MattdewT/KE4/Dichtung4.jpg

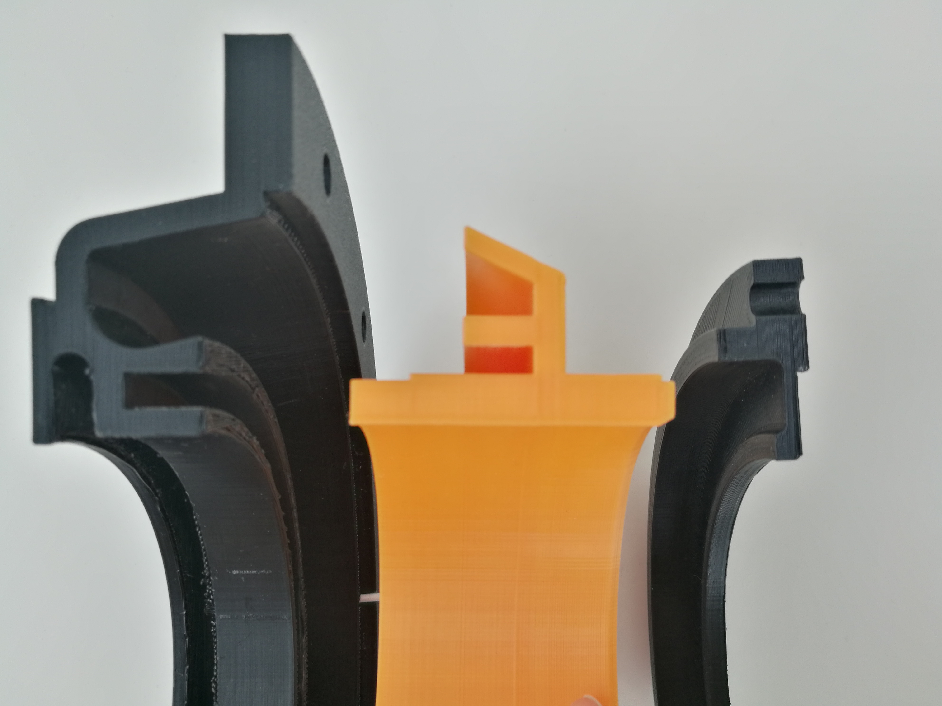
Dichtung4.jpg
