MattdewT/KE4/IMG_20200114_105757.jpg

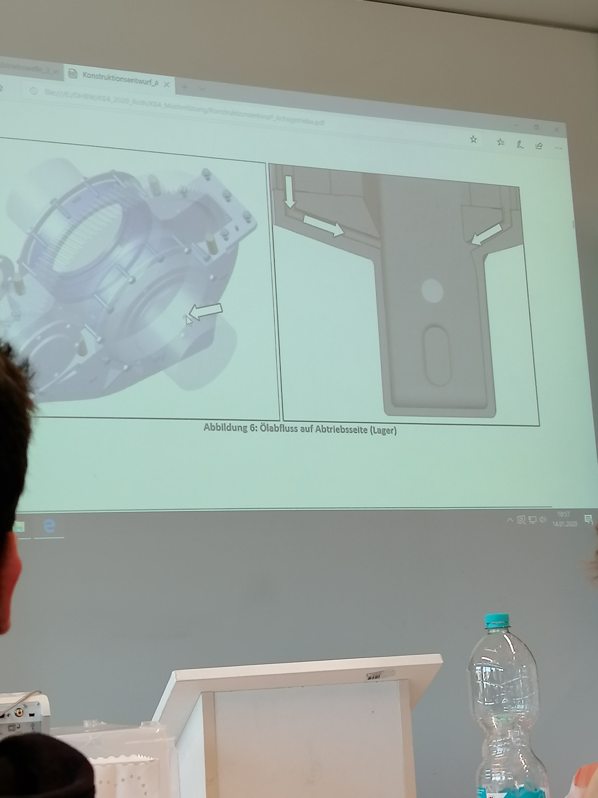
IMG_20200114_105757.jpg
