MattdewT/KE4/Grafiken.pptx

## Slide 2

94,5

76

71,5

FRi

FRa

Fr1

y

x

FB

## Slide 3

FS1

R = 120

FK

r = 92

z

y

FS2

## Slide 4

LI=65

LII=160

LIII=65

LIV=65

Z

x

FAZ

FG

FG

FBZ

FKZ

## Slide 5

α

LI=65

T1=0Nm

LII=160

T2=120Nm

LIII=65

LIV=65

T3=T4=
240Nm

50

0,5

0,5

## Slide 6

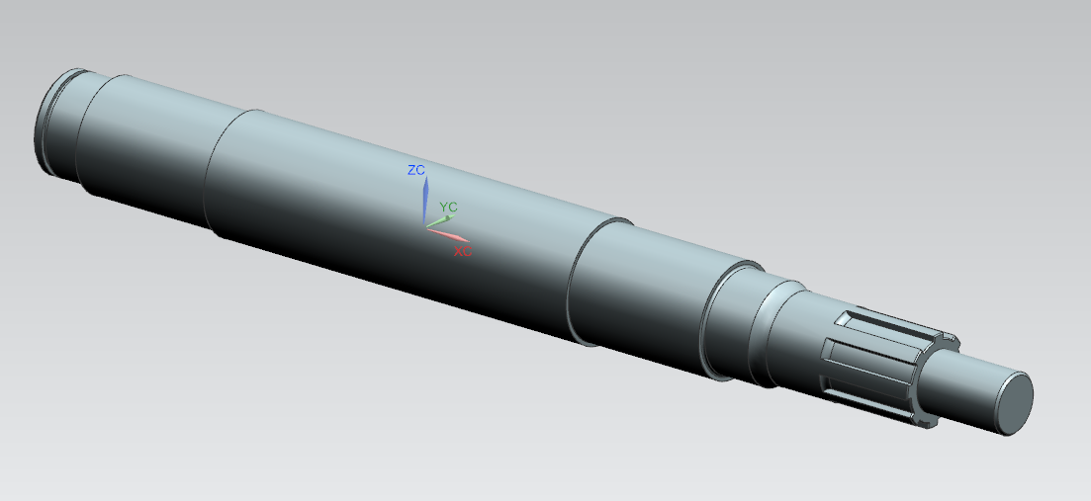
[picture p45: figure]

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
## Slide 7

80mm

φ

0,25mm

## Slide 8

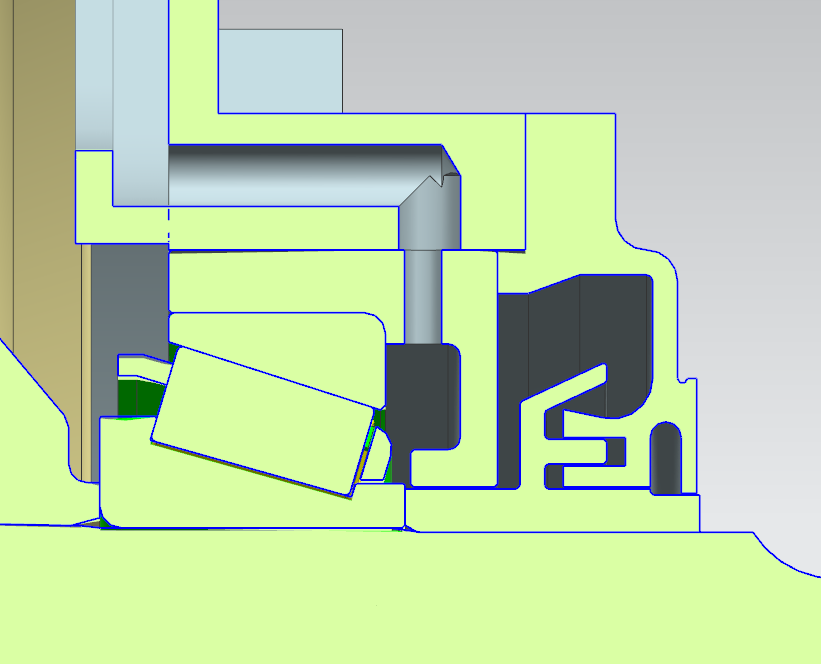
[picture p46: figure]
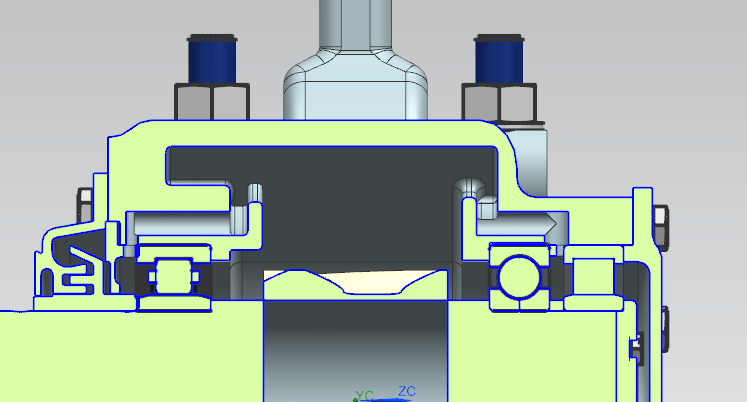
[picture p47: figure]

## Slide 9

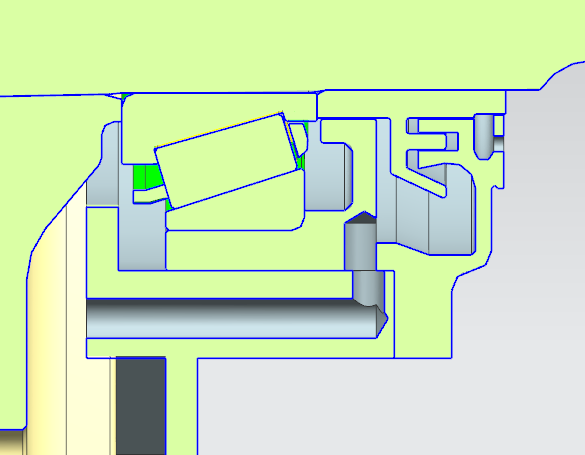
[picture p48: figure]

## Slide 10

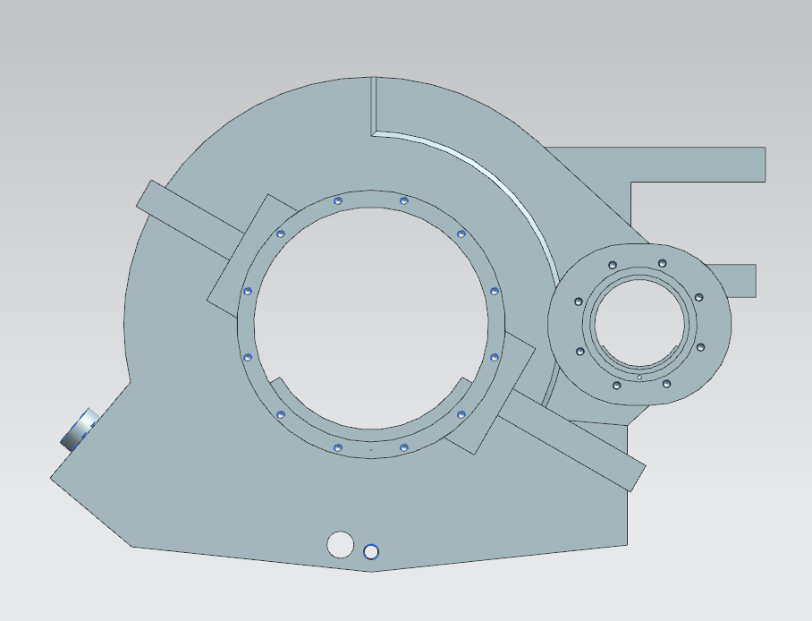
[picture p49: figure]

## Slide 11

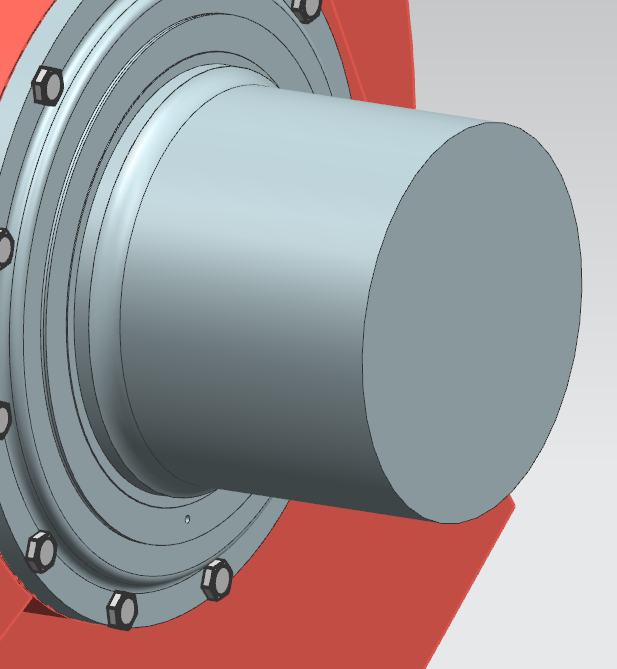
[picture p50: figure]
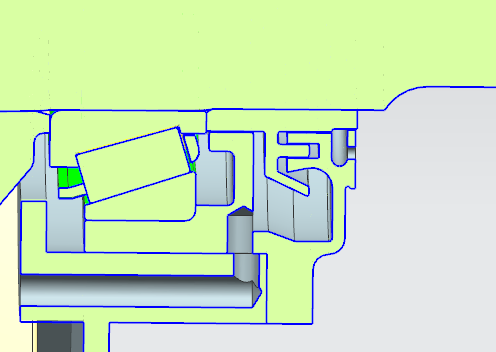
[picture p51: figure]

## Slide 12

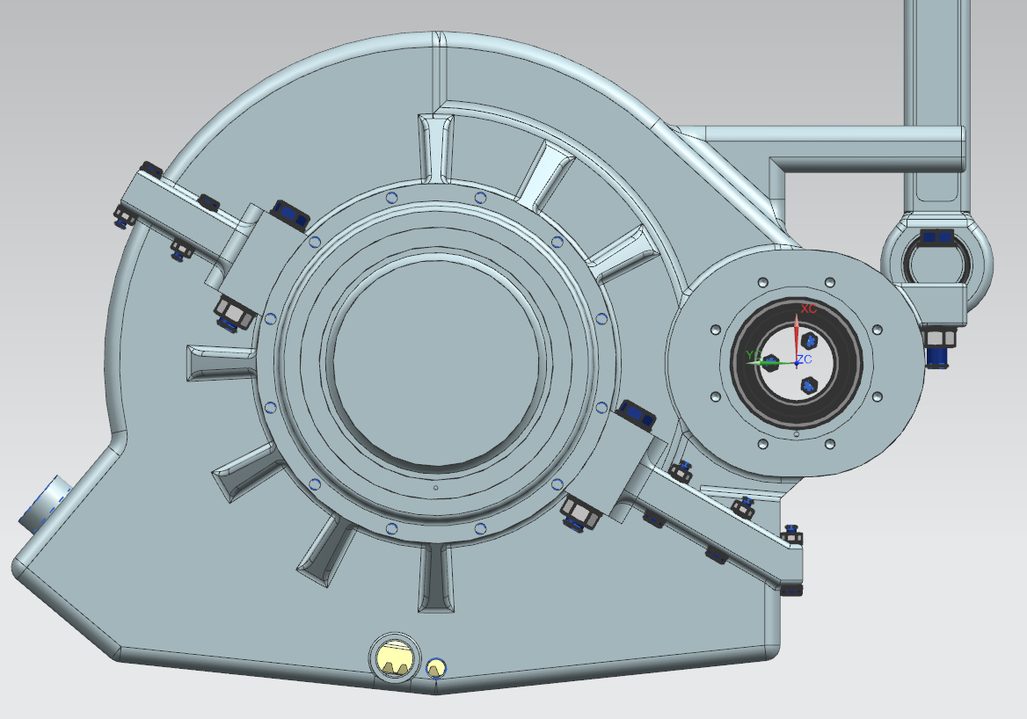
[picture p52: figure]

10

10

## Slide 13

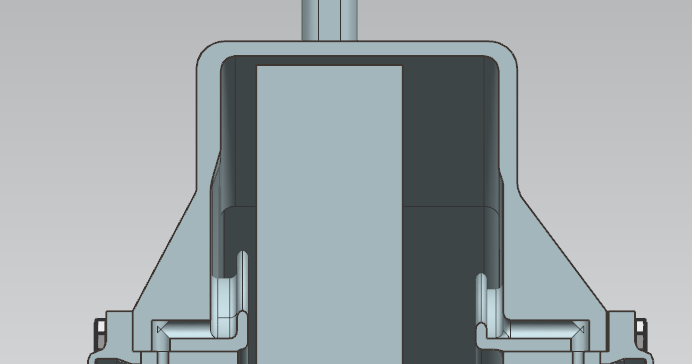
[picture p53: figure]

5

max. 80

max. Ø 619

## Slide 14

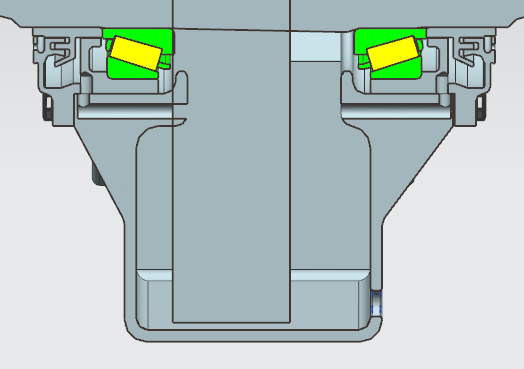
[picture p54: figure]

max. Ø 619

max. 80

5

## Slide 15

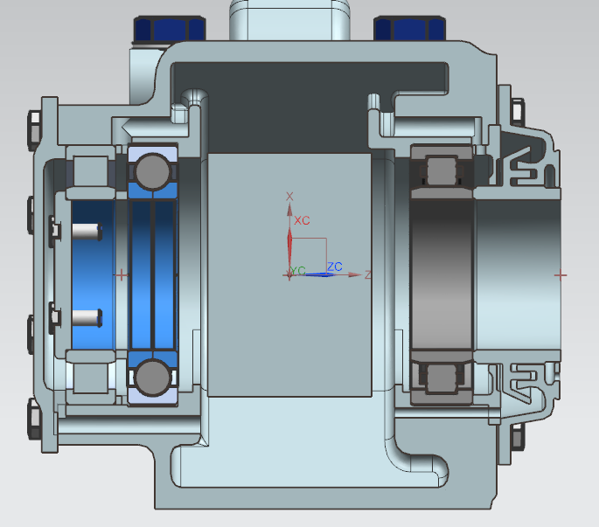
[picture p55: figure]

max. Ø 127

max. 82

## Slide 16

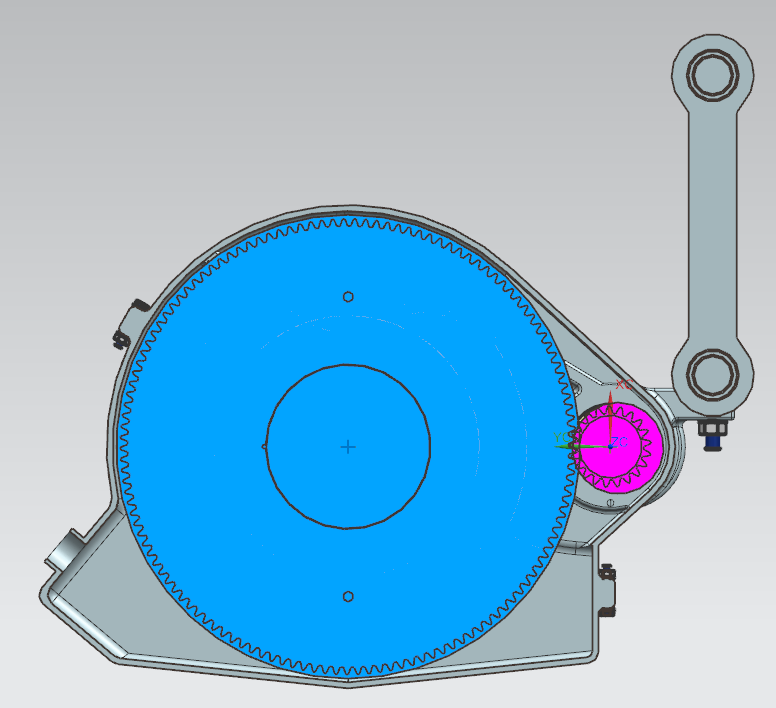
[picture p56: figure]

## Slide 17

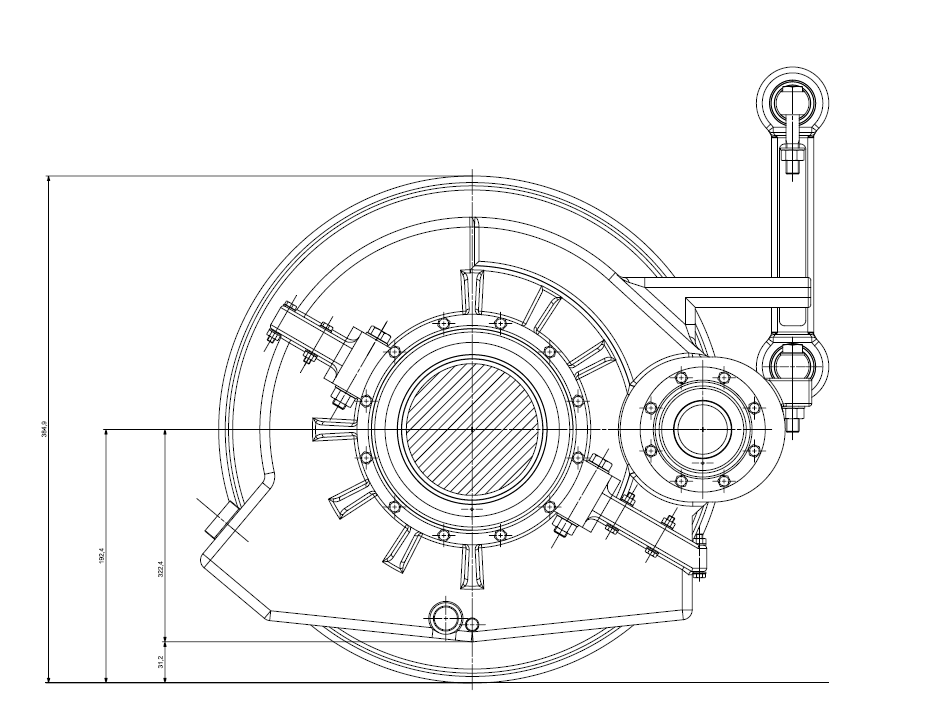
[picture p57: figure]

Ø 770

385

322,5

62,5

## Slide 18

Laufrad

Ø 770

385

322,5

62,5

Schienenoberkante

## Slide 19

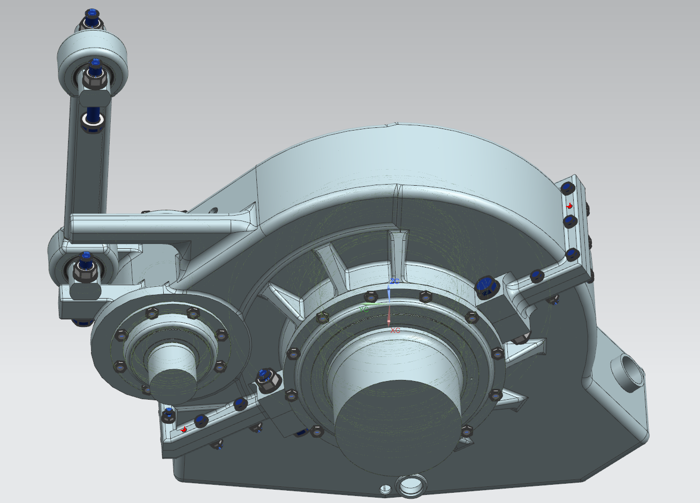
[picture p58: figure]

## Slide 20

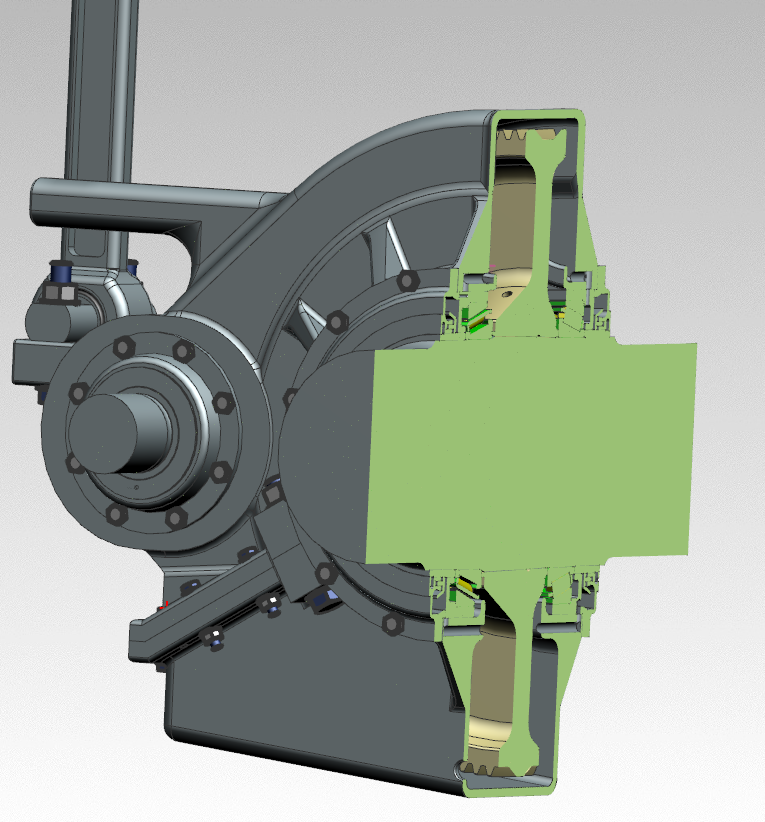
[picture p59: figure]

## Slide 21

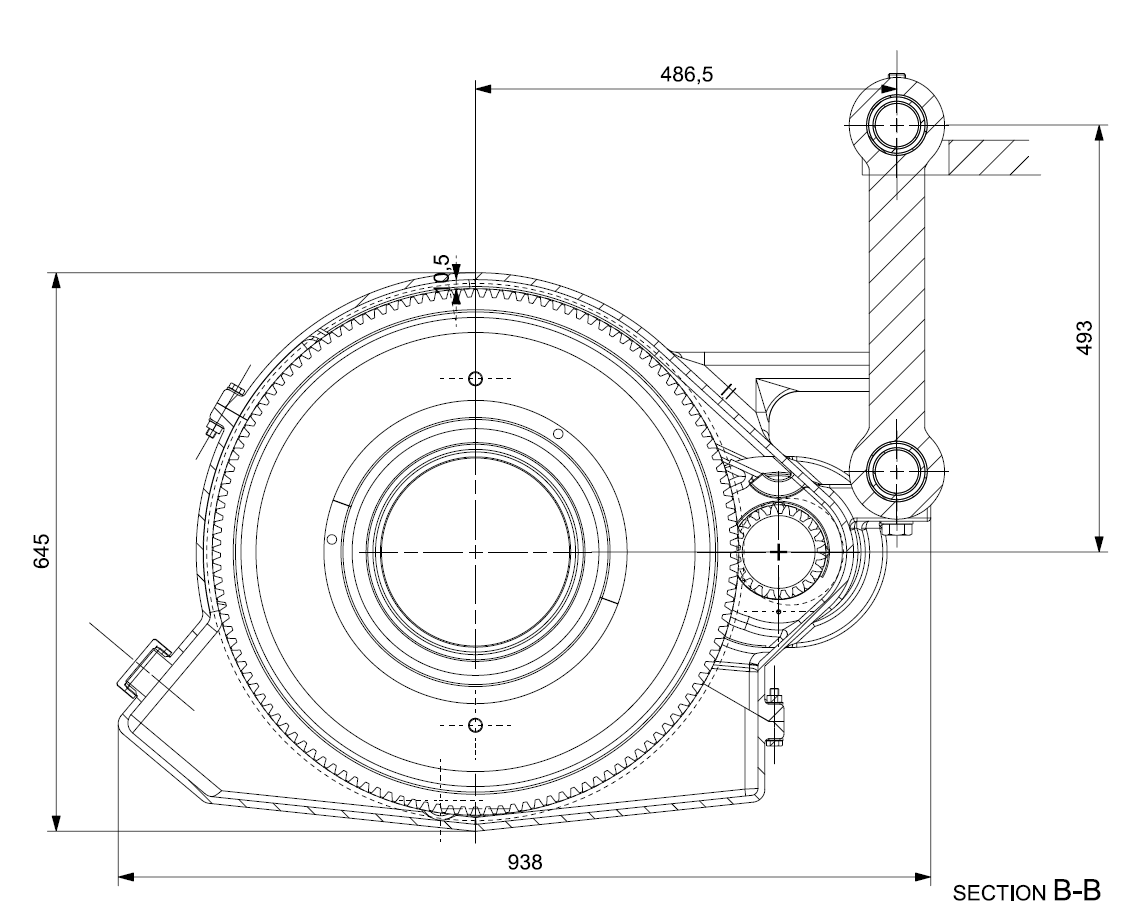
[picture p60: figure]
