MattdewT/KE4/Auflistung relevanter Momente.docx

Übersetzung | 6,143
Auslegungsdrehmoment inkl. KA=Abtriebsmoment | 21600 Nm
Antriebsdrehmoment inkl. KA | 3516Nm
KA | 2
Nennabtriebsdrehmoment | 10800 Nm
Nennantriebsdrehmoment | 1726 Nm
Spitzenabtriebsmoment (KA=2,5) | 27000Nm
Spitzenantriebsmoment (KA=2,5) | 4395Nm
Rechenmoment für die Antriebslager | 790 Nm

Auflistung Drehmomente
