MattdewT/KE4/Finale/0. Projektbericht.pdf

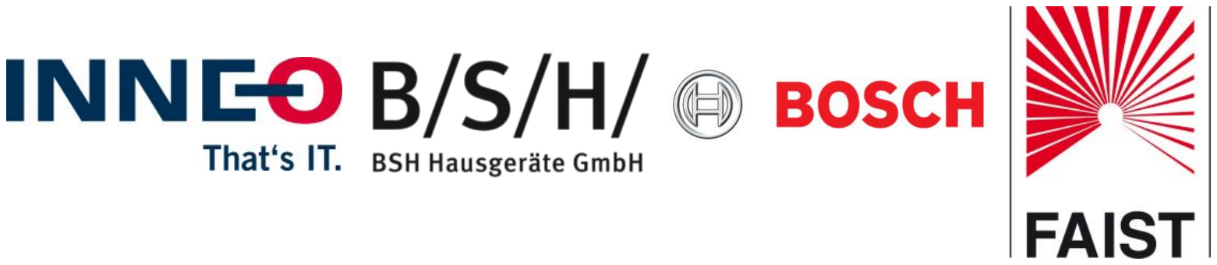
[picture p61: figure]

## Berechnung und Konstruktion eines

## Schienenfahrzeugachsgetriebes

Konstruktionsentwurf im Fach Konstruktionslehre 4

des Studienganges Maschinenbau

an der Dualen Hochschule Baden-Württemberg Heidenheim an der Brenz

von

Hofmann, Tanja

Hopf, Marie

Langohr, Anika

Tiroch, Matthias

Variante 13

Abgabe: 10.03.2020

Bearbeitungszeitraum | 9 Wochen
Matrikelnummern | 5620331, 3225750, 1790705, 9269794
Kurs | TM 2018 KM
Ausbildungsfirma | INNEO Solutions, BSH, Bosch AS,
| Faist Anlagenbau

Studienbereich Technik

Studiengang Maschinenbau

Name, Vorname

Hofmann, Tanja

Name, Vorname
Hopf, Marie

Name, Vorname
Langohr, Anika

Name, Vorname
Tiroch, Matthias

Erklärung

gemäß § 5 (3) der „Studien- und Prüfungsordnung DHBW Technik“ vom

01.10.2015.

Ich habe die vorliegende Arbeit selbstständig verfasst und keine anderen als die

angegebenen Quellen und Hilfsmittel verwendet.

Ort, Datum | Unterschrift
Ort, Datum | Unterschrift
Ort, Datum | Unterschrift
Ort, Datum | Unterschrift

## Inhaltsverzeichnis

Inhaltsverzeichnis | 3
1 | Vorwort | 7
2 | Einleitung | 1
2.1 | Anforderungsliste | 2
2.2 | Morphologischer Kasten | 6
2.3 | Relevante Momente | 9
3 | Verzahnung | 10
3.1 | Berechnung der Zähnezahl und des Moduls | 10
3.2 | Verzahnungskräfte | 11
3.3 | Profilverschiebung | 12
3.4 | Zahnfußfestigkeit und Grübchenfestigkeit | 12
3.5 | Antriebsritzel | 13
3.5.1 | Antriebswelle | 13
3.6 | Abtriebsrad | 14
3.6.1 | Thermische Pressverbindung des Abtriebsrades | 15
3.6.2 | Öl-Kegelpressverband des Abtriebsrades | 20
4 | Lager | 23
4.1 | Lagerkraftberechnung | 23
4.1.1 | Antriebswelle | 23
4.2 | Auswahl der Lager | 26
4.2.1 | Antriebslager | 27
4.2.2 | Abtriebslager | 29
4.3 | Lagerlebensdauer | 31
4.4 | Auswahl der Dichtungen | 33
4.5 | Lagertoleranzen | 40
5 | Schmierung | 41
5.1 | Ölzufuhr | 42
5.2 | Ölabfuhr/Entlüftung | 46

## Anhang

1. Aufgabenstellung und Variantenliste
2. Handzeichnungen und Skizzen auf Millimeterpapier
3. Projektzeitplan
4. Checkliste
5. Stückliste
6. Gesamtzeichnung

6.1.Baugruppenzeichnung

6.2.Abmaße Labyrinthdichtungen

6.3.Abmaße Zahnrad

7. Kaufteildokumentation

7.1.Drehmomentstütze

7.2.Kegelrollenlager TIMKEN LM742710 / LM742747

7.3.Zylinderrollenlager NU215

7.4.Zylinderrollenlager NU2215

7.5.Vierpunktlager QJ215
7.6.Ölschauglas

7.7.Magnetstopfen

7.8.Einfülldeckel

7.9.Entlüftungsschraube

7.10. Sicherungsstift ISO 2338
7.11. Sechskantschraube ISO 4014
7.12. Sechskantmutter ISO 4033
7.13. Unterlegscheibe ISO 7089
7.14. Bogenzahnkupplung

7.14a. Betriebsanleitung Bogenzahnkupplung

8. Verzahungsparameterabstimmung
9. KissSoft-Protokoll Verzahnungsberechnung Modul 4,5

9a. KissSoft-Datei Verzahnungsberechnung Modul 4,5

10.KissSoft-Protokoll Verzahnungsberechnung Modul 5

10a. KissSoft-Datei Verzahnungsberechnung Modul 5

11. Auslegung des thermischen Pressverbands

12. Auslegung des Ölpressverbands
13. Videoausschnitt CFD-Simulation

14.KissSoft-Protokoll Schraubenberechnung Ankerschrauben

14a. KissSoft-Datei Schraubenberechnung Ankerschrauben

15.KissSoft-Protokoll Schraubenberechnung Drehmomentstützenschrauben

15a. KissSoft-Datei Schraubenberechnung Drehmomentstützenschrauben

## 1 Vorwort

Einige Grafiken in dieser Arbeit sind vereinfacht dargestellt, um Sachverhalte besser

erklären zu können. Manche Grafiken sind deswegen auch nicht originalgetreu in der

Konstruktion zu finden, meistens wurden hierfür Kantenverrundungen entfernt.

Weitere Grafiken sowie verschiedene Animationen sind auf der CD beigefügt.

## 2 Einleitung

Der öffentliche Personennahverkehr wird in Zeiten überfüllter Straßen ein immer wich-

tigeres Angebot für die Menschen, vor allem in Ballungsräumen, um klassische Ver-

kehrswege zu entlasten, die psychische Belastung für das Individuum zu senken und

nicht zuletzt, um die Klimaziele der Bundesregierung erreichen zu können. Die stei-

genden Passagierzahlen führen dazu, dass die öffentlichen Verkehrsmittel so zuver-

lässig, störungs- und wartungsarm wie möglich zur Verfügung stehen müssen. In die-

sem Konstruktionsentwurf soll für eine innerstädtische Metro ein einstufiges Schienen-

fahrzeugachsgetriebe konstruiert werden. Die Motorwelle liegt dabei parallel zur Rad-

satzwelle. Relativbewegungen zwischen Getriebe und Drehgestell werden von einer

Bogenzahnkupplung ausgeglichen.

Das Schienenfahrzeugachsgetriebe wird auf der Basis exakter Auslegungsrechnun-

gen konstruiert und mit gängigen Referenzwerten auf die Haltbarkeit bei dynamischer

Belastung geprüft. Die Visualisierung des Schienenachsfahrzeuggetriebes ist einer

ausführlichen CAD-Datei mit passender Stückliste zu entnehmen. Die Bezugsebene

ist dabei immer die Verzahnungsmitte.

Im Anhang sind außerdem die ausgedruckten Excel-Berechnungen sowie Berech-

nungsergebnisse des Programmes KissSoft zu finden. Auf der beiliegenden CD befin-

den sich die Original-Dateien.
Die zu konstruierende Variante Nummer 13 hat ein Übersetzungsverhältnis u = 6,143,

einen Achsabstand a = 350 mm und ein Auslegungsmoment von 21600 Nm.

2.1 Anforderungsliste

In der folgenden Anforderungsliste werden alle Forderungen und Wünsche an das

Stirnrad-Getriebe aufgeführt. Diese Zusammenstellung dient dazu, eine übersichtliche

Darstellung der geforderten Randbedingungen zu bekommen.

Lfd.
Nr.
Hauptmerkmal | Anforderung / Spezifikation (Zahlen, Daten, Fakten)
Klassifizierung

1 Fahrzeugdaten

1.1 | Max. Achslast | 15 - 17 t | Basis
1.2 | Raddurchmesser | d=770-860mm | Basis
1.3 | Anwendung | Metro im Stadt- und Vorstadtbetrieb | Basis

2 Betriebsdaten

2.1 | Fahrzeughöchst-ge-schwindigkeit | 100 km/h | Basis
2.2 | Abtriebsnennmoment | T=10800 Nm | Basis
2.3 | Max. statisches Ab-triebsmoment ("worst case" durch Kurz-schluss) | T=54000 Nm | Basis
2.4 | Abtriebsdrehzahl | Max. Abtriebsdrehzahl = 650 1/min | Basis
2.5 | Max. Motorantriebs-drehzahl | 3000 - 5000 1/min | Basis

3 Allgemeine Getriebegeometrie

3.1 | Achsabstand | a=350mm | Forderung
3.2 | Wellendurchmesser | Auswahl 70 mm - 75 mm - 80 mm | Forderung

3.3 | minimale Höhe des Gehäuses über dem Boden | h=62,5mm | Forderung
3.4 | Motorwelle parallel zur Radsatzwelle | | Forderung
3.5 | Gehäuse soll für alle Getriebevarianten laut Variantenliste passen | siehe Anhang | Forderung
3.6 | Getriebewandstärke | t=8mm | Forderung
3.7 | Respektabstand Zahnkopfkreis-Ge-häuse | 5mm | Forderung
3.8 | Schrägteilung des Ge-häuses | | Wunsch
3.9 | Anstrich | RAL 5002 | Wunsch

4 Getriebedaten

4.1 | Getriebeart | Stirnräder | Forderung
4.2 | Übersetzungsverhält-nis | u=6,143 | Forderung
4.3 | Evolventenverzah-nung nach DIN 867 | | Forderung
4.4 | Schrägungssinn | Ritzel: rechts, Rad: links | Forderung
4.5 | Modul mn | 4,5 | Forderung
4.6 | Teilschrägungswinkel | 13° | Forderung
4.7 | Zahnradwerkstoff | 18CrNiMo7-6 | Wunsch
4.8 | Verzahnung einsatz-gehärtet | auf 740 HV +/- 20 HV, Kernhärte 400 HV | Wunsch

5 Kupplung

5.1 | Antriebskupplung | Bogenzahnkupplung | Wunsch
5.2 | Abtriebskupplung | Großrad direkt auf Abtriebswelle | Forderung

6 Schmierung

6.1 | Öltauchschmierung | Max. Sumpftemperatur 90°C | Forderung
6.2 | Öl: SHC 75W90 GL5 | | Wunsch
6.3 | Ölschauglas | Kennzeichnung des minimalen und maximalen Ölstandes | Wunsch
6.4 | Öleinguss | | Forderung

7 Lager

7.1 | Lagerarten | Vierpunktlager; Zylinderrollenlager; Kegelrollenlager | Wunsch/Fo rderung
7.2 | Rechenmoment am Antrieb bei Lager-durchmesser 75mm | T=790 Nm | Forderung
7.3 | Schmierung der Lager | keine Lebenszeitschmierung, aber Abdichtung der Lagergehäuse | Forderung

8 Umgebung und Betriebsbedingungen

8.1 | Schräglage in Kurven | | Basis
8.2 | Kollisionsschutz am Gehäuse | auch im Schadensfall | Wunsch
8.3 | Geräuscharm | <70dB | Wunsch
8.4 | Rostfrei | durch entsprechenden Werkstoff o-der Beschichtung | Forderung
8.5 | Außenbetrieb möglich | | Basis
8.6 | Optimierter Einbau-raum | | Wunsch

8.7 | Temperaturbereich | -10°C bis +40°C | Wunsch

9 Montage und Fertigung

9.1 | möglichst viele gleich-artige Teile verwen-den | | Wunsch
9.2 | Nur eine Schrauben-art (Durchmesser und Länge) für Lagerde-ckel und Gehäusetei-lungsverschraubung | | Wunsch
9.3 | Lieferung | im montierten Zustand | Wunsch
9.4 | Gehäusewerkstoff | EN-GJS-500-7 | Forderung
9.5 | Flexibilität | Aufhängung | Forderung
9.6 | Transportmaße | max. 800mmx800mmx800mm ohne Motor | Wunsch

10 Kosten

10.1 | ohne Motor | maximal 300€ | Wunsch

11 Lebensdauer

11.1 | nominelle Lebens-dauer | L10km=3,2 Mio. km | Forderung
11.2 | Mögliche Lebens-dauer | L10km>3,2 Mio. km | Wunsch

12 Sicherheit

12.1 | Labyrinthdichtung für die Sicherheit der Um-welt | | Forderung
12.2 | Drehmomentstütze gegen Verdrehung | | Forderung

12.3 | Respektabstand von Zahnrad und Ge-häuse | | Forderung
12.4 | Sicherung gegen Hin-einziehen von Glied-maßen oder Gegen-ständen | | Forderung

13 Termine

13.1 | Vorstellung erster Ent-würfe und Berechnun-gen | 07.02.2019 | Forderung
13.2 | Vorstellung der voll-ständigen Berechnun-gen und CAD-Zeich-nungen | 25.02.2019 | Forderung
13.3 | Abgabe der vollständi-gen Dokumentation in Papierform und auf CD | 10.03.2019 | Forderung

2.2 Morphologischer Kasten

Da es eine Vielzahl an einzelnen Teilfunktionen und anschließenden Gesamtlösungs-

prinzipien gibt, wurde ein morphologischer Kasten erstellt. Ziel der Gegenüberstellung

ist, die optimale Kombination der verschiedenen Varianten zu finden. Die ausgewählte

Variante wurde gelb markiert.

| Variante 1 | Variante 2 | Variante 3 | Variante 4

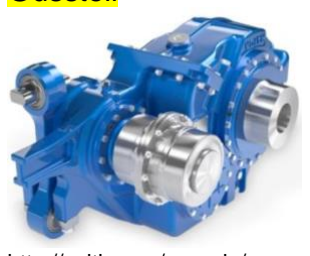
[picture p62: figure]

Gehäuse | Gussteil http://voith.com/corp-de/an-triebe-und-getriebe___radsatz-ge-triebe.html?100093%5B%5D=1 | Schweißkonstruk-tion http://www.am-konstruk-tion.de/stahlbau.html | Blechkonstruk-tion

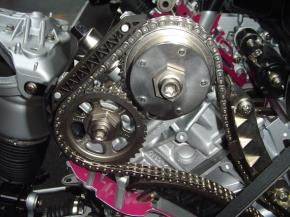
[picture p63: figure]

Getriebe-art | Kettengetriebe https://de.wikipedia.org/wiki/Ket-tengetriebe#/media/Datei:No-ckenwellenantrieb.jpg | Reibgetriebe | Stirnradgetriebe http://www.welter-zahnrad.de/maschine-07_dsc_7185_freige-stellt_rgb/ | Riemenge-triebe http://www.te-data.com/2473.0.h tml

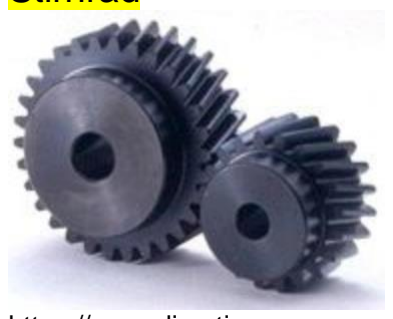
[picture p64: figure]

Rad-variationen | Stirnrad https://www.directin-dustry.de/prod/khk/product-18644-1444729.html | Kegelrad https://www.gg-antriebs-technik.de/antriebstech-nik/kegelraeder/ | Schneckenrad https://www.konstrukti-onspraxis.vo-gel.de/hocheffiziente-kegelradgetriebe-schlagen-schnecken-radgetriebe-a-545866/ | Zahnstange https://de.aliex-press.com/i-tem/32407500061. html

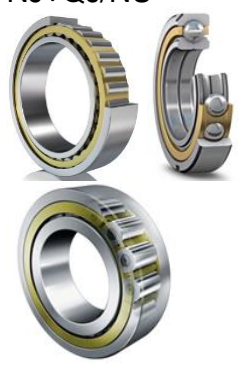
[picture p65: figure]
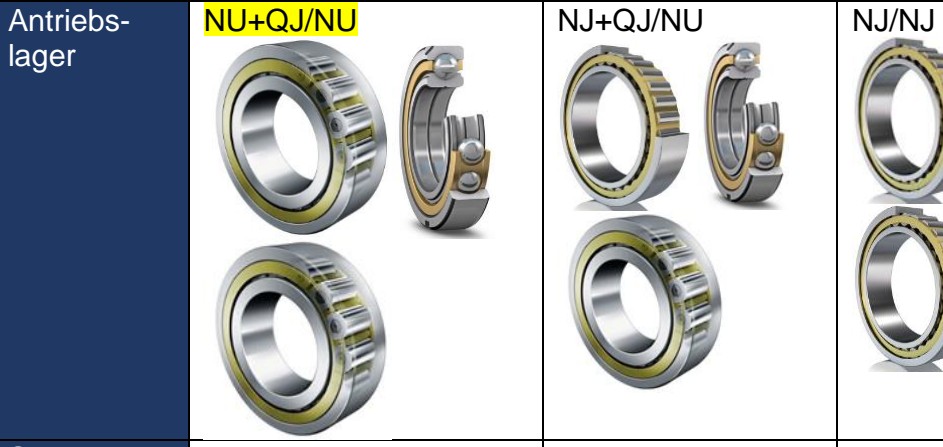
[picture p66: figure]
Antriebs-lager

Schmierung | Fettschmierung | Initialschmierung | Hydrostatische Schmierung | Ölschmie-rung

Dichtung | Wellendichtring https://www.hytec-hydrau-lik.de/normteile/radial-wellen-dichtring-as-10x22x7.html | Takonit-Dichtung https://www.skf.com/at/products/bearings-units-hou-sings/bearing-hou-sings/skf-taconite-seal/in-dex.html | O-Ring https://www.pvc-welt.de/O-Ring-fuer-Aussengewinde | Labyrinth Dichtung https://www.gmn.de/dichtun-gen/grundla-gen/funktionsprin-zip/
Befestigung Rad auf Welle | Fügen mit Wärme https://www.schweizer-fn.de/ma-schinenelemente/pressverbin-dung/pressverbindung.php | Ölpressverband (Kegel 1:50) | Verschraubung https://www.konstrukti-onsatlas.de/antriebs-technik/welle-nabe-verbindung-kraft-schluss.shtml | Formschluss https://www.kon-struktionsat-las.de/antriebs-technik/welle-nabe-verbindung-formschluss.shtml

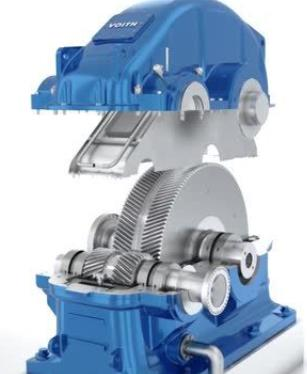
[picture p67: figure]

Gehäuse-teilung | Senkrecht https://www.amazon.de/Gast-roteileshop-Geh%C3%A4use-f%C3%BCr-Ge-triebe/dp/B078J61P48 | Waagrecht https://www.vo-ith.com/corp-de/antriebe-und-getriebe/turboge-triebe-mechanisch.html | Schräg
Lager-sicherung | Sicherungsring | Kleben | Einpressen | Nutmutter https://www.skf.com/ch/de/pro-ducts/bearings-units-housings/be-aring-acces-sories/lock-nuts/requiring-keyway/installa-tion-removal/in-dex.html

2.3 Relevante Momente

Für die weiteren Auslegungsrechnungen ist es von großer Bedeutung, die im Getriebe

wirkenden Kräfte und Momente zu kennen, um die Elemente wie Lager, Wellen und

Querschnitte der Bauteile mit ausreichender Lebensdauer und Sicherheit zu dimensi-

onieren. Der angenommene Anwendungsfaktor KA=2 deckt zusätzliche Belastungen

wie Weichenüberfahrten ab. Im Falle eines zweipoligen Kurzschlusses des An-

triebsmotors könnte es allerdings nochmals zu einer Multiplikation dieses Moments mit

dem Faktor 2,5 kommen. Auch in diesem Fall soll das Getriebe noch halten.

Übersetzung | 6,143
KA | 2
Auslegungsdrehmoment inkl. KA =Abtriebsmoment | 21600 Nm
Antriebsauslegungsdrehmoment inkl. KA | 3516 Nm
Nennabtriebsdrehmoment | 10800 Nm
Nennantriebsdrehmoment | 1726 Nm
Spitzenabtriebsmoment (inkl. KA und 2,5-facher Sicherheit) | 54000 Nm
Spitzenantriebsmoment (inkl. KA und 2,5-facher Sicherheit) | 8790 Nm
Rechenmoment für die Antriebslager | 790 Nm
Abtriebsdrehzahl bei 100 km/h | 650 1/min
Abtriebsdrehzahl bei 50km/h | 325 1/min
Antriebsdrehzahl bei 50 km/h | 1000 1/min
Antriebsdrehzahl bei 50 km/h | 2000 1/min

## 3 Verzahnung

Für die Verzahnung des Getriebes sind schrägverzahnte Stirnräder vorgesehen. Diese

haben den Vorteil, dass sie gegenüber geradverzahnten Stirnrädern geräuscharmer

sind, aber es ergeben sich auch induzierte Axialkräfte, die von entsprechend geeigne-

ten Wälzlagern aufgefangen werden müssen.

Die Herausforderung bei der Verzahnung besteht darin, dass für den vorgegeben Achsabstand von 350 mm und das vorgegebene Übersetzungsverhältnis von 6,143

passende Wälzkreisdurchmesser gefunden werden müssen, auf denen eine ganzzah-

lige Zähnezahl Platz findet und die trotzdem das Zähnezahlverhältnis erfüllen.

3.1 Berechnung der Zähnezahl und des Moduls

Folgende Zähnezahlen, Module und Schrägungswinkel β stehen zur Verfügung (laut

Aufgabenstellung):

Tabelle 1: Mögliche Verzahnungsdaten

Zähnezahl | 14 | 15 | 16 | 17 | …
Module | 4 | 4,5 | 5 | 5,5 | 6
Schrägungswinkel | 11° | 12° | 13° | 14° | 15°

Zunächst soll mithilfe einer Excel-Tabelle (siehe Anhang „Verzahungsparameterab-

stimmung) herausgefunden werden, welche Kombinationen von Zähnezahlen, Modu-

len und Schrägungswinkeln zu einem Achsabstand von 350 mm mit einer Abweichung

von maximal einem Millimeter führen. Es werden Ritzel Zähnezahlen ab 17 untersucht,

damit ein „Ruckeln“ der Zahnräder ausgeschlossen wird. Die Formeln zur Berechnung

stammen aus ME Decker [2], (22.1) bis (23.3). Die Ergebnisse der insgesamt 225 Berechnungen sind im Anhang zu finden. Beim Übersetzungsverhältnis ergeben sich

keine Probleme, alle Zähnezahl Kombinationen erfüllen ein Übersetzungsverhältnis von 6,143 mit einer Abweichung von maximal 1%. Beim Achsabstand trifft lediglich

noch auf zwei Kombinationen die maximale Abweichung zu.

Modul | Zähnezahl Ritzel | Zähnezahl Rad | Schrägungswinkel | Achsabstand av
4,5 | 21 | 129 | 13° | 349,97 mm
5 | 19 | 117 | 11° | 350,36 mm

Tabelle 2: Zur Auswahl stehende Varianten

Nach Untersuchung beider Verzahnungsvarianten mit dem Berechnungsprogramm

KissSoft fiel die Wahl auf Variante 1 mit einem Modul von 4,5. Hier ist die Profilüber-

deckung geringfügig größer und das Rad hat ein geringeres Gewicht. Beide Protokolle

der Berechnung sind im Anhang zu finden.

3.2 Verzahnungskräfte

Tabelle 3: Verzahnungskräfte

Verwendetes Rechenmoment | Nennmoment am Abtrieb = 10800 Nm | Maximalmoment im Kurz-schlussfall am Abtrieb = 54000 Nm | Ersatzmoment für Lager-berechnung am Antrieb = 790 Nm
Ft [kN] | 35,9 | 179,4 | 16,1
Fr [kN] | 14,5 | 72,6 | 6,5
Fa [kN] | 8,4 | 41,9 | 3,8

Beispielrechnung für die Lagerberechnung, die übrigen Berechnungen erfolgen analog

dazu:

Nennumfangskraft am Wälzkreis: FNt =

M1
dW1
2

= 790 Nm
0,098
2

m

= 16,1 kN

Radialkraft: Fr1 = FNt ∙ tanαwt = 16,1 kN ∙ tan(22,016°) = 6,5 kN

Axialkraft: Fa1 = FNt ∙ tanβwt = 16,1 kN ∙ tan(13,131°) = 3,8 kN

3.3 Profilverschiebung

Die Profilverschiebung wird mit dem Programm KissSoft automatisch ausgerechnet.

Die verwendete Berechnungsgrundlage ist die Aufteilung auf gleiches spezifisches

Gleiten am Zahnfuß. Die benötigte Profilverschiebung beträgt 0,8341 mm, davon ent-

fallen 0,3642 mm auf das Ritzel und 0,4699 mm auf das Rad. Das spezifische Glei-

ten am Zahnfuß wird dadurch bis auf die dritte Nachkommastelle identisch, wie in

Abbildung 1 zu sehen ist.

Abbildung 1: Ausschnitt aus dem Kissoft-Protokoll, Profilverschiebung

3.4 Zahnfußfestigkeit und Grübchenfestigkeit

Um eine ausreichende Lebensdauer des Getriebes zu gewährleisten, wird eine Zahn-

fußsicherheit von 1,1 und eine Grübchensicherheit von 1,0 gefordert. Die KissSoft-

Berechnung zeigt, dass beides erfüllt ist.

Abbildung 2: Ausschnitt aus KissSoft-Protokoll, Sicherheiten

Trotzdem wird eine halbjährliche Kontrolle der Zahnflanken auf Micropitting oder

Graufleckigkeit empfohlen, um auf schädliche, unvorhergesehene Umwelteinflüsse re-

agieren zu können.

3.5 Antriebsritzel

Die Zähnezahl des Ritzels beträgt z1=21 nach Auslegung mit KissSoft. Das Antriebs-

ritzel wird direkt auf die Antriebswelle aufgeschnitten. Aus diesem Grund muss keine

Welle-Nabe-Verbindung für die Antriebswelle und das Antriebsritzel ausgelegt werden.

### 3.5.1 Antriebswelle

Der Durchmesser der Antriebswelle direkt neben dem aufgeschnittenen Ritzel wird

durch den geforderten Respektabstand von 1,5 mm zwischen Fußkreisdurchmesser

und Wellenoberfläche sowie durch die benötigte Lagerschulter zur Fixierung der Wälz-

lager beschränkt. Die zunächst gewählten Lager mit einem Innendurchmesser von 80

mm benötigen einen Absatz mit Durchmesser da von 91 mm laut Hersteller Schaeffler

[5]. Der Fußkreisdurchmesser des Ritzels beträgt jedoch lediglich 89,013 mm. Somit

wäre eine Antriebswelle für diese Lager in Kombination mit dem ausgelegten Ritzel

nicht möglich. Aus diesem Grund wurde die nächstkleinere Lagergröße mit einem In-

nendurchmesser von 75mm gewählt. Der geforderte Absatz-Durchmesser beträgt hier

da=84 mm [5]. Somit beträgt der Respektabstand sogar 2,5 mm.

Zwischen den einzelnen Wellenabschnitten mit unterschiedlichen Passungen wird ein

Einstich mit dem Radius r = 16 mm vorgesehen, um die exakte Fertigung zu erleich-

tern.

Die Radien an den Lagersitzen sind vom Lagerhersteller Schaeffler auf maximal r = 1

mm festgelegt.

Durch das Aufschneiden sind Ritzel- und Wellenwerkstoff identisch, es handelt sich

um 18CrNiMo6-7 mit einer Zugfestigkeit von Re = 500 MPa.

3.6 Abtriebsrad

Das Abtriebsrad, im Folgenden auch Zahnrad oder Großrad genannt, hat nach Ausle-

gung mit KissSoft eine Zähnezahl von z2=129.

Wegen seines großen Durchmessers (da = 607,98 mm) soll es mit möglichst geringem

Gewicht gestaltet werden. Um trotzdem noch eine ausreichende Festigkeit zu gewähr-

leisten, sind folgende Geometrierichtwerte notwendig:

Rechnung Geometrie:
(
df
2

) − 3,5 ∙ mn = roben

(

588,749mm
2

) − 3,5 ∙ 4,5 = 278,645mm

Dieses Maß bestimmt die Dicke des Materials unter den Zähnen. Damit dieses eine

höhere Festigkeit bekommt, wird auf 278 mm abgerundet. In der Detailzeichnung

und in der Entwurfsskizze des Zahnrades ist dieses Maß nochmal erkennbar.

Das Abtriebsrad soll mit einer Pressverbindung auf der Abtriebswelle befestigt werden.

### 3.6.1 Thermische Pressverbindung des Abtriebsrades

Zunächst soll ein thermischer Pressverband für die Verbindung zwischen Welle und

Großrad ausgelegt werden. Als Berechnungsgrundlage dienen die Formeln nach ME

Decker [2], (9.1) bis (9.35), die auf dem zugehörigen Excel-Blatt des Verlages verwen-

det werden. Zur Berechnung des Querpressverbandes muss das Rad in 4 Bereiche

mit unterschiedlichen Außendurchmessern unterteilt werden. Für die konisch verlau-

fenden Bereiche wird der Mittelwert des Durchmessers dieses Bereiches verwendet. Die Herausforderung dabei ist, dass alle vier Bereiche in derselben Übermaßpassung

gefertigt werden sollen. Deshalb wird ein Vorgehen in umgekehrter Reihenfolge gewählt: Für eine gängiges Übermaß wird nachgerechnet, dass die Haftkraft ausreicht

und gleichzeitig die zulässige Werkstoffbelastung nicht überschritten wird. Diese Passung ist zunächst H7 / x6. Zur besseren Übersichtlichkeit sollen die Bereiche mit den

zugehörigen Geometrierechnungen hier kurz dargestellt werden. Die Protokolle der

Excel-Berechnungen sind im Anhang und im Original auf der beiliegenden CD zu fin-

den.

Die beiden Abstandshalterabsätze tragen nicht zur Tragfähigkeit bei und werden des-

halb nicht berücksichtigt. An ihnen ist die Einführschräge von 15° angebracht, weswe-

gen sie nicht von den folgenden Bereichen angezogen werden muss.

Aufteilung der Pressverbindung (Großrad auf Abtriebswelle) in vier Bereiche:

Bereich 1


Abbildung 3: Querpressverband Bereich 1

Außendurchmesser des Außenteils: dA1 = (
37,9 mm − 20,9 mm
2

+ (37,9 mm − 20,9 mm)) ∙ 2 + 217 mm = 268 mm

Fugenlänge:

lF1 = 17,5 mm

Damit ergibt sich mit Hilfe des Excel-Blattes (09-pressv10.xls; Decker) eine kleinste

Haftkraft von FFK1 = 119877 N.

Bereich 2

Außendurchmesser des Außenteils ist gleich dem Fußkreisdurchmesser:

dA2 = 588,75 mm

Fugenlänge:

lF2 = 30 mm

Damit ergibt sich mit Hilfe des Excel-Blattes (09-pressv10.xls; Decker) eine kleinste

Haftkraft von FFK2 = 515664 N.

Bereich 3

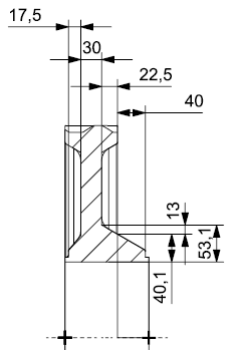
[picture p68: figure]

Abbildung 4: Querpressverband Bereich 3

Außendurchmesser des Außenteils:

dA3 = (

13 mm
2

+ 40,1 mm) ∙ 2 + 217 mm = 310,2 mm

Fugenlänge:

lF3 = 22,5 mm

Damit ergibt sich mit Hilfe des Excel-Blattes (09-pressv10.xls; Decker) eine kleinste

Haftkraft von FFK3 = 228532 N.

Bereich 4

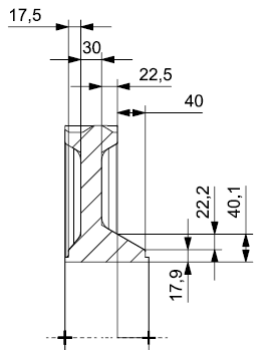
[picture p69: figure]

Abbildung 5: Querpressverband Bereich 5

Außendurchmesser des Außenteils:

dA4 = (

22,2 mm
2

+ 17,9 mm) ∙ 2 + 217 mm = 275 mm

Fugenlänge:

lF4 = 40 mm

Damit ergibt sich mit Hilfe des Excel-Blattes (09-pressv10.xls; Decker) eine kleinste

Haftkraft von FFK4 = 300223 N.

Berechnung der Gesamthaftkraft:

Um die Gesamthaftkraft zu erhalten, werden die Einzel-Kleinsthaftkräfte der vier Be-

reiche addiert:
∑FFK = 119877 N + 515664 N + 228532 N + 300223 N = 1 164 296 N

Die Belastung der Pressverbindung ist die Umfangskraft aus der Verzahnung sowie

die induzierte Axialkraft, die als Längskraft auf die Verbindung wirkt. Im Fall eines zwei-

poligen Kurzschlusses soll die Kleinst-Haftkraft immer noch größer sein als die benö-

tigte Haftkraft. Die Haftsicherheit von 2 soll im Normalbetrieb unter allen Umständen

eingehalten werden.

Festigkeitsnachweis FF ≥ F ∙ SH

Nach der Formel (9.1) aus ME Decker errechnet sich die Haftkraft aus: FF ≥ F ∙ SH

FF ≥ √FU
2 + FL

2
- SH

FF ≥ √(
MAbtrieb,im Kurzscℎlussfall
DF
2

)

2
+ FL

2
- SH

1 164 296 N ≥ √(
54000 N
m
0,217m
2

)

2
+ (41900N)

2 ∙ 2

1 164 296 N ≥ 998 913 N

Somit ist die größte zu übertragende Betriebskraft an den Fügeflächen mit einer er-

forderlichen Haftsicherheit von SH = 2 kleiner als die vorhandene Haftkraft, auch im

Kurzschlussfall.

Berechnung der erforderlichen Fügetemperatur

Um die erforderliche Fügetemperatur zu berechnen wurde die Formel (9.35) aus ME

Decker [2] verwendet:

tA =

Ui + Se
αA ∙ DF

+ t

tA =

141 ∙ 10⁻³ mm + 0,001 ∙ 217 mm

11 ∙ 10⁻⁶

1
K
- 217 mm

+ 20 °C

tA = 284,35 °C

Da das Großrad bis auf max. 190°C erhitzt werden darf, ist eine Kühlung der Welle

notwendig.
∆t = 284,35 °C − 190°C = 94,35 °C

Bei einer Raumtemperatur von 20°C ist eine Abkühlung der Welle auf -74,35°C not-

wendig.

Da diese Abkühlungstemperatur schon mit Trockeneis machbar ist, könnte eine thermische Pressverbindung vorgesehen werden. Allerdings ist ein kegeliger Ölpressver-

band sinnvoll, um eine einfache Demontage zu gewährleisten.

### 3.6.2 Öl-Kegelpressverband des Abtriebsrades

Nach Maschinenelemente von Niemann/Winter [6] kann der Rutschsicherheits- und Festigkeitsnachweis eines hydraulisch verspannten kegeligen Ölpressverbandes wie

bei einem mechanisch verspannten kegeligen Pressverband erfolgen. Dieser wiede-

rum basiert auf dem zylindrischen Pressverband mit dem Unterschied, dass die Fü-

gelänge und damit auch die Fügefläche um den Winkel α/2 schräg zur Horizontalen steht. Für lF muss also lF/cos(α/2) eingesetzt werden. Die Ölnut steht nicht mehr als

Fügefläche zur Verfügung und muss deshalb abgezogen werden. Der Fügedurch-

messer könne mit dem mittleren Durchmesser des Kegelpressverbandes angenom-

men werden, somit ist auch der Festigkeitsnachweis nach den gleichen Formeln wie

beim zylindrischen Pressverband durchzuführen.

Da ein Kegel mit dem Verhältnis 1:50 festgelegt ist, folgt für das Kegelverhältnis C

und den Winkel α:

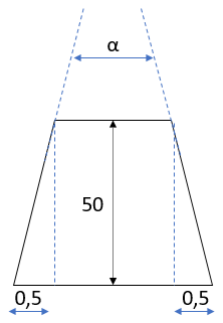
[picture p70: figure]

Abbildung 6: Kegelverhältnis

C = 2 ∙ tan (

α
2

) =

1
50
α = 1,145877395°

Die Berechnung wurde wieder mit dem Berechnungsblatt von Decker durchgeführt

(siehe Anhang und auf der CD). Zum Vergleich der beiden Pressvarianten soll fol-

gende Tabelle dienen:

Tabelle 4: Vergleich der Haftkräfte für einen Querpressverband und einen Ke-

gelpressverband

Bereich | 1 | 2 | 3 | 4
Außendurchmesser [mm] | 268 | 588,75 | 310,2 | 275
Fügelänge Querpressverband [mm] | 17,5 | 30 | 22,5 | 40 | Haftkraft: 1.164.296 N
Kleinste Haftkraft für Quer-pressverband [N] | 119877 | 515664 | 228532 | 300223
Fügelänge Ölpressverband [mm] | 17,503 | 24,005 | 22,505 | 40,008 | Haftkraft: 1.061.330 N
Kleinste Haftkraft für Ölpress-verband [N] | 119901 | 412614 | 228530 | 300283

Die Haftkraft des kegeligen Ölpressverbandes sinkt trotz der Ölnut nur geringfügig und

reicht damit immer noch, um die Betriebskraft inklusive Sicherheit SH=2 von F =

998 913N zu übertragen.

Der Aufschubweg soll ca. 10 mm betragen. Bei einem Kegelverhältnis von 1:50 ergibt sich damit ein Übermaß von 10 mm/ 50=0,2 mm. Diesem Übermaß soll eine Passung

zugeordnet werden. Das Zahnrad wir mit einer H7-Passung gefertigt. Wird für den Kegelsitz der Welle die Passung y7 gewählt, so ergibt sich ein minimales Übermaß

von 0,179 mm und ein maximales Übermaß von 0,249 mm. Der Aufschubweg liegt

damit zwischen 8,95 mm und 12,45 mm.

## 4 Lager

Die Lager müssen nicht nur die radialen Kräfte aus der Rotation der Wellen aufneh-

men, sondern auch die durch die Verzahnung induzierten Axialkräfte.

4.1 Lagerkraftberechnung

Es sollen nur die Antriebslager durchgerechnet werden, da die Abtriebslager aufgrund

ihres großen Durchmessers und der im Vergleich zum Ritzel sehr viel niedrigeren

Drehzahl nicht gefährdet sind.

### 4.1.1 Antriebswelle

Die Lager werden durch die Verzahnungskräfte, die Kupplung und durch die Ge-

wichtskraft der Welle belastet.

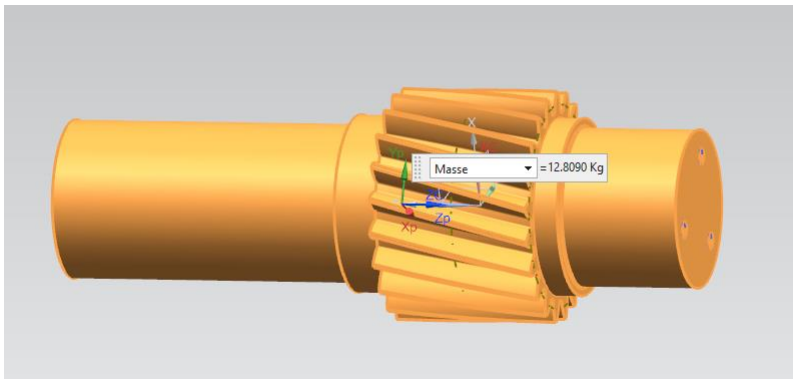
[picture p71: figure]

Abbildung 7: Ermittlung der Gewichtskraft

Gewichtkraft: FG = m ∙ g = 12,8 kg ∙ 9,81 m
s

2 = 125,6 N →kann vernachlässigt werden

Zusätzliche Kraft aus der Bogenzahnkupplung: FB = 1,5 kN

Aufteilung der Kräfte auf die Lager A (Axiallager), Lager Ra (Radiallager auf Außen-

seite), Lager Ri (Radiallager auf Innenseite)

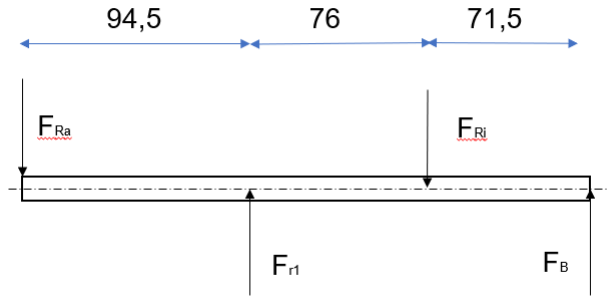
[picture p72: figure]

Abbildung 8: Kräfte in Radialrichtung an der Antriebswelle

Momenten-Gleichgewicht um Lager Ra
Fr1 ∙ 94,5 mm − FRi ∙ 170,5 mm + FB ∙ 242 mm = 0

FRi =

(Fr1 ∙ 94,5 mm + FB ∙ 242 mm)
(170,5 mm)

=

(6,5 kN ∙ 94,5 mm + 1,5 kN ∙ 242 mm) (170,5 mm)

FRi,radial = 5,7 kN

Kräftegleichgewicht in vertikaler Richtung
FRa − Fr1 + FRi − FB = 0

FRa = Fr1 + FB − FRi = 6,5 kN + 1,5 kN − 5,7 kN

FRa,radial = 2,3 kN

Für eine inverse Drehrichtung sind Fr1 und FB ebenfalls invertiert, es ergeben sich be-

tragsmäßig dieselben Zahlenwerte wie bei der vorliegenden Betrachtung.

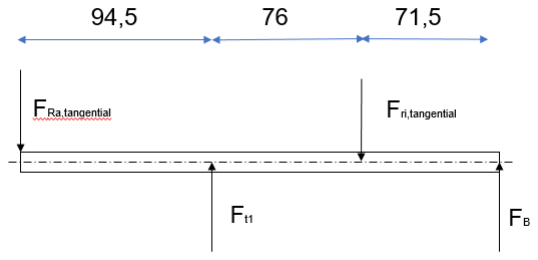
[picture p73: figure]

Abbildung 9: Kräfte in Tangentialrichtung

Momenten-Gleichgewicht um Lager Ra
Ft1 ∙ 94,5 mm − FRi ∙ 170,5 mm + FB ∙ 242 mm = 0

FRi =

(Ft1 ∙ 94,5 mm + FB ∙ 242 mm)
(170,5 mm)

=

(16,1 kN ∙ 94,5 mm + 1,5 kN ∙ 242 mm) (170,5 mm)

FRi,tangential = 11,1 kN

Kräftegleichgewicht in vertikaler Richtung
FRa − Ft1 + FRi − FB = 0

FRa = Ft1 + FB − FRi = 16,1 kN + 1,5 kN − 11,1 kN

FRa,tangentail = 6,5 kN

Für eine inverse Drehrichtung sind Fr1 und FB ebenfalls invertiert, es ergeben sich be-

tragsmäßig dieselben Zahlenwerte wie bei der vorliegenden Betrachtung.

Das Vierpunktlager nimmt die gesamte Axialkraft auf. Wegen der dynamischen Wir-

kung wird diese um 7% vergrößert angenommen.

1,07 | ∙ | FA | = Fa1 | = 1,07 ∙ | 3,8 kN | = 4,1 kN | Vierpunktlager

Zusammenfassung von Radial- und Tangentialrichtung

FRi = √FRi,radial
| 2 | + FRi,tangential
2 | = √(5,7 kN)
2 + (11,1 kN)

2

FRi | = 12,5 kN | Radiallager Motorseite

FRa = √FRa,radial
| 2 | + FRa,tangential
2 | = √(2,3 kN)
2 + (6,5 kN)

2

FRa | = 6,9 kN | Radiallager Laufradseite

4.2 Auswahl der Lager

Die Lager der Abtriebsseite sind bereits durch die Anforderungsliste definiert, für die

Abtriebslager stehen folgende Kombinationen zur Auswahl:

(NU=Zylinderrollenlager als Loslager, QJ=Vierpunktlager, NJ=Zylinderrollenlager,

dass einseitig Axialkräfte aufnehmen kann)

NU + QJ/NU,

NJ + QJ/NU

oder NJ/NJ.

Gewählt wird Variante 1) mit zwei Zylinderrollenlagern als Loslager und einem Vier-

punktlager zur Aufnahme der Axiallast.

Die Lager wurden speziell für diese Verzahnungsvariante und die damit wirkenden

Kräfte ausgelegt. Soll das Gehäuse für andere Verzahnungsvarianten genutzt werden,

muss zuerst überprüft werden, ob die gewählten Lager noch eine ausreichende Le-

bensdauer besitzen. Bei den Antriebslagern ist außerdem zu prüfen, ob ihre Innen-

durchmesser kompatibel mit dem Fußkreis des Ritzels sind (siehe Erläuterungen in

Unterabschnitt 3.2.1) und ob das Ritzel trotz dem äußeren Lagerschulterdurchmesser

noch ins Gehäuse eingeführt werden kann.

### 4.2.1 Antriebslager

Zunächst wurde aus Tragsicherheitsgründen und da es sich um eine Verzahnungs-

variante im oberen Größensegment der Verzahnungsvarianten handelt, die größte

der drei zur Auswahl stehenden Lagergrößen mit einem Innendurchmesser von 80

mm gewählt:

Vierpunktlager Schäffler QJ 216-XL-MPA (S.354 [5])

Innendurchmesser 80 mm

Außendurchmesser 140 mm

Breite 26 mm

2x Zylinderrollenlager mit Käfig Schäffler NU216-E-XL-TVP2 (S.432 [5])

Innendurchmesser 80 mm

Außendurchmesser 140 mm

Breite 26 mm

Allerdings verlangen diese Lager einen Lagerschulterdurchmesser von da=91mm.

Das auf die Welle aufgeschnittene Ritzel hat jedoch nur einen Fußkreisdurchmesser

von dF, Ritzel= 89 mm. Somit würde beim Aufschneiden des Ritzels der Lagersitz ver-

letzt werden. Die Lager müssen neu gewählt werden.

Neue Lager:

Vierpunktlager Schäffler QJ 215-XL-TVP (S.354 [5])

Innendurchmesser 75 mm

Außendurchmesser 130 mm

Breite 25 mm

Zylinderrollenlager mit Käfig Schäffler NU215-E-XL-TVP2 (S.430 [5])

Innendurchmesser 75 mm

Außendurchmesser 130 mm

Breite 25 mm

Zylinderrollenlager mit Käfig Schäffler NU2215-E-XL-TVP2 (S.430 [5])

Innendurchmesser 75 mm

Außendurchmesser 130 mm

Breite 31 mm

Der geforderte Lagerschulterdurchmesser für den Innenring beträgt für diese Lager

nur da=84 mm. Somit werden zum Fußkreis des Ritzels (89mm) je 2,5mm Respekt-

abstand eingehalten und es kommt zu keinen Kollisionen.

Allerdings ist es aus Sicht der Lagerlebensdauer nun nicht mehr möglich, zwei identi-

sche Zylinderrollenlager zu verwenden. Das Lager auf der Motorseite (innen) wird

mehr belastet und deshalb stärker gewählt als das auf der Radseite (außen).

Die Axiallager (Vierpunktlager) wurden entsprechend den Vorgaben gewählt. Auf

Grund der Abmaße der Welle, die auf die Zylinderrollenlager mit Innendurchmesser

von 75 mm abgestimmt ist, entschied man sich hier ebenfalls für einen Innendurch-

messer von 75mm.

Die Lager werden auf der Radseite mit einer auf die Welle geschraubten Lagersiche-

rung fixiert. Dazu sollen drei M8-Schrauben verwendet werden.

Einschraubtiefe
Die Einschraubtiefe für 8.8-Schrauben in Werkstoffe mit Rm < 400 … 600 N
mm²

beträgt

nach [1] 1,2d = 9,6 mm. Der Gewindeüberstand x ist der dreifache Wert der Gewinde-

steigung, hier also 3,75 mm. Der Gewindeauslauf beträgt nach DIN 76 6,2 mm. Die

theoretische Gewindetiefe ergibt sich damit zu 13,35 mm, die Gesamtlochtiefe 19,55

mm. Der Deckel ist 8mm hoch. Die gewählte Schraube ist 20 mm lang. Von dieser

Länge müssen 8 mm abgezogen werden, die nicht als Einschraubtiefe zur Verfügung

stehen. Die verbleibende Schraubenlänge beträgt 12mm, das liegt zwischen der be-

nötigten Einschraubtiefe und der Gewindelänge.

Auf Motorseite werden die Lager mit dem Stützring befestigt. Dieser übt durch die De-

ckelverschraubung eine Kraft auf den äußeren Lagerring aus. Als Verliersicherung für den Innenring dient der Innenteil der Labyrinthdichtung, der mit einer Übergangspas-

sung auf die Welle aufgeschoben ist.

Bei den Antriebslagern muss außerdem beachtet werden, dass das Ritzel für die Mon-

tage des Getriebes nicht nur durch die Bohrung mit dem Lageraußendurchmesser,

sondern durch ein Loch mit dem verringerten Durchmesser Da (Lagerschulterdurch-

messer außen) nach Spezifikation des Lagerherstellers Schaeffler passen muss. Die-

ser beträgt für die gewählten Lager Da= max. 121 mm [5]. Der Kopfkreis des Ritzels

beträgt nach Berechnung durch KissSoft maximal 109,4 mm. Somit ist eine Montage

des Ritzels durch einfaches Einstecken gewährleistet.

### 4.2.2 Abtriebslager

Bei den Abtriebslagern handelt es sich um Kegelrollenlager (TIMKEN LM742710 /

LM742747). Der Lagerkraftangriffspunkt liegt damit nicht mehr mittig zwischen den

Lagern, sondern auf den Drucklinien, deren Winkel in der Spezifikation der Lager an-

gegeben ist. Da es sich um einen amerikanischen Hersteller handelt, sind die Maße

in Inch angegeben, bei Umrechnung in das metrische System entstehen entspre-

chend „krumme“ Werte. Es ist für weitere Berechnungen von Vorteil, den Abstand

der Drucklinien von der Verzahnungsmitte zu kennen. Diese Maße sind in untenste-

hender Skizze visualisiert.

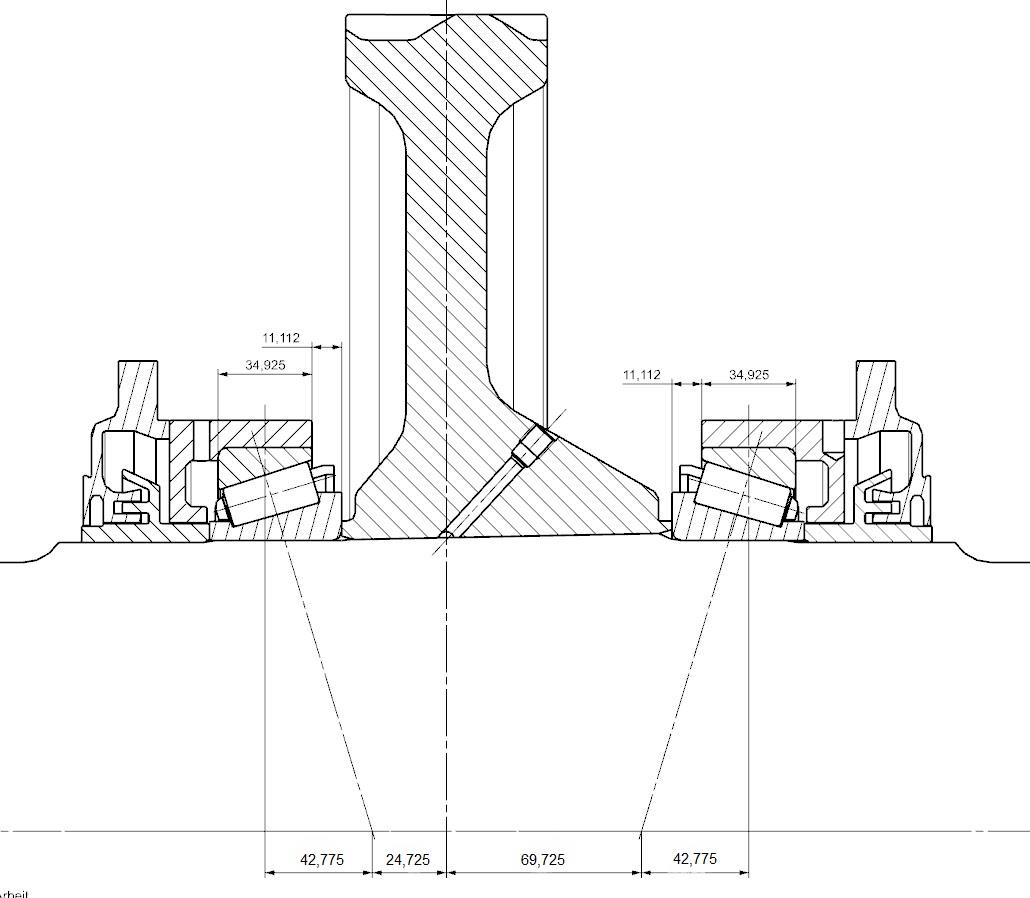
[picture p74: figure]

Abbildung 10: Drucklinien der Timkenlager

Die Abtriebslageraußenringe werden durch die Stützringe fixiert, die wiederum von den

Außenteilen der Labyrinthdichtungen und deren Schrauben ans Gehäuse gepresst

werden. Durch einen Laminumring von 2,5 mm Dicke, der in Zehntelmillimeterschritten

angepasst werden kann, ist eine Vorspannung der Lager möglich. Der Innenring ist wie bei den Antriebslagern durch die Übergangspassung der inneren Labyrinthdich-

tung vor Verrutschen gesichert.

4.3 Lagerlebensdauer

Die Lagerlebensdauer soll jeweils mindestens 3,2 Mio. km betragen.

Drehzahl

Die Abtriebsdrehzahl wird mit folgender Formel für eine Höchstgeschwindigkeit von

100 km/h berechnet.

nab =

5,3 ∙ v

dmittel

=

5,3 ∙ v

(dgrößt + dkleinst)
2

=

5,3 ∙ 100 km
ℎ
0,860 m + 0,770 m
2

= 650,3

1
min

Mit der Übersetzung ergibt sich daraus die Antriebsdrehzahl.

nan = u ∙ nab = 6,143 ∙ 650,3

1
min

= 3994,8

1
min
Zur Auslegung soll die durchschnittliche Drehzahl verwendet werden, die der halben

Maximaldrehzahl entspricht.

nan,Recℎendreℎzaℎl =

nan
2

≈ 2000

1
min

= n

Für Lager A (Axiallager)

Vierpunktlager Schäffler QJ 215-XL-TVP, C=129kN PA = Fa1 = 3,8 kN

L = (

C
P

)

3
- 10⁶ = (

129 kN
4,1 kN )

3
- 10⁶ = 31,1 ∙ 10⁹

L10ℎ =

L
n

=

31,1 ∙ 10⁹
2000 ∙ 60 1
ℎ

= 259 559 ℎ

L10km | = L10ℎ | ∙ 50

km
ℎ

= 13,0 ∙ 10⁶ km

Für Lager Ra (Radiallager außen/Radseite)

Zylinderrollenlager mit Käfig NU215-E-XL-TVP2, C=155kN PRa = FRa = 6,7 kN

L = (

C
P

)

3
- 10⁶ = (

155 kN
6,9 kN )

10
3
- 10⁶ = 32,0 ∙ 10⁹

L10ℎ =

L
n

=

35,3 ∙ 10⁹
2000 ∙ 60 1
ℎ

= 266 539 ℎ

L10km | = L10ℎ | ∙ 50

km
ℎ

= 13,33 ∙ 10⁶ km

Für Lager Ri (Radiallager innen/Motorseite)

Zylinderrollenlager mit Käfig NU2215-E-XL-TVP2, C=192kN PRi = FRi = 12,5 kN

L = (

C
P

)

3
- 10⁶ = (

192 kN
12,5 kN)

10
3
- 10⁶ = 9,0 ∙ 10⁹

L10ℎ =

L
n

=

9,0 ∙ 10⁹
2000 ∙ 60 1
ℎ

= 75 068 ℎ

L10km | = L10ℎ | ∙ 50

km
ℎ

= 3,75 ∙ 10⁶ km

Die geforderte dynamische Lebensdauer wird für alle drei Lager erreicht und teilweise

sogar stark überschritten.

Laut Aufgabenstellung soll eine gleichmäßiger Fahrtrichtungsanteil angenommen wer-

den. Da die Lagerkräfte allerdings betragsmäßig identisch sind für eine umgekehrte

Fahrtrichtung, ergibt sich für die dynamische Berechnung kein Unterschied. Lediglich die statische Belastung der Lager ändert sich. Diese soll jedoch hier nicht gesondert

betrachtet werden.

4.4 Auswahl der Dichtungen

Als zentraler Bestandteil des Dichtungskonzepts sollen Labyrinthdichtungen verwen-

det werden. Labyrinthdichtungen zählen zu den berührungsfreien Dichtungen.

Dadurch ist eine hohe Lebensdauer im Verglich zu schleifenden Dichtungen gewähr-

leistet. Die Dichtwirkung beruht auf austrittsverhindernde Wirbelbildungen oder Stau-

ungen des Schmiermittels in einem Spalt (vgl. [2], S.573). Die hier verwendeten Laby-

rinthdichtungen sind axiale Labyrinthe. Die nachfolgende Abbildung zeigt eine der La-

byrinthdichtungen der Abtriebsseite.

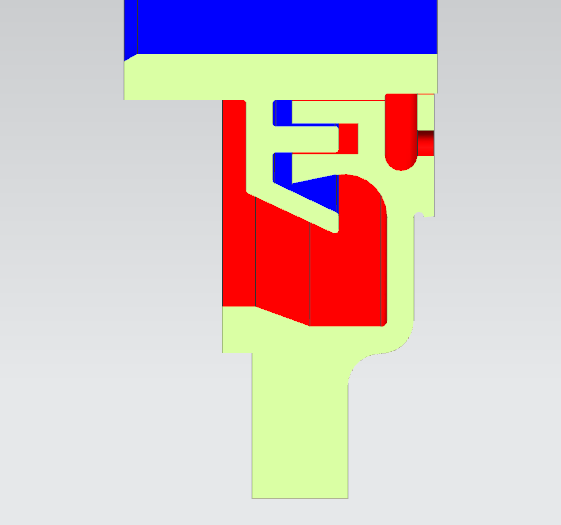
[picture p75: figure]

Abbildung 11: Labyrinthdichtung der Abtriebsseite

Sie besteht aus zwei Teilen (hier blau und rot eingefärbt). Der blau dargestellte Teil

der Labyrinthdichtung wird mit einer h6 / H7 Passung auf die Abtriebswelle montiert.

Darauf wird der rot dargestellte Teil geschoben. Der Radialspalt beträgt 0,3 mm, der

Axialspalt 3 mm. Zur Befestigung dienen pro Seite 12 Sechskantschrauben M10x40.

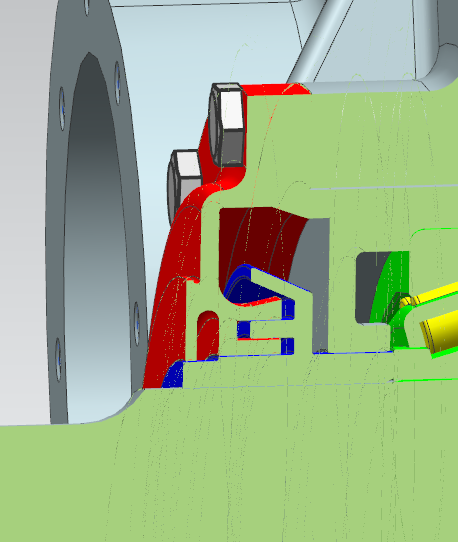
[picture p76: figure]

Abbildung 12: Eingebaute Labyrinthdichtung auf der Abtriebsseite

Als Rohmaterial für den blauen Teil der Labyrinthdichtung soll ein Hohlprofil mit Au-

ßendurchmesser 280 mm, einer Wandstärke von 40 mm und einer Länge von 60 mm

zugekauft werden, für den roten Teil mit Außendurchmesser 360 mm, Wandstärke 70

mm und Länge 40 mm. Auf der Abtriebswelle gibt es insgesamt zwei Labyrinthdich-

tungen – eine auf jede Seite der Welle, sie sind exakt spiegelbildlich zueinander ge-

staltet.

Auf der Antriebsseite gibt es eine axiale Labyrinthdichtung auf der Seite des Zylinder-

rollenlagers NU 2215. Diese Dichtung ist in Abbildung 12 zu sehen.

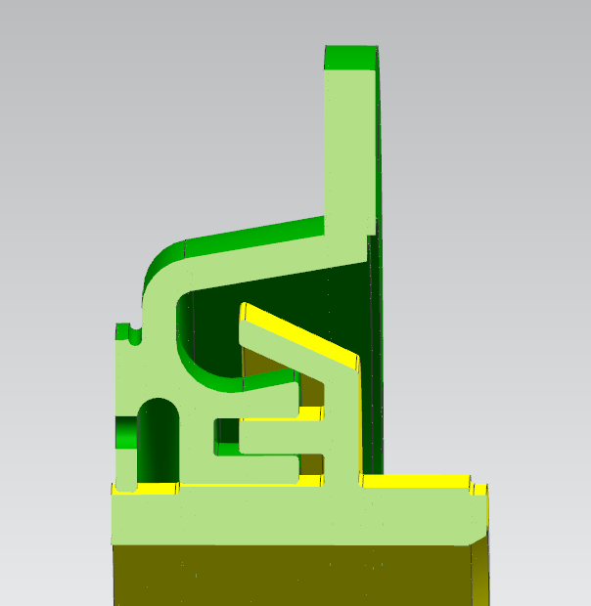
[picture p77: figure]

Abbildung 13: Labyrinthdichtung der Antriebsseite

Auch sie besteht aus zwei Teilen (hier grün und gelb dargestellt). Der gelb dargestellte

Teil der Labyrinthdichtung wird mit einer h6 / H7 Passung auf die Antriebswelle mon-

tiert. Darauf wird der grün dargestellte Teil geschoben. Auch hier beträgt der Radial-

spalt 0,3 mm und der Axialspalt 3 mm. Zur Befestigung dienen 8 Sechskantschrauben

M10x40.

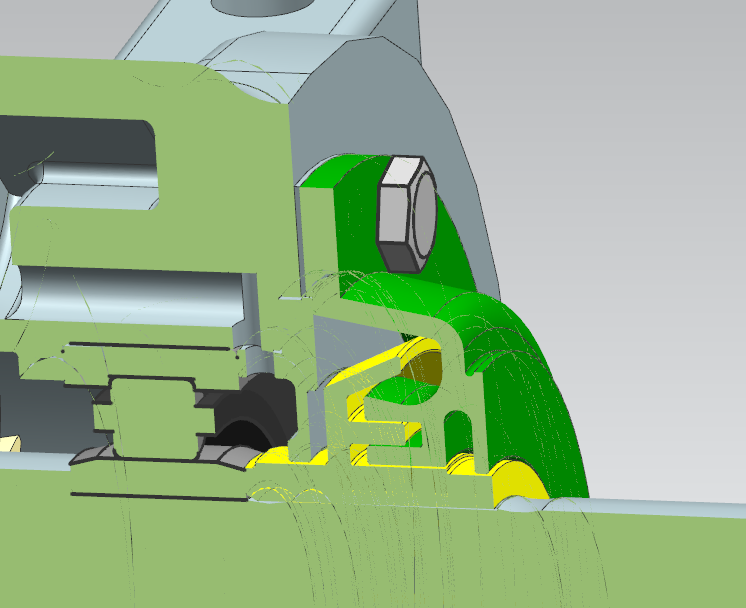
[picture p78: figure]

Abbildung 14: Eingebaute Labyrinthdichtung der Antriebsseite

Als Rohmaterial für den grünen Teil der Labyrinthdichtung soll ein Hohlprofil mit Au-

ßendurchmesser 200mm, einer Wandstärke von 60mm und einer Länge von 40mm

zugekauft werden, für den gelben Teil mit Außendurchmesser 140mm, Wandstärke

40mm und Länge 55mm.

Nach der Konstruktion der Labyrinthdichtung in CAD wurden die Dichtungen der An-

triebsseite im Halbschnitt zur Veranschaulichung als Prototyp mit dem 3D-Drucker ge-

druckt.

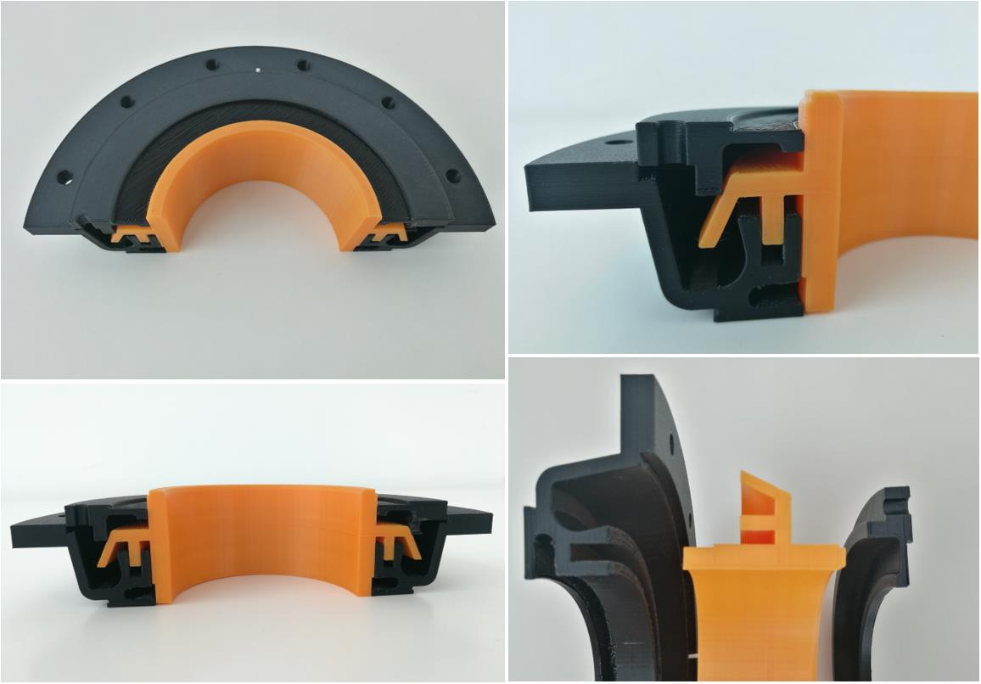
[picture p79: figure]

Abbildung 15: 3D-Druck der Labyrinthdichtung der Antriebsseite

Als Schutz vor Regen oder auf das Getriebe kommende Wasser wurde eine Regen-

rinne an der Labyrinthdichtung angebracht. Abbildung 15 zeigt eine solche Regenrinne

auf der Antriebsdichtung. Diese sammelt das Regenwasser und verhindert, dass der

Großteil davon nicht auf die Dichtkante läuft und unter ungünstigen Bedingungen in

das Gehäuse gelangen kann.

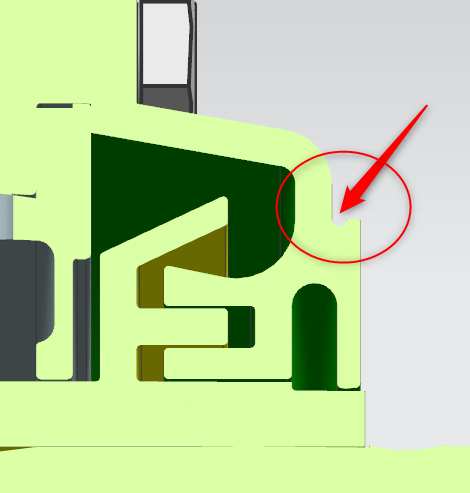
[picture p80: figure]

Abbildung 16: Regenrinne an der Antriebsdichtung

Um bei der Reinigung oder bei ungünstigen Witterungsverhältnissen eindringendes

Wasser aus den Labyrinthdichtungen ablaufen lassen zu können, haben diese je ein

kleines Loch, das nach unten ausgerichtet ist. Dies ist auf den nachfolgenden Bildern

verdeutlicht.

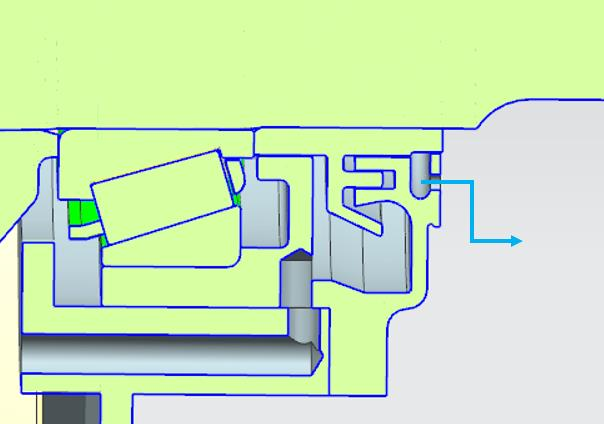
[picture p81: figure]

Abbildung 17: Entwässerung der Abtriebsdichtung, Schnittansicht

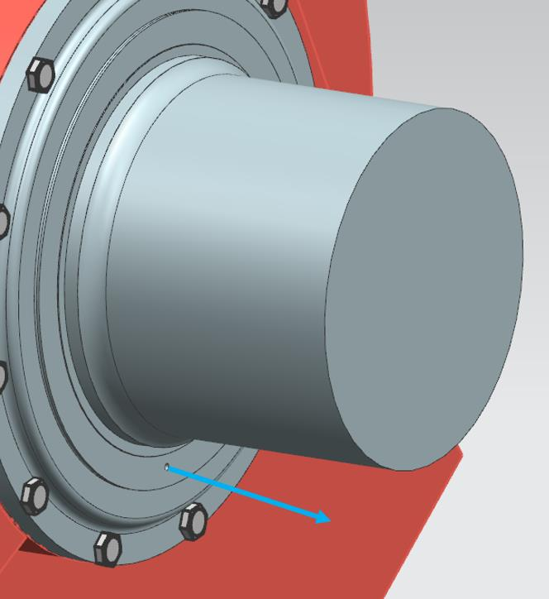
[picture p82: figure]

Abbildung 18:Entwässerung der Abtriebsdichtung

Um dessen Lage nach unten sicherzustellen, ist ein Sicherungsstift zu montieren.

Wichtig ist außerdem, dass die Befestigungsschrauben nicht mit den Ölzufuhrkanä-

len der Lager kollidieren. Aus diesem Grund wurden die Bohrungen des Lochkreises

um 15° (Abtriebsseite) bzw. 22,5° (Antriebsseite) zur Vertikalen verschoben.

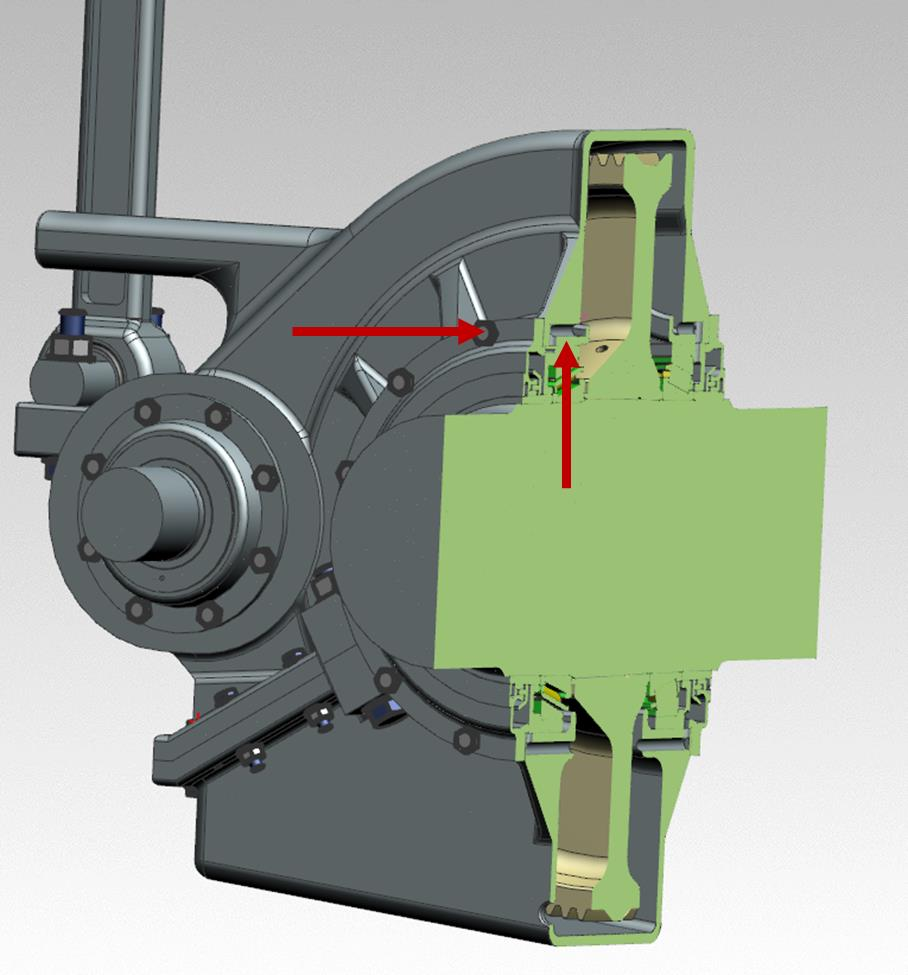
[picture p83: figure]

Abbildung 19: Lochkreis – Ölzufuhr

4.5 Lagereinbautoleranzen

Die Lagereinbautoleranzen können nach verschieden Normsystemen bestimmt wer-

den. Da das verwendete Timken-Lager in Inch verkauft, aber in einer metrischen Kon-

struktion verbaut wird, wird zusätzlich in der Dokumentation die Tolerierung nach Nord-

amerikanischem Standard erwähnt.

Tolerierung nach DIN EN ISO 286

Für die Timken-Lager wird nach Europa Tabellenbuch Metall [1] eine Übergangspas-

sung empfohlen. Um die Zeichnungsangabe zu vereinfachen, wurden die Tausends-

telstellen mit in die Toleranz eingerechnet. Somit ergeben sich für die Zeichnungsan-

gabe folgende Maße:

216,41 ±0,013

Tolerierung nach ANSI B 4.1

Das American National Standards Institute (ANSI) empfiehlt für Lagerpassungen eine „Transition Locational Fit“, was einer Übergangspassung entspricht. Damit ergibt sich

für die Timken-Lager folgende Passung:

8.52“ LT2

Lagerluft

Die benötigte Lagerluft für alle verwendeten Lager, wird mit Toleranzklasse C angege-

ben.

## 5 Schmierung

Geschmiert werden müssen die Antriebslager (Vierpunktlager und Zylinderrollenla-

ger), die Abtriebslager (Kegelrollenlager) und die Verzahnung selbst. Als Schmierung ist eine Tauchschmierung mit Ölsumpf im Gehäuse vorgesehen. Das Großrad soll im

Durchschnitt bis zu einer Tiefe von 5xmn im Ölsumpf liegen, bei einem Modul von 4,5

mm bedeutet das eine Eintauchtiefe von 22,5 mm. Die exakte benötigte Ölmenge kann

nur durch Versuche bestimmt werden, jedoch liegt die ideale Öllinie bei einem Abstand

von 5 mm zwischen unterstem Zahnradkopfkreispunkt und Gehäuse 27,5mm über der Gehäuseunterkante (innen). Aus diesem Maß kann die Lage des Ölschauglases ab-

geleitet werden. Das Ölschauglas ist ein Zukaufteil der Marke Ganter.

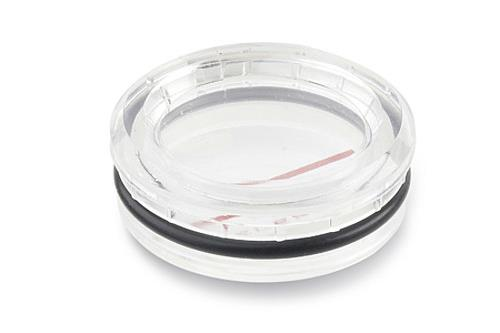
[picture p84: figure]

Abbildung 20: Ölschauglas GN 542

(Quelle: https://www.leschhorn.de/de/artikel/gn_542_oelschauglaeser/10192785)

Das Nachfüllen des Öls soll über einen Einfüllstutzen erfolgen. Dieser muss so ge-

staltet sein, dass das Nachfüllen ohne Ausbau des Getriebes erfolgen kann (also un-

ter dem Schienenfahrzeug), deshalb darf sie nicht zu hoch am Gehäuse angebracht sein. Gleichzeitig soll auch bei Schräglage des Getriebes kein Öl ausdringen können

(siehe Abschnitt 5.5). Der Einfüllstutzen wird mit einem Kunststoffdeckel verschlossen, um Verunreinigungen des Getriebeinneren und einem Auslaufen des Öls in die

Umwelt vorzubeugen. Der Deckel ist ein Zukaufteil der Marke Ganter (siehe unten).

Das Anschlussgewinde ist M60 x 2.


Abbildung 21: Zukaufteil Einfülldeckel

5.1 Ölzufuhr

Das Öl aus dem Sumpf wird durch das Eintauchen des Großrades nach oben ge-

schleudert. Es prallt gegen die Gehäuseinnenwände und läuft an diesen hinab. An den Gehäuseinnenwänden sind deshalb Ölrinnen angebracht, in denen das Öl gesammelt

wird und zu den vier Lagerstellen geleitet wird. Dazu sind innere Ölleitungskanäle im

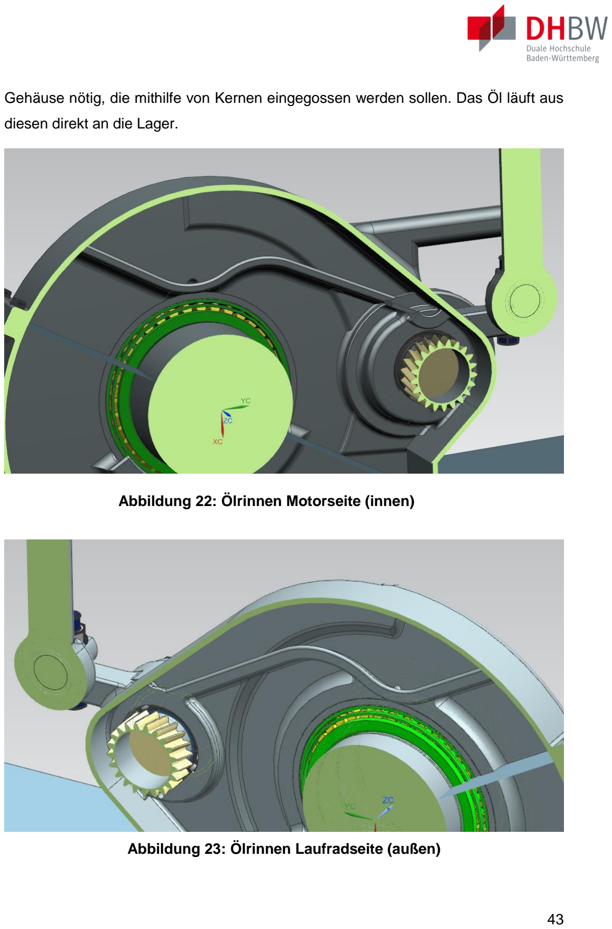
[picture p85: page 50]

Gehäuse nötig, die mithilfe von Kernen eingegossen werden sollen. Das Öl läuft aus

diesen direkt an die Lager.

Abbildung 23: Ölrinnen Laufradseite (außen)

Abbildung 22: Ölrinnen Motorseite (innen)

Bei den Kegelrollenlagern am Abtrieb muss das Öl von der getriebeabgewandten Seite

zugeführt werden, da die Lager einerseits dort am Innenring die größte Umlaufge-

schwindigkeit haben und deshalb thermisch am meisten belastet werden und da das Öl baubedingt immer in die eingezeichnete Richtung innerhalb der Lager gefördert wird

(siehe Bild). Damit auch nach Stillstand eine Anfangsschmierung gewährleistet ist,

sind den Abtriebslagern Stützringe vorgelagert, die gleichzeitig eine Staufunktion im Gehäuse haben. Allerdings muss das Öl nun durch diese Stützring „hindurchkommen“.

Sie erhalten deshalb oben eine Bohrung, deren Lage mit einem Sicherungsstift sicher-

gestellt wird.

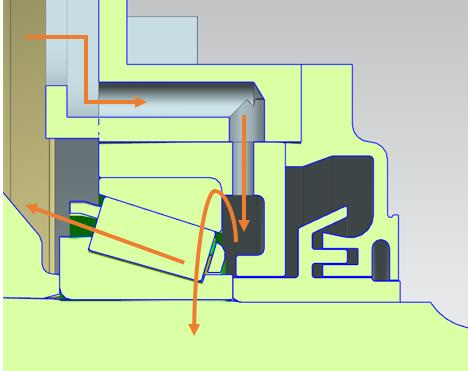
[picture p86: figure]

Abbildung 24: Ölzufuhr Abtriebslager

Auf der Antriebsseite wird das Öl ebenfalls von außen an das einzeln stehende Zylin-

derrollenlager geleitet. Der Stütz- und Stauring sorgt dafür, dass nur wenig Öl in die

Labyrinthdichtung und damit potentiell in die Umwelt gelangt.
Auf der Antriebsseite soll das Öl zwischen dem Zylinderrollen- und Vierpunktlager ein-

treten. Dazu werden diese mit einem Distanzring voneinander getrennt. Der Distanzring besitzt im Abstand von 90° vier Nuten, die das Öl durchlassen sollen. Die Stau-

ringfunktion erfüllt hier der aufgeschraubte Deckel.

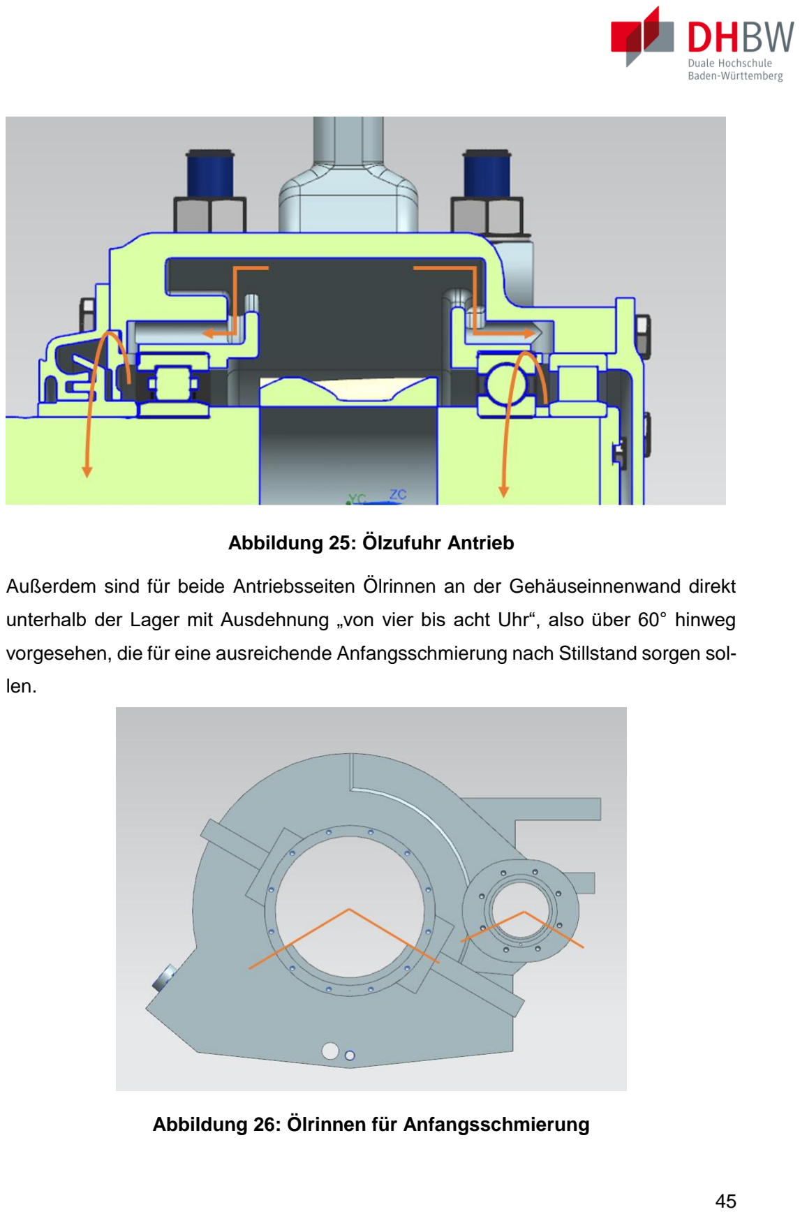
[picture p87: page 52]

Abbildung 25: Ölzufuhr Antrieb

Außerdem sind für beide Antriebsseiten Ölrinnen an der Gehäuseinnenwand direkt

unterhalb der Lager mit Ausdehnung „von vier bis acht Uhr“, also über 60° hinweg

vorgesehen, die für eine ausreichende Anfangsschmierung nach Stillstand sorgen sol-

len.

Abbildung 26: Ölrinnen für Anfangsschmierung

5.2 Ölabfuhr/Entlüftung

Es ist nicht erwünscht, dass sich Öl in den Labyrinthdichtungen sammelt. Deshalb

müssen diese entlüftet werden. Damit möglichst wenig Öl in diese kritische Zone ein-

dringt, wird der Stütz- und Stauring eingebaut. Alles Schmiermittel, welches unter dem Stauring hindurchfließt, wird über die Ölleitungskanäle wieder zurück in das Gehäuse

abgeführt. Diese sind exemplarisch in Abbildung 26 dargestellt.

Damit der Stützring ein reines Drehteil (lediglich mit Bohrungen) bleibt und keine Öl-

kanäle von außen aufgesetzt werden müssen, fiel die Wahl zur Entlüftung der Ab-

triebslabyrinthdichtungen auf die im Bild unten dargestellte Variante. Im Gehäuse sind innere Ölleitungen vorhanden, die das durch den Stützring austretende Öl zurück in

den Ölsumpf führen.


Abbildung 27: Ölabfuhr Abtriebslager

Auf der Antriebsseite wird dasselbe Funktionsprinzip verwendet. Die Lage der Stütz-

ringe bzw. die Lage des Deckels kann durch Sicherungsstifte festgelegt werden.

Um das Öl komplett zu wechseln, ist am Gehäuse am tiefstmöglichen Punkt eine

Ölauslassbohrung angebracht. Sie wird im Betrieb mit einem Magnetstopfen ver-

schlossen, der gleichzeitig metallische Schwebteilchen aus dem Öl anzieht und somit

den Verschleiß verringert.

Damit kein Überdruck im Gehäuse entsteht, ist an der Gehäuseoberseite eine Entlüf-

tungsschraube angebracht, die einen Druckausgleich mit der Umgebung zulässt.

5.3 Abdichtung

Die Schrauben werden mit LOCTITE 567 abgedichtet. Diese Methacrylat-Gewinde-

dichtung leistet eine niedrige Demontage-Festigkeit und hat einen Einsatztempera-

turbereich von -55°C bis 150°C.

Für eine einfachere Montage und eine bessere Abdichtung werden die Laminum-

ringe auf das Gehäuse aufgeklebt. Verwenden Sie LOCTITE AA 326. Er härtet innerhalb 3 Minuten und hält eine Scherfestigkeit von 15 N
mm²

5.4 Schmieranweisung und Kontrolle der Schmierung

Das Getriebe ist mit dem Öl SHC 75W90 GL5 in Einbaulage bis zur Markierung am

Ölschauglas zu befüllen. Hierfür werden ca. 2,1l benötigt in gerader Lage.

Eine gesonderte Schmierung der Lager ist nicht notwendig. Die Kontrolle des Ölstan-

des soll alle 250 000 Fahrtkilometer oder alle 6 Monate durchgeführt werden.

5.5 Simulation

Für eine erste Validierung des Ölfüllstandes wurde mithilfe des Programms Blender

eine einfache Fluidsimulation erstellt. Blender ist eine frei zugänglich Open Source 3D

Grafiksuite mit verschiedenen Werkzeugen für Animation, Simulation und Bildbearbei-

tung.

Obwohl die Software primär für den Kreativbereich und Filmbearbeitung benutzt wird, kann mit dieser eine Annäherung an das Verhalten des Öls im Getriebegehäuse getä-

tigt werden.

Zur Simulation wurde eine vereinfachte Konstruktion des Gehäuses verwendet, um die

Simulation zu beschleunigen und Simulationsfehler vorzubeugen. Für die Flüssigkeit dient ein volumengleicher Quader zum regulären Ölvolumen.

In der Simulation wird das Gehäuse in die jeweiligen maximalen Schräglagen von ±6°

(zusätzliche Schräglage aufgrund des Untergrundes werden vernachlässigt, da diese

nur temporär sind) gekippt, sobald sich die Simulation stabilisiert kann eine Moment-

aufnahme gemacht werden. Diese Aufnahmen sind in Abbildung 27 bis 29 zu sehen. Bei keiner Stellung gab es Probleme bezüglich der Überflutung der Labyrinth Dichtun-

gen oder bezüglich eines Auslaufens aus der Einfüllbohrung.

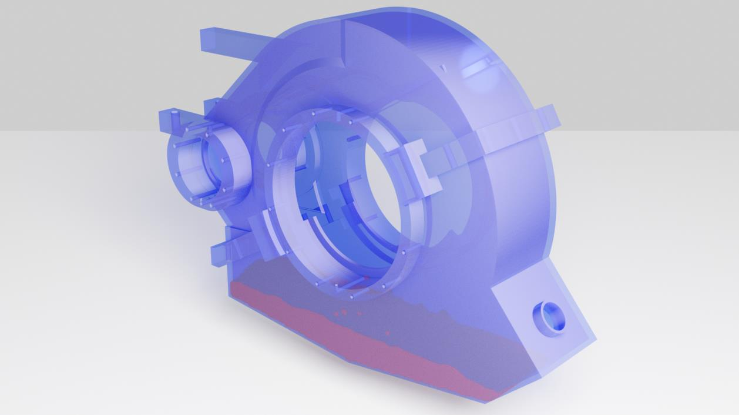
[picture p88: figure]

Abbildung 27: CFD - Ölstand horizontal

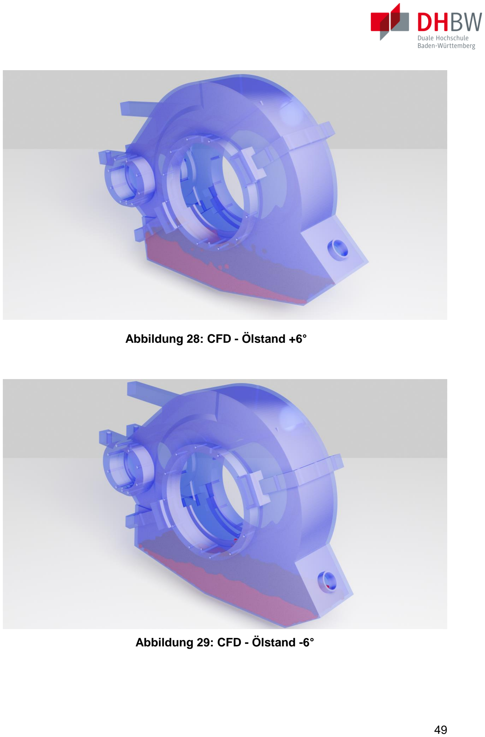
[picture p89: page 56]

Abbildung 29: CFD - Ölstand -6°

Abbildung 28: CFD - Ölstand +6°

Des Weiteren konnte mit dem Programm Ansys Academic eine Simulation des Zwei-

phasen-Fluidgemisches während der Befüllung erstellt werden. Diese ermöglicht eine

Fallstudie bezüglich der Befüllung und der Momentanverteilung der Fluide zu jedem

Zeitpunkt.

Ansys ist eine Software zur allgemeinen Systemsimulation für Ingenieure. Dafür wer-

den sehr viele Werkzeuge für die numerische Lösung von verschiedenen Problemen

geboten.

In Abbildung 30 sind einzelne Ausschnitte aus der kompletten Simulation zu sehen. Hierbei stellt die Farbe rot das Fluid Öl dar und die Farbe blau die Umgebungsluft, die

sich schon im Gehäuse befindet. Alle anderen Farben stellen eine Mischung der bei-

den Fluide dar. Ein Animationsvideo der CFD-Simulation ist auf der CD beigelegt.

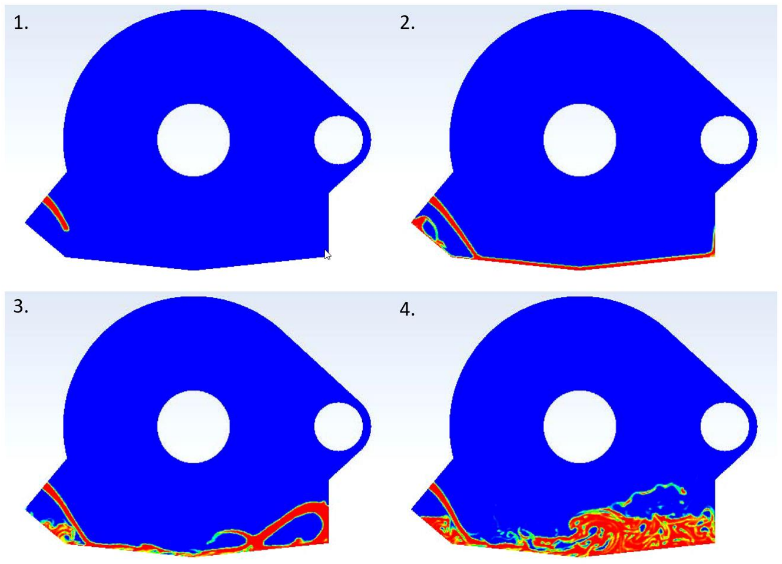
[picture p90: figure]

Abbildung 30: CFD Simulation des Einfüllvorgang – Rot symbolisiert Öl

## 6 Gehäuse

Um die Verzahnung zu platzieren und vor Verschmutzungen zu schützen sowie für eine ausreichende Ölzufuhr zu sorgen, benötigt das Getriebe ein Gehäuse. Dieses soll

nach Anforderungsliste als Gussteil gestaltet werden. Die Gussradien sind 4 mm bis

35 mm groß.

Das Gehäuse soll nicht nur für die vorliegende Getriebevariante passend gestaltet

sein, sondern auch die Möglichkeit bieten, ein größeres oder kleineres, breiteres oder

schmäleres Ritzel und Großrad einzubauen und den Achsabstand damit zu variieren.

Die Varianz der Achsabstände von 340 mm bis 360 mm wird durch einen ovalen

Flansch auf Antriebsseite ermöglicht. Erst bei der Fertigbearbeitung des Gussgehäu-

ses wird die Bohrung für die Antriebslager gesetzt und damit der Achsabstand be-

stimmt. Der ovale Flansch ist mit einer roten Linie gekennzeichnet, der kleinste Achs-

abstand von 340 mm wird durch die blaue Bohrung erreicht, die hier vorgestellte Vari-

ante durch die grüne Bohrung (a=350 mm) und der größte Achsabstand durch die

orangefarbene Bohrung.

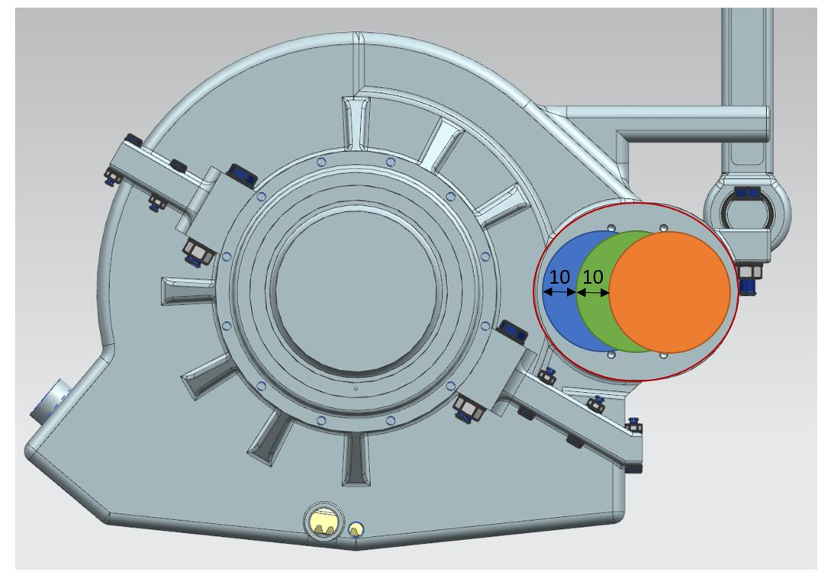
[picture p91: figure]

Abbildung 28: Ovaler Flansch - Variable Achsabstände

Folgende Flächen des Gehäuses müssen spanend nachbearbeitet werden:

- Lagersitze an Antrieb und Abtrieb
- Ölanfangsschmierungsrinnen
- Auflageflächen der Deckel und Labyrinthdichtungen
- Bohrungen und Gewinde für die Deckel und Labyrinthdichtungen
- Auflageflächen der Flansch- und Ankerschraubenunterlegscheiben
- Bohrungen für die Flansch- und Ankerschrauben
- Trennfuge des Gehäuses
- Flansch für das Ölschauglas
- Bohrung und Innengewinde des Magnetstopfens
- Bohrung und Außengewinde des Öleinfülldeckels
- Auflage des Bolzens der Drehmomentstütze

Reine Auflageflächen sollen dabei die Oberflächengüte Rz16 erreichen, Passungen

die Oberflächengüte Rz4.

Ebenfalls in Abbildung 27 zu sehen ist der am Gehäuse angebrachte Notfang, der im

unerwarteten Fall, dass die Drehmomentstütze doch reißt sollte, das Gehäuse vor un-

kontrollierter Verdrehung schützt.

6.1 Teilung

Das Gehäuse wird in einem Winkel von 30° geteilt. So entstehen keine Probleme

durch Kollision bei der Montage der Flanschschrauben. Abbildung 29 zeigt die

Ebene, die zur Teilung des Gehäuses herangezogen wurde. Diese liegt auf der Mit-

tellinie der Abtriebswelle. Abbildung 30 zeigt das fertig geteilte Gehäuse.

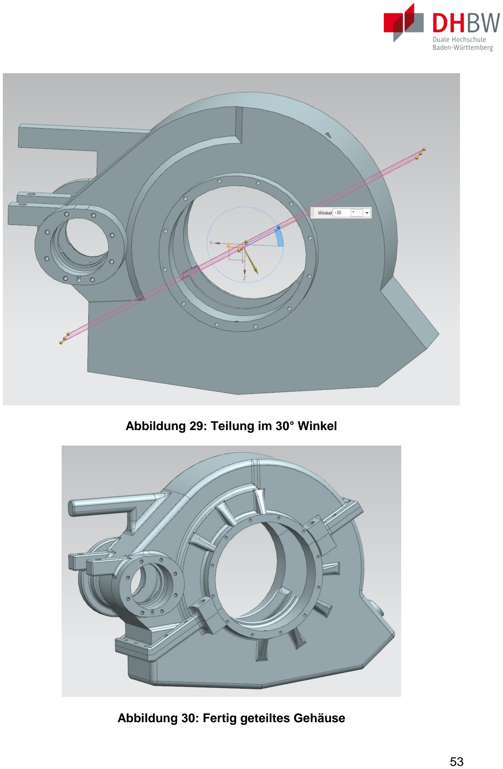
[picture p92: page 60]

Abbildung 29: Teilung im 30° Winkel

Abbildung 30: Fertig geteiltes Gehäuse

Die Teilung wird mit insgesamt 12 M10-Schrauben abgedichtet. Sie besitzen je zwei

Unterlegscheiben, um den Gehäusewerkstoff zu schonen. Da es sich um Durchgangs-

löcher handelt, ist ein leichtes Verrutschen der Gehäuseteile zueinander allein durch

die Schrauben nicht ausgeschlossen. Um dies zu verhindern, müssen zusätzlich zu

den Schrauben noch zwei eingepresste Zylinderstifte am Flansch angebracht werden,

die die Lage absolut sichern. Es handelt sich um Normteile nach ISO 2338 – 8 – m6 x

40

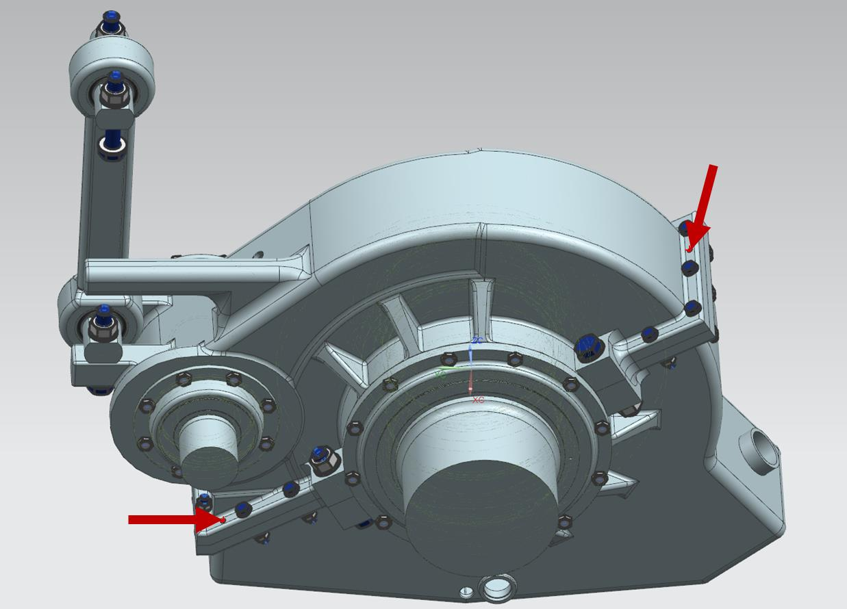
[picture p93: figure]

Abbildung 31: Sicherungsstifte am Flansch

### 6.1.1 Berechnung der Ankerschrauben

Die Schraubenberechnung für die Drehmomentstütze wurde mit Kissoft nach VDI 2230

durchgeführt.

Der radiale Kraftanteil in Flanschrichtung wird durch die Lager aufgenommen und über

sie ans Gehäuse und damit an die Verschraubung weitergeleitet, der axiale Kraftanteil

wirkt ebenfalls auf die Ankerschrauben. Es werden vier Ankerschrauben vorgesehen,

zwei auf jeder Seite und möglichst nahe an der Abtriebswelle platziert.

Das Nennmoment wird als statisch angenommen, das Maximalmoment aufgrund sei-

ner kurzen Wirkzeit als dynamisch.

Verwendetes Rechenmoment | Nennmoment am Abtrieb = 10800 Nm | Maximalmoment im Kurz-schlussfall am Abtrieb = 54000 Nm
Ft [kN] | 35,9 | 179,4
Fr [kN] | 14,5 | 72,6
Fa [kN] | 8,4 | 41,9
Aus | Sicht | der | Schrauben | beträgt | die | Axialkraft | Fa,statiscℎ = √Ft 2 + Fr
2 =
√35,9 | 2 + 14,5
2 kN = 38,7 kN, also pro Schraube Fa,Scℎraube,statiscℎ = 9,7 kN. Für den

dynamischen Fall wird äquivalent Fa,Scℎraube,dynamiscℎ = 48,4 kN. Die Berechnung

wurde mit KissSoft durchgeführt (Originaldatei siehe CD und Protokoll siehe Anhang).

Die Reserveklemmkraft beträgt 88 kN bei Ausnutzung der Streckgrenze zu 90%.

6.2 Wandstärke und Verrippung

Die Wandstärke ist mit 8 mm fertigungs- und festigkeitstechnisch vorgegeben.

Sie soll so konstant wie möglich über das gesamte Gehäuse gehalten werden, um

Lunkerbildung zu vermeiden.

Die Verrippung an den radialen Schraubenflaschen entlang ebenfalls in Radialrichtung

dient zur Formstabilisierung des Gehäuses im Gießprozess. Die Rippen sind in der

Gesamtansicht (Abschnitt 9.1) gut zu erkennen.

6.3 Respektabstände

Der größte Ritzelkopfdurchmesser beträgt 127 mm, der größte Großraddurchmesser

619 mm. Für diese Größen soll immer noch ein ausreichender Abstand zur Gehäuse-

wand gegeben sein, dieser beträgt 5 mm in Radialrichtung und 10 mm in Axialrichtung.

Die maximale Zahnradbreite beträgt 80 mm, das Ritzel kann maximal 82 mm breit sein.

In folgender Skizze sind die Kopfkreise größten Räder bei größtem Achsabstand ins

Gehäuse eingezeichnet (blau und pink) und die Umrisse der tatsächlich eingebauten

Räder skizziert. Dabei bleibt immer noch ein Abstand zur Gehäusewand von mindes-

tens 5 mm.


Abbildung 32: Größte Räder bei größtem Achsabstand

Auch bei Ansicht senkrecht zu obigem Schnitt soll noch ein ausreichender Abstand vor allem zu den Ölrinnen eingehalten werden. Dabei ist allerdings zu bedenken, dass das

Rad nur im obersten Bereich (ca. 10% des Durchmessers) die maximale Breite hat

und sonst mit einem Steg gestaltet wird, der axiale Respektabstand also größer als

hier dargestellt ist.

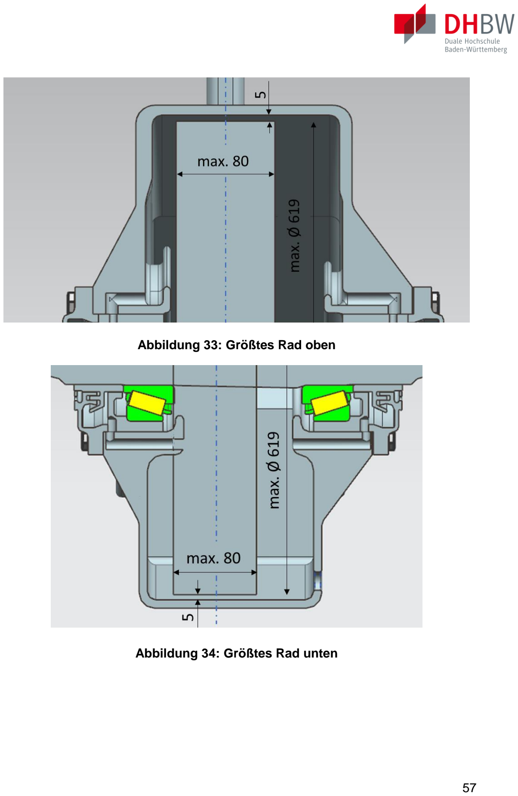
[picture p94: page 64]

Abbildung 33: Größtes Rad oben

Abbildung 34: Größtes Rad unten

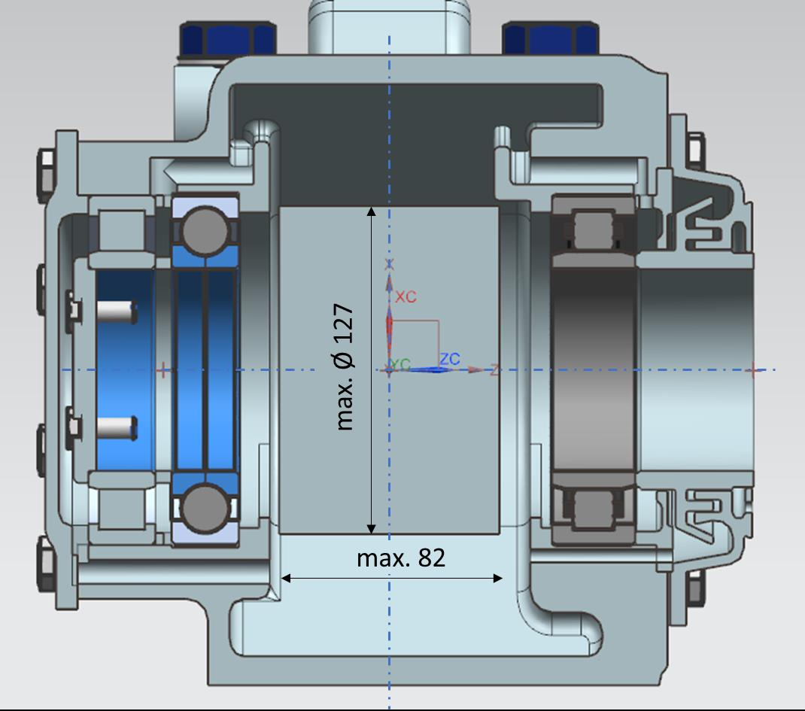
[picture p95: figure]

Abbildung 35: Größtes Ritzel

Die Bodenfreiheit des Getriebes soll nach Anforderungsliste 62,5 mm betragen, auch

bei abgefahrenen Reifen, also Reifendurchmesser von 770 mm (= Achshöhe 335 mm).

Damit darf die Gehäuseunterkante maximal 385 mm - 62,5 mm = 322,5 mm unter den

Radmittelpunkten liegen. In untenstehender Skizze ist das Getriebe auf dem kleinsten

Laufraddurchmesser angebracht.

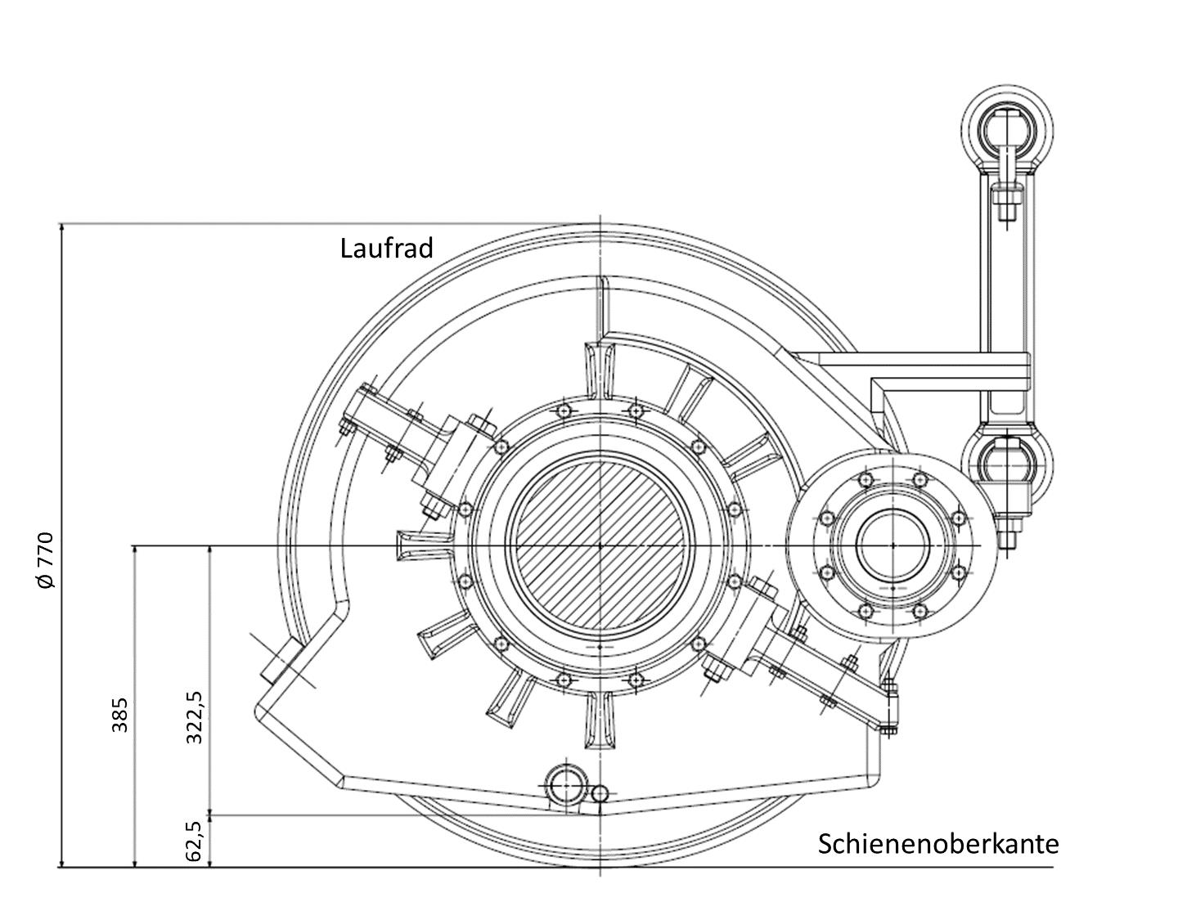
[picture p96: figure]

Abbildung 36: Bodenfreiheit

Der größte Zahnradradius beträgt r2=619 mm/2=309,5 mm. Das bedeutet, dass genau

13 mm bleiben, die sich auf 8 mm Gehäusewandstärke und 5 mm Abstand zwischen

Rad und Gehäuse aufteilen. Im Kippfall von +/- 6° soll die Bodenfreiheit immer noch

eingehalten werden. Deshalb ist eine Schräge im Winkel von mindestens 6° an der

Gehäuseunterkante notwendig, also ein Innenwinkel von 84°.

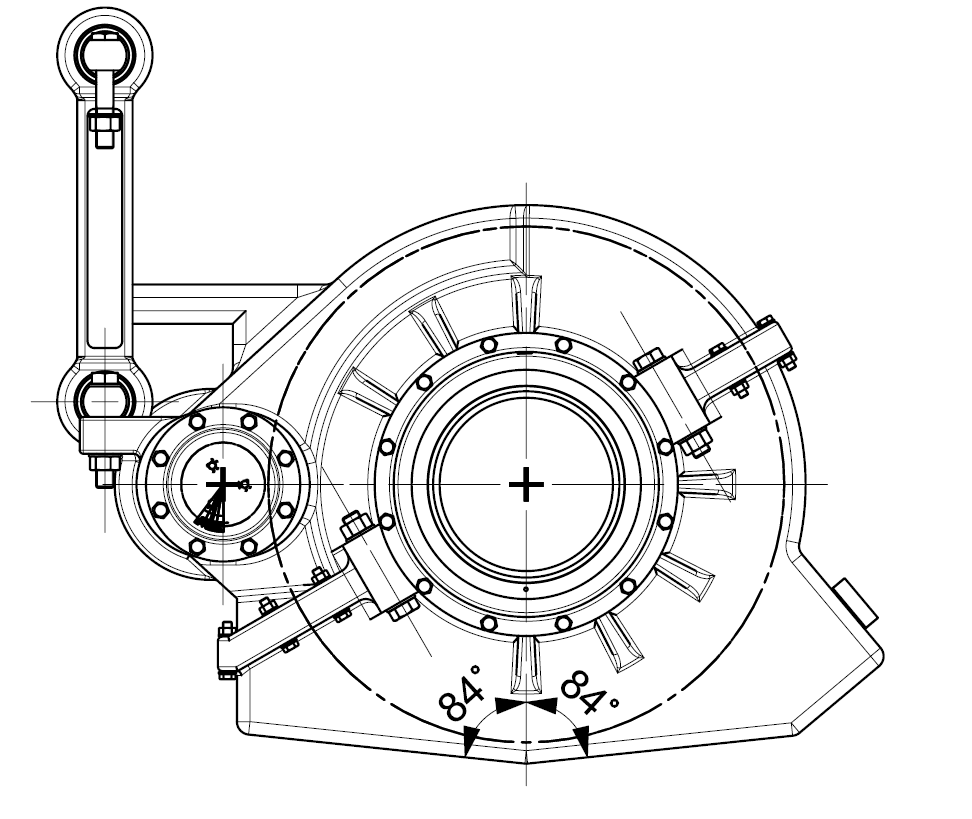
[picture p97: figure]

Abbildung 37: Winkel an der Gehäuseunterkante

## 7 Drehmomentstütze

Die Drehmomentstütze stellt die Verbindung zwischen dem Getriebe und dem Dreh-

gestell dar. Sie wird als Kaufteil bei einem Zulieferer mit den bekannten Maßen in Auf-

trag gegeben. Ihr Bolzenabstand beträgt 400 mm.

7.1 Kritischer Querschnitt

Der Kritische Querschnitt liegt zwischen den beiden Bohrungen. Durch die Aussparung beträgt die Querschnittsfläche noch 2x 30mmx12mm + 40mmx8mm= 1040 mm²
. Mit

der maximalen Kraft auf die Drehmomentstütze von 129 kN (siehe 6.2) beträgt die

Spannung in der Drehmomentstütze σ =

129 kN
1040 mm² = 124,0

N
mm²

. Für den Werkstoff EN-

GJS-500-7 gilt Rm =

320N
mm²

. Damit beträgt die Sicherheit selbst im Kurzschlussfall noch

2,6.

7.2 Schraubenberechnung

Die Schraubenberechnung für die Drehmomentstütze wurde mit KissSoft nach VDI

2230 durchgeführt. Das Protokoll sowie die Originaldatei sind im Anhang zu finden.

Der Hebelarm des auf die Schrauben wirkenden Gesamtmoments beträgt
ℎ = 136mm + a = 136 mm + 350 mm = 486,5 mm.

Das abzustützende Gesamtmoment beträgt

Tges,statiscℎ = (u + 1) ∙ TAntrieb,Auslegungsmoment

Tges,statiscℎ | = 7,143 | ∙ 3516 Nm = 25115 Nm

Es soll mit einer dynamischen Last in Höhe des Kurzschlussantriebsmomentes ge-

rechnet werden.

Tges,dynamiscℎ = (u + 1) ∙ TAntrieb,Spitzenmoment

Tges,dynamiscℎ | = 7,143 | ∙ 8790 Nm | = 62786 Nm

Die Kraft auf die Schrauben erhält man durch die Kombination aus Hebelarm und

Gesamtmoment:

Fstatiscℎ =

Tges,statiscℎ
ℎ

=

25115 Nm
486,5 mm

= 52 kN.

Fdynamiscℎ =

Tges,dynamiscℎ
ℎ

=

62786 Nm
486,5 mm

= 129 kN.

Diese Kraft verteilt sich gleichmäßig auf die zwei Schrauben:

FScℎraube,statiscℎ =

Fstatiscℎ
2

=

52 kN
2

= 26 kN.

FScℎraube,dynamiscℎ =

Fdynamiscℎ
2

=

129 kN
2

= 64,5 kN.

Gewählt werden zwei M20-10.9 Schrauben mit einer Länge von 120 mm als Durch-

steckverbindung und zwei Unterlegscheiben.

7.3 Bolzenauswahl

Der Bolzen stellt die Verbindung zwischen dem Gehäuse und der in die Drehmoment-

stütze eingepressten Gummi-Metall-Buchse dar. Eine genaue Festigkeitsberechnung

ist ohne FEM nicht möglich, weil sich der Querschnitt des Bolzens ändert und es sich

um keinen Bolzen im klassischen Sinne, sondern um eine Schraubverbindung mit Bol-

zenfunktion handelt.

Um den Bolzen möglichst unkompliziert und mit wenigen Bearbeitungsgängen fertigen

zu können, ist folgende Form von Vorteil:

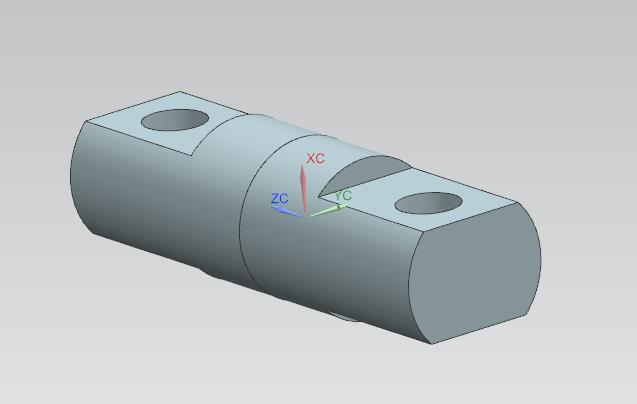
[picture p98: figure]

Abbildung 38: Bolzen Drehmomentstütze

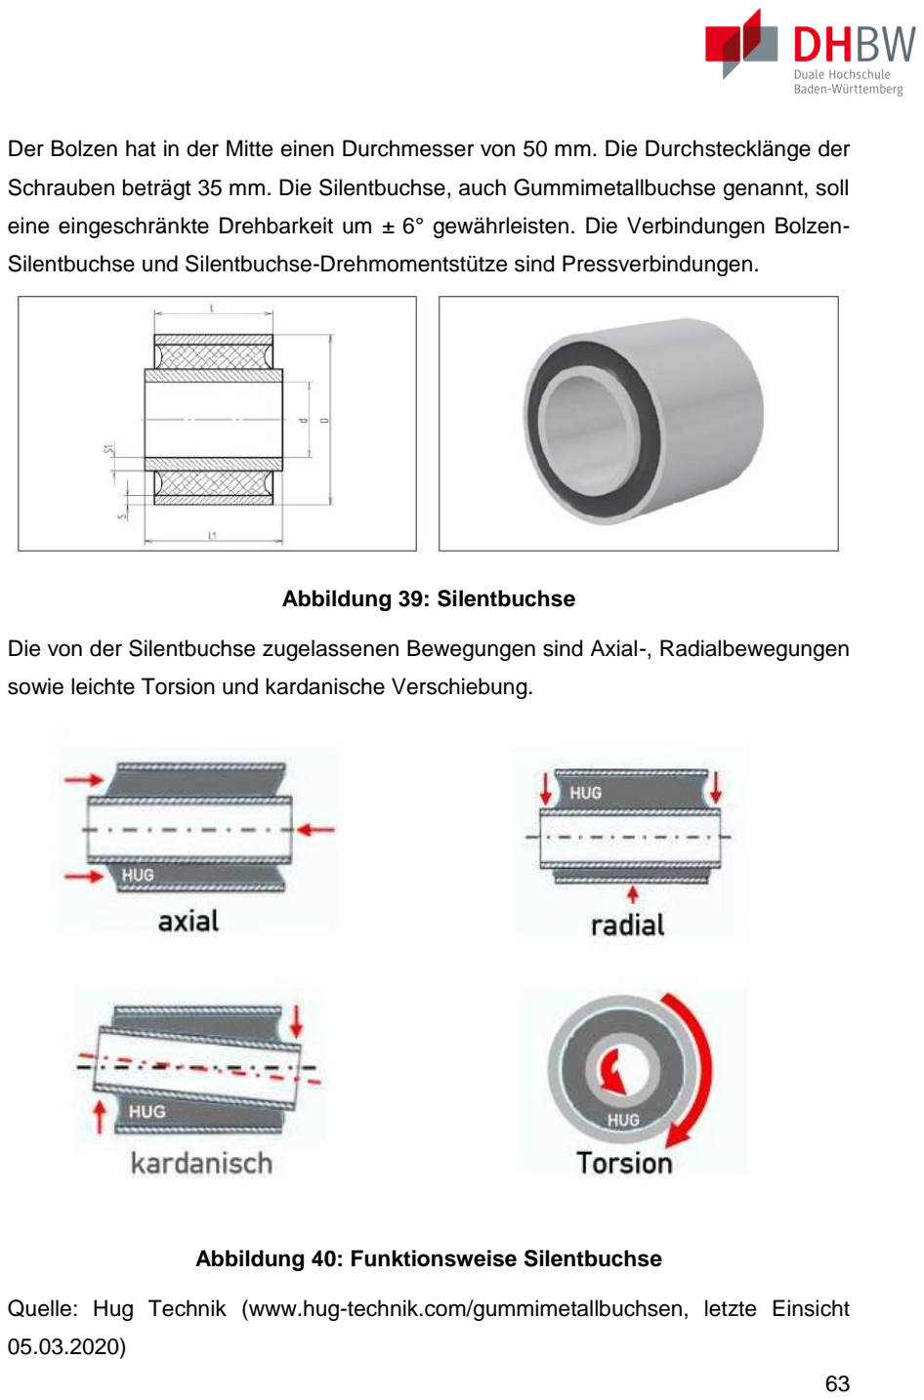
[picture p99: page 70]

Der Bolzen hat in der Mitte einen Durchmesser von 50 mm. Die Durchstecklänge der

Schrauben beträgt 35 mm. Die Silentbuchse, auch Gummimetallbuchse genannt, soll

eine eingeschränkte Drehbarkeit um ± 6° gewährleisten. Die Verbindungen Bolzen-

Silentbuchse und Silentbuchse-Drehmomentstütze sind Pressverbindungen.

Abbildung 39: Silentbuchse

Die von der Silentbuchse zugelassenen Bewegungen sind Axial-, Radialbewegungen

sowie leichte Torsion und kardanische Verschiebung.

Abbildung 40: Funktionsweise Silentbuchse

Quelle: Hug Technik (www.hug-technik.com/gummimetallbuchsen, letzte Einsicht

05.03.2020)

7.4 Kollisionskontrolle

Auch bei maximaler Auslenkung des Getriebes im Extremfall um 6° in beide Richtun-

gen soll die Drehmomentstütze nicht mit dem Gehäuse kollidieren. Durch die sehr

hoch angebrachte Anbindung ist dies gewährleistet.

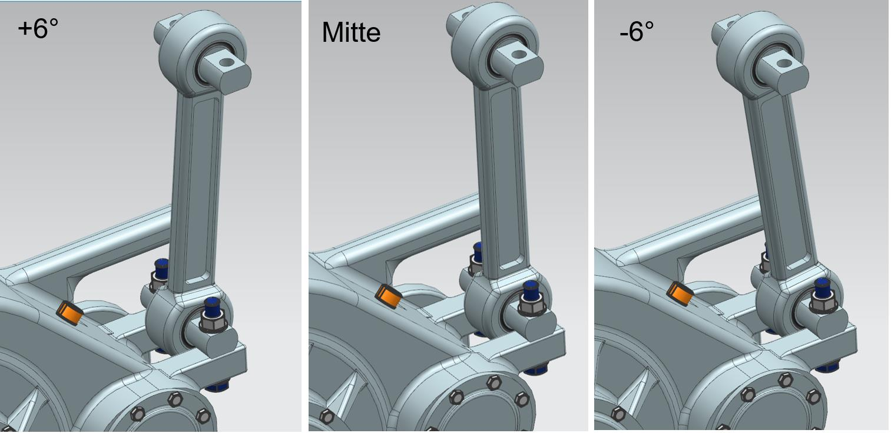
[picture p100: figure]

Abbildung 41: Kollisionskontrolle Drehmomentstütze

## 8 Montage- und Demontage

8.1 Anschlussmaße

Die Anschlussmaße des Getriebes, ausgehend von der Verzahnungsmitte, sowie die

Außenmaße des Getriebes sind in folgender Skizze dargestellt.

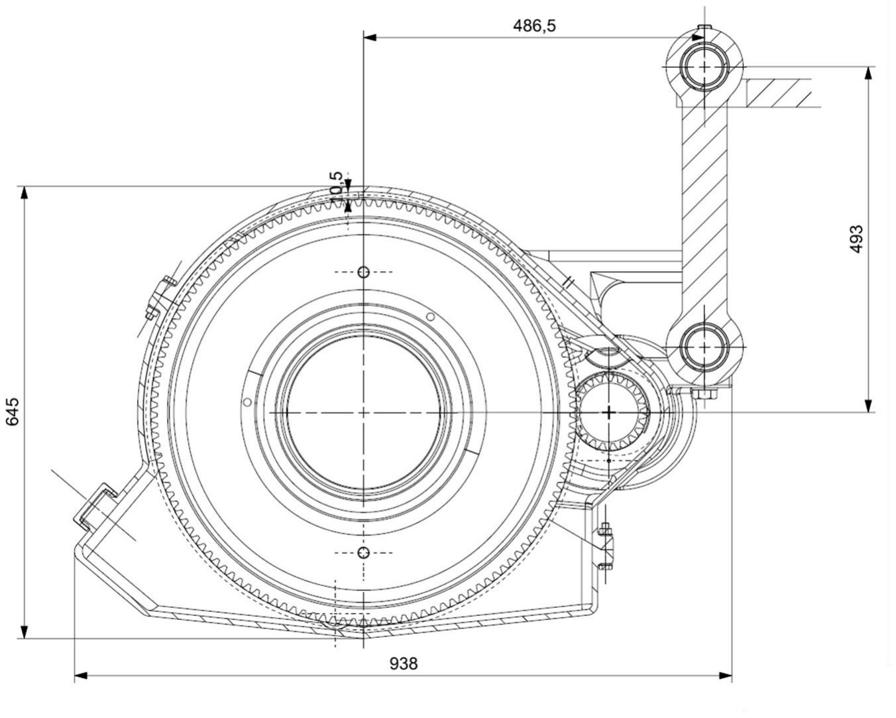
[picture p101: figure]

Abbildung 42: Anschlussmaße

### 8.1.1 Kupplung

Das Nennabtriebsdrehmoment ist der Tabelle „Relevante Momente“ (Kapitel 1.3) zu

entnehmen. Daraus erfolgt die Auswahl der Kupplung. Die Kupplung wurde vom Her-

steller Kupplungswerk Dresden gewählt, da die Kombination aus geringem Zahnflan-

kenspiel und Zentrierung in der Verzahnung einen ruhigen Lauf im gesamten Dreh-

zahl- und Drehmomentbereich ermöglicht. Da das Abtriebsdrehmoment bei 10800Nm

liegt, wurde die kleinste, der KWD Zahnkupplungen gewählt (siehe Datenblatt im An-

hang). Die gewählte Kupplung hat einen Durchmesser von 224 mm und ist 208 mm

lang. Sie kann bis zu 10 mm auf der Antriebswelle verschoben werden. Deshalb ist ein

ausreichend großer Abstand zum Gehäuse zu wählen. Auch im Kippfall von ±6° soll

es zu keinen Kollisionen kommen.

### 8.1.2 Radsatz

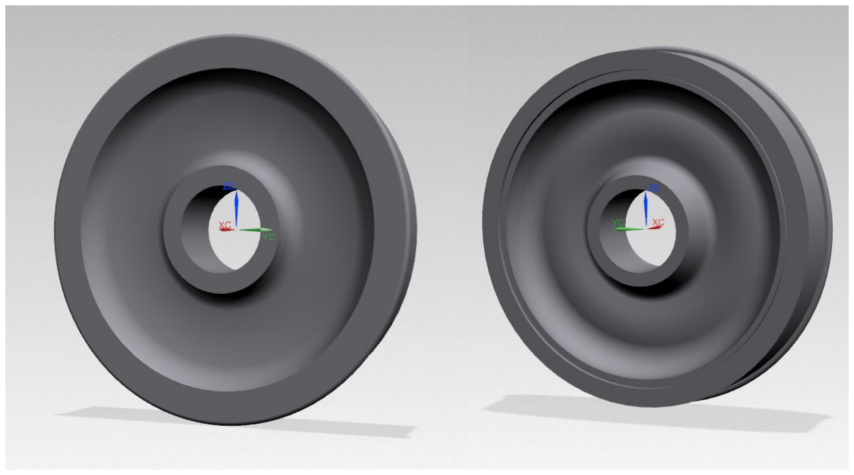
[picture p102: figure]

Abbildung 43: Zugräder

Die Räder werden auf der Abtriebswelle durch eine thermische Pressverbindung an-

gebracht. Die Abtriebswelle muss deswegen an den Durchmesser der Räder von

200mm angepasst sein.

8.2 Montageanleitung

1. Überprüfen Sie den Lieferumfang mit Hilfe der Stückliste. 2. Erhitzen Sie das Zahnrad auf 190°C/463,15K. Die Abtriebswelle soll auf 74,35°C/198,8K gekühlt werden. Bei diesen Temperaturen können Zahnrad und Welle gefügt werden. Das Zahnrad muss auf den Wellendurchmesser 217mm angebracht werden. Lassen Sie das Bauteil nun auskühlen.

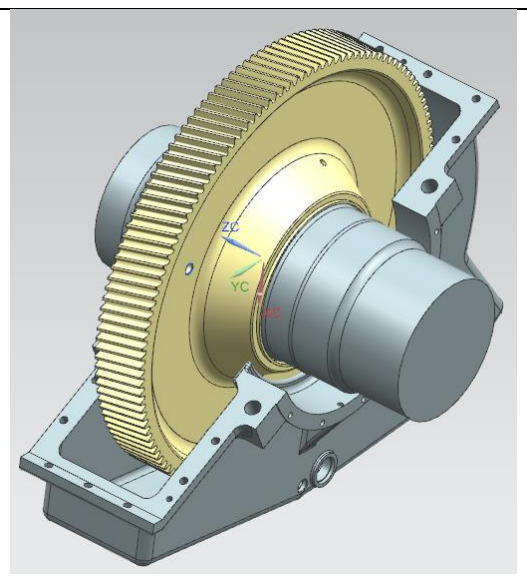
[picture p103: figure]

3. Legen Sie nun die Abtriebswelle mit aufgepresstem Zahnrad in die dafür vorgesehene Gehäuseöff-nung wie im nebenstehenden Bild zu sehen.

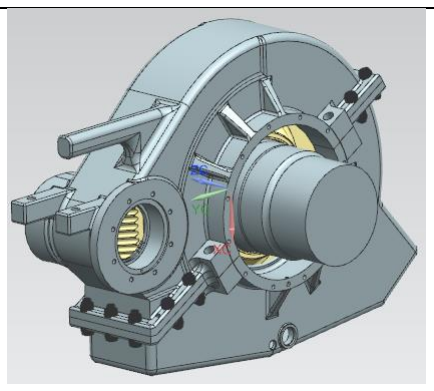
[picture p104: figure]

4. Legen Sie die obere Gehäusehälfte auf die Untere. Stecken Sie die zwei Sicherungsstifte in die Bohrungen am Gehäuseflansch. Schrauben Sie danach die zwölf M10x60 Flanschschrauben in das Gehäuse indem Sie auf jede Schraube eine Unterlegscheibe stecken und diese dann durch die Bohrungen im Gehäuse. Stecken Sie von unten wieder eine Unterlegscheibe auf die Schraube und eine M10 Mutter. Ziehen Sie diese mit einem Anziehdrehmoment von 32 Nm fest.

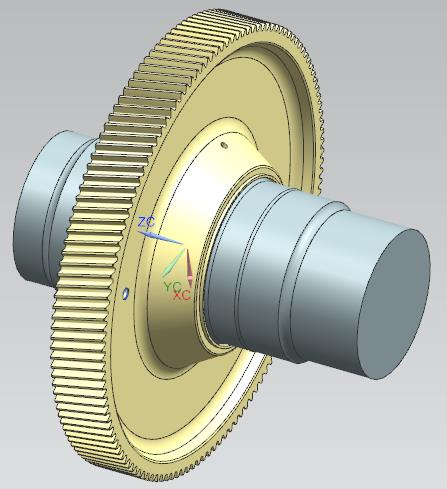
[picture p105: figure]
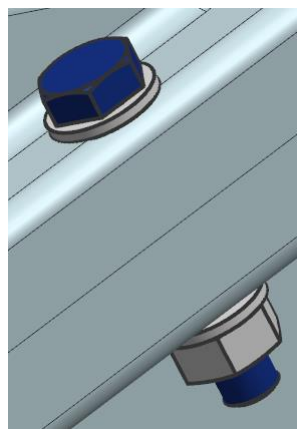
[picture p106: figure]

5. Stecken Sie jeweils die Stützringe auf die TIMKEN Lager.

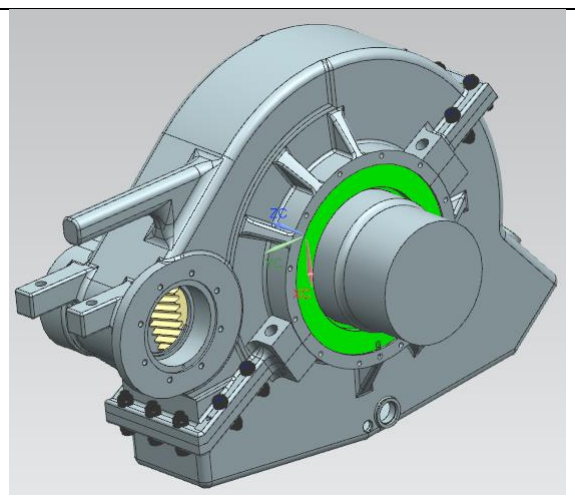
[picture p107: figure]

6. Nun können die Stützringe mit dem Lager auf die Abtriebswelle mit Hilfe einer geeigneten Vorrich-tung angebracht werden. Die Ku-gellager sollen bis zum Gehäuse-anschlag eingeschoben werden. Achten Sie bei den Stützringen darauf, dass die Ölzulaufbohrung nach oben zeigt. Stecken Sie die Stifte in die vorgesehenen Boh-rungen auf die Stützringe.

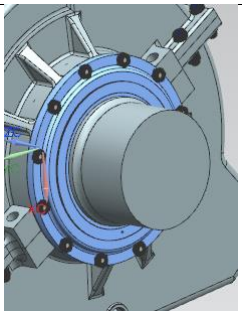
[picture p108: figure]

7. Die Dichtung wird montiert, indem man zuerst die Labyrinthdichtung (Wellenseite) auf den Durchmesser 75mm schiebt. Das Gegenstück der Labyrinthdichtung wird daraufhin mit zwölf M10x40 Schrauben montiert. Zwischen Dichtung und Gehäuse müssen die Laminumringe miteingeschraubt werden.

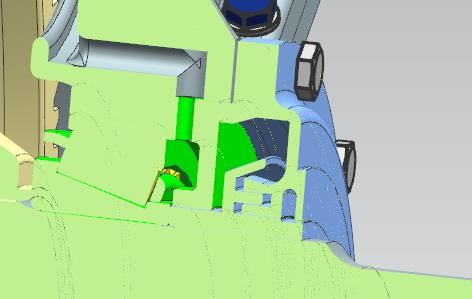
[picture p109: figure]

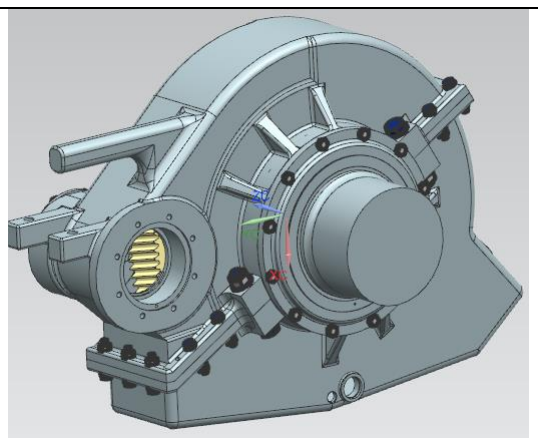
[picture p110: figure]

8. Schrauben Sie die vier M20x120 Ankerschrauben in das Gehäuse. Befestigen Sie diese mit den da-für vorgesehenen Muttern. Ver-wenden Sie oben und unten Un-terlegscheiben.

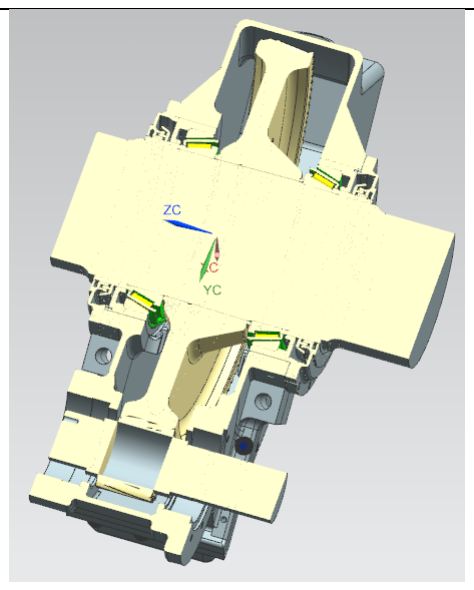
[picture p111: figure]

9. Schieben Sie die Antriebswelle in die im Gehäuse vorgesehene Öff-nung.

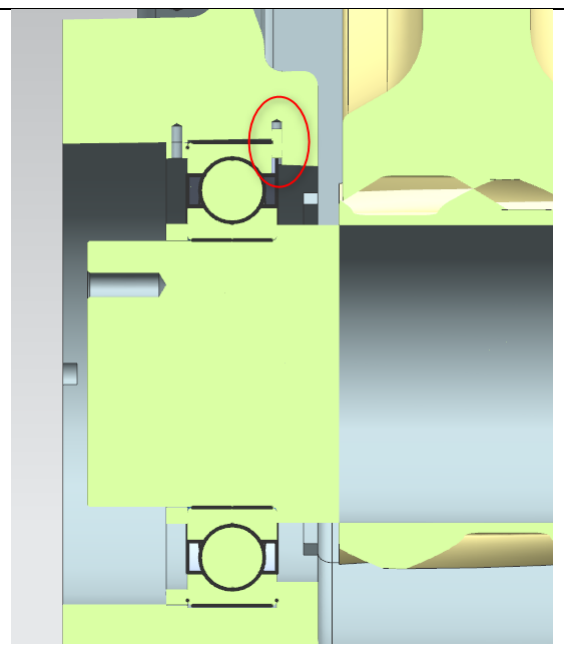
[picture p112: figure]

10.Um die Welle auszurichten pres-sen Sie das Axiallager auf das kurze Ende der Welle auf, bis es am Gehäuseabsatz anschlägt. Der vorher in die Gehäusenut ein-gelegte Sicherungsstift soll in die Nut des Außenringes des Axialla-gers passen und als Verdrehsi-cherung für denselben dienen.

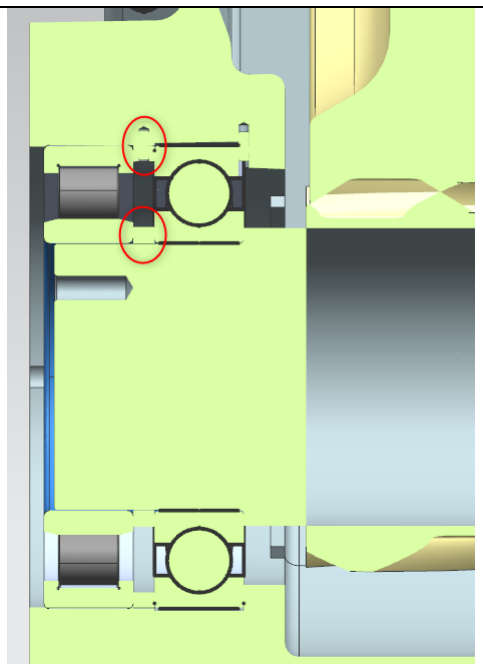
[picture p113: figure]

11.Bevor Sie das Zylinderrollenlager NU215 einbauen, müssen die bei-den Distanzringe auf die Antriebs-welle gebracht werden. Achten Sie darauf, dass die Nuten des größeren Distanzringes in Rich-tung Axiallager und nach oben zeigen, um den Ölfluss zu ge-währleisten. Die Lage dieses Dis-tanzringes wird durch einen Si-cherungsstift sichergestellt, den Sie nach der Platzierung des Dis-tanzringes in die dafür vorgese-hene Bohrung stecken. Den an-deren, kleineren Distanzring kön-nen Sie ebenso auf diese Seite der Welle bis zum Axiallager auf-schieben.

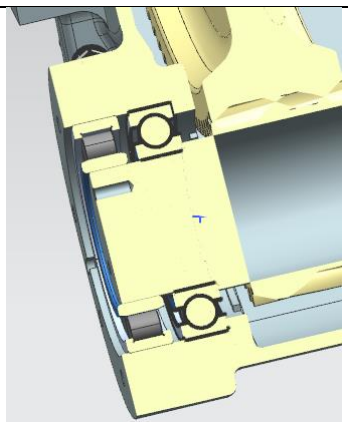
[picture p114: figure]

12.Das Zylinderrollenlager NU215 kann nun, wie im Bild zu sehen ist, eingebaut werden.

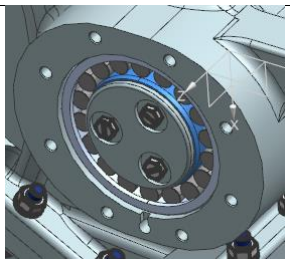
[picture p115: figure]

13.Schrauben Sie mit drei M8x20 Schrauben die Lagersicherung auf die Antriebswelle fest. Ziehen Sie die Schrauben mit einem An-ziehdrehmoment von 32 Nm fest.

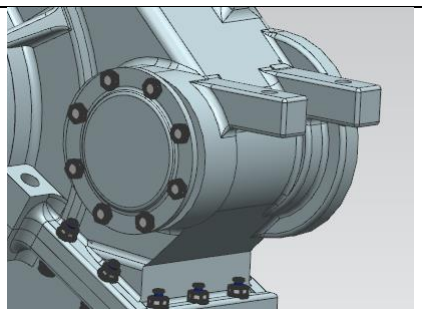
[picture p116: figure]

14.Schrauben Sie den Deckel der Antriebswelle mit acht M10x40 Schrauben mit einem Anziehdreh-moment von 32 Nm fest.

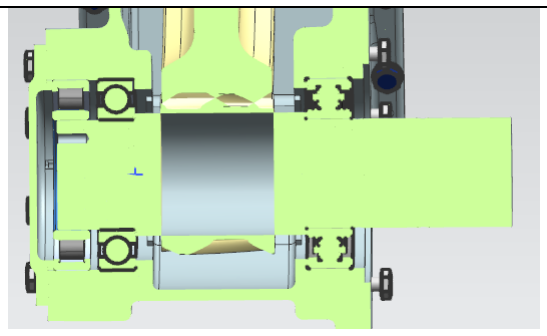
[picture p117: figure]

15.Das Lager NU2215 wird auf der anderen Seite des Ritzels aufge-presst. Genau wie das Axiallager muss es innen am Gehäuse an-schlagen.

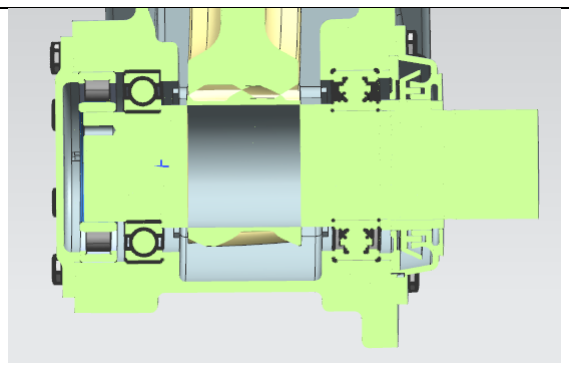
[picture p118: figure]

16.Montieren Sie auf die Antriebs-welle auf die Seite des eben ein-gebauten Lagers die Dichtung. Gehen Sie dabei vor, wie bei der Montage der Dichtung auf der Ab-triebswelle.

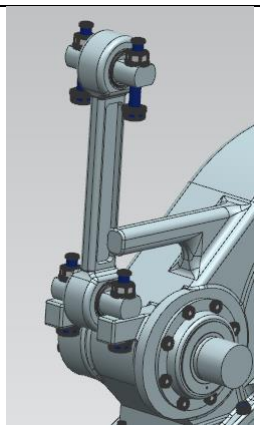
[picture p119: figure]

17.Nach dem Einbau wird die Dreh-momentstütze angeschraubt. Hierzu verwenden Sie die M20x120 Schrauben. Stecken Sie die Schrauben durch die Bolzen und die Anbindung der Drehmo-mentstütze. Befestigen Sie diese mit den dafür vorgesehenen Mut-tern. Verwenden Sie oben und unten Unterlegscheiben.

18.Das Ölschauglas wird von Hand angedrückt, eventuell mit Hilfe ei-ner Zwischenlage mit dem Ham-mer eingeschlagen.

19.Neben dem Ölschauglas wird ein Magnetstopfen eingeschraubt.

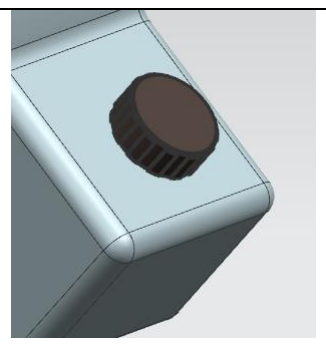
[picture p120: figure]

20.Schrauben Sie den Öleinflussde-ckel an.

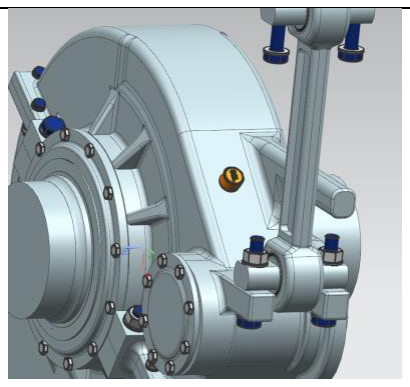
[picture p121: figure]

21.Schrauben Sie als letzten Schritt das Entlüftungsschraube auf die Oberseite des Gehäuses.

8.3 Demontageanleitung

Die Demontage erfolgt in umgekehrter Reihenfolge zur Montageanleitung. Verwenden

Sie zur Demontage der Kugellager eine geeignete Demontagevorrichtung.

## 9 Visualisierung

9.1 Gesamtansicht

Das Schienenfahrzeugachsgetriebe wurde mithilfe eines CAD- Systems wie folgt visu-

alisiert.

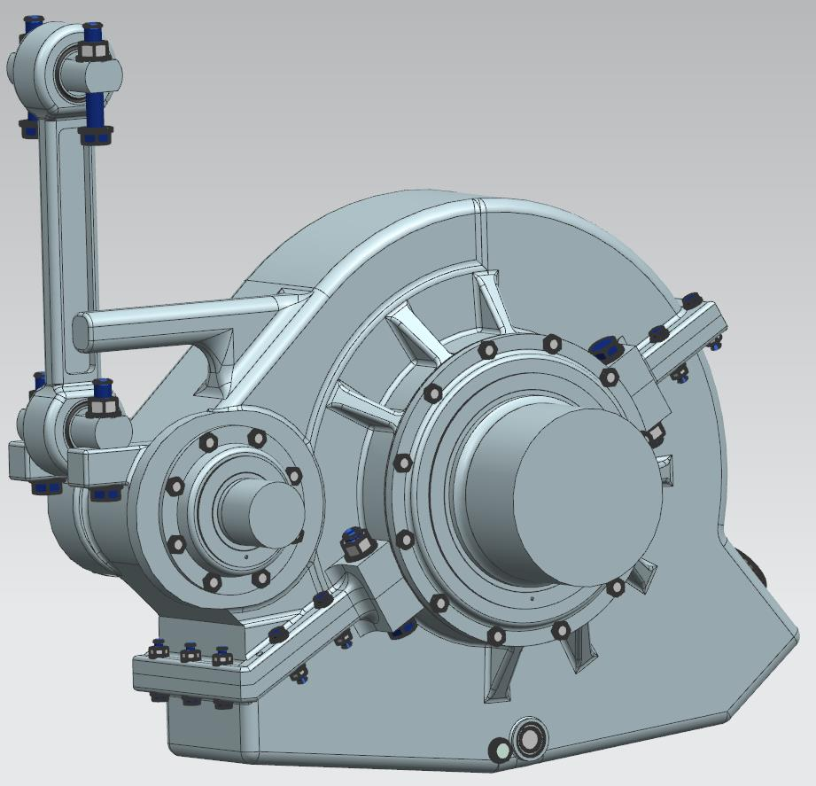
[picture p122: figure]

Abbildung 44: Getriebe von der Motorseite

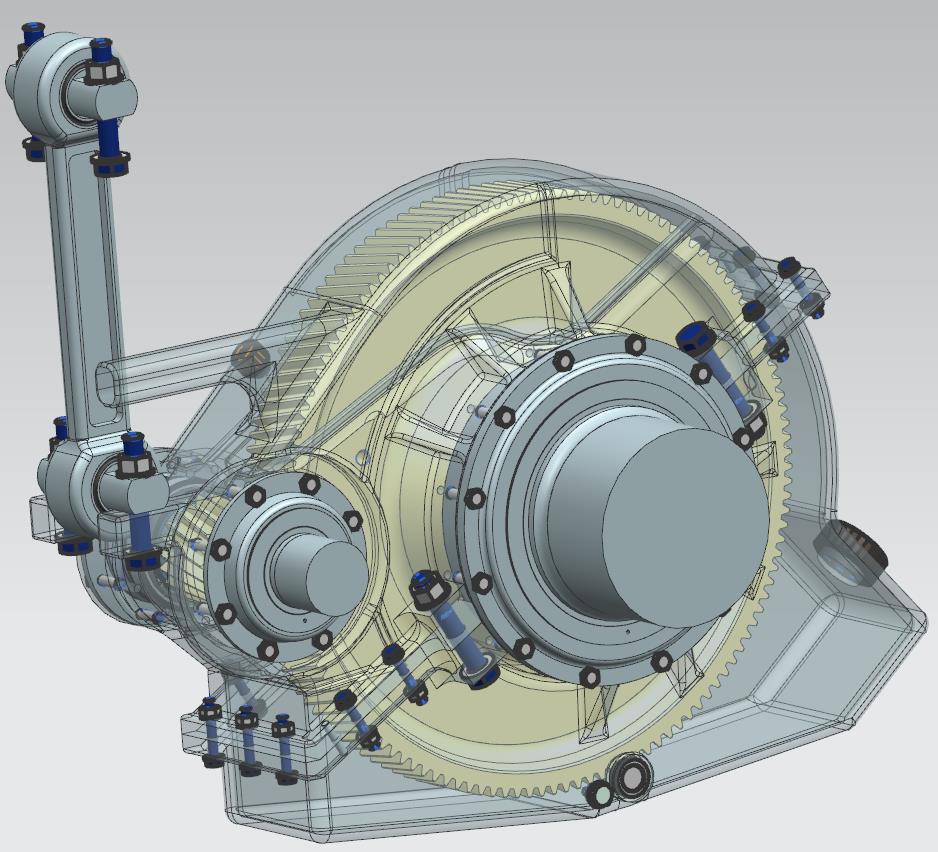
[picture p123: figure]

Abbildung 45: Getriebe mit transparentem Gehäuse

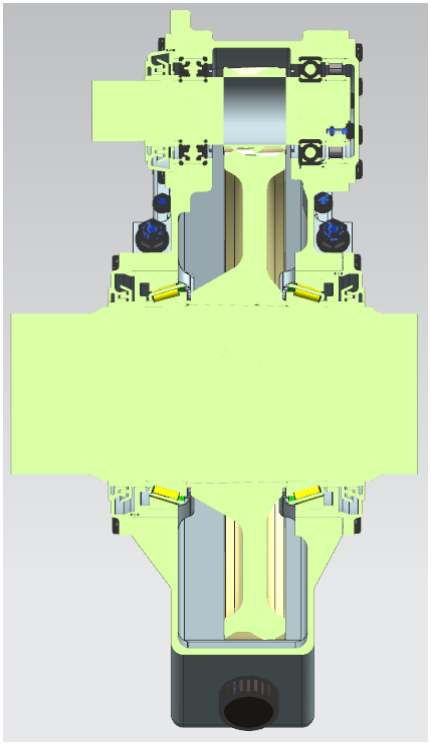
[picture p124: figure]

Abbildung 46: Schnitt durch beide Wellen

9.2 Explosionsansicht

In der Explosionsansicht sind alle Komponenten der Baugruppe zu sehen. Sie soll

den Gesamtzusammenbau verständlicher machen.

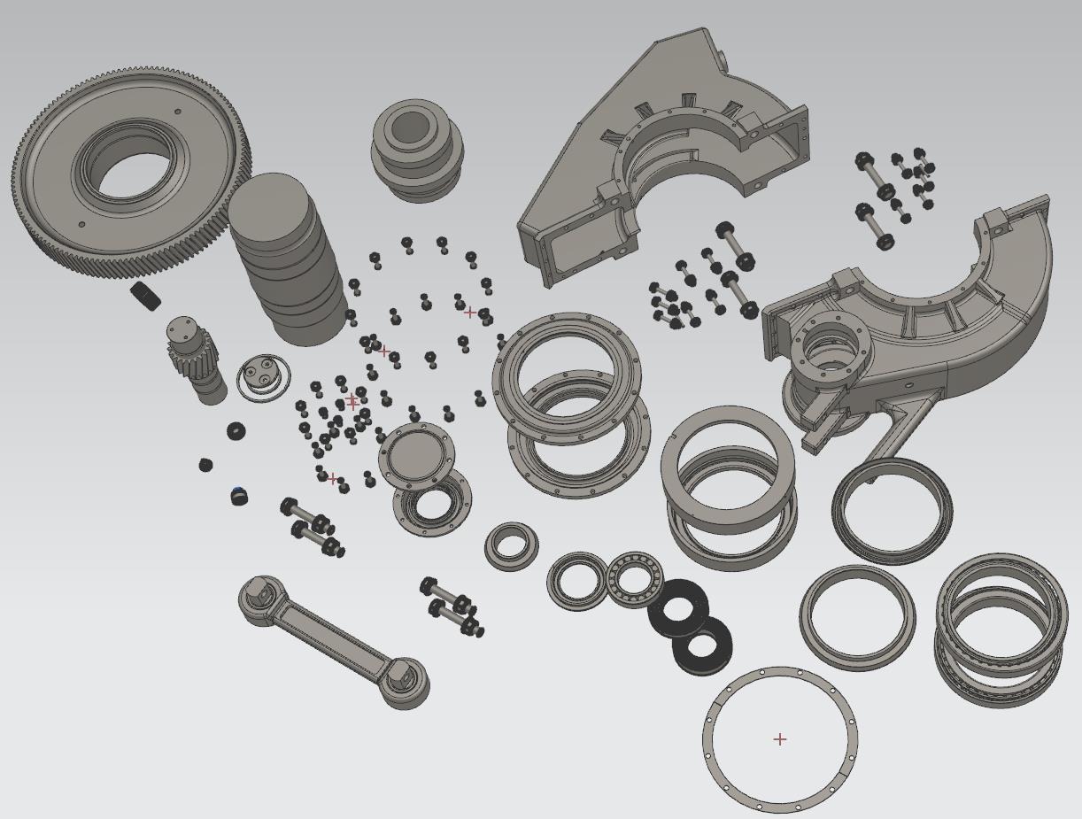
[picture p125: figure]

Abbildung 47: Explosionsansicht

## 10 Literaturverzeichnis

[1] Gomeringer, Roland u. a.: Tabellenbuch Metall, 47. Auflage, Haan-Gruiten

2017

[2] Decker, Karl-Heinz: Decker Maschinenelemente: Funktion, Gestaltung und

Berechnung, 20. Auflage, München 2018

[3] Decker, Karl-Heinz: Tabellen und Diagramme, 19. Auflage, München 2014
[4] Decker, Karl-Heinz: Formeln, 7. Auflage, München 2014
[5] Schaeffler: Wälzlager - Technische Grundlagen und Produktdaten zur Ge-

staltung von Wälzlagerungen, o.O. 2017

[6] Niemann, Gustav und Winter, Hans: Maschinenelemente Band 2: Getriebe

allgemein, Zahnradgetriebe - Grundlagen, Stirnradgetriebe, 2. Auflage, Ber-

lin Heidelberg 2003

## 11 Tabellenverzeichnis

- Tabelle 3: Vergleich der Haftkräfte für einen Querpressverband und einen

## 12 Abbildungsverzeichnis
