MattdewT/KE4/ALT_KE/TM2017/Plapp/KE4/KE 4Doku.pdf

## Konstruktionsentwurf im Fach Konstruktionslehre III

4. Studiensemester TM2017 A

## Berechnung und Konstruktion eines

## Schienenfahrzeugachsgetriebes

im Studiengang Maschinenbau

an der Dualen Hochschule Baden-Württemberg Heidenheim

von

Johannes Schwehr

Nico Plapp

Felix Häussler

22.03.2019

Bearbeitungszeit | 10 Wochen
Matrikelnummer, Kurs | 5710172, 6487252, 4157166, TM2017A
Ausbildungsfirma | Butzbach, Faist Anlagenbau, Andritz Ritz

## Inhalt

9.8 | Protokoll Welle Ritzel Drehmoment 790Nm, gegen Uhrzeigersinn,
9.9 | Protokoll | Welle | Ritzel | Drehmoment | 790Nm, | im | Uhrzeigersinn,
9.10 | Protokoll Welle Ritzel Drehmoment 3417,6Nm, gegen Uhrzeigersinn,
9.11 | Protokoll Welle Ritzel Drehmoment 3417,6Nm, im Uhrzeigersinn,
9.12 | Protokoll Welle Ritzel Drehmoment 8544Nm, gegen Uhrzeigersinn, Worst
9.13 | Protokoll Welle Ritzel Drehmoment 8544Nm, im Uhrzeigersinn, Worst

## 1 Projektbeschreibung

### 1.1 Projektziel

Im Rahmen des Konstruktionsentwurfs im vierten Semester ist das Ziel, ein

vollständiges Schienenfahrzeugachsgetriebe für einen Zug zu konstruieren. Wichtig

dabei ist die Berechnung der Zahnradverbindung und die dazugehörige Schmierung. Dabei war zu beachten die Lagerung sowie die Ölführung zu den Lagern genau

auszuführen.

## 2 Projektplanung

### 2.1 Projektzeitplan

Aktivität

Kalenderwoche

2 | 3 | 4 | 5 | 6 | 7 | 8 | 9 | 10 | 11 | 12

Projektzeitplan

Anforderungsliste

Team-Checkliste

Erste Prinzipskizzen

Zahnradberechnung

Positionierung von Ritzelwelle und Lagern

Kräfteermittlung

Lagerberechnungen

Festigkeitsberechnung Ritzelwelle Ölführungen

1. Testat

Korrekturen aus dem 1. Testat

Festigkeitsberechnung Abtriebswelle

Berechnung Pressverbindung Großrad auf Abtriebswelle

Gehäusegestaltung

Drehmomentstütze Schraubenberechnung

Konstruktion Drehmomentstützenanbindung

Fertigstellung Konstruktion

2. Testat

Korrekturen aus dem 2. Testat

Gesamtzeichung CAD

Erläuterung Konstruktion

Montage- und Demontageanleitung

Normen, Kaufteile

Zusammenstellung Dokumentation

Endkontrolle

Abgabe

### 2.2 Anforderungsliste

## Anforderungsliste Schneckenradgetriebe

Gruppe 5 Projektnr.: 01 Häussler, Schwehr, Plapp | Ausgabe: 02.10.2018 Abgabe: 03.12.2018
F/W | Nummer | Anforderung Forderung(F)/Wunsch(W) | Beschreibung | Verantw./ Quelle

### 1 Geometrie

F | 1.1 | Lagerabstand | 240 mm | NP
F | 1.2 | Lagerinnendurchmesser | 40 mm | NP

### 2 Kräfte

F | 2.1 | Tangentilakraft | 1950 N | FH
F | 2.2 | Axialkraft | 9100 N | FH
F | 2.3 | Radialkraft | 3400 N | FH

### 3 Lagerung Variante 1

F | 3.1 | Lebensdauer | 10000h | JS
F | 3.2 | Lagerauswahl | zwei Radiallager+ Axiallager | JS

### 4 Lagerung Variante 2

F | 4.1 | Lebensdauer | 10000h | JS
F | 4.2 | Lagerauswahl | In X-Anordnung | JS

### 5 Energie

F | 5.1 | Antreibsart | über Passfederverbindung | NP
F | 5.2 | Übersetzungsverhältnis | 40:1 | JS/FH
F | 5.3 | Antriebsleistung | 10 kW | JS/FH
F | 5.4 | Antriebsdrehzahl | 1400 1/min | JS/FH

### 6 Kosten

W | 6.1 | Herstellungskosten | so gering wie möglich | NP
W | 6.2 | Zukaufkosten | so gering wie möglich | NP

### 7 Fertigung/Montage

F | 7.1 | Schraubenverbindung | Notwendige Bohrungen | FH
| | | zur Montage vorhanden
W | 7.2 | Allgemein | Einfach zu montieren, | JS
| | | Normteile soweit vorh.

F/W | Nummer | Anforderung Forderung(F)/Wunsch(W) | Beschreibung | Verantw./ Quelle
F W F F F | 8 Gebrauch 8.1 9 Instandhaltung 9.1 10 Termin 10.1 10.2 10.3 | Befestigung Wartung 1. Testat 2. Testat Abgabe | Mit Bodenankern Wartungsarm 16.10.2018 21.11.2018 03.12.2018 | NP NP JS/FH/NP JS/FH/NP JS/FH/NP

Eine detaillierter Anforderungsliste zu den technischen Details ist im Anhang zu

finden.

### 2.3 Team-Checkliste

Aufgabe | Verantwortlicher | Zeitpunkt eingehalten | Geprüft
Projektzeitplan | FH
Anforderungsliste | FH
Team-Checkliste | FH
Erste Prinzipskizzen | NP
Zahnradberechnung | JS, NP, FH
Positionierung von Ritzelwelle und Lagern | NP
Kräfteermittlung | JS
Lagerberechnungen | JS
Festigkeitsberechnung Ritzelwelle | FH
Ölführungen | NP
1. Testat | JS, NP, FH
Korrekturen aus dem 1. Testat | JS, NP, FH
Festigkeitsberechnung Abtriebswelle | FH
Berechnung Pressverbindung Großrad auf Abtriebswelle | JS
Gehäusegestaltung | NP
Drehmomentstütze Schraubenberechnung | FH
Konstruktion Drehmomentstützenanbindung | NP
Fertigstellung Konstruktion | NP

2. Testat | JS, NP, FH
Korrekturen aus dem 2. Testat | JS, NP, FH
Gesamtzeichung CAD | NP
Erläuterung Konstruktion | NP
Montage- und Demontageanleitung | NP
Normen, Kaufteile | JS
Zusammenstellung Dokumentation | JS, FH
Endkontrolle | JS, NP, FH
Abgabe | JS, NP, FH

## 3 Berechnungen

### 3.1 Berechnung der auf die Welle wirkenden Kräfte

Hierbei wird von einem Rechenmoment von 790 Nm ausgegangen (s.

Aufgabenstellung). Der Nachweis für den dann geforderten Lagerdurchmesser von

dLager ≤ 75 mm ist im Kapitel 3.2 Berechnung der Lagerkräfte ausgeführt.

Gegebene Daten:

T = 790 Nm, Wälzkreisradius dw = 94,788mm, Betriebs-Eingriffswinkel αwt = 20,516°,

Schrägungswinkel am Wälzkreis βw

(laut MA Decker 20.Auflage βw

≈ β) = 14°

Die auf die Welle wirkende Tangentialkraft Ft

, Radialkraft Fr und Axialkraft Fa kann

wie folgend berechnet werden:

Ft =

T
dw·0,5

=> Ft = 16668,78 N

Fr = Ft

- tan( αwt )

=> Fr = 6237,51 N

Fa = Ft

- tan ( βw

)

=> Fa=4155,99 N

### 3.2 Berechnung der Lagerkräfte

Zunächst wird zur Berechnung der Lagerkräfte die Baugruppe in zwei Ebenen

unterteilt.

Die Y-Ebene stellt den Schnitt in der Vorderansicht dar, wohingegen die X-Ebene die

Aufsicht darstellt. Nach dem Einzeichnen der Lagerkräfte können, mittels Aufstellen

der Gleichgewichtsbedingungen, die einzelnen Lagerkräfte ermittelt werden.

### 3.2.1 Berechnung der Lagerkräfte in Y – Ebene:

Für die Beispielrechnung wird die Welle im Rechtslauf betrachtet. Nachfolgende

Abbildung bildet die auftretenden Kräfte auf die beiden Radiallager ab.

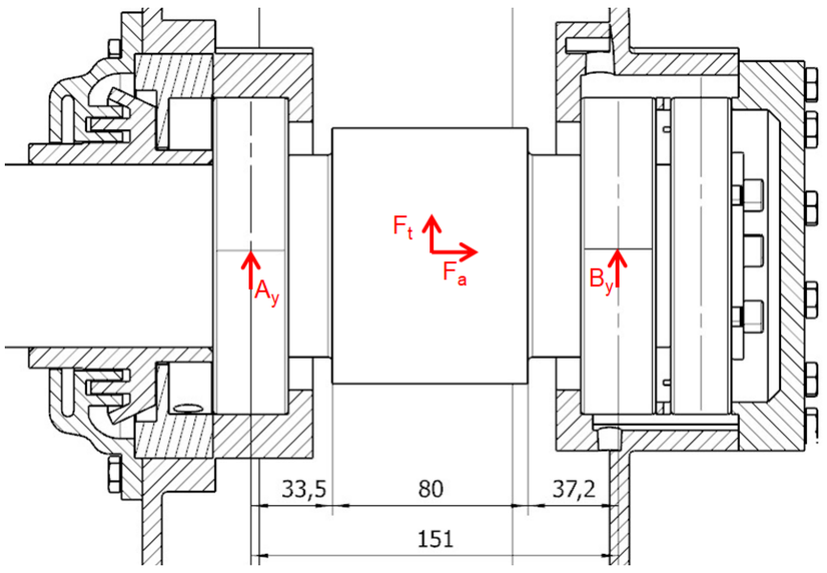
[picture p126: figure]

Mit ∑ M = 0 um Lager A ergibt sich:

Ft

- l1+ By
- lL = 0

=> By= -8113,6 N

Mit ∑ ↑ = 0 ergibt sich:

Ay+ Ft+By = 0

=> Ay= -8555,2 N

Das Vierpunklager C (rechts außen) nimmt bei dieser Anordnung die gesamte

Axialkraft Fa auf.

Abb.: 1 Lagerkräfte in der Y-Ebene im Rechtslauf

### 3.2.2 Berechnung der Lagerkräfte in X – Ebene:

Für die Beispielrechnung wird die Welle im Rechtslauf betrachtet. Nachfolgende

Abbildung bildet die auftretenden Kräfte auf die beiden Radiallager ab.

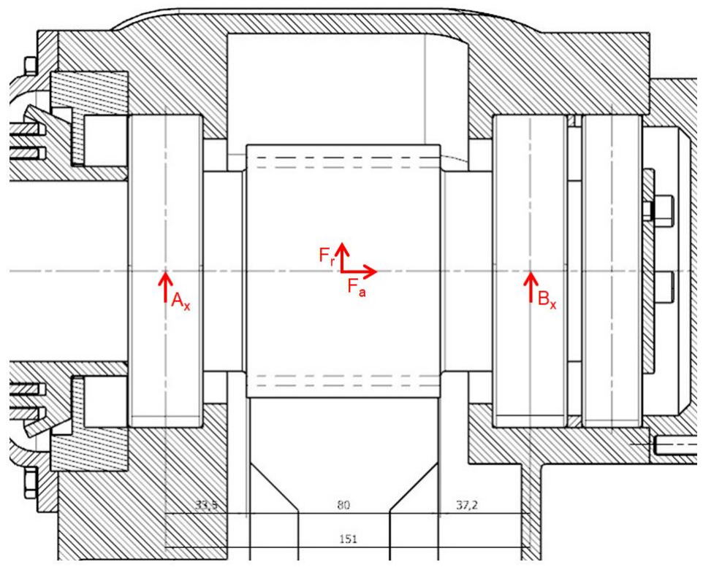
[picture p127: figure]

Mit ∑ M = 0 um Lager A ergibt sich:

Fr

- l1+ Bx
- LL+ Fa
- dw1 ·

1
2

= 0

=> Bx= -4340,6 N
Mit ∑ ↑ = 0 ergibt sich:

Ax + Fr + Bx = 0

=> Ax= -1896,9 N

Abb.: 2 Lagerkräfte in der X-Ebene im Rechtslauf

### 3.3 Berechnung der radial wirkenden Kräfte:

Da die errechneten Lagerkräfte senkrecht aufeinander stehen, können diese

quadratisch addiert werden um so die radial wirkenden Kräfte FrA und FrB zu

berechnen.

FrA = √Ax
2
+ Ay

2

FrA = 8762,9 N

FrB = √Bx
2
+ By

2

FrB = 9201,7 N

Für den Linkslauf erfolgt die Kraftberechnung analog. Hierbei ist zu beachten, dass

sich die Axial- und Tangentialkraft umkehren nicht jedoch die Radialkraft (s. Abb.: 3

und Abb.: 4Abb.: 3 Lagerkräfte in der Y-Ebene im Linkslauf)

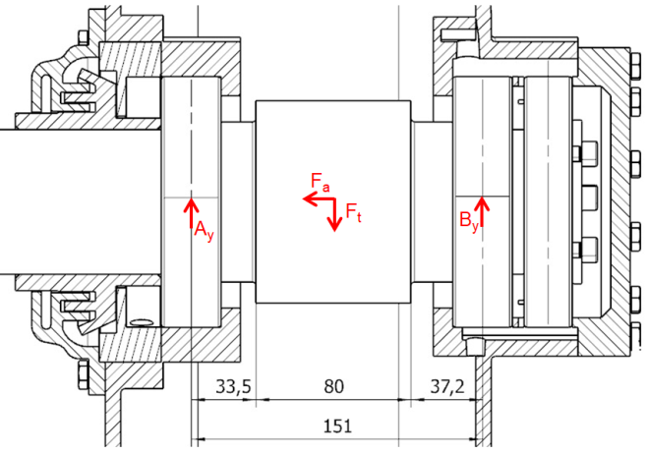
[picture p128: figure]
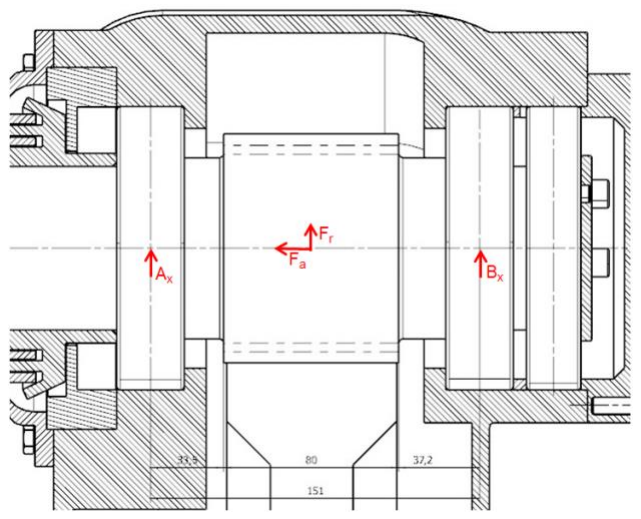
[picture p129: figure]

Die Ergebnisse dieser Berechnung können der Excel-Tabelle (Lagerkraftberechnung Metrogetriebe) im Anhang entnommen werden.

Abb.: 4 Lagerkräfte in der X-Ebene im Linkslauf

Abb.: 3 Lagerkräfte in der Y-Ebene im Linkslauf

### 3.4 Lagerauslegung

### 3.4.1 Berechnung der erforderlichen Lagerlebensdauer L10ges

Vorgegebene Werte aus der Aufgabenstellung:

Raddurchmesser: dneu = 860 mm; dalt = 770 =>

mittlerer Raddurchmesser dRad = 815 mm Fahrzeughöchstgeschwindigkeit vmax = 100 km
h

; Zähnezahlverhältnis u = 6,174

Geforderte Lebensdauerstrecke s = 3200000 km; Lastkollektiv = 50% – 50%

Berechnung der maximalen Drehzahl bei vmax:

nmax =

vmax
dRad · π ·60 · u

=> nmax = 4018,91

1
min
Aus der errechneten Umdrehungszahl des Großrades wird L10ges erforderlich

bestimmt

L10ges =

s
π · dRad
- u

=> L10ges = 7,72 · 10⁹ Umdrehungen

Mit der halben Maximaldrehzahl als geschätzte Betriebsdrehzahl errechnet sich nun

eine erforderliche Lagerlebensdauer L10h in Stunden.

L10h =

L10ges
nmax · 0,5 · 60
L10h= 6,4 · 10⁴
h

### 3.4.2 Berechnung der Lagerlebensdauer der Radiallager

Da die Radiallagerlebensdauer im Lastkollektiv zu errechnen ist, wird anders als bei

der Axiallager Berechnung kein Cdyn min ermittelt, sondern die Lagerlebensdauer für

jedes Lager einzeln errechnet und anschließend mit L10ges verglichen.

Beispielhaft wird diese für das gewählt Lager NU2215E-XL-TVP2 im Rechtslauf

bestimmt.

Gegebene Werte:
Cdyn = 192000N; d = 75mm; D = 160mm; p = 10
3

; nach Schäffler S.419 gilt: PA= FrA &

PB= FrB

Nach MA Decker, 20. Auflage ergibt sich:

L10i rechts= (
Cdyn

Pi rechts)

p
- 10⁶

=> L10A rechts = 29433146793 Umdrehungen

=> L10B rechts= 25009859372 Umdrehungen

L10A links und L10B links können analog errechnet werden mit dem Ergebnis, dass

L10A links und L10B links ihre | Werte | vertauschen | (s. | Excel-Tabelle
Lagerkraftberechnung) | Dies kann auf die symmetrische Anordnung der Lager

zurückgeführt werden.

Sind nun die Einzelwerte im Rechts- und Linkslauf bekannt, so kann mit der Formel

L10i ges =

100000
50
L10i recℎts
1000

+

50
L10i links
1000
das Lastkollektiv bestimmt werden. => L10A ges = 2,46 · 10¹⁰ > 7,72 · 10⁹
= L10 ges

=> L10B ges = 2,93 · 10¹⁰ > 7,72 · 10⁹
= L10 ges
Somit | gelten | die | gewählten | Radiallager | hinsichtlich | der | vorgegebenen

Lagerlebensdauer als ausreichend.

### 3.4.3 Berechnung der Lagerlebensdauer des Axiallagers:

Zunächst wird die dynamisch äquivalente Belastung der Lager ermittelt.

Laut Aufgabenstellung: P = 1,07 · Fa

P = 4446,9 N

Mit p = 3 (für Kugellager) und einer geforderten Lagerlebensdauer kann nach MA

Decker, 20. Auflage ein Cdyn minerrechnet werden.

Cmin = √
L10ges
10⁶

p
- P

=> Cmin = 87888,1 N

Folglich kann das Vierpunktlager QJ 215-XL-TVP mit einem Cdyn von 129 kN

verwendet werden.

Die Gegenrechnung nach MA Decker ergibt:

L10= (
C
P

)

p
- 10⁶

L10= 2,4 · 10¹⁰

> L10ges= 7,72 · 10⁹

### 3.5 Wellenberechnung Ritzelwelle

Die Abmessungen der Außenkontur und die Lagerabstände sind aus der folgenden

Skizze zu entnehmen, die entsprechenden Durchmesser, Rautiefen und Freistiche

sind in den Berechnungsprotokollen „Protokoll Welle Ritzel Drehmoment 3417,6Nm,

im Uhrzeigersinn, Festigkeitsnachweis“ bzw. „Protokoll Welle Ritzel Drehmoment

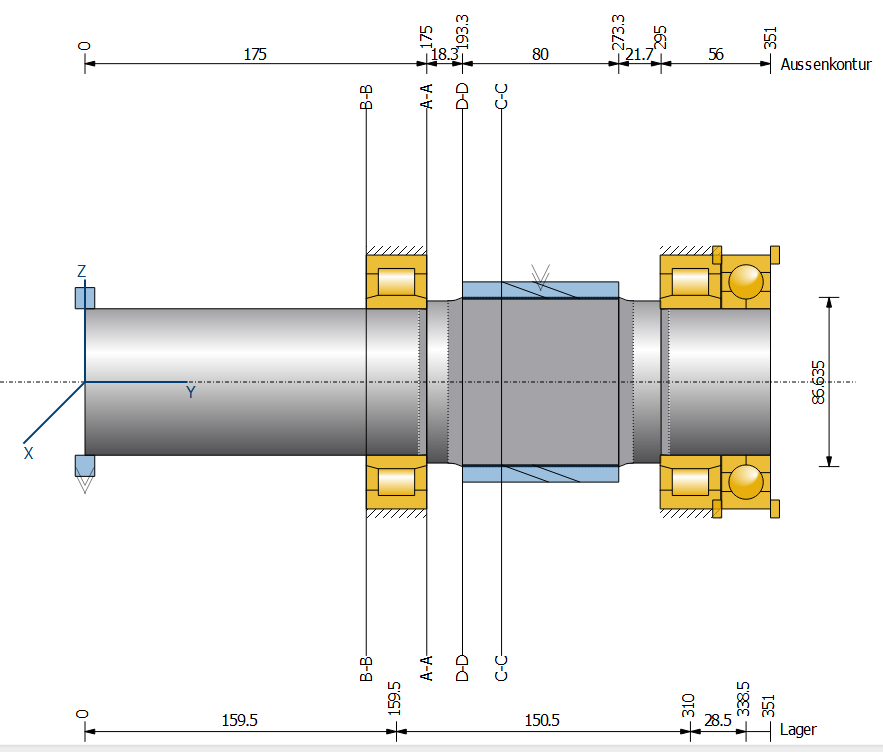
[picture p130: figure]

3417,6Nm, gegen Uhrzeigersinn, Festigkeitsnachweis“ zu finden.

Die Welle wird durch ein Drehmoment MA Ritzel, KA (Auslegungsmoment einschließlich

KA) belastet , dass über die Kupplung eingeleitet und über das Ritzel wieder

abgeleitet wird. Es berechnet sich aus dem Auslegungsmoment einschließlich KA auf

der Abtriebswelle und dem Zähnezahlverhältnis u.

MA Ritzel,KA =

MA Großrad,KA
u

=

21100 Nm
6,174 = 3417,6 Nm

### 3.5.1 Festigkeitsberechnung der Ritzelwelle

Die Berechnungen zur Festigkeit der Ritzelwelle werden mit Hilfe von „Kisssoft“ nach

DIN 743:2012 durchgeführt. Die Fehlermeldungen die bei der Berechnung auftreten

beziehen sich allesamt auf die Lagerberechnung. Da die Lager jedoch gesondert

berechnet werden, können die Fehlermeldungen unbeachtet bleiben. Sie haben

keine Auswirkungen auf die Festigkeitsberechnung.

Für die Berechnung werden Zug/ Druck und die Torsion als schwellend, die Biegung

und Scherung als wechselnd angenommen. Die Sollsicherheiten werden mit 1,5 für

den statischen und 2,0 für den dynamischen Belastungsfall festgelegt. Die Welle wird

aus 18CrNiMo7-6 gefertigt.

Somit ergeben sich für die kritischen Querschnitte A-A bis D-D folgende Ergebnisse:

- Drehrichtung im Uhrzeigersinn

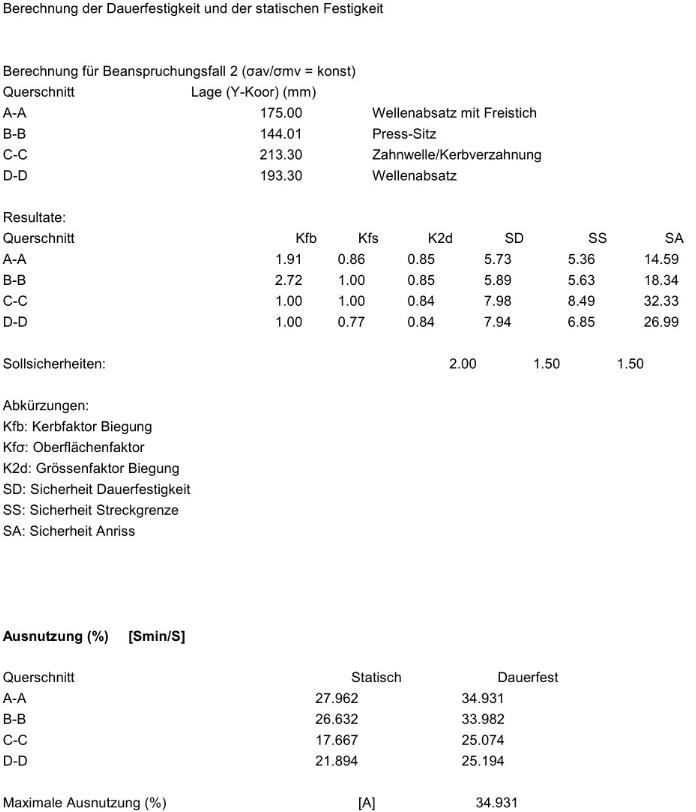
[picture p131: figure]

- Drehrichtung gegen den Uhrzeigersinn

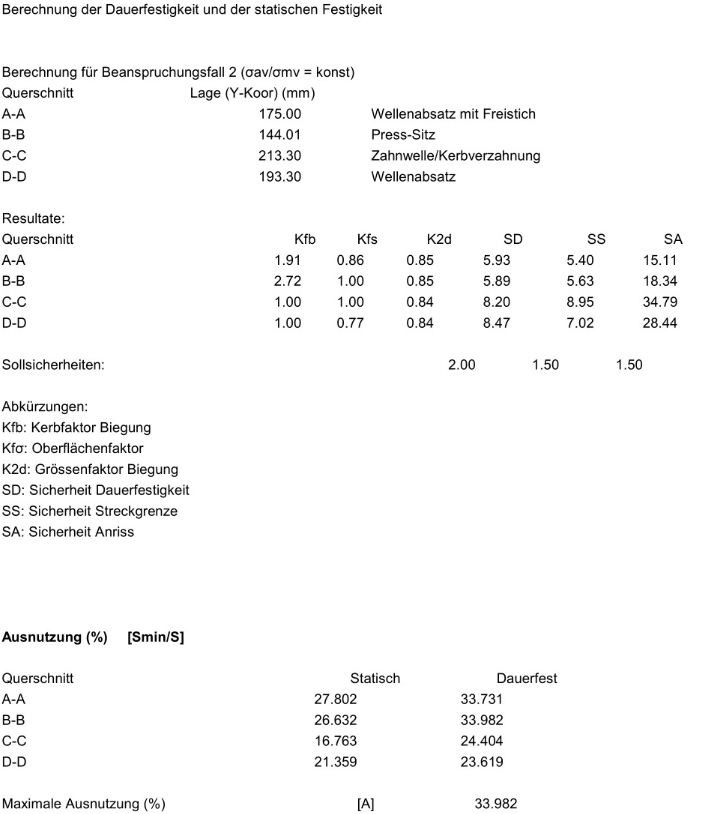
[picture p132: figure]

Die geforderten Sicherheiten werden in beiden Drehrichtungen eingehalten.

Detaillierte Ergebnisse zur Berechnung sind in den Berechnungsprotokollen

„Protokoll | Welle | Ritzel | Drehmoment | 3417,6Nm, | im | Uhrzeigersinn,

Festigkeitsnachweis“ und „Protokoll Welle Ritzel Drehmoment 3417,6Nm, gegen

Uhrzeigersinn, Festigkeitsnachweis“ zu finden.

Kurzschlussfall

Da die Welle auch im Kurzschlussfall des Motors den erhöhten Belastungen

standhalten muss, wird eine zusätzliche, statische Berechnung der Welle für das

Kurzschlussmoment durchgeführt.

Das Kurzschlussmoment auf der Ritzelwelle ergibt sich aus:

MKs,Ritzel =

MKs,Großrad
u

=

2,5 ∙ MA Großrad,KA
u

=

2,5 ∙ 21100 Nm
6,174 = 8544 Nm

Somit ergeben sich für die kritischen Querschnitte A-A bis D-D folgende Ergebnisse:

- Drehrichtung im Uhrzeigersinn

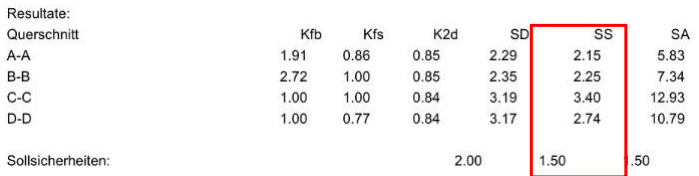
[picture p133: figure]

- Drehrichtung gegen den Uhrzeigersinn

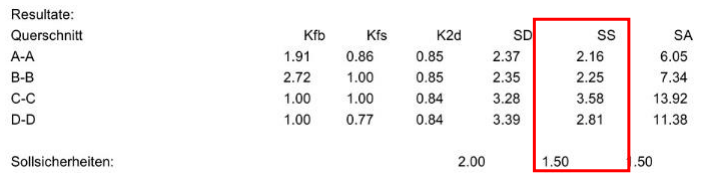
[picture p134: figure]

Die Ergebnisse für die Dauerfestigkeit sind bei dieser statischen Betrachtung zu

vernachlässigen. Die statischen Ergebnisse sind rot hervorgehoben. Die geforderten

Sicherheiten werden eingehalten. Detaillierte Ergebnisse zur Berechnung sind in den

Berechnungsprotokollen | „Protokoll Welle | Ritzel | Drehmoment | 8544Nm, | im

Uhrzeigersinn, Worst Case Festigkeitsnachweis statisch“ und „Protokoll Welle Ritzel

Drehmoment 8544Nm, gegen Uhrzeigersinn, Worst Case Festigkeitsnachweis

statisch“ zu finden.

Bereich der 4xM8 Bohrungen

Die Gewindebohrungen am rechten Ende der Ritzelwelle (4xM8), über die der

Lagerdeckel aufgeschraubt wird, werden in der Berechnung mit Kisssoft nicht weiter

betrachtet. | Da | das | Biegemoment | in | diesem | Bereich | Null | ist | (siehe

Biegemomentenverlauf) und nur eine Axialkraft auftritt (siehe Kräfteverlauf) wird

dieser Bereich nochmals separat mit den Gewindebohrungen berechnet.

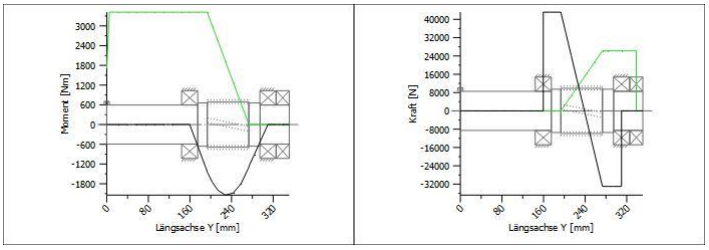
[picture p135: figure]

Quherschnittsfläche des Wellenbereichs:

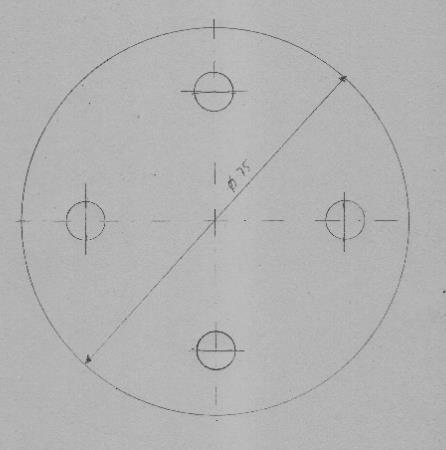
[picture p136: figure]

Die Querschnittsfläche ergibt sich aus der Querschnittsfläche der Welle abzüglich

der Spannungsquerschnitte der 4 Gewinde:

A = AWelle − 4 ∙ S =

π
4
- (75mm)

2 − 4 ∙ 36,6 mm² = 4271,46 mm²

Die Axialkraft ergibt sich zu 26,246 kN (siehe Berechnungsprotokolle „Protokoll Welle

Ritzel Drehmoment 3417,6Nm, im Uhrzeigersinn, Festigkeitsnachweis“ bzw.

„Protokoll | Welle | Ritzel | Drehmoment | 3417,6Nm, | gegen | Uhrzeigersinn,

Festigkeitsnachweis“).

Somit ergibt sich:
| | | FA A ≤

Re
s

Abb.: 7 Skizze
Querschnittsfläche

Abb.: 6 Momenten (links)- und Kräfteverlauf (rechts) der Ritzelwelle

26,246 kN
4271,46 mm² ≤

850 N
mm²
s
s ≥ 138,34

Die Sicherheit ist in diesem Bereich mehr als ausreichend. Aufgrund dieser großen

Sicherheit wird keine weitere Betrachtung für den Kurzschlussfall vorgenommen.

### 3.5.2 Eigenfrequenzen/ kritische Drehzahlen

Die Eigenfrequenzen und kritischen Drehzahlen werden mit Hilfe von „Kisssoft“

berechnet. Es ergeben sich folgende Ergebnisse:

Die Eigenfrequenzen und kritischen Drehzahlen liegen weit unter bzw. über der maximalen Betriebsdrehzahl von 4018,9 min⁻¹
und stellen somit kein Problem dar.

Detaillierte Ergebnisse zur Berechnung sind in den Berechnungsprotokollen

„Protokoll | Welle | Ritzel | Drehmoment | 3417,6Nm, | im | Uhrzeigersinn,

Festigkeitsnachweis“ bzw. „Protokoll Welle Ritzel Drehmoment 3417,6Nm, gegen

Uhrzeigersinn, Festigkeitsnachweis“ zu finden.

### 3.5.3 Durchbiegung der Welle und Verdrehwinkel

Die Durchbiegung der Welle wird mit Hilfe von „Kisssoft“ berechnet. Es ergeben sich

folgende Ergebnisse:

- Drehrichtung im Uhrzeigersinn

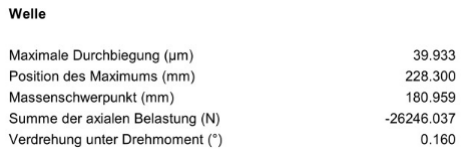
[picture p137: figure]

- Drehrichtung gegen den Uhrzeigersinn

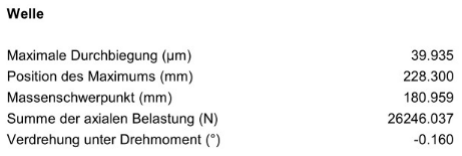
[picture p138: figure]

Die Durchbiegung und der Verdrehwinkel sind in einem zulässigen Bereich.

Detaillierte Ergebnisse zur Berechnung sind in den Berechnungsprotokollen

„Protokoll | Welle | Ritzel | Drehmoment | 3417,6Nm, | im | Uhrzeigersinn,

Festigkeitsnachweis“ und „Protokoll Welle Ritzel Drehmoment 3417,6Nm, gegen

Uhrzeigersinn, Festigkeitsnachweis“ zu finden.

### 3.6 Wellenberechnung Abtriebswelle

Die Abmessungen der Außenkontur und die Lagerabstände sind aus der folgenden

Skizze zu entnehmen, die entsprechenden Durchmesser, Rautiefen und Freistiche

sind im Berechnungsprotokoll „Protokoll Welle Großrad Drehmoment 21100Nm,

Festigkeitsnachweis“ zu finden. Die Fehlermeldungen im Protokoll sind auf die Lager

zurückzuführen. Da diese jedoch durch die Aufgabenstellung vorgegeben sind und

keine weiteren Berechnungen zu diesen Lagern nötig sind, werden diese nicht weiter

berücksichtigt. Es werden lediglich die Festigkeitswerte der Welle betrachtet.

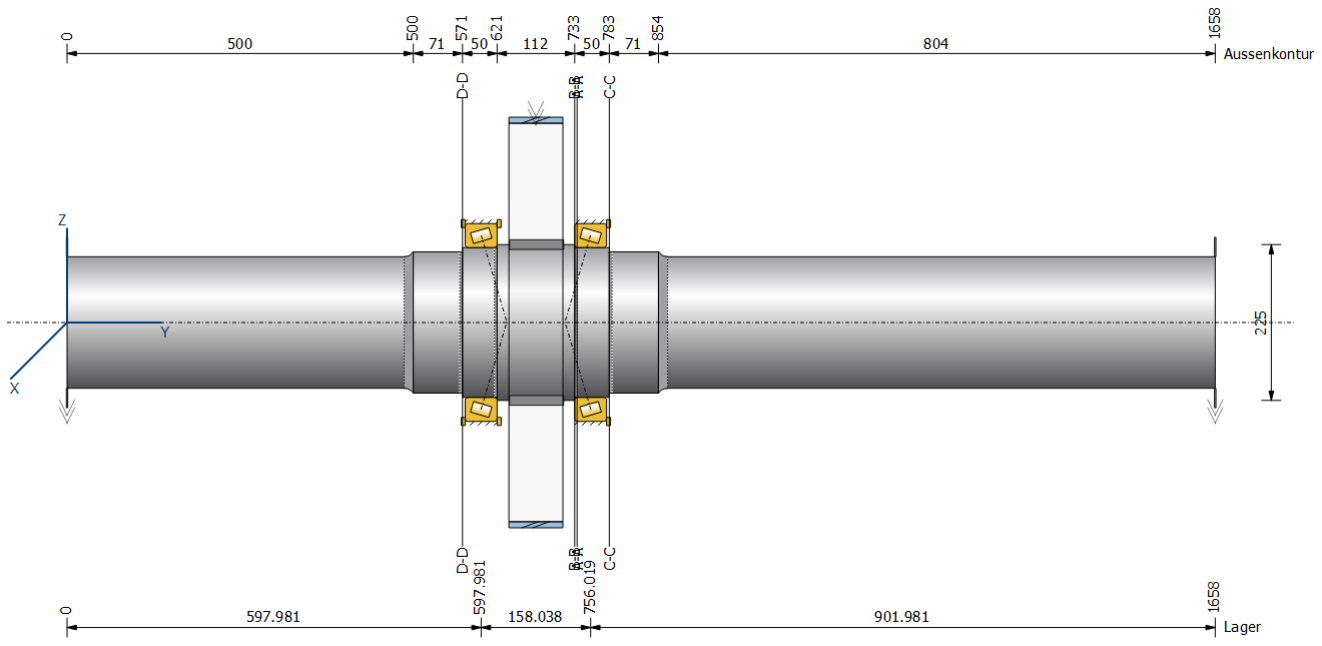
[picture p139: figure]

Die Welle wird durch ein Drehmoment MA Großrad, KA = 21100 Nm (Auslegungsmoment

einschließlich KA) belastet, dass über das Zahnrad eingeleitet und über die

Abtriebsräder (hier angedeutet mit zwei Kupplungen) wieder abgeleitet wird.

### 3.6.1 Festigkeitsberechnung der Abtriebswelle

Die Berechnungen zur Festigkeit der Abtriebswelle werden mit Hilfe von „Kisssoft“

nach DIN 743:2012 durchgeführt.

Für die Berechnung werden Zug/ Druck und die Torsion als schwellend, die Biegung

und Scherung als wechselnd angenommen. Die Sollsicherheiten werden mit 1,5 für den statischen und 2,0 für den dynamischen Belastungsfall festgelegt. Die Welle wird

aus 18CrNiMo7-6 gefertigt.

Somit ergeben sich für die kritischen Querschnitte A-A bis D-D folgende Ergebnisse:

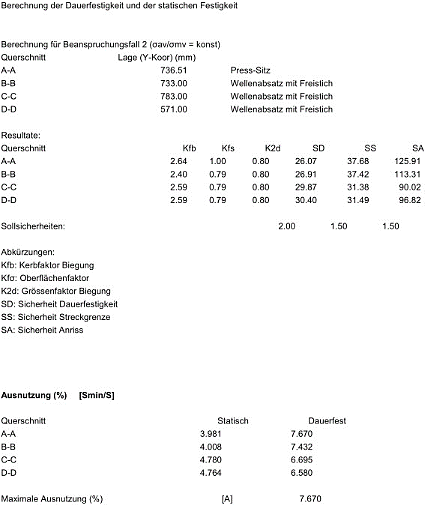
[picture p140: figure]

Die geforderten Sicherheiten werden eingehalten. Detaillierte Ergebnisse zur

Berechnung sind im Berechnungsprotokoll „Protokoll Welle Großrad Drehmoment

21100Nm, Festigkeitsnachweis“ zu finden.

Kurzschlussfall

Da die Welle auch im Kurzschlussfall des Motors den erhöhten Belastungen

standhalten muss, wird eine zusätzliche, statische Berechnung der Welle für das

Kurzschlussmoment durchgeführt.

Das Kurzschlussmoment auf der Abtriebswelle ergibt sich aus:

MKs,Großrad = 2,5 ∙ MA Großrad,KA = 2,5 ∙ 21100 Nm = 52750 Nm

Somit ergeben sich für die kritischen Querschnitte A-A bis D-D folgende Ergebnisse:

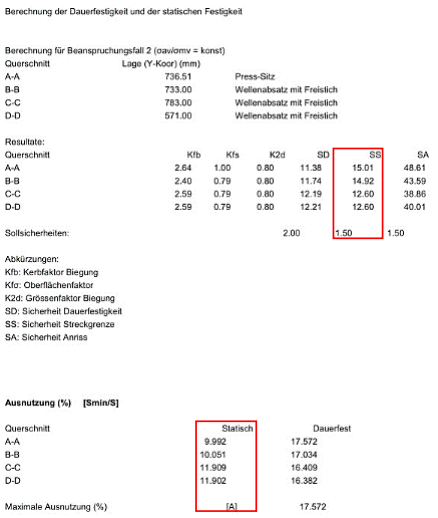
[picture p141: figure]

Die Ergebnisse für die Dauerfestigkeit sind bei dieser statischen Betrachtung zu

vernachlässigen. Die statischen Ergebnisse sind rot hervorgehoben. Die geforderten

Sicherheiten werden eingehalten. Detaillierte Ergebnisse zur Berechnung sind im

Berechnungsprotokoll | „Protokoll | Welle | Großrad | Drehmoment | 52750Nm,

Festigkeitsnachweis Kurzschlussfall“ zu finden.

### 3.6.2 Eigenfrequenzen/ kritische Drehzahlen

Die Eigenfrequenzen und kritischen Drehzahlen werden mit Hilfe von „Kisssoft“

berechnet. Es ergeben sich folgende Ergebnisse:

Die Eigenfrequenzen und kritischen Drehzahlen liegen weit unter bzw. über der maximalen Betriebsdrehzahl von 650,94 min⁻¹
und stellen somit kein Problem dar.

Detaillierte Ergebnisse zur Berechnung sind im Berechnungsprotokoll „Protokoll

Welle Großrad Drehmoment 21100Nm, Festigkeitsnachweis“ zu finden.

### 3.6.3 Durchbiegung der Welle und Verdrehwinkel

Die Durchbiegung der Welle wird mit Hilfe von „Kisssoft“ berechnet. Es ergeben sich

folgende Ergebnisse:

Die Durchbiegung und der Verdrehwinkel sind in einem zulässigen Bereich.

Detaillierte Ergebnisse zur Berechnung sind im Berechnungsprotokoll „Protokoll

Welle Großrad Drehmoment 21100Nm, Festigkeitsnachweis“ zu finden.

### 3.7 Pressverbindung am Großrad

Gemäß Aufgabenstellung wird hier eine rein elastische Pressverbindung des

Großrades auf der Abtriebswelle mit den notwendigen Passungen ausgelegt. Diese

wird sowohl durch das Auslegungsmoment (T einschl. KA = 21100Nm), als auch

durch die Axialkraft Fax belastet. Um diese zu bestimmen, muss zunächst die

Tangentialkraft am Großrad errechnet werden. Hierbei gilt: dw= 585,212 mm

FtGr =

T
0,5 · dw

=> FtGr = 72110,6 N

Mit βw

= 14° und Fax= FtGr · tan(βw

) folgt:

=>Fax = 17979,2 N

Um die zu übertragende Betriebskraft Fr an den Fügeflächen zu berechnen, muss

die aus T resultierende Tangentialkraft Ft und Fax quadratisch addiert werden:

Ft=

T
0,5 · DF

=>Ft = 187555,5 N

Fr = √Fax
2
+ Ft

2

Fr = 188415 N

### 3.7.1 Bestimmung und Überprüfung der Passung

Aufgrund der Geometrie des Zahnrades wird der Pressverband in drei Bereiche

unterteilt. Die Berechnung dieser Teilbereiche kann der im Anhang befindlichen

Excel | -tabelle | (Pressverbindung | nach | Decker) | entnommen | werden. | Der

Nachfolgenden Abbildung können die Maße der jeweiligen Bereiche entnommen

werden.

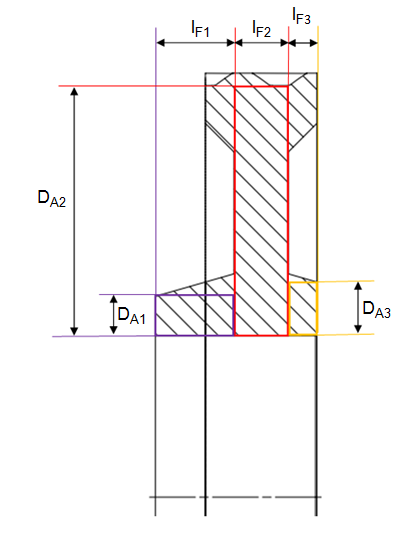
[picture p142: figure]

Beispielhaft wird die gewählte H6/t5 Passung näher ausgeführt:

Gegebene Werte:

Uk = 151 µm, Ug = 200µm, Fügedurchmesser DF

= 225mm, RzA= RzI= 5µm, νA= νI = 0,3

EA= EI=210000

N
mm²

, ReA=675

N
mm²

, ReI=400

N
mm²

, µ = 0,18, sp=1,2

Fugenlänge lF1= 55mm, lF2= 40mm, lF3= 20mm, DA1= 300mm, DA2= 574mm, DA3= 300

Geforderte Haftsicherheit: SH = 2

Bestimmung des Übermaßverlustes:

Uv = 0,8 · (RzA+ RzI)
=> Uv= 8 · 10⁻³ mm

Es wird das kleinste wirksame Übermaß wie folgend bestimmt:

Uwk= Uk - Uv

=> Uwk = 0,143 mm
Bestimmung des kleinsten bezogenen wirksamen Übermaßes:

Zwk=

Uw
DF

Beispielhafte Berechnung des Durchmesserverhältnis QA1(für Bereich 1):

QA1 =

DF1

DA1

=> QA1= 0,804

Da es sich beider Welle um Vollmaterial handelt, gilt nach MA Decker (S. 258):

QI=0

Ermittlung der Hilfsgröße K im Bereich 1:

K1 =

EA
EI

·(1 - ν) +

1+ QA1

2

1- QA1

2

+ νA

=> K1 = 5,645

Berechnung der Fugenpressung im Bereich 1:

pFk1 = Zwk ·

EA1
K1

=> pFk1 = 23,64

N
mm²

Berechnung der Haftkraft im Bereich 1:

FF1= pFk1 · DF · π · lF1 · µ

=> FF1 = 165443,0 N

Die Berechnung der Haftkraft für Bereich 2 und 3 erfolgt analog.

Um eine Gesamthaftkraft zu bestimmen, muss die Haftkraft der Einzelbereiche

addiert werden:

FFk = ∑FFi

FFk = 512810,96 N

Vorhandene Haftsicherheit:

SH =

FFk
Fr

SH = 2,73

Es gilt: | SH > geforderte SH=2

Wie der Excel-Tabelle zu entnehmen ist, würde eine H6/s5 Passung nicht die geforderte Haftsicherheit erreichen. Aufgrund der deutlich Überhöhten Sicherheit der

gewählten H6/t5 Passung wird zur Vereinfachung der Rechnung die 15° Schrägung

der Bohrung im Großrad nicht berücksichtigt. Diese würde eine minimale Verkürzung

von lF1 und lF3 führen.

Hinsichtlich der Sicherheit bei Maximalbelastung bei einem möglichen Kurzschluss

des | Motors

gilt:Tmax=T·2,5 = 52750 Nm und Faxmax = 44948 (Berechnung analog zu Fax)

SHmax=1,08 (siehe Excel-Tabelle im Anhang, berechnung analog zu SH)

Da SHmax>1 kann ein Durchrutschen der Verbindung mit ausreichender Sicherheit

ausgeschlossen werden (2. Testat)

Zur Kontrolle der Normalbeanspruchung wird zunächst das größte wirksame Übermaß Uwg bestimmt:

| Uwg= Ug
- UV
| Uwg = 192µm

Beispielhafte Überprüfung von Teilstück 1:

Berechnung der größten Fugenpressung pFg1:

pFg1= pFk1 ·

Uwg

Uwk

=> pFg1 = 31,74

N
mm²

Bestimmung der zulässigen Pressung des Außenteils pA1 zul:

pA1 zul=

1- QA1

2

√3 · Sp

- ReA

=> pA1 zul= 115

N
mm²
Da nun gilt: pFg1< pA1 zul , so kommt es im Außenteil im Bereich 1 zu keiner

Überbeanspruchung. Die Berechnung der Bereiche 2 und 3 erfolgt analog (s. Excel-

Tabelle Pressverbindung nach Decker). Da nach MA Decker die zulässige Pressung

des Innenteils größer ist (Vgl. Excel-Tabelle), wird an dieser Stelle auf eine

ausführliche Berechnung verzichtet.

### 3.7.2 Bestimmung der Fügetemperatur:

Wie der Excel-Tabelle (Pressverbindung nach Decker im Anhang) zu entnehmen ist,

reicht es nicht aus entweder die Welle auf -196 °Celcius abzukühlen oder das

Großrad auf maximal 190° Celcius zu erwärmen (Berechnung erfolgt analog zu MA

Decker 20. Auflage).
Folglich muss das größte Übermaß Ug
(200 µm) und das Einführungsspiel Se

(Se =

0,001·DF = 0,225mm) auf die abzukühlende Welle und das zu erwärmende Großrad

verteilt werden.

Beispielhaft wird die Welle im Folgenden maximal auf -196 °C mit flüssigem

Stickstoff abgekühlt und eine erforderliche Erwärmtemperatur des Außenteils

ermittelt.
Zunächst wird das größte Übermaß inklusive des Einführungsspiels beim Abkühlen

ermittelt. Es sei t die Raumtemperatur (t = 20°C):

Ugab = (tI

- t) · (αI
- DF

) - se

=> Ugab = 0,188

Ermittlung der erforderlichen Erwärmtemperatur des Außenteils:

tA=

(Ug

- Ugab)
αA · DF

+ t

=> tA = 24,8 °C

Weitere Möglichkeiten diese Presspassung zu fügen werden in der Excel-Tabelle

(Pressverbindung nach Decker im Anhang) ausgeführt. Ausschlaggebend für eine

Entscheidung ist hierbei immer die Kostenfrage aber auch welche technischen Mittel

dem Betrieb zur Verfügung stehen. So könnte es sich bspw. als schwierig erweisen

das Großrad mit einem Durchmesser von ca. 550 mm in einem Induktionsofen zu

platzieren.

### 3.8 Schraubenberechnung Drehmomentstützenanbindung

Die Drehmomentstütze wird mit einem Bolzen und 2 Schrauben mit zugehörigen

Muttern an das Gehäuse angeschraubt. Um die Schrauben auszulegen, wird

zunächst die auf eine Schraube wirkende Axialkraft berechnet. Da die Schrauben

einer schwingenden Belastung unterliegen, werden FA, FAo und FAu für eine

Schraube ermittelt. Hierfür wird der Hebelarm x benötigt:
x = a + s = 340 mm + 136,5 mm = 476,5 mm

x = Hebelarm; a = Achsabstand; s = Abstand Ritzelwelle zu Drehmomentstützenanbindung

Die mittlere, statische Axialkraft FA ergibt sich aus dem Auslegungsmoment MA

Ritzel,KA:

FA =

MA Ritzel,KA
2 ∙ x

=

21100 Nm
2 ∙ 476,5 mm

= 22,14 kN

Die Oberkraft des Lastspiels FAo ergibt sich aus dem Kurzschlussmoment MKs, Ritzel:

FAo =

MKs,Ritzel
2 ∙ x

=

2,5 ∙ MA Ritzel,KA
2 ∙ x

=

2,5 ∙ 21100 Nm
2 ∙ 476,5 mm

= 55,35 kN

Die Unterkraft des Lastspiels FAu ergibt sich bei Stillstand, dass heißt M = 0: FAu = 0 kN

Mit Hilfe des Excel-Sheets „10-schr100.xls“ wird die Schraubenverbindung nach

Maschinenelemente Decker berechnet. Die folgende Skizze zeigt den konstruktiven

Aufbau der Schraubenverbindung.

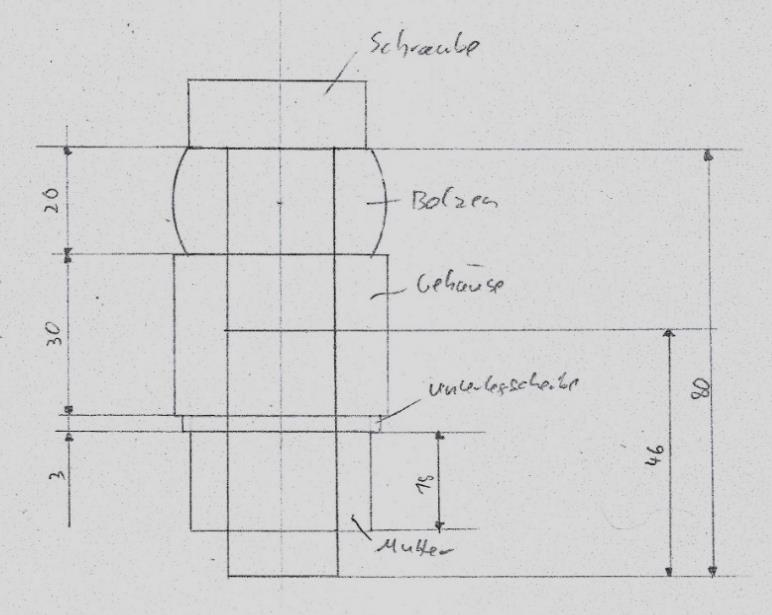
[picture p143: figure]

Schraube: DIN EN ISO 4014-M20x80-12.9

Mutter: DIN EN ISO 4032-M20-10

Unterlegscheibe: DIN EN ISO 7091-20-100HV

### 3.8.1 Berechnung

Der Gewindenenndurchmesser beträgt 20mm (M20-Schraube), die Steigung ergibt

nach Tab. 10.1 2,5 mm, der Kopf- bzw. Mutternauflagedurchmesser nach Tab. 10.4

28,2 mm und der Durchmesser des Durchgangsloches nach Tab. 10.3 22 mm. Die Streckgrenze der Schraube ergibt nach Tab. 10.2 1080 N
mm²

. Aufgrund der Sicherheit

sollen nur 90% der Schraubenfestigkeit belastet werden. Die Reibzahlen im Gewinde

und an der Auflagefläche sind nach Vorgabe 0,12, der Anziehfaktor war mit 1,4

ebenfalls vorgegeben.

Für die Berechnung der Nachgiebigkeit der Schraube werden sowohl die

Durchmesser als auch die Längen der Schraubenabschnitte benötigt.

Abschnitt 1:
d1E = 20 mm

l1E = l − b + 0,4 ∙ d = 80 mm − 46 mm + 0,4 ∙ 20 mm = 42

Abb.: 9 Skizze Schraubenverbindung

Abschnitt 2: Da keine Taillenschraube verwendet wird, sind die Werte für den

Durchmesser und die Länge gleich null.

Abschnitt 3:
d3E = 16,933
l3E = nicℎt eingescℎraubtes Gewinde + lG = (46 − 9 − 18)mm + 0,5 ∙ 20 mm

= 29 mm

Die Klemmlänge ergibt sich zu 53 mm.
Der Elastizitätsmodul für den aus C45 gefertigten Bolzen beträgt 210 000 N
mm²

, die

Breite des Bauteils beträgt 33 mm.

Für den Vorspannkraftverlust durch Setzen wird der Setzbetrag benötigt. Dieser

berechnet sich nach Tab. 10.10 aus:
fz = 3 μm + 2 ∙ 3 μm + 3 ∙ 3 μm = 18 μm

Für den Krafteinleitungsfaktor wird der Normalfall mit n = 0,5 angenommen. Die

erforderliche Mindestklemmkraft wird auf 50 kN festgelegt, um eine höhere

Vorspannung und damit mehr Sicherheit in der Schraubenverbindung zu haben. Da

weder eine Querkraft noch ein Drehmoment durch die Schraubenverbindung

übertragen werden muss, könnte sie rein theoretisch auch auf null gesetzt werden.

Das zulässige Schraubenanziehmoment beträgt nach Tab. 10.8/9 650 Nm, die Ausschlagfestigkeit nach Tab. 10.11 40 N
mm³

. Die Lochanfasung wird mit 0,5 gewählt.

Die zulässige Flächenpressung beträgt nach Tab. 10.12 für S355 600 N
mm²

1. Schritt: | Schraube mit metrischen ISO-Gewinde:
Gewindenenndurchmesser | d (mm) | 20
Steigung des Gewindes (Tab. 10.1) | P (mm) | 2,5
Kopf- bzw. Mutternauflagedurchmesser (Tab. 10.4) | DK (mm) | 28,2
Durchmesser des Durchgangsloches (Tab. 10.3) | DI (mm) | 22

Abmessungen und Querschnitte für das gewählte Gewinde (Tab.
10.1):
- Flankendurchmesser | d2 (mm) | 18,376
- Kerndurchmesser | dK (mm) | 16,933
- Spannungsdurchmesser | dS (mm) | 17,655
- Kernquerschnitt | AK (mm²
| ) | 225,190
- Spannungsquerschnitt | AS (mm²
| ) | 244,794
- Nennquerschnitt | AN (mm²
| ) | 314,159

Festigkeit der Stahlschraube:

Streck- bzw. Dehngrenze | des
Schraubenstahls (Tab. 10.2)

Re bzw. Rp0,2
(N/mm²
)

1080

Wieviel % der Streck- bzw. Dehngrenze | (Re bzw. Rp0,2)
soll für die Vergleichsspannung σV zugelassen werden? | (%) | 90

Reibzahlen:
Reibzahl im Gewinde (Tab. 10.7) | µG | 0,12
Reibzahl an der Auflagefläche (Tab. 10.7) | µK | 0,12

Ausführung der Schraube:
als Schaftschraube (1) oder Taillenschraube (2) | | 1
Taillendurchmesser (Tab. 10.1) | dT (mm)
- Taillenquerschnitt (Tab. 10.1) | AT (mm²
) | 0,0
2. Schritt: | Richtwert für den Anziehfaktor (Tab. 10.6) | αA | 1,4
Wird der Schraubenbolzen beim Anziehen | auf Torsion
| beansprucht? | ja (1)
| | oder nein (2) | 1
Vergleichsspannung, die beim Anziehen | zugelassen
| werden soll | σV (N/mm²
) | 972,00
| zulässige Montagevorspannung | σMzul (N/mm²
) | 811,66
| zulässige Montagevorspannkraft | FMzul (kN) | 198,69
Sonderfall: | Soll mit der errechneten zul. Montagevorspannkraft weitergerechnet
| werden? | | nein

2

| Wenn nein, gewünschten Vorgabewert für FMzul eingeben! | FMzul,neu (kN) | 202
min. Montagevorspannkraft (wenn FMmax = FMzul) | FMmin (kN) | 144,29
mittlerer Auflageradius | rm (mm) | 12,55
Schraubenanziehmoment | MA (Nm) | 643,37
3. Schritt: | Nachgiebigkeiten von Schraube/Bauteil und Kraftverhältnis:
Durchmesser, Element 1 (Schaft) | d1E = d (mm) | 20
Durchmesser, Element 2 (Taille) | d2E (mm) | 0
Durchmesser, Element 3 (Gewindekern) | d3E = dK (mm) | 16,933
Länge, Element 1 (einschl. lK = 0,4 d) | l1E (mm) | 42
Länge, Element 2 | l2E (mm) | 0
Länge, Element 3 (einschl. lG = 0,5 d) | l3E (mm) | 29

Klemmlänge der Schraubenverbindung | LK (mm) | 53

Ersatzlängen (Erfahrungswerte)
- für den Anteil des Schraubenkopfes | lK (mm) | 8
- für den Anteil des Gewindekerns | lG (mm) | 10
| für | den | Anteil | der | Verformung | von
Schrauben- und Muttergewinde | lM (mm) | 8

für das angeschraubte Bauteil:
Elastizitätsmodul des Bauteilwerkstoffes (Tab. 9.2) | EB (kN/mm²
) | 210
Außendurchmesser bzw. Breite des Bauteils | DA (mm) | 33
Sonderfall: | Soll | die | Bauteilnachgiebigkeit | überschlägig | mit | einem
Nachgiebigkeitsverhältnis ausgerechnet werden? | nein

2
Annahme: Nachgiebigkeitsverhältnis | δB/δS | ?
Querschnitte der Einzelelemente | A1 (mm²
) | 314,16
A2 (mm²
) | 0,00
A3 (mm²
) | 225,19
Nachgiebigkeit der Schraube | δS (10⁻
3mm/kN) | 1,371
Verhältnis | DA/DK | 1,17
Ersatzquerschnitt | AB (mm²
) | 428,24
Faktoren für die Ersatzquerschnitt-Berechnung | x1 | 1,111
x2 | 0,610
Nachgiebigkeit des Bauteils | δB (10⁻
3mm/kN) | 0,589
Verlängerung der Schraube beim Anziehen | fSM (mm) | 0,000
Kraftverhältnis | ΦK | 0,301
4. Schritt: | Vorspannkraftverlust durch Setzen:
Klemmlängenverhältnis | LK/d | 2,65
Setzbetrag (Tab. 10.10) | fZ (10⁻³mm) | 18
- Vorspannkraftverlust | FZ (kN) | 9,181
- vorläufige max. Vorspannkraft | FVmax,v (kN) | 0,000
| FVmin,v (kN) | 135,104
5. Schritt: | Kräfte an der Schraubenverbindung:
äußere Betriebslängskraft (axiale Betriebskraft) | FA (kN) | 22,14
bei schwingender Betriebslängskraft:
Oberkraft des Lastspiels | FAo (kN) | 55,4

Unterkraft des Lastspiels | FAu (kN) | 0

Angriffspunkt der äußeren Betriebskraft FA
Krafteinleitungsfaktor (Normalfall: n = 0,5) | n | 0,5
erforderliche Mindestklemmkraft je Schraube | nach den
Erfordernissen der Konstruktion | FKerf (kN) | 50
6. Schritt: | bei ruhender Betriebskraft:
mit dem gewählten Klemmlängenfaktor: | n | 0,5
- Differenzkraft in der Schraube | FSA (kN) | 3,33
- Differenzkraft im Bauteil | FBA (kN) | 18,81
- vorläufige Größtkraft in der Schraube | FSmax,v (kN) | 3,33
| FSmin,v (kN) | 138,43
- errechnete Restklemmkraft | FK (kN) | 116,29
erforderliche Mindestklemmkraft | FKerf (kN) | 50,00

Soll mit der erforderlichen Klemmkraft (FKerf) oder mit der errechneten
Klemmkraft (FK) weitergerechnet werden ?

erforderliche
Klemmkraft

1
erforderliche maximale Montagevorspannkraft | FMmax (kN) | 109,19
7. Schritt: | vorzuschreibendes Schraubenanziehmoment:
Reibzahl im Gewinde | µG | 0,12
Reibzahl an der Auflagefläche | µK | 0,12
mittlerer Auflageradius | rm (mm) | 12,55
Schraubenanziehmoment | MA (Nm) | 347,77
zulässiges Schraubenanziehmoment (Tab. 10.8/9) | MAzul (Nm) | 650
Kontrolle: | Ist das vorzuschreibende Schraubenanziehmoment kleiner als das
zulässige nach Tab. 10.8/9 ?
8. Schritt: | Überprüfung der Haltbarkeit der Schraubenverbindung:
Spannungsdifferenz | σsa (N/mm²
) | 13,59
Kontrolle 1: | Ist die errechnete Spannungsdifferenz kleiner als 10% der
Dehngrenze?

0,1 Rp0,2
(N/mm²
)

108,00

Spannungsausschlag | σa (N/mm²
) | 17,01
Kraftamplitude | Fa (N) | 4163,52
Mittelkraft des Lastspiels in der Schraube | Fm (kN) | -0,84
Ausschlagfestigkeit (Tab. 10.11) | σA (N/mm²
) | 40
Kontrolle 2: | zul. Spannungsausschlag | σazul (N/mm²
) | 36,00

Flächenpressung
Lochanfasung | (mm) | 0,5

Soll mit der erforderlichen Klemmkraft (FKerf) oder mit der errechneten
Klemmkraft (FK) weitergerechnet werden ?

erforderliche
Klemmkraft

1
erforderliche maximale Montagevorspannkraft | FMmax (kN) | 109,19
- max. Vorspannkraft | FVmax (kN) | 100,010
- Größtkraft in der Schraube | FSmax (kN) | 103,337
gepresste Fläche zwischen Schraubenkopf/Bauteil | Ap (mm²
) | 209,10
Flächenpressung an der Kopfauflagefläche | pB (N/mm²
) | 494,19
Kontrolle 3: | zul. Flächenpressung (Tab. 10.12) | pBzul (N/mm²
) | 600

### 3.8.2 Ergebnisse:

- Das Schraubenanziehmoment liegt unter dem zulässigen Anziehmoment und ist somit zulässig. Zur Vereinfachung wird es auf 350 Nm gerundet. Da die Ergebnisse sich bei diesem minimal höheren Anziehmoment kaum verändern, werden diese nicht nochmals berechnet.
- Die errechnete Spannungsdifferenz ist deutlich kleiner als 10% der Dehngrenze und ist somit zulässig.
- Der Spannungsausschlag ist mit 17,01 N
mm²

kleiner als der zulässige Spannungsausschlag mit 36 N
mm²

und somit zulässig.
- Die Flächenpressung an der Kopfauflagefläche ist kleiner als die zulässige Flächenpressung des Bolzens und ist somit zulässig. Es wird eine Sicherheit von 600
494,19

= 1,21 eingehalten.

Die Schraubenverbindung an sich ist richtig ausgelegt. Nachfolgend wird noch die

Flächenpressung auf das Gehäusestück kontrolliert, um ein Versagen zu

verhindern.

Flächenpressung von Unterlegscheibe auf Gehäusestück:

p =

FS,max
A

=

FS,max
π
4
- (dA

2 − dI

2
)

=

103,337kN
π
4
- (37² − 22²)mm²

= 148,67

N
mm²

Flächenpressung von Bolzen auf Gehäusestück:

p =

FS,max
A

=

FS,max
π
4
- (dA

2 − dI

2
)

=

103,337 kN
π
4
- (33² − 22²)mm²

= 217,48

N
mm²

Die zulässige Flächenpressung für EN-GJS-500-7 beträgt 500 N
mm²

. Somit stellt

die Flächenpressung auf das Gehäusestück kein Problem dar. Es sind

Sicherheiten >2 vorhanden.

## 4 Projektergebnis

Das Projektziel wurde durch die Kalkulation der beiden Varianten und der Auslegung

der Lager und Wellen erreicht. Somit kann das konstruierte Schneckengetriebe

produziert und verwendet werden. Alle in der Anforderungsliste geforderten Ziele

wurden erreicht.

## 5 Montageanleitung

### 5.1 Schritt 1: Vormontage Welle Großrad

Als erstes muss die Welle mit dem Großrad thermisch verbunden werden. Daraufhin

werden die Timken Lager in X-Anordnung auf die Welle aufgepresst werden.

Anschließend wird der Distanzring angebracht. Als letzter schritt dieser Vormontage

wird der erste Teil der Labyrinthdichtung auf die Welle aufgepresst.

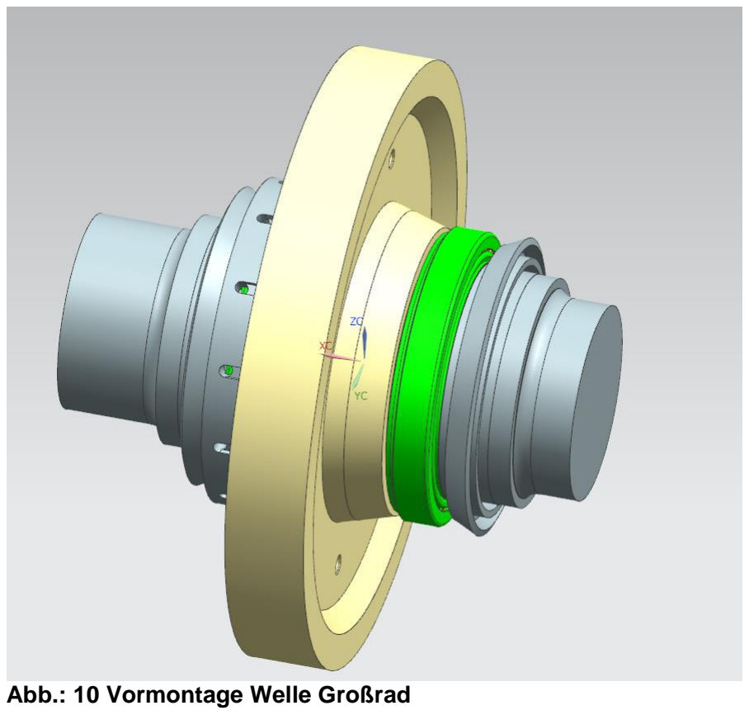
[picture p144: figure]
Abb.: 10 Vormontage Welle Großrad

### 5.2 Schritt 2: Vormontage Unterteil Gehäuse

In der Vormontage des Unterteils wird das Schauglas für den Ölfüllstand, sowie die

Ölablassschraube montiert. Das Schauglas wird über einen Rahmen, dieser mit 8

Schrauben am Gehäuse verschraubt wird. Die Verbindungsstelle zwischen Gehäuse und Rahmen wird mit Loctite versiegelt. Die Öleinfüllöffnung wird erst nach einfüllen

des Öls montiert.

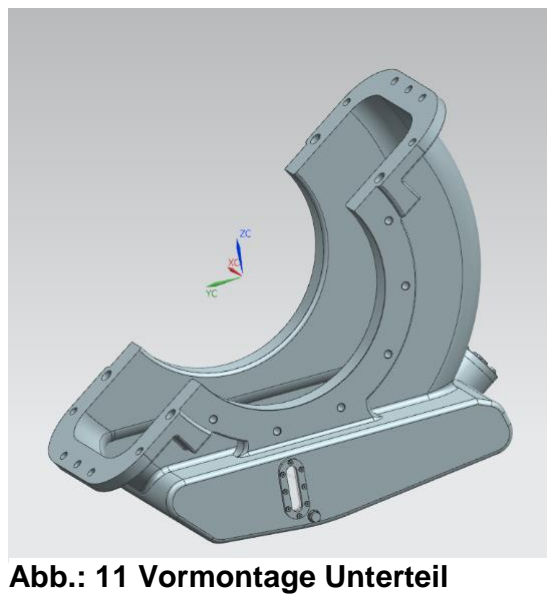
[picture p145: figure]
Abb.: 11 Vormontage Unterteil

### 5.3 Schritt 3: Zusammenfügen Ober- Unterteil und Vormontage

Schritt 1

Die Baugruppe aus Schritt 1 wird in das Unterteil eingelegt und daraufhin wird das

Oberteil aufgesetzt. Die Verbindungsstelle am Flansch wird mit Loctite versiegelt.

Anschließend wird Ober- und Unterteil mit M12 Bolzen verspannt und zusätzlich mit

M16 Ankerschrauben verpresst. Als nächstes wird der zweite Teil der

Labyrinthdichtung eingeführt und anschließend mit M12 Schrauben sowie Loctite

verschraubt. Zur Einstellung der Zahnradverbindung wird auf eine Seite eine

Laminumscheibe zwischen Gehäuse und Labyrinthdichtung gelegt.

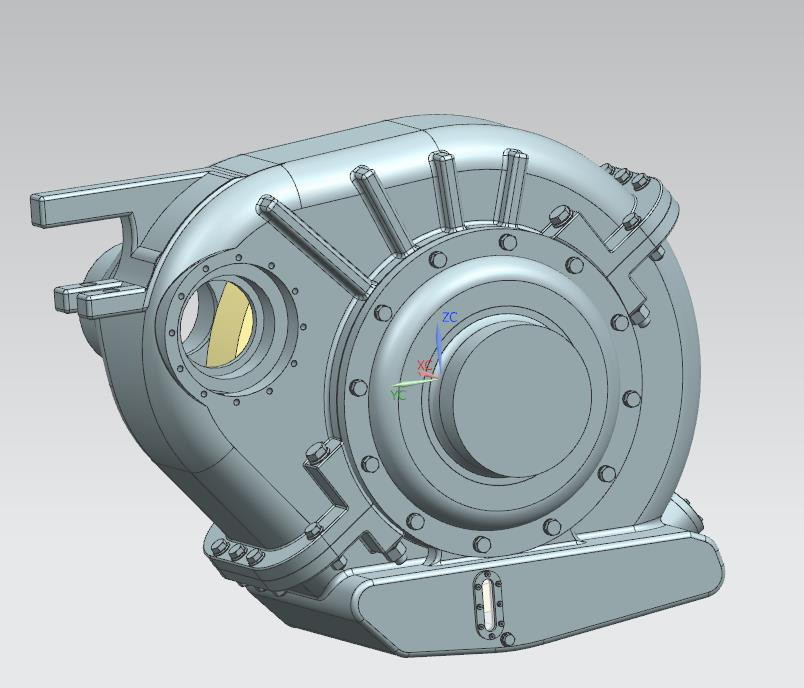
[picture p146: figure]

### 5.4 Schritt 4: Vormontage Ritzel

Zur Vorbereitung des Ritzels werden das QJ Lager sowie das Rollenlager auf der

einen Seite auf die Welle des Ritzels aufgespannt. Die Spannung wird über einen

Spannring dieser mit vier Schrauben an der Welle befestigt ist gewährleistet.

Zwischen den Lagern darf der Distanzring nicht vergessen werden.

Abb.: 12 Zusammenbau

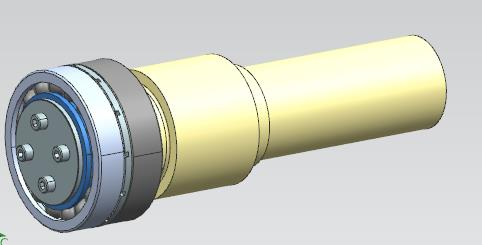
[picture p147: figure]

Abb.: 13 Vormontage Ritzel

### 5.5 Schritt 5: Endmontage Ritzel

Schlussendlich wird die Baugruppe von Schritt 4 von der Radseite in das Gehäuse

eingeführt. Auf der Antriebsseite wird das zweite Rollenlager auf die Welle

aufgeschoben und in das Gehäuse gepresst. Auf der Radseite wird ein Deckel

montiert, dieser wiederum mit Loctite an den Verbindungsstellen verklebt und

verschraubt wird. Auf der Antriebsseite wird ein Distanzring in das Gehäuse

geschoben. Dabei ist zu beachten, dass die Löcher im Ring mit denen im Gehäuse

übereinstimmen. Anschließend wird das erste Teil der Labyrinthdichtung auf die

Welle gepresst. Schlussendlich wird der zweite Teil der Labyrinthdichtung

angebracht | und | verschraubt. | Der | Letzte | Schritt | ist | die | Montage | der

Drehmomentstütze, diese über einen Bolzen und M20 Schrauben am Gehäuse

befestigt ist. Die Antriebsübertragung erfolgt über eine Bogenzahnkupplung.

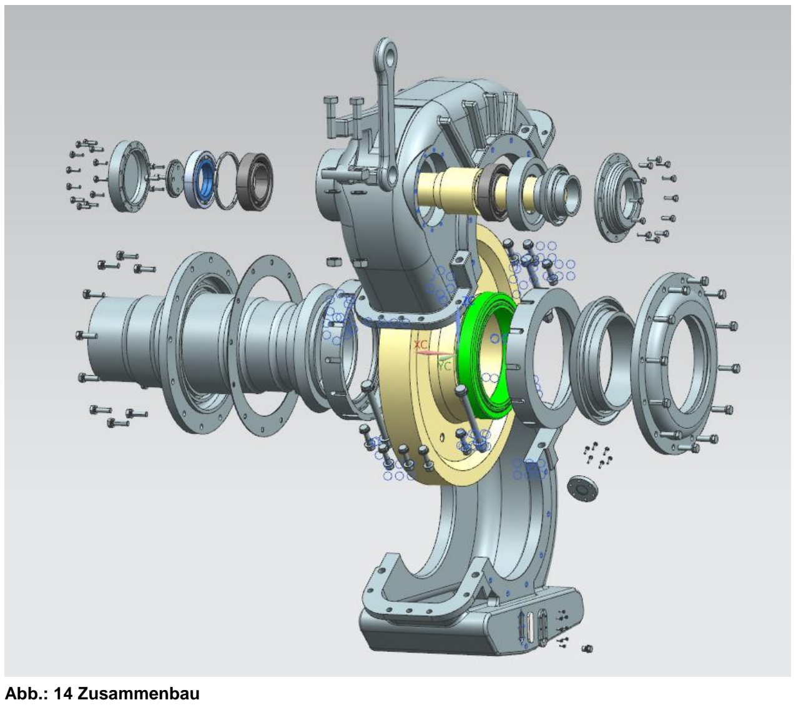
[picture p148: figure]
Abb.: 14 Zusammenbau

## 6 Demontageanleitung

Die Demontage beruht auf die umgekehrte Reihenfolge der Montage. Dabei ist nur

zu beachten das Laminumscheibe und Loctite ausgetauscht werden müssen. Bei der Demontage des Großrad kann Öl über eine Kernlochbohrung hinzugefügt werden.

## 7 Literaturverzeichnis

Binz, H: | Konstruktionslehre I – Umdruck zur Vorlesung, Stuttgart 2009
Binz, H: | Konstruktionslehre II – Umdruck zur Vorlesung, Stuttgart 2010
Binz, H | Konstruktionslehre III – Umdruck zur Vorlesung, Stuttgart 2011
Binz, H | Konstruktionslehre IV – Umdruck zur Vorlesung, Stuttgart 2011
Decker, K: | Decker Maschinenelemente – Formeln, Hanser, 8. Auflage,
| München 2018a
Decker, K: | Decker Maschinenelemente – Funktion, Gestaltung und
| Berechnung, Hanser, 20. Auflage, München 2018b
Decker, K: | Decker Maschinenelemente – Tabellen und Diagramme,
| Hanser, 20. Auflage, München 2018c
Läpple, V.: | Einführung in die Festigkeitslehre – Lehr- und Übungsbuch,
| Springer Vieweg, 4. Auflage, Wiesbaden 2016

## 8 Abbildungsverzeichnis

- Abb.: 1 Lagerkräfte in der X-Ebene im Rechtslauf | Fehler! Textmarke nicht definiert.

## 9 Anhang

### 9.1 Anforderungsliste

### 9.2 Werkstoffdatenblatt 18CrNiMo7-6

### 9.3 Datenblatt Radialwellendichtring

### 9.4 Datenblatt Axial-Rillenkugellager 52310

### 9.5 Datenblatt Rillenkugellager 6208-C

### 9.6 Datenblatt Kegelrollenlager 31308-XL

### 9.7 Berechnungsblätter zur Lager und Wellenberechnung

### 9.8 Protokoll Welle Ritzel Drehmoment 790Nm, gegen

Uhrzeigersinn, Lagerberechnung

9.9 Protokoll Welle Ritzel Drehmoment 790Nm, im Uhrzeigersinn,

Lagerberechnung

9.10Protokoll Welle Ritzel Drehmoment 3417,6Nm, gegen

Uhrzeigersinn, Festigkeitsnachweis

9.11Protokoll Welle Ritzel Drehmoment 3417,6Nm, im

Uhrzeigersinn, Festigkeitsnachweis

9.12Protokoll Welle Ritzel Drehmoment 8544Nm, gegen

Uhrzeigersinn, Worst Case Festigkeitsnachweis statisch

9.13Protokoll Welle Ritzel Drehmoment 8544Nm, im Uhrzeigersinn,

Worst Case Festigkeitsnachweis statisch

9.14Schraubenberechnung Drehmomentstützenanbindung
