MattdewT/KE4/Var_13_2020011_Hr_Tiroch.pdf

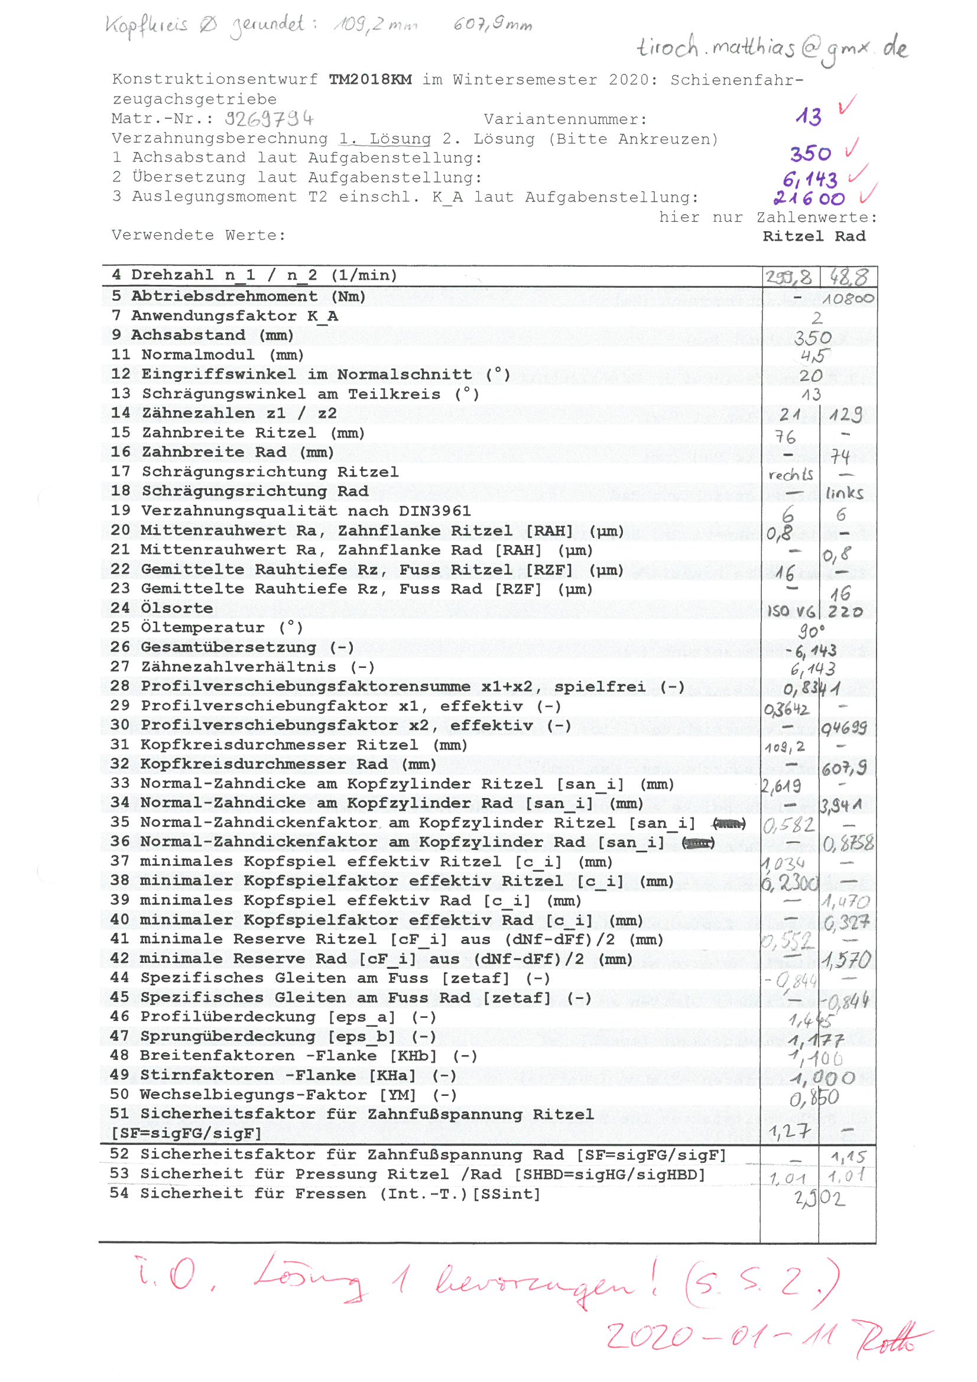
[picture p149: page 1]
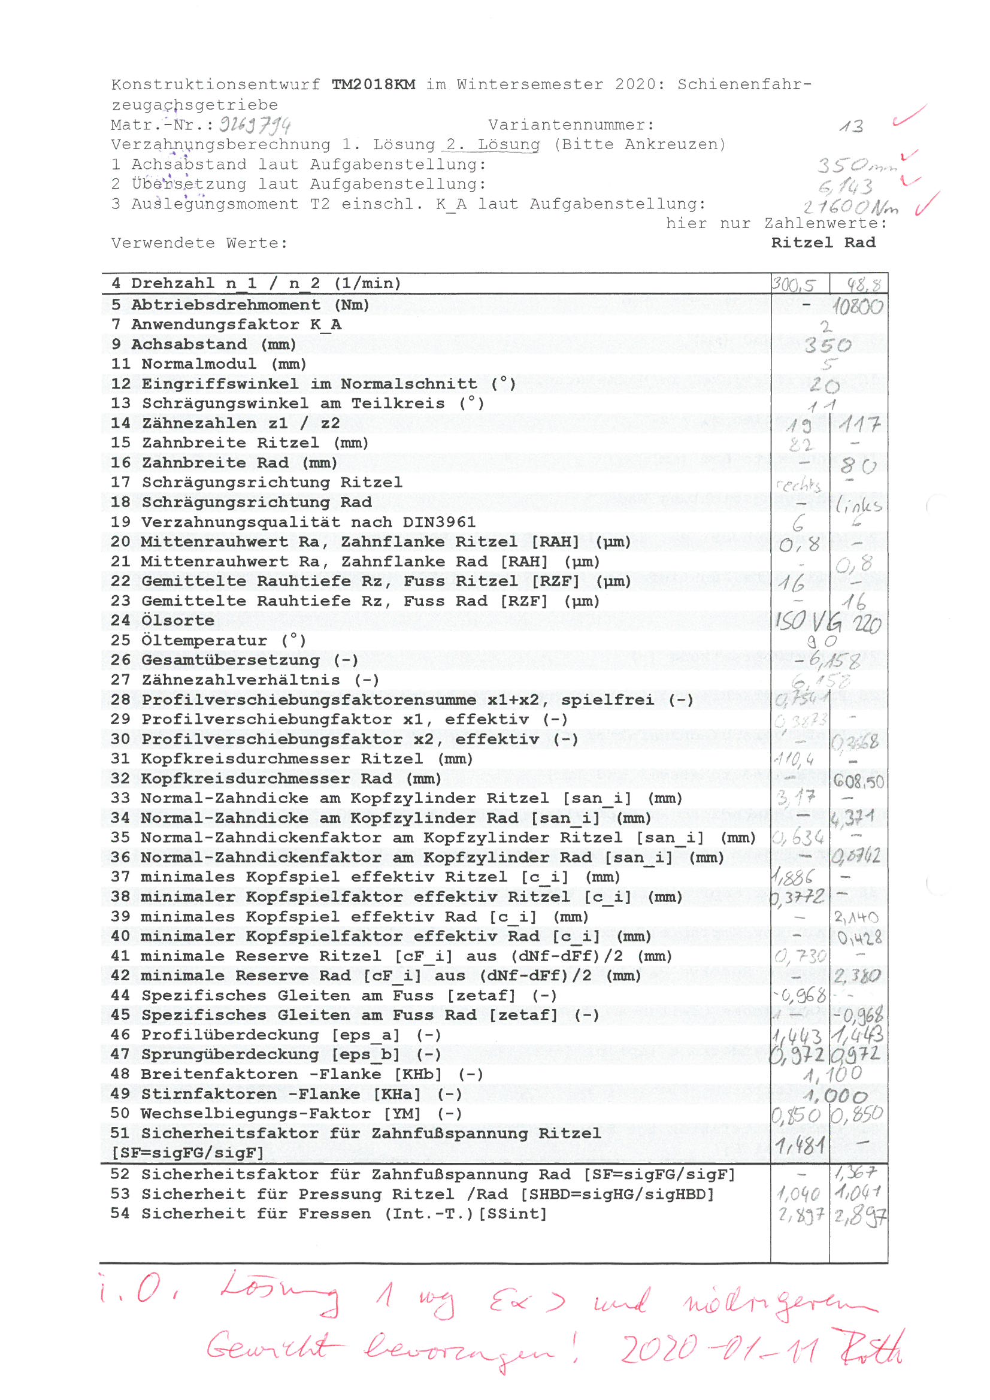
[picture p150: page 2]
