MattdewT/KE4/Finale/7.10 Datenblatt Sicherungsstift ISO 2338.pdf

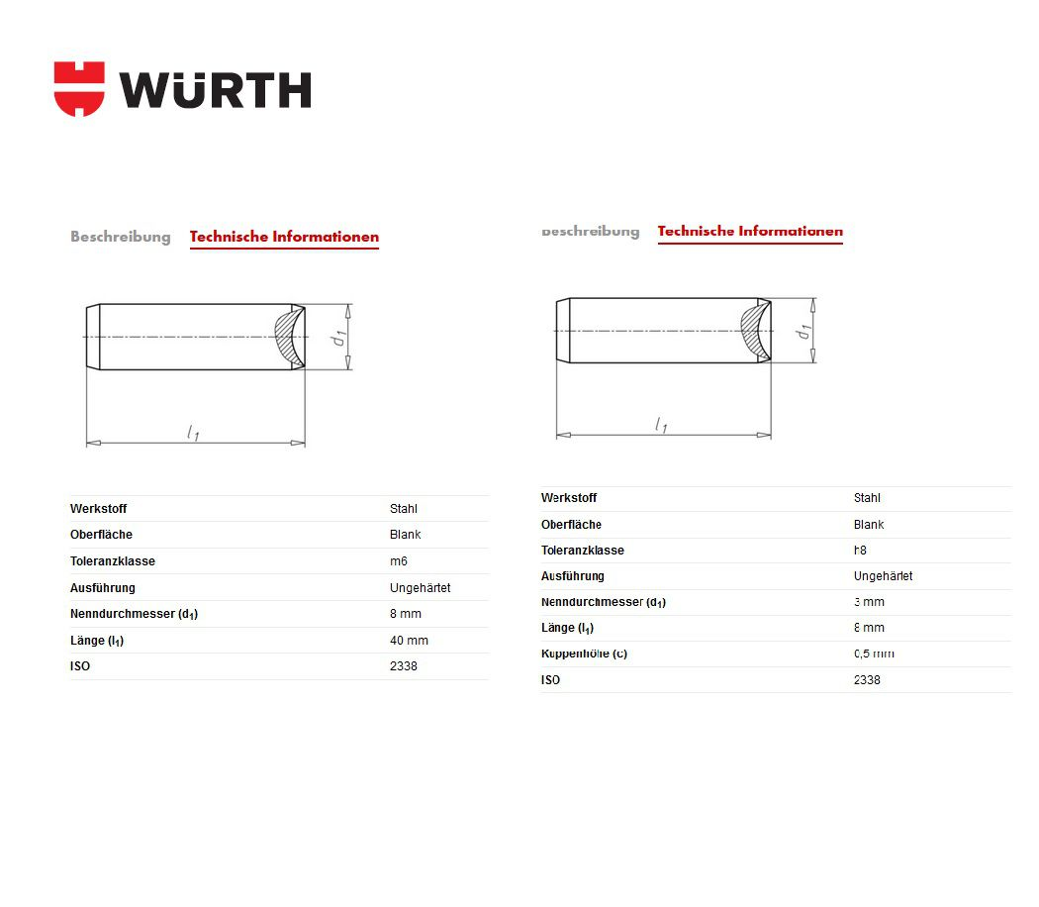
[picture p151: page 1]
