MattdewT/KE4/ALT_KE/TM2017/Plapp/Email_KE4.jpg

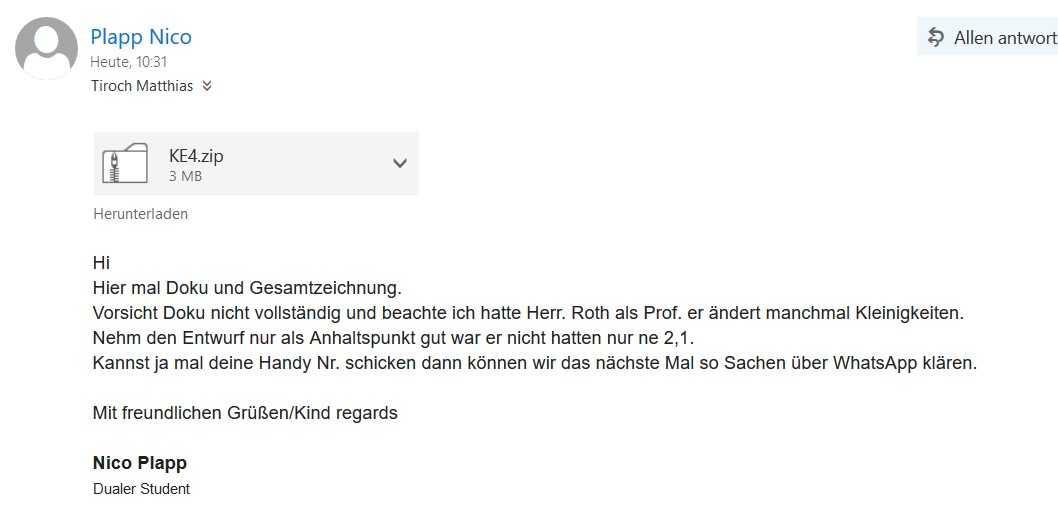
ALT_KE/TM2017/Plapp/Email_KE4.jpg
