MattdewT/KE4/Ansys/clvjfweGoI.png

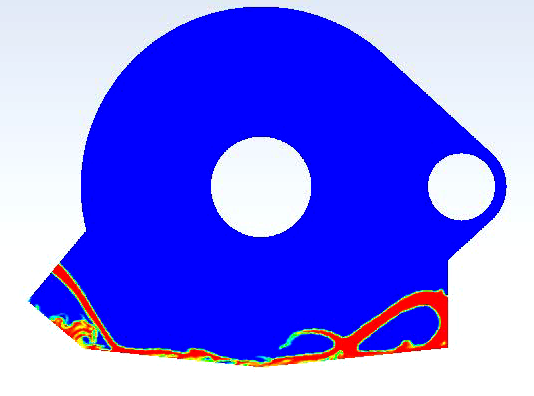
Ansys/clvjfweGoI.png
