MattdewT/KE4/Ansys/WM0g1I5gA9.png

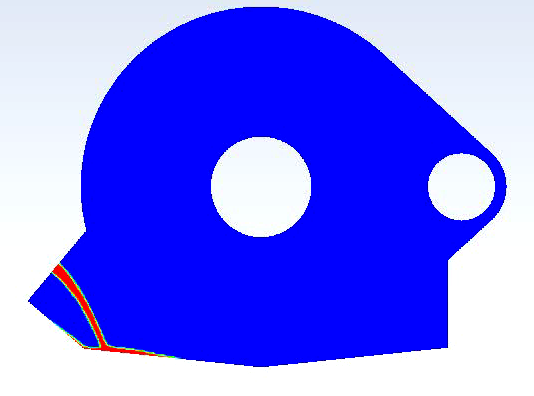
Ansys/WM0g1I5gA9.png
