MattdewT/KE4/CAD/Oberflächenzeichen.JPG

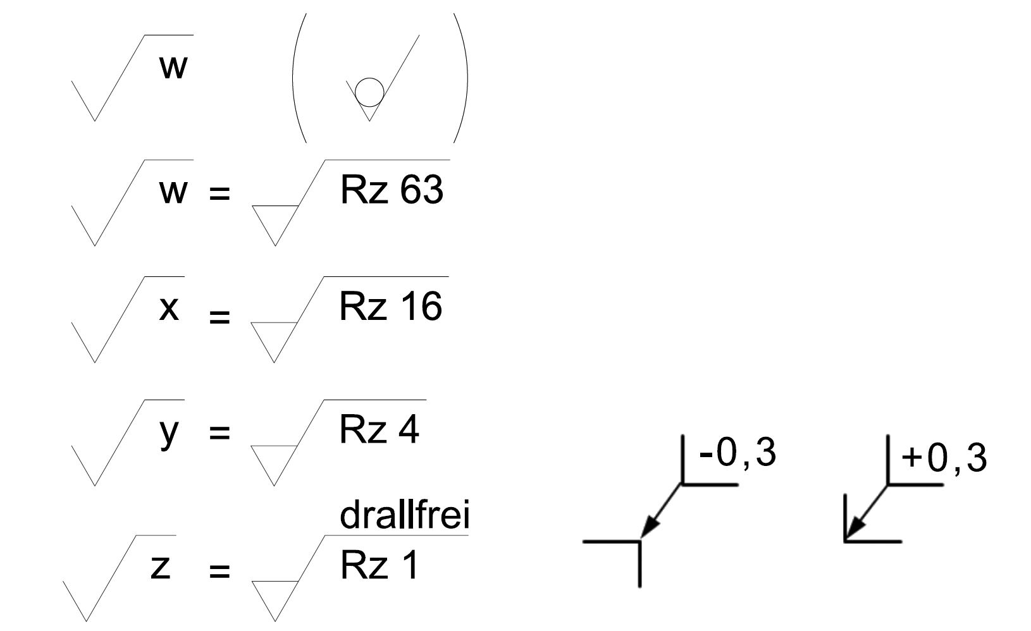
CAD/Oberflächenzeichen.JPG
