MattdewT/KE4/Dichtung2.jpg

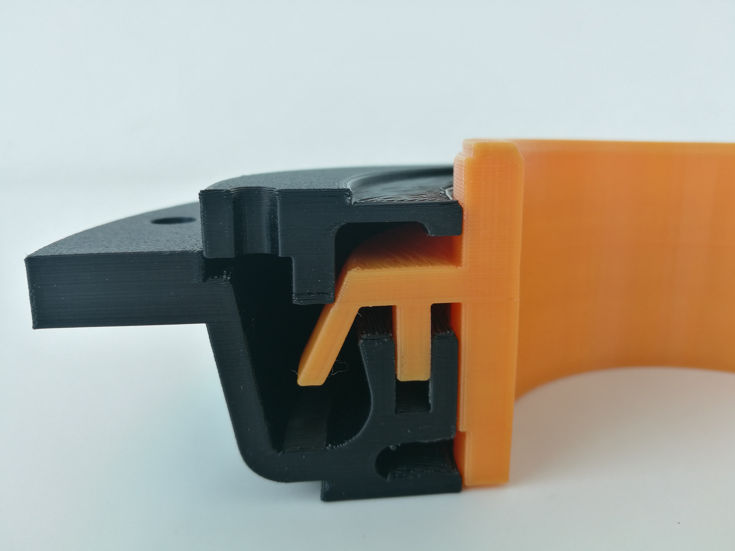
Dichtung2.jpg
