MattdewT/KE4/Dichtung3.jpg

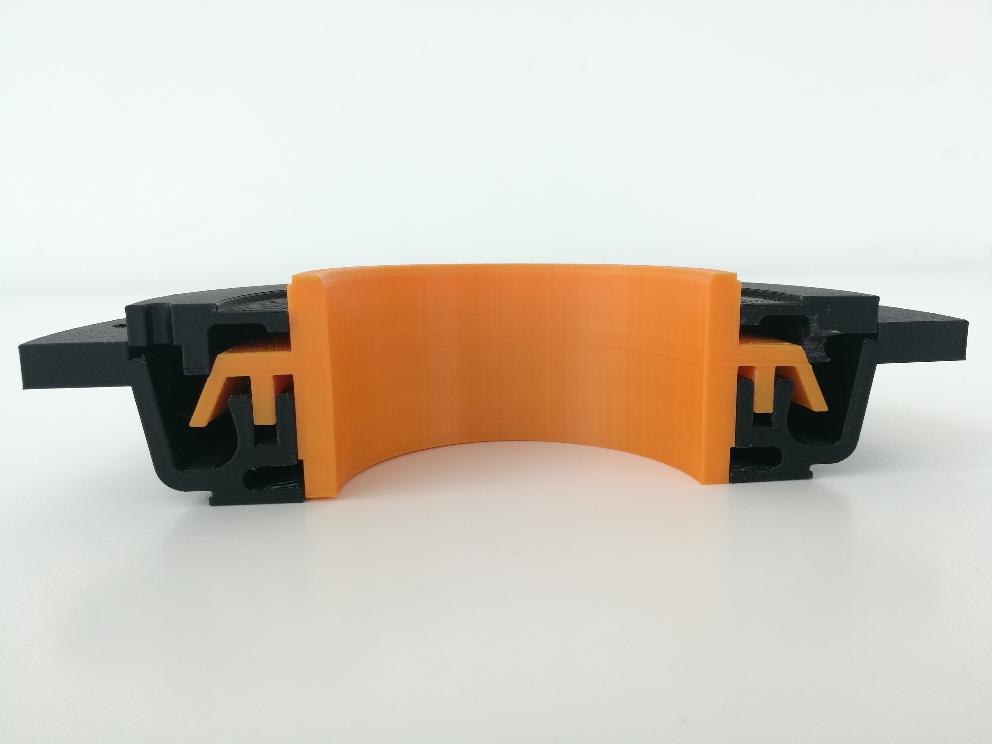
Dichtung3.jpg
