MattdewT/KE4/Dichtung.jpg

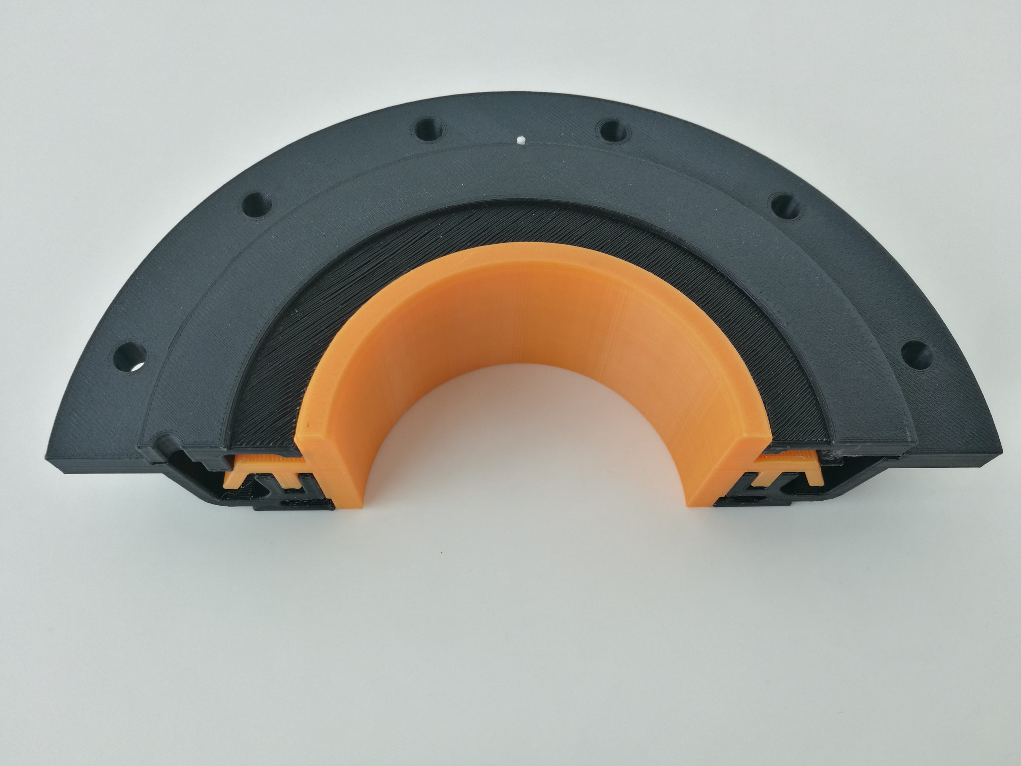
Dichtung.jpg
