MattdewT/KE4/Explosion.PNG

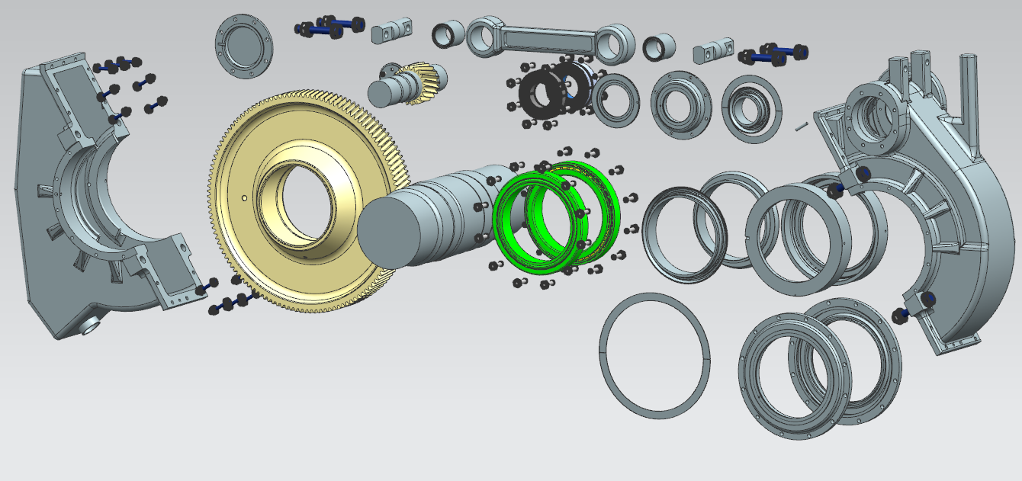
Explosion.PNG
