MattdewT/KE4/Explosion_grau.PNG

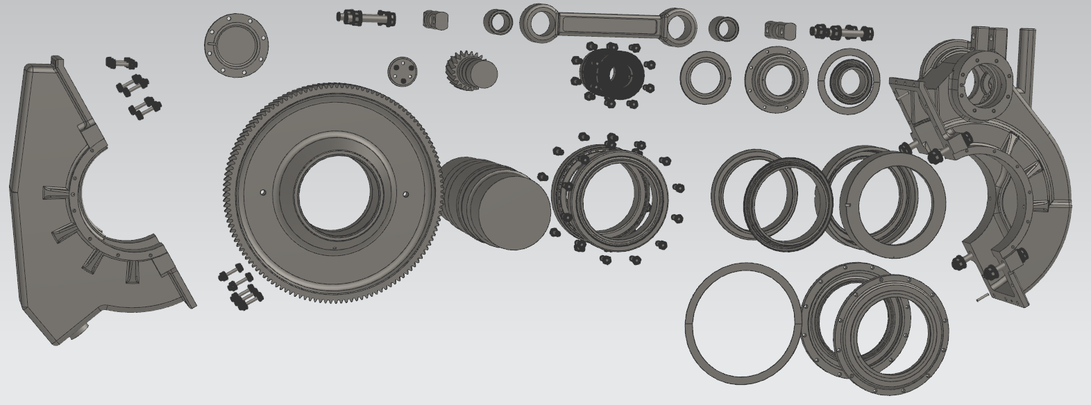
Explosion_grau.PNG
