MattdewT/KE4/Finale/CAD/Normteile/Timken_Lager_B-150223-A-EM.tif

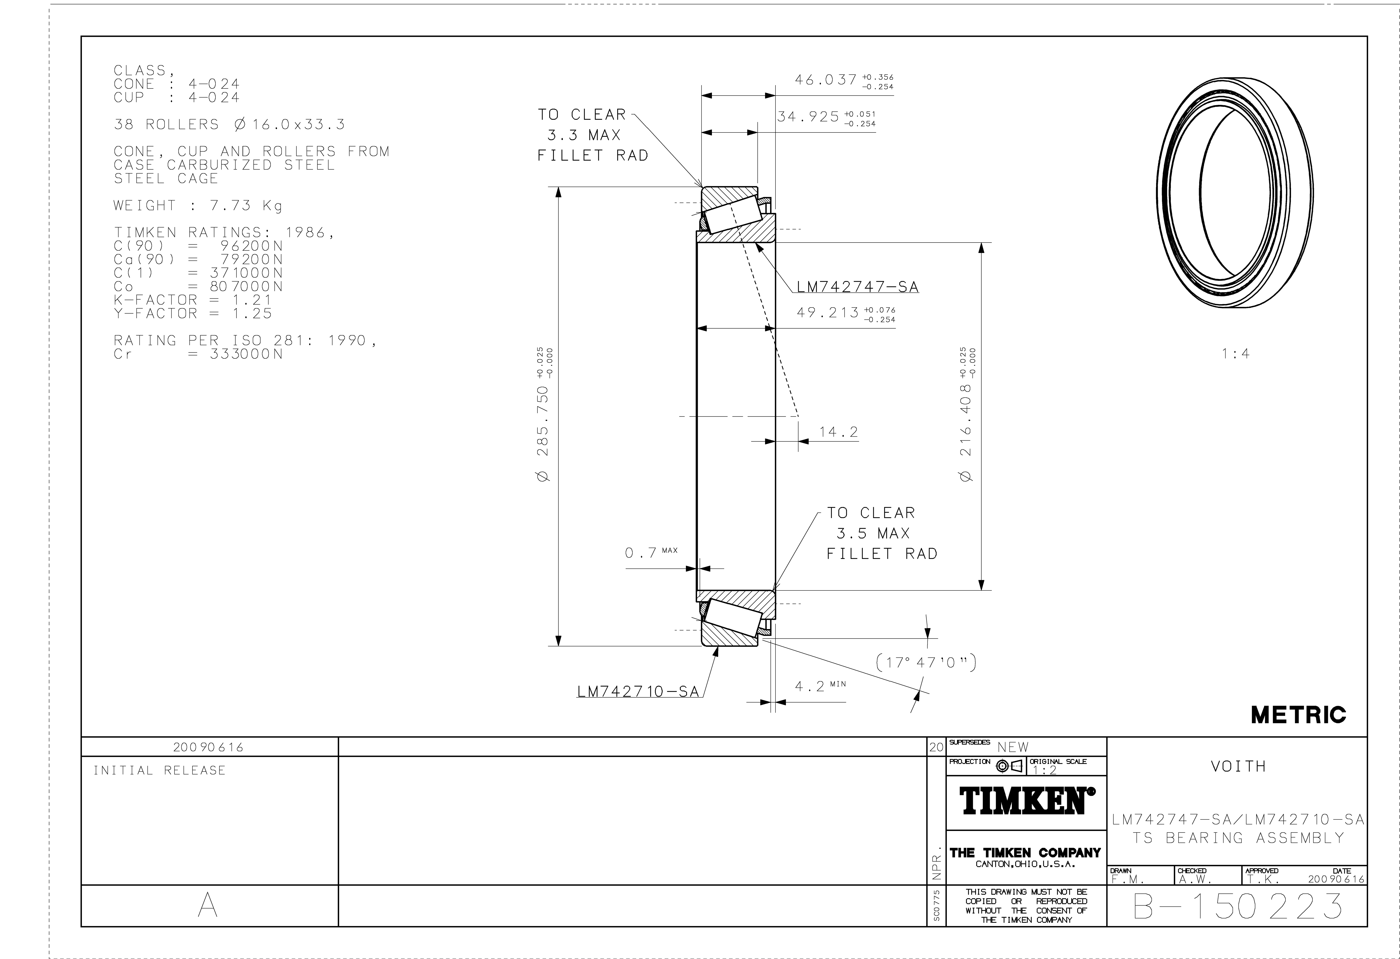
Finale/CAD/Normteile/Timken_Lager_B-150223-A-EM.tif
