MattdewT/KE4/IMG_20200114_105554.jpg

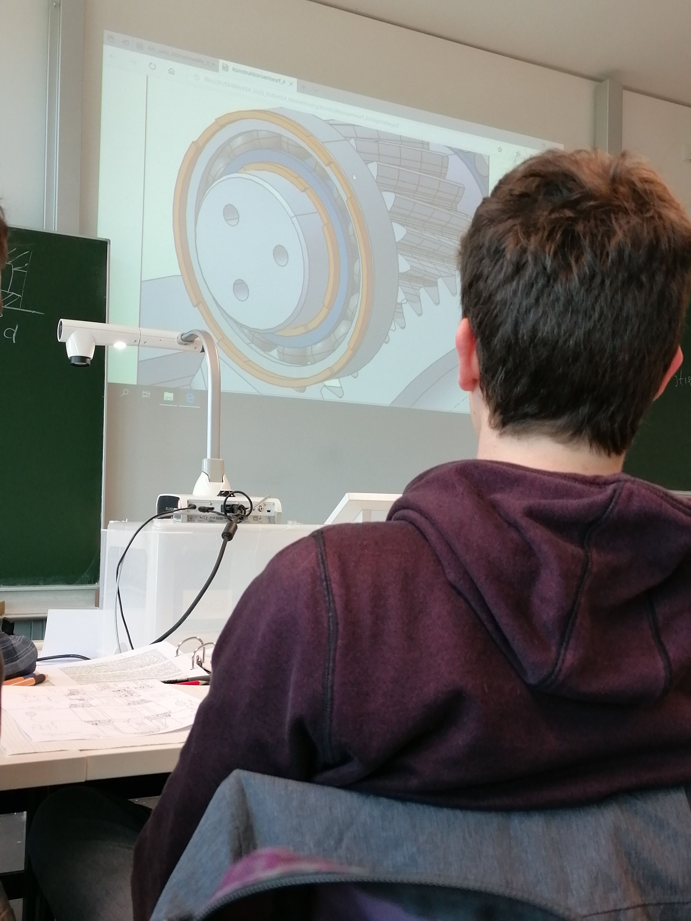
IMG_20200114_105554.jpg
