MattdewT/KE4/IMG_20200114_105631.jpg

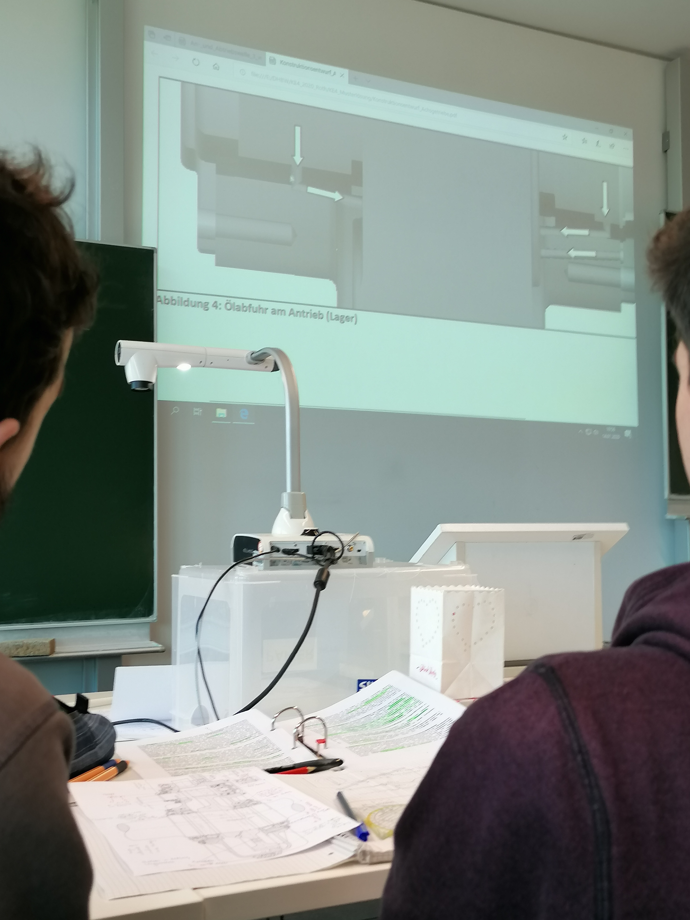
IMG_20200114_105631.jpg
