MattdewT/KE4/IMG_20200114_105721.jpg

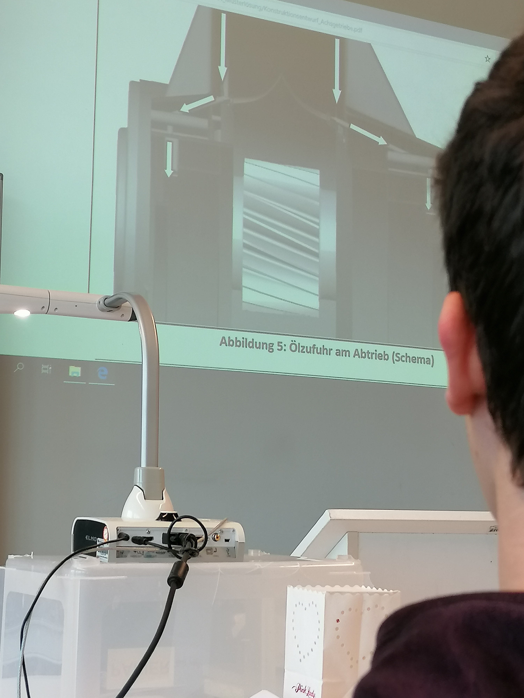
IMG_20200114_105721.jpg
