MattdewT/KE4/IMG_20200114_110013.jpg

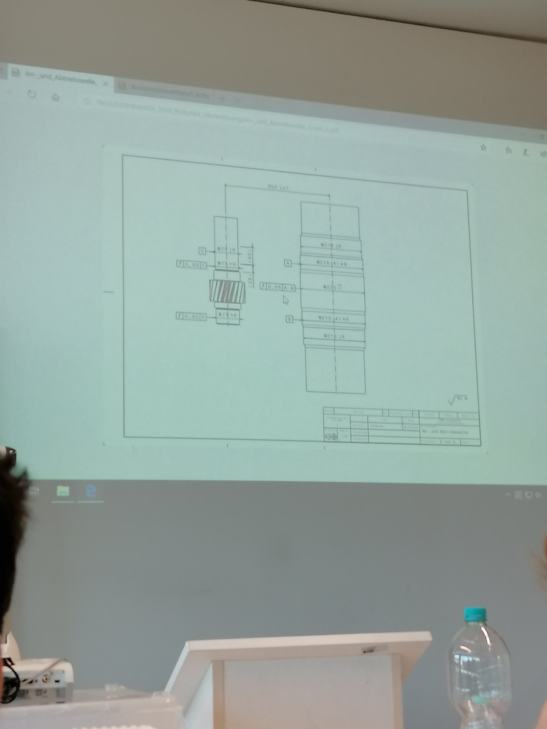
IMG_20200114_110013.jpg
