MattdewT/KE4/IMG_20200115_174602.jpg

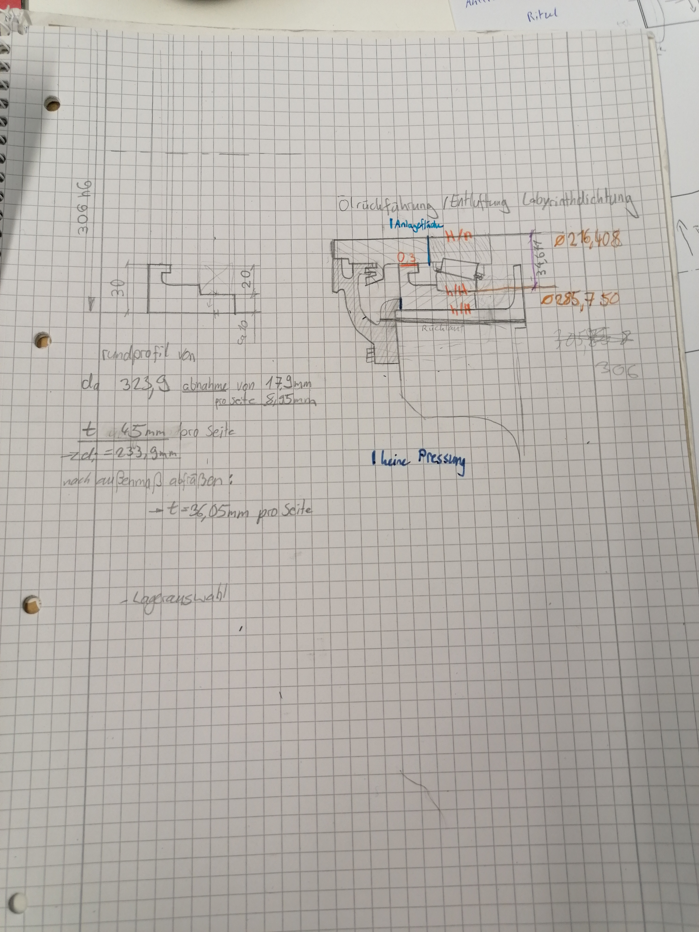
IMG_20200115_174602.jpg
