MattdewT/KE4/IMG_20200116_130543.jpg

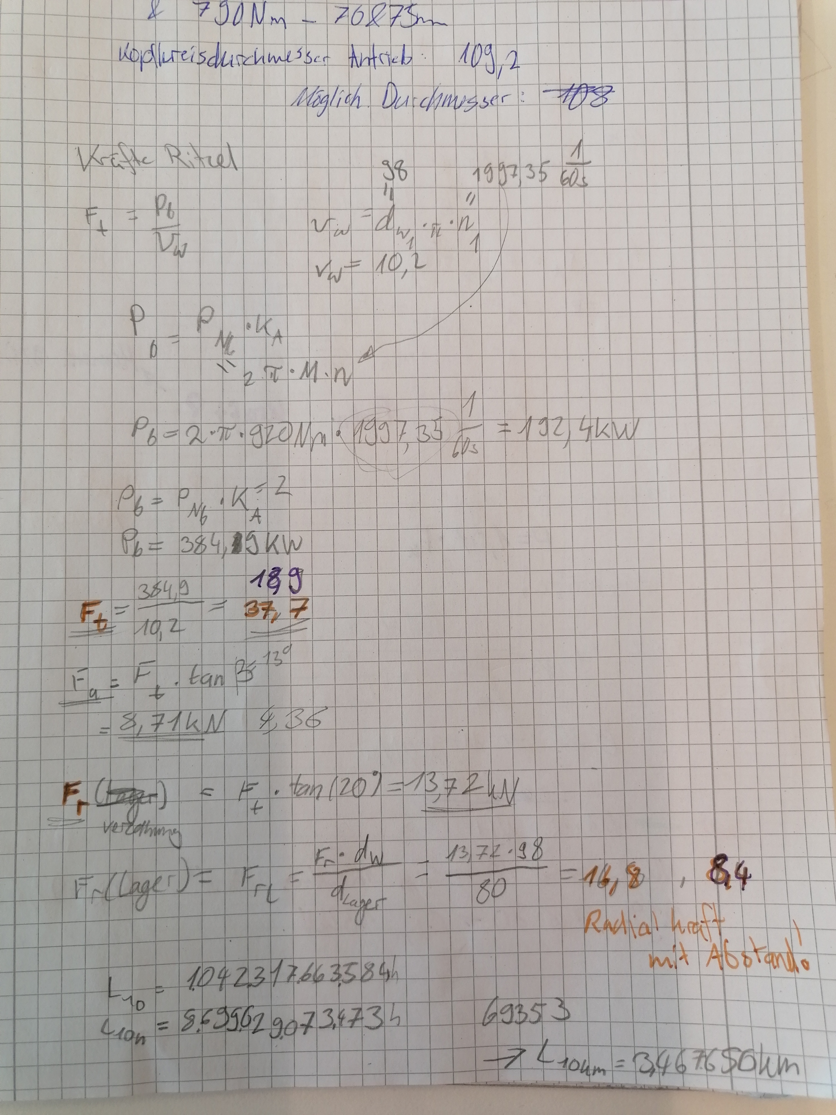
IMG_20200116_130543.jpg
