MattdewT/KE4/IMG_20200116_130552.jpg

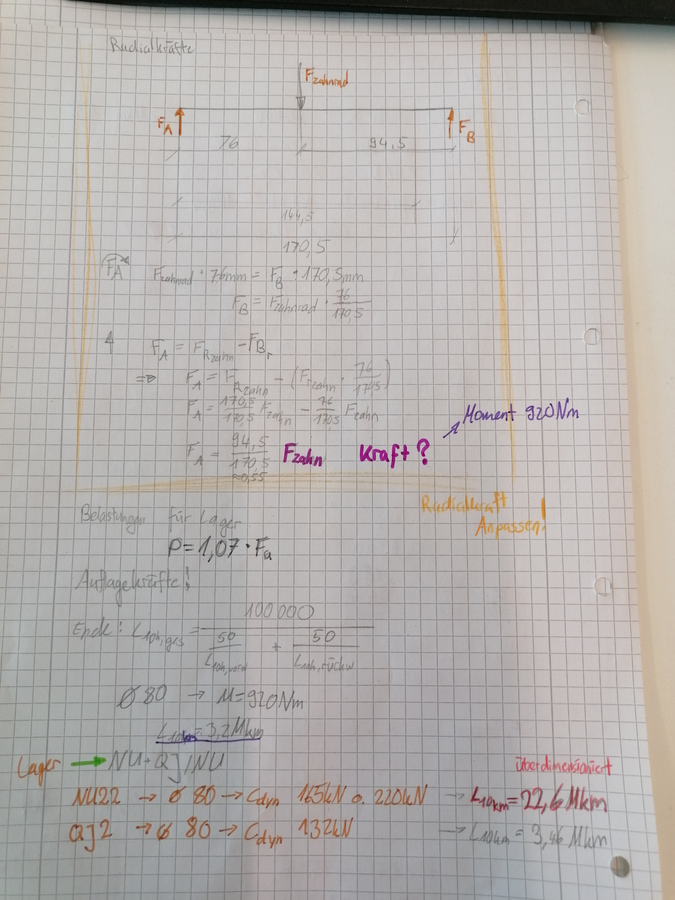
IMG_20200116_130552.jpg
