MattdewT/KE4/Schnittansicht mit Notizen (Tanja).jpg

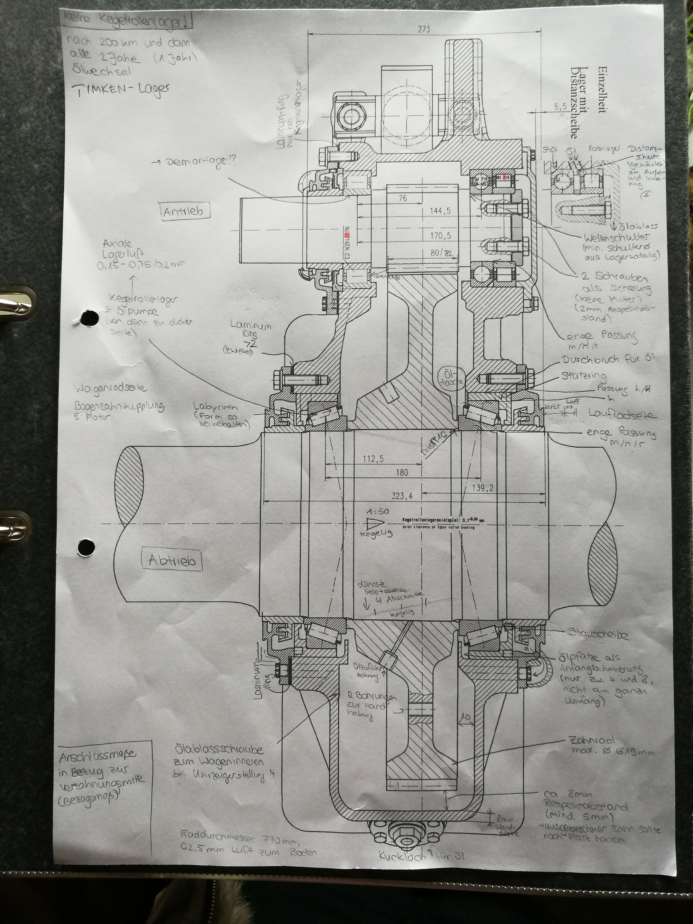
Schnittansicht mit Notizen (Tanja).jpg
