MattdewT/KE4/Stückliste12.03.pdf

1 | 2 | 3 | 4 | 5 | 6
Pos. | Menge | Einheit | Benennung | Sachnummer/Norm - Kurzbezeichnung | Bemerkung
1 | 1 | Stk. | Antriebswelle | Rund EN 20278 110 x Lager 3000 | 18CrNiMo7-6
2 | 1 | Stk. | Abtriebswelle | Rund EN 20278 220 x Lager 3000 | 18CrNiMo7-6
3 | 1 | Stk. | Abtriebsrad | Rund EN 20278 700 x 90 x 100 | 18CrNiMo7-6
4 | 1 | Stk. | Gehäuseoberteil | | EN-GJS-500-7
5 | 1 | Stk. | Gehäuseunterteil | | EN-GJS-500-7
6 | 1 | Stk. | Drehmomentstütze | Kaufteil nach Zeichnung
7 | 2 | Stk. | Kegelrollenlager | TIMKEN LM742710 / LM742747
8 | 1 | Stk. | Zylinderrollenlager | Schaeffler NU215-E-XL-TVP2 C
9 | 1 | Stk. | Zylinderrollenlager | Schaeffler NU2215-E-XL-TVP2 C
10 | 1 | Stk. | Vierpunktlager | Schaeffler QJ 215-XL-TVP C
11 | 1 | Stk. | Lagersicherung | Rund EN 20278 80 x 25 | 34CrS4
12 | 1 | Stk. | Deckel Antriebslager | Rund EN 20278 200 x 40 | 34CrS4
13 | 1 | Stk. | Labyrinthdichtung Antrieb Wellenseite | Rundes Hohlprofil DIN EN 10210-1 140 x 40 x 55 | 34CrS4
14 | 1 | Stk. | Labyrinthdichtung Antrieb Gehäuseseite | Rundes Hohlprofil DIN EN 10210-1 20 x 60 x 40 | 34CrS4
15 | 1 | Stk. | Labyrinthdichtung Abtrieb Wellen Radseite | Rundes Hohlprofil DIN EN 10210-1 280 x 40 x 60 | 34CrS4
16 | 1 | Stk. | Labyrinthdichtung Abtrieb Wellenseite | Rundes Hohlprofil DIN EN 10210-1 280 x 40 x 60 | 34CrS4
17 | 1 | Stk. | Labyrinthdichtung Abtrieb Gehäuse Radseite | Rundes Hohlprofil DIN EN 10210-1 360 x 70 x 40 | 34CrS4
18 | 1 | Stk. | Labyrinthdichtung Abtrieb Gehäuseseite Motorseite | Rundes Hohlprofil DIN EN 10210-1 360 x 70 x 40 | 34CrS4
19 | 1 | Stk. | Stützring Antrieb | Rundes Hohlprofil DIN EN 10210-1 160 x 30 x 20 | 34CrS4
20 | 2 | Stk. | Stützring Abtrieb | Rundes Hohlprofil DIN EN 10210-1 320 x 50 x 60 | 34CrS4
21 | 1 | Stk. | Distanzring | | 34CrS4
22 | 1 | Stk. | Distanzring | | 34CrS4
23 | 1 | Stk. | Laminumring Abtrieb | Stanzteil, Dicke 2,5 mm
24 | 1 | Stk. | Ölschauglas | | von Ganter
25 | 1 | Stk. | Magnetstopfen | | von Ganter
26 | 1 | Stk. | Einfülldeckel | M60 | von Ganter
27 | 1 | Stk. | Entlüftungsschraube | M20
28 | 2 | Stk. | Sicherungsstift | ISO 2338 - 8 m6 x 40

1 | 2 | 3 | 4 | 5 | 6
Pos. | Menge | Einheit | Benennung | Sachnummer/Norm - Kurzbezeichnung | Bemerkung
29 | 5 | Stk. | Sicherungsstift | ISO 2338 - 3 h8 x 8
30 | 3 | Stk. | Sechskantschraube | ISO 4014 - M8 x 20 - 8.8 | Lagersicherung
31 | 40 | Stk. | Sechskantschraube | ISO 4014 - M10 x 40 - 8.8 | Deckel
32 | 12 | Stk. | Sechskantschraube | ISO 4014 - M10 x 60 - 8.8 | Gehäuseteilung
33 | 8 | Stk. | Sechskantschraube | ISO 4014 - M20 x 120 - 10.9 | Drehmomentstütze, Ankerschrauben
34 | 12 | Stk. | Sechskantmutter | ISO 4033 - M10 - 8
35 | 8 | Stk | Sechskantmutter | ISO 4033 - M20 - 10
36 | 24 | Stk | Unterlegscheibe | ISO 7089 - 10 - 200 HV
37 | 16 | Stk | Unterlegscheibe | ISO 7089 - 20 - 300 HV
38 | 1 | Stk. | Bogenzahnkupplung | von KWD

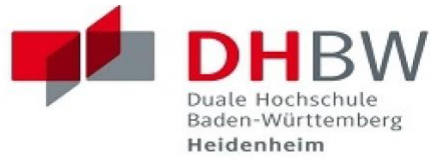
[picture p172: figure]

| Datum | Name
| | | | Bearb. | 01.03.2020 | Anika Langohr
| | | | Gepr. | 02.03.2020 | Marie Hopf
| | | | Norm. | 02.03.2020 | Tanja Hofmann
