MattdewT/KE4/Blender/fluid_gehause/Gehäuse_v2.stl

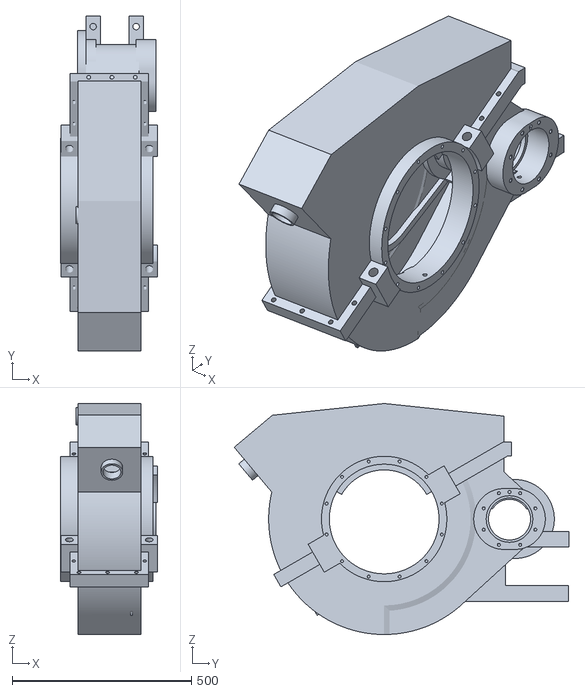
[picture p173: CAD file, 2020-03-05]
Blender/fluid_gehause/Gehäuse_v2.stl
271.5 x 934.2 x 645.0
