MattdewT/KE4/Finale/CAD/Normteile/Timken_Lager_B-150223_214.stp

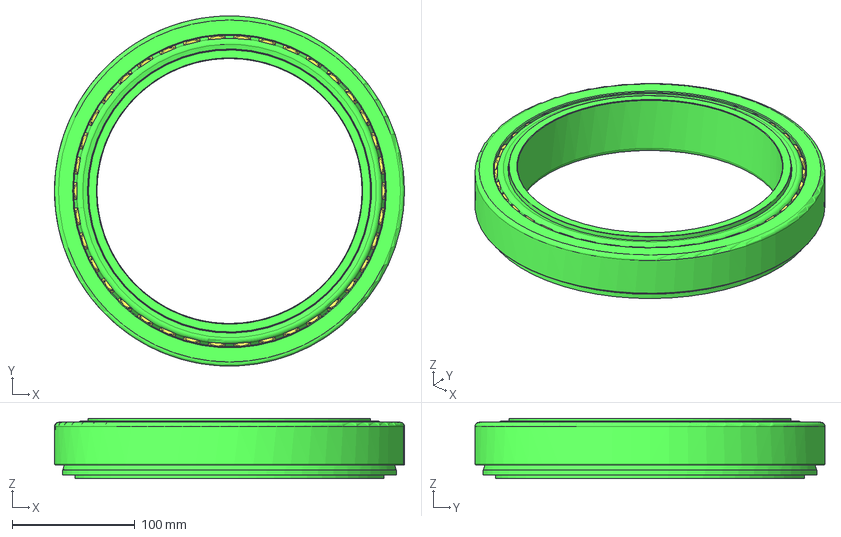
[picture p174: CAD file, 2020-01-16]
Finale/CAD/Normteile/Timken_Lager_B-150223_214.stp
285.8 x 285.7 x 49.2 mm
USM-44192_A x 38
USM-44190_A
USM-44191_A
USM-44189_A
