MattdewT/KE4/Blender/fluid_gehause/Gehäuse_v2_bk.stl

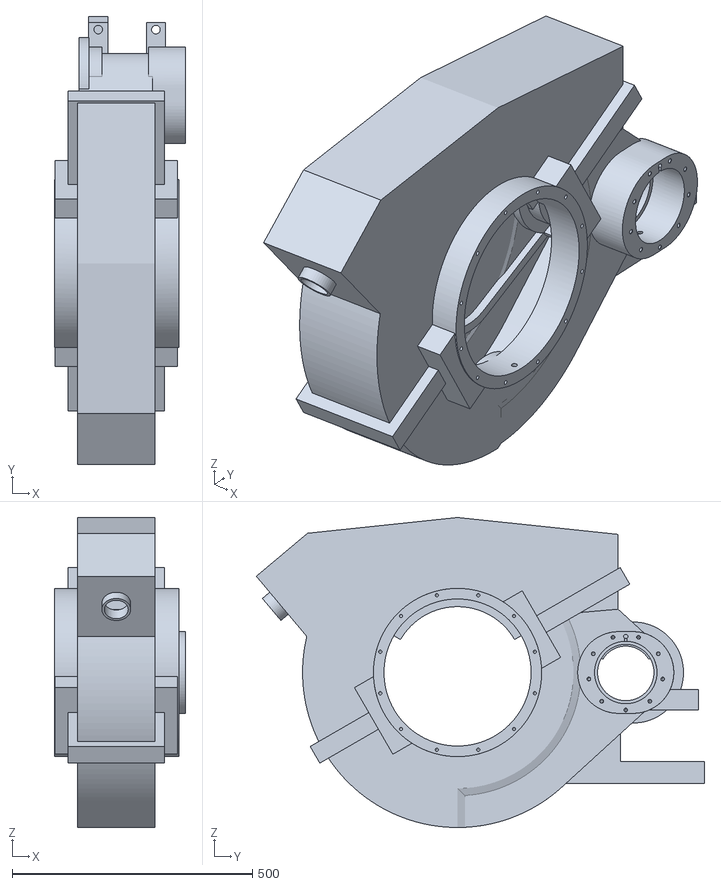
[picture p175: CAD file, 2020-03-05]
Blender/fluid_gehause/Gehäuse_v2_bk.stl
273.5 x 932.9 x 645.0
