MattdewT/KE4/(list of files, cad)

Other CAD files:
ALT_KE/TM2018/Pascal/KE4/1.prt
ALT_KE/TM2018/Pascal/KE4/2.prt
ALT_KE/TM2018/Pascal/KE4/Abtriebswelle.prt
ALT_KE/TM2018/Pascal/KE4/Abziehblech.prt
ALT_KE/TM2018/Pascal/KE4/Abziehblech_Ritzelwelle.prt
ALT_KE/TM2018/Pascal/KE4/Deckel_Ritzelwelle.prt
ALT_KE/TM2018/Pascal/KE4/Distanzring_außen.prt
ALT_KE/TM2018/Pascal/KE4/Distanzring_innen.prt
ALT_KE/TM2018/Pascal/KE4/Drehmomentstütze.prt
ALT_KE/TM2018/Pascal/KE4/Drehmomentstütze_Unterteil.prt
ALT_KE/TM2018/Pascal/KE4/Hundeknochen.prt
ALT_KE/TM2018/Pascal/KE4/Hundeknochen_Puffer.prt
ALT_KE/TM2018/Pascal/KE4/Hülse_Kegelrollenlager - Kopie.prt
ALT_KE/TM2018/Pascal/KE4/Hülse_Kegelrollenlager.prt
ALT_KE/TM2018/Pascal/KE4/KLemmring_Ritzelwelle.prt
ALT_KE/TM2018/Pascal/KE4/LM742747-LM742710-TheTimkenCompany-01-31-2019_stp.prt
ALT_KE/TM2018/Pascal/KE4/Labyrinthdichtung_Abtriebswelle_Gehäuse.prt
ALT_KE/TM2018/Pascal/KE4/Labyrinthdichtung_Abtriebswelle_Gehäuse_Blech.prt
ALT_KE/TM2018/Pascal/KE4/Labyrinthdichtung_Abtriebswelle_Welle.prt
ALT_KE/TM2018/Pascal/KE4/Labyrinthdichtung_Ritzelwelle.prt
ALT_KE/TM2018/Pascal/KE4/Labyrinthdichtung_Ritzelwelle_GEhäuse.prt
ALT_KE/TM2018/Pascal/KE4/Müllerrad.prt
ALT_KE/TM2018/Pascal/KE4/O-Ring 125x4.prt
ALT_KE/TM2018/Pascal/KE4/O-Ring_d_132.prt
ALT_KE/TM2018/Pascal/KE4/O-Ring_d_302.prt
ALT_KE/TM2018/Pascal/KE4/PRODUCT_ID_1.prt
ALT_KE/TM2018/Pascal/KE4/PRODUCT_ID_2.prt
ALT_KE/TM2018/Pascal/KE4/PRODUCT_ID_3.prt
ALT_KE/TM2018/Pascal/KE4/PRODUCT_ID_4.prt
ALT_KE/TM2018/Pascal/KE4/Ritzelwelle.prt
ALT_KE/TM2018/Pascal/KE4/Spannplatte_Ritzelwelle.prt
ALT_KE/TM2018/Pascal/KE4/dichtschraube_din_908-st-m22x1_5-ac_stp.prt
ALT_KE/TM2018/Pascal/KE4/einfüllschraube_m33x1_5_gn_37877_stp.prt
ALT_KE/TM2018/Pascal/KE4/ganter_gn_738-32-m27x1_5_stp.prt
ALT_KE/TM2018/Pascal/KE4/ganter_gn_743_2-24-m33x1_5-a_gn_743_2-11-m16_7x1_5-a_322yvmn9d2f33senosnj8ea85_stp.prt
ALT_KE/TM2018/Pascal/KE4/gewindeeinsatz_m10_m14_1.5_iv_7_100_180_m140_a_0_stp.prt
ALT_KE/TM2018/Pascal/KE4/inafag_n215-e-xl-tvp2_4ocma8l7ubj6fugbtu446gpf4_1.prt
ALT_KE/TM2018/Pascal/KE4/inafag_n215-e-xl-tvp2_4ocma8l7ubj6fugbtu446gpf4_2.prt
ALT_KE/TM2018/Pascal/KE4/inafag_n215-e-xl-tvp2_4ocma8l7ubj6fugbtu446gpf4_3.prt
ALT_KE/TM2018/Pascal/KE4/inafag_n215-e-xl-tvp2_4ocma8l7ubj6fugbtu446gpf4_4.prt
ALT_KE/TM2018/Pascal/KE4/inafag_n215-e-xl-tvp2_4ocma8l7ubj6fugbtu446gpf4_5.prt
ALT_KE/TM2018/Pascal/KE4/inafag_n215-e-xl-tvp2_4ocma8l7ubj6fugbtu446gpf4_6.prt
ALT_KE/TM2018/Pascal/KE4/inafag_n215-e-xl-tvp2_4ocma8l7ubj6fugbtu446gpf4_7.prt
ALT_KE/TM2018/Pascal/KE4/inafag_n215-e-xl-tvp2_4ocma8l7ubj6fugbtu446gpf4_stp.prt
ALT_KE/TM2018/Pascal/KE4/inafag_qj215-xl-tvp_emmwtlkpq0tqy2igbt8uikl7u_1.prt
ALT_KE/TM2018/Pascal/KE4/inafag_qj215-xl-tvp_emmwtlkpq0tqy2igbt8uikl7u_10.prt
ALT_KE/TM2018/Pascal/KE4/inafag_qj215-xl-tvp_emmwtlkpq0tqy2igbt8uikl7u_11.prt
ALT_KE/TM2018/Pascal/KE4/inafag_qj215-xl-tvp_emmwtlkpq0tqy2igbt8uikl7u_12.prt
ALT_KE/TM2018/Pascal/KE4/inafag_qj215-xl-tvp_emmwtlkpq0tqy2igbt8uikl7u_13.prt
ALT_KE/TM2018/Pascal/KE4/inafag_qj215-xl-tvp_emmwtlkpq0tqy2igbt8uikl7u_14.prt
ALT_KE/TM2018/Pascal/KE4/inafag_qj215-xl-tvp_emmwtlkpq0tqy2igbt8uikl7u_15.prt
ALT_KE/TM2018/Pascal/KE4/inafag_qj215-xl-tvp_emmwtlkpq0tqy2igbt8uikl7u_16.prt
ALT_KE/TM2018/Pascal/KE4/inafag_qj215-xl-tvp_emmwtlkpq0tqy2igbt8uikl7u_17.prt
ALT_KE/TM2018/Pascal/KE4/inafag_qj215-xl-tvp_emmwtlkpq0tqy2igbt8uikl7u_18.prt
ALT_KE/TM2018/Pascal/KE4/inafag_qj215-xl-tvp_emmwtlkpq0tqy2igbt8uikl7u_19.prt
ALT_KE/TM2018/Pascal/KE4/inafag_qj215-xl-tvp_emmwtlkpq0tqy2igbt8uikl7u_2.prt
ALT_KE/TM2018/Pascal/KE4/inafag_qj215-xl-tvp_emmwtlkpq0tqy2igbt8uikl7u_3.prt
ALT_KE/TM2018/Pascal/KE4/inafag_qj215-xl-tvp_emmwtlkpq0tqy2igbt8uikl7u_4.prt
ALT_KE/TM2018/Pascal/KE4/inafag_qj215-xl-tvp_emmwtlkpq0tqy2igbt8uikl7u_5.prt
ALT_KE/TM2018/Pascal/KE4/inafag_qj215-xl-tvp_emmwtlkpq0tqy2igbt8uikl7u_6.prt
ALT_KE/TM2018/Pascal/KE4/inafag_qj215-xl-tvp_emmwtlkpq0tqy2igbt8uikl7u_7.prt
ALT_KE/TM2018/Pascal/KE4/inafag_qj215-xl-tvp_emmwtlkpq0tqy2igbt8uikl7u_8.prt
ALT_KE/TM2018/Pascal/KE4/inafag_qj215-xl-tvp_emmwtlkpq0tqy2igbt8uikl7u_9.prt
ALT_KE/TM2018/Pascal/KE4/inafag_qj215-xl-tvp_emmwtlkpq0tqy2igbt8uikl7u_stp.prt
ALT_KE/TM2018/Pascal/KE4/mutter_iso_4032-m10-10_stp.prt
ALT_KE/TM2018/Pascal/KE4/mutter_iso_4032-m16-10_stp.prt
ALT_KE/TM2018/Pascal/KE4/schraube_iso_4014-m10x45-10_9_stp.prt
ALT_KE/TM2018/Pascal/KE4/schraube_iso_4014-m10x55-10_9_stp.prt
ALT_KE/TM2018/Pascal/KE4/schraube_iso_4014-m16x110-10_9_stp.prt
ALT_KE/TM2018/Pascal/KE4/schraube_iso_4014-m16x200-10.9_stp.prt
ALT_KE/TM2018/Pascal/KE4/schraube_iso_4014-m6x30-10_9_stp.prt
ALT_KE/TM2018/Pascal/KE4/stift_iso_8734_10_x_40_c1_0_stp.prt
ALT_KE/TM2018/Pascal/KE4/stift_iso_8734_5_x_22_c1_0_stp.prt
ALT_KE/TM2018/Pascal/KE4/unterlegscheibe_iso_7089-10-300_hv_stp.prt
ALT_KE/TM2018/Pascal/KE4/unterlegscheibe_iso_7089-16-300_hv_stp.prt
ALT_KE/TM2018/Pascal/KE4/unterlegscheibe_iso_7089-6-300_hv_stp.prt
Blender/fluid_gehause/fluid_gehäuse.blend
CAD/Finale Baugruppe/BGR_Schienenfahrzeugachsgetriebe.prt
CAD/Finale Baugruppe/Explosion.prt
CAD/Finale Baugruppe/mirror_Gehäuse_v2_oben.prt
CAD/Gehäuse_Idee_Anika.prt
CAD/Gehäuse_v2.prt
CAD/Modul_4_5/Baugruppe_SFAG.prt
CAD/Modul_4_5/Gehäuse.prt
CAD/Modul_4_5/System.prt
CAD/Modul_4_5/Zanhrad.prt
CAD/Modul_5/Ritzel_Z19_KD110_4_B82_M5.prt
CAD/Zeichnungen/Gesamt/Baugruppe_SFAG_dwg1.prt
CAD/Zeichnungen/Labyrinth/Antrieb_Dichtungen_dwg.prt
CAD/Zeichnungen/Zahnrad/Zahnrad_dwg1.prt
CAD/Zeichnungen/Öllauf/Öllauf_dwg.prt
CAD_mirror_geteilt/Gehause/gehause_zusammenbau.prt
CAD_mirror_geteilt/Gehause/mirror_Gehäuse_v2_oben.prt
CAD_mirror_geteilt/mirror_Axiallager_qj215-xl-tvp_x_t.prt
CAD_mirror_geteilt/mirror_Bolzen 8x40.prt
CAD_mirror_geteilt/mirror_Bolzen 8x40_0.prt
CAD_mirror_geteilt/mirror_Bolzen Drehmomentstütze.prt
CAD_mirror_geteilt/mirror_Bolzen Drehmomentstütze_0.prt
CAD_mirror_geteilt/mirror_Deckel_Antrieb.prt
CAD_mirror_geteilt/mirror_Distanzring_Antrieb_innen.prt
CAD_mirror_geteilt/mirror_Distanzring_mitNuten.prt
CAD_mirror_geteilt/mirror_Drehmomentstütze.prt
CAD_mirror_geteilt/mirror_Drehmomentstütze_BG.prt
CAD_mirror_geteilt/mirror_Gehäuse_v2_oben.prt
CAD_mirror_geteilt/mirror_Gehäuse_v2_unten.prt
CAD_mirror_geteilt/mirror_Labyrinthdichtung_Antrieb_Gegenstueck_links.prt
CAD_mirror_geteilt/mirror_Labyrinthdichtung_Antrieb_Wellenseite_links.prt
CAD_mirror_geteilt/mirror_Labyrinthdichtung_Rad_Gegenstueck_links.prt
CAD_mirror_geteilt/mirror_Labyrinthdichtung_Rad_Gegenstueck_links_0.prt
CAD_mirror_geteilt/mirror_Labyrinthdichtung_Rad_Wellenseite_links.prt
CAD_mirror_geteilt/mirror_Labyrinthdichtung_Rad_Wellenseite_links_0.prt
CAD_mirror_geteilt/mirror_Lagersicherung.prt
CAD_mirror_geteilt/mirror_Lagersicherung_Schraube.prt
CAD_mirror_geteilt/mirror_Lagersicherung_Schraube_0.prt
CAD_mirror_geteilt/mirror_Lagersicherung_Schraube_1.prt
CAD_mirror_geteilt/mirror_Laminumring_Abtrieb.prt
CAD_mirror_geteilt/mirror_Laminumring_Antrieb.prt
CAD_mirror_geteilt/mirror_Mutter_M10.prt
CAD_mirror_geteilt/mirror_Mutter_M10_0.prt
CAD_mirror_geteilt/mirror_Mutter_M10_1.prt
CAD_mirror_geteilt/mirror_Mutter_M10_10.prt
CAD_mirror_geteilt/mirror_Mutter_M10_2.prt
CAD_mirror_geteilt/mirror_Mutter_M10_3.prt
CAD_mirror_geteilt/mirror_Mutter_M10_4.prt
CAD_mirror_geteilt/mirror_Mutter_M10_5.prt
CAD_mirror_geteilt/mirror_Mutter_M10_6.prt
CAD_mirror_geteilt/mirror_Mutter_M10_7.prt
CAD_mirror_geteilt/mirror_Mutter_M10_8.prt
CAD_mirror_geteilt/mirror_Mutter_M10_9.prt
CAD_mirror_geteilt/mirror_Mutter_M20.prt
CAD_mirror_geteilt/mirror_Mutter_M20_0.prt
CAD_mirror_geteilt/mirror_Mutter_M20_1.prt
CAD_mirror_geteilt/mirror_Mutter_M20_2.prt
CAD_mirror_geteilt/mirror_Mutter_M20_3.prt
CAD_mirror_geteilt/mirror_Mutter_M20_4.prt
CAD_mirror_geteilt/mirror_Mutter_M20_5.prt
CAD_mirror_geteilt/mirror_Mutter_M20_6.prt
CAD_mirror_geteilt/mirror_NU215.prt
CAD_mirror_geteilt/mirror_NU2215-E-XL-TVP2_01_id30_x_t.prt
CAD_mirror_geteilt/mirror_NU2215-E-XL-TVP2_02_id26_x_t.prt
CAD_mirror_geteilt/mirror_NU2215-E-XL-TVP2_03_id22_x_t.prt
CAD_mirror_geteilt/mirror_NU2215-E-XL-TVP2_04_id18_x_t.prt
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
