MattdewT/KE4/Montage Anleitung.docx

Montageanleitung

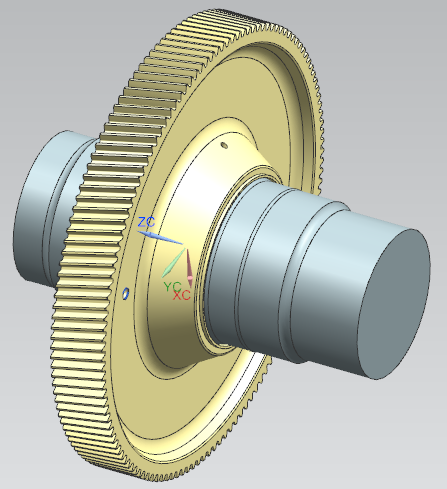
[picture p176: figure]

1. Überprüfen Sie den Lieferumfang mit Hilfe der Stückliste. 2. Erhitzen Sie das Zahnrad auf 190°C/463,15K. Die Abtriebswelle soll auf 74,35°C/198,8K gekühlt werden. Bei diesen Temperaturen können Zahnrad und Welle gefügt werden. Das Zahnrad muss auf den Wellendurchmesser 217mm angebracht werden. Lassen Sie das Bauteil nun auskühlen.

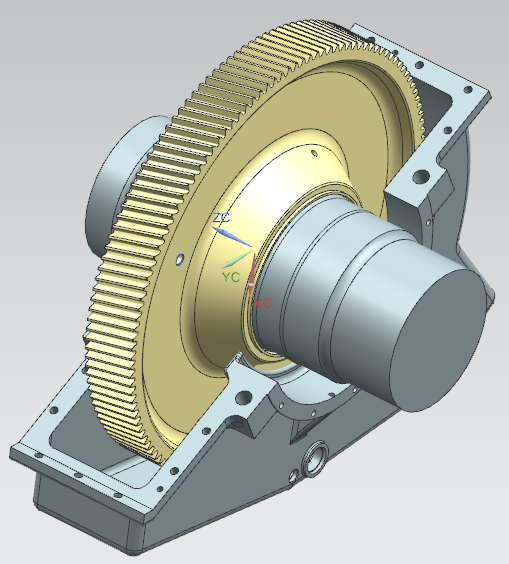
[picture p177: figure]

3. Legen Sie nun die Abtriebswelle mit aufgepresstem Zahnrad in die dafür vorgesehene Gehäuseöffnung wie im nebenstehenden Bild zu sehen.

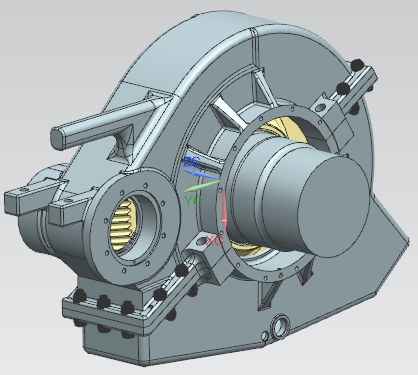
[picture p178: figure]
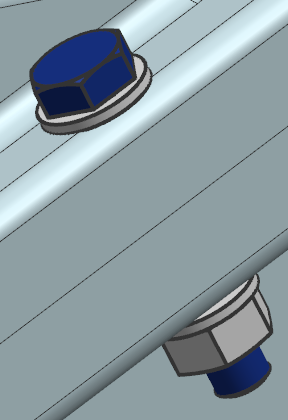
[picture p179: figure]

4. Legen Sie die obere Gehäusehälfte auf die Untere. Stecken Sie die zwei Sicherungsstifte in die Bohrungen am Gehäuseflansch. Schrauben Sie danach die zwölf M10x60 Flanschschrauben in das Gehäuse indem Sie auf jede Schraube eine Unterlegscheibe stecken und diese dann durch die Bohrungen im Gehäuse. Stecken Sie von unten wieder eine Unterlegscheibe auf die Schraube und eine M10 Mutter. Ziehen Sie diese mit einem Anziehdrehmoment von 32 Nm fest.

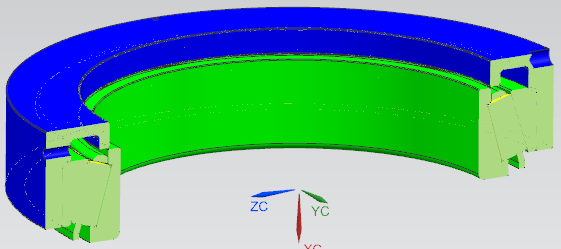
[picture p180: figure]

5. Stecken Sie jeweils die Stützringe auf die TIMKEN Lager.

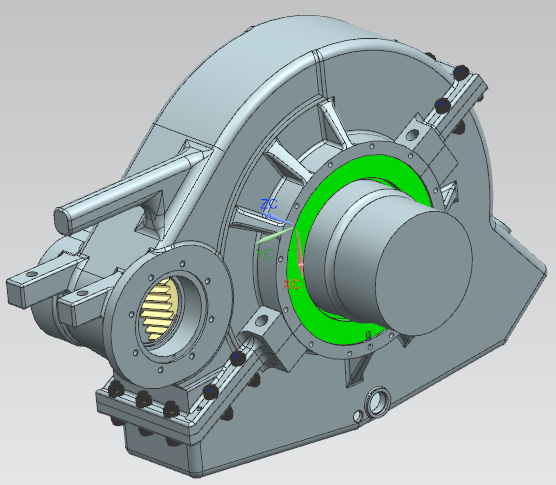
[picture p181: figure]

6. Nun können die Stützringe mit dem Lager auf die Abtriebswelle mit Hilfe einer geeigneten Vorrichtung angebracht werden. Die Kugellager sollen bis zum Gehäuseanschlag eingeschoben werden. Achten Sie bei den Stützringen darauf, dass die Ölzulaufbohrung nach oben zeigt. Stecken Sie die Stifte in die vorgesehenen Bohrungen auf die Stützringe.

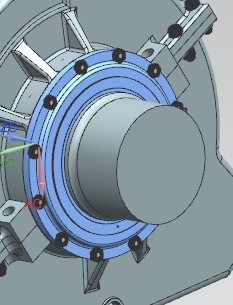
[picture p182: figure]
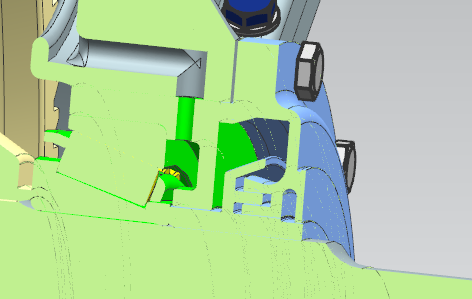
[picture p183: figure]

7. Die Dichtung wird montiert, indem man zuerst die Labyrinthdichtung (Wellenseite) auf den Durchmesser 75mm schiebt. Das Gegenstück der Labyrinthdichtung wird daraufhin mit zwölf M10x40 Schrauben montiert. Zwischen Dichtung und Gehäuse müssen die Laminumringe miteingeschraubt werden.

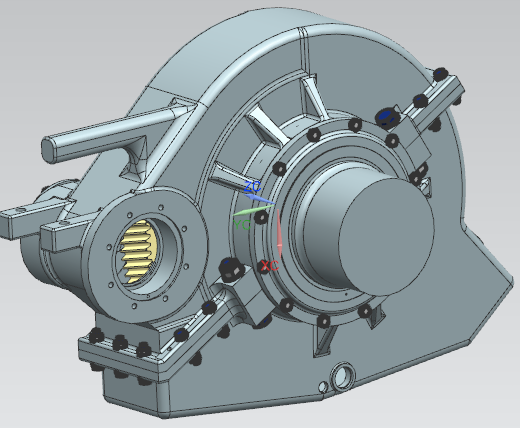
[picture p184: figure]

8. Schrauben Sie die vier M20x120 Ankerschrauben in das Gehäuse. Befestigen Sie diese mit den dafür vorgesehenen Muttern. Verwenden Sie oben und unten Unterlegscheiben.

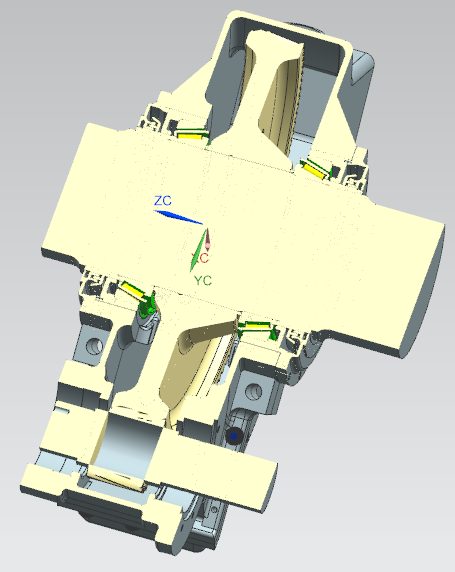
[picture p185: figure]

9. Schieben Sie die Antriebswelle in die im Gehäuse vorgesehene Öffnung.

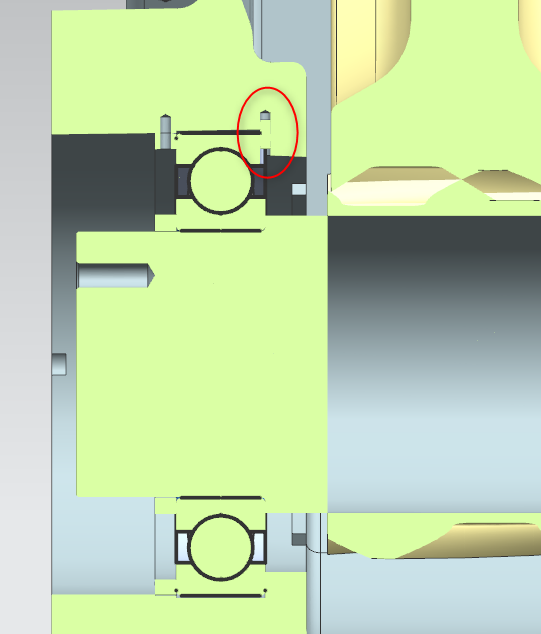
[picture p186: figure]

10. Um die Welle auszurichten pressen Sie das Axiallager auf das kurze Ende der Welle auf, bis es am Gehäuseabsatz anschlägt. Der vorher in die Gehäusenut eingelegte Sicherungsstift soll in die Nut des Außenringes des Axiallagers passen und als Verdrehsicherung für denselben dienen.

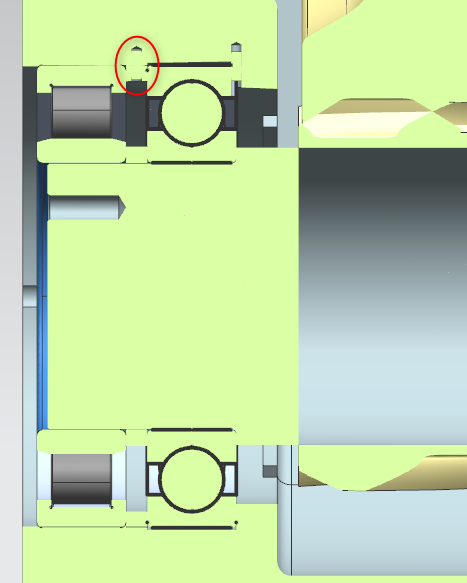
[picture p187: figure]

11. Bevor Sie das Zylinderrollenlager NU215 einbauen, muss der Distanzring auf das Axiallager gebracht werden. Achten Sie darauf, dass die Nuten in Richtung Axiallager und nach oben zeigen, um den Ölfluss zu gewährleisten. Die Lage des Distanzringes wird durch einen Sicherungsstift sichergestellt, den Sie nach der Platzierung des Distanzringes in die dafür vorgesehene Bohrung stecken.

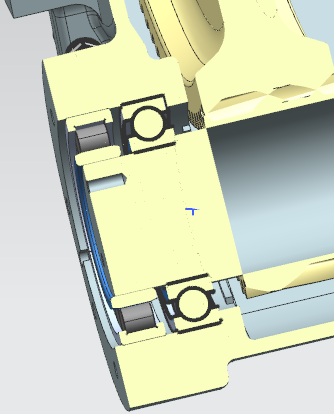
[picture p188: figure]

12. Das Zylinderrollenlager NU215 kann nun, wie im Bild zu sehen ist, eingebaut werden.

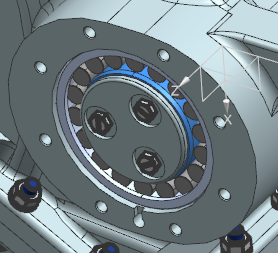
[picture p189: figure]

13. Schrauben Sie mit drei M8x20 Schrauben die Lagersicherung auf die Antriebswelle fest. Ziehen Sie die Schrauben mit einem Anziehdrehmoment von 32 Nm fest.

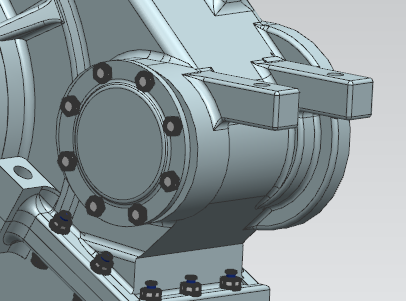
[picture p190: figure]

14. Schrauben Sie den Deckel der Antriebswelle mit acht M10x40 Schrauben mit einem Anziehdrehmoment von 32 Nm fest.

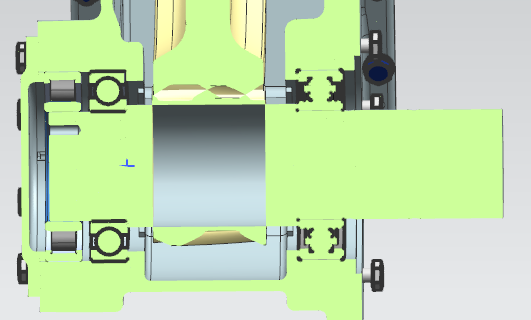
[picture p191: figure]

15. Das Lager NU2215 wird auf der anderen Seite des Ritzels aufgepresst. Genau wie das Axiallager muss es innen am Gehäuse anschlagen.

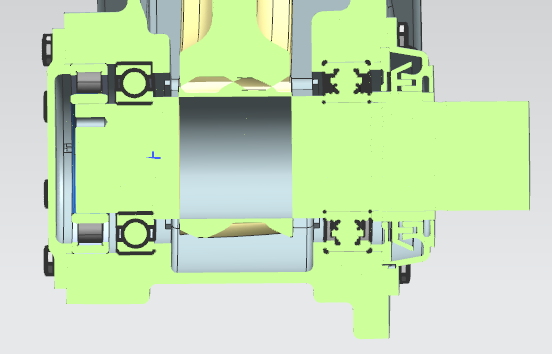
[picture p192: figure]

16. Montieren Sie auf die Antriebswelle auf die Seite des eben eingebauten Lagers die Dichtung. Gehen Sie dabei vor, wie bei der Montage der Dichtung auf der Abtriebswelle.

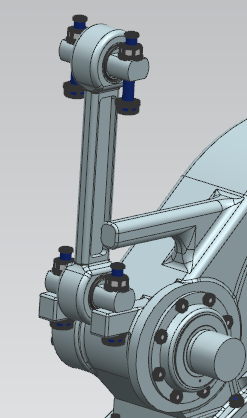
[picture p193: figure]

17. Nach dem Einbau wird die Drehmomentstütze angeschraubt. Hierzu verwenden Sie die M20x120 Schrauben. Stecken Sie die Schrauben durch die Bolzen und die Anbindung der Drehmomentstütze. Befestigen Sie diese mit den dafür vorgesehenen Muttern. Verwenden Sie oben und unten Unterlegscheiben.
18. Das Ölschauglas wird von Hand angedrückt, eventuell mit Hilfe einer Zwischenlage mit dem Hammer eingeschlagen.
19. Neben dem Ölschauglas wird ein Magnetstopfen eingeschraubt.

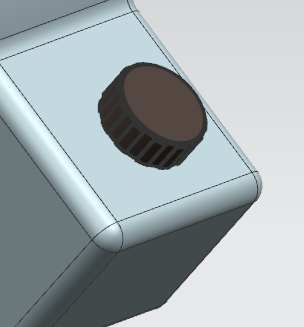
[picture p194: figure]

20. Schrauben Sie den Öleinflussdeckel an.

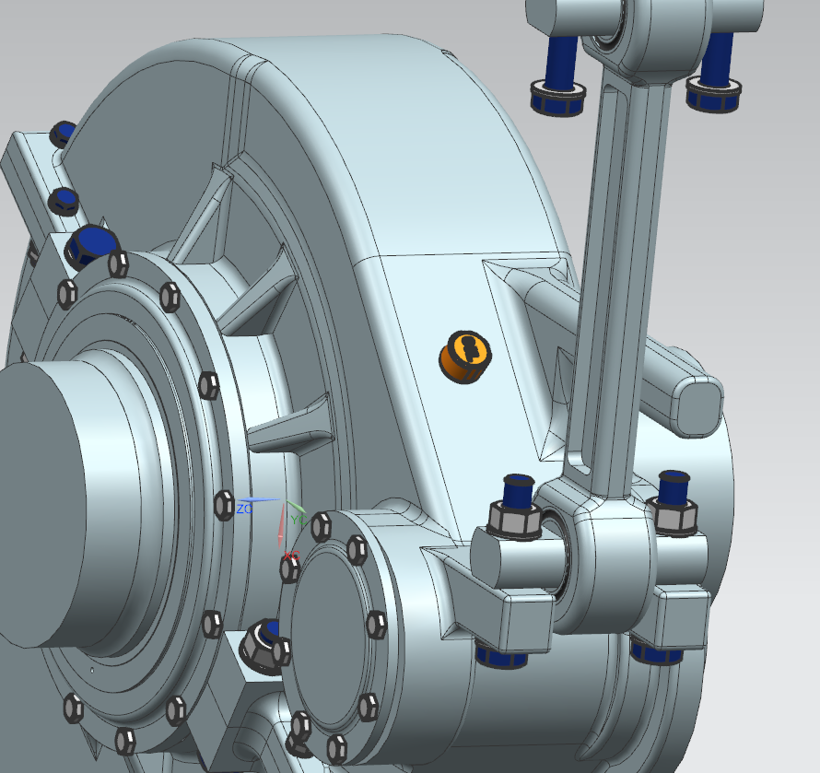
[picture p195: figure]

21. Schrauben Sie als letzten Schritt das Entlüftungsschraube auf die Oberseite des Gehäuses.
