MattdewT/KE4/Montageanleitung_Entwurf.docx

Montageanleitung

1. Abtriebswelle
2. Zahnrad auf die Abtriebswelle montieren
3. Kegelrollenlager auf beiden Seiten auf die Welle aufpressen
4. Stützringe auf beiden Seiten auf die Welle (auf die Lager pressen) stecken
5. Labyrinthdichtungen (Wellenseite) auf beiden Seiten auf die Welle aufpressen
6. Gehäuse
