MattdewT/KE4/Finale/11. Auslegung des thermischen Pressverbandes.pdf

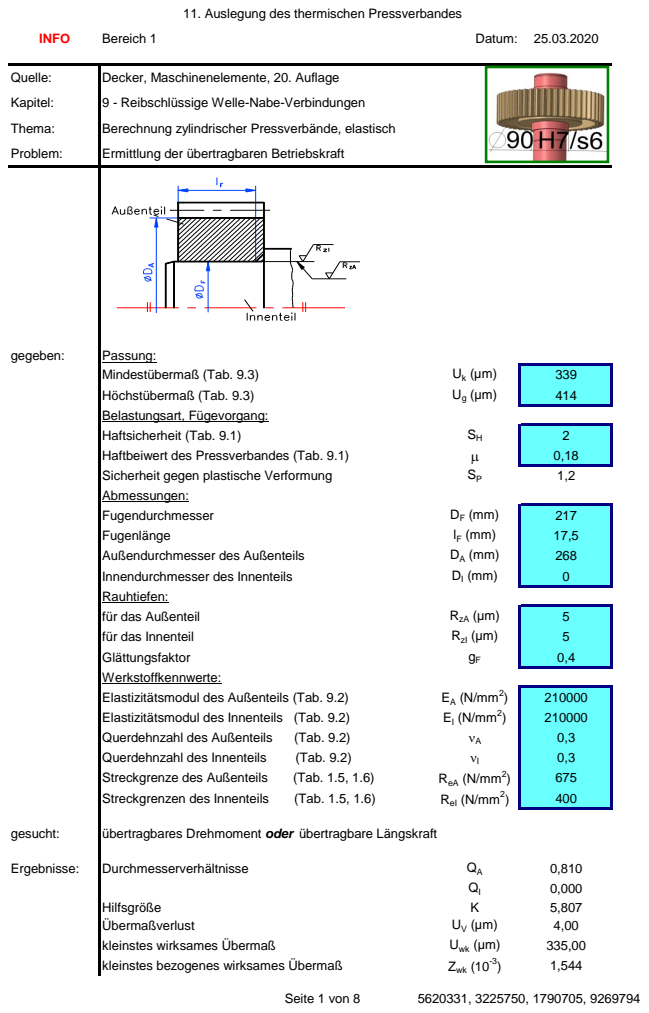
[picture p196: page 1]
INFO; Bereich 1; Datum:; Quelle:; Decker, Maschinenelemente, 20. Auflage; Kapitel:; 9 - Reibschlüssige Welle-Nabe-Verbindungen; Thema:; Berechnung zylindrischer Pressverbände, elastisch; Problem:; Ermittlung der übertragbaren Betriebskraft; gegeben:; Passung:; Mindestübermaß (Tab. 9.3); Höchstübermaß (Tab. 9.3); Belastungsart, Fügevorgang:; Haftsicherheit (Tab. 9.1); Haftbeiwert des Pressverbandes (Tab. 9.1); Sicherheit gegen plastische Verformung; Abmessungen:; Fugendurchmesser; Fugenlänge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

11. Auslegung des thermischen Pressverbandes

| kleinste Fugenpressung pFk (N/mm²
| kleinste Haftkraft FFk (N) | 119877
| übertragbare Betriebskraft Fzul (N) | 59939
| übertragbares Drehmoment Mzul (Nm) oder übertragbare Längskraft Flzul (N) | 6503,34 59939
Kontrolle: | Ist die Beanspruchung rein elastisch? größtes wirksames Übermaß Uwg (µm) 410,00 größtes bezogenes wirksames Übermaß Zwg (10⁻³) 1,889
| größte Fugenpressung pFg (N/mm² ) zulässige Fugenpressung für das Außenteil pAzul (N/mm² ) zulässige Fugenpressung für das Innenteil pIzul (N/mm² ) | 68,32 111,84 384,90
| es muß gelten: pFg ≤ pIzul und pFg ≤ pAzul
Seite 2 von 8 | 5620331, 3225750, 1790705, 9269794

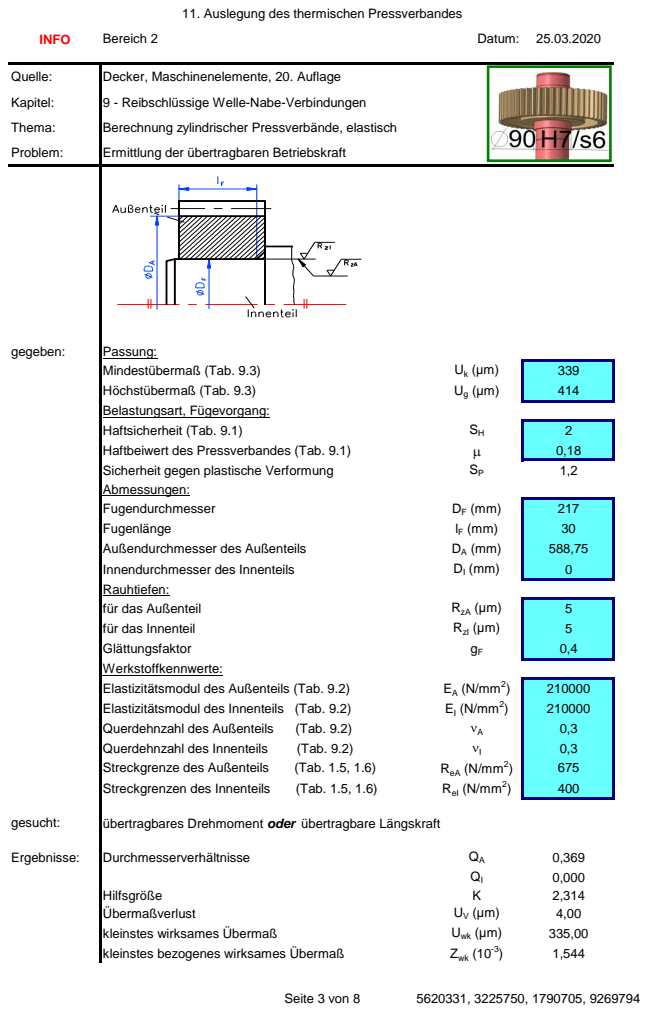
[picture p197: page 3]
INFO; Bereich 2; Datum:; Quelle:; Decker, Maschinenelemente, 20. Auflage; Kapitel:; 9 - Reibschlüssige Welle-Nabe-Verbindungen; Thema:; Berechnung zylindrischer Pressverbände, elastisch; Problem:; Ermittlung der übertragbaren Betriebskraft; gegeben:; Passung:; Mindestübermaß (Tab. 9.3); Höchstübermaß (Tab. 9.3); Belastungsart, Fügevorgang:; Haftsicherheit (Tab. 9.1); Haftbeiwert des Pressverbandes (Tab. 9.1); Sicherheit gegen plastische Verformung; Abmessungen:; Fugendurchmesser; Fugenlänge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

| kleinste Haftkraft FFk (N) | 515664
| übertragbare Betriebskraft Fzul (N) | 257832
| übertragbares Drehmoment Mzul (Nm) oder übertragbare Längskraft Flzul (N) | 27974,80 257832
Kontrolle: | Ist die Beanspruchung rein elastisch? größtes wirksames Übermaß Uwg (µm) 410,00 größtes bezogenes wirksames Übermaß Zwg (10⁻³) 1,889
| größte Fugenpressung pFg (N/mm² ) zulässige Fugenpressung für das Außenteil pAzul (N/mm² ) zulässige Fugenpressung für das Innenteil pIzul (N/mm² ) | 171,44 280,64 384,90
| es muß gelten: pFg ≤ pIzul und pFg ≤ pAzul
Seite 4 von 8 | 5620331, 3225750, 1790705, 9269794

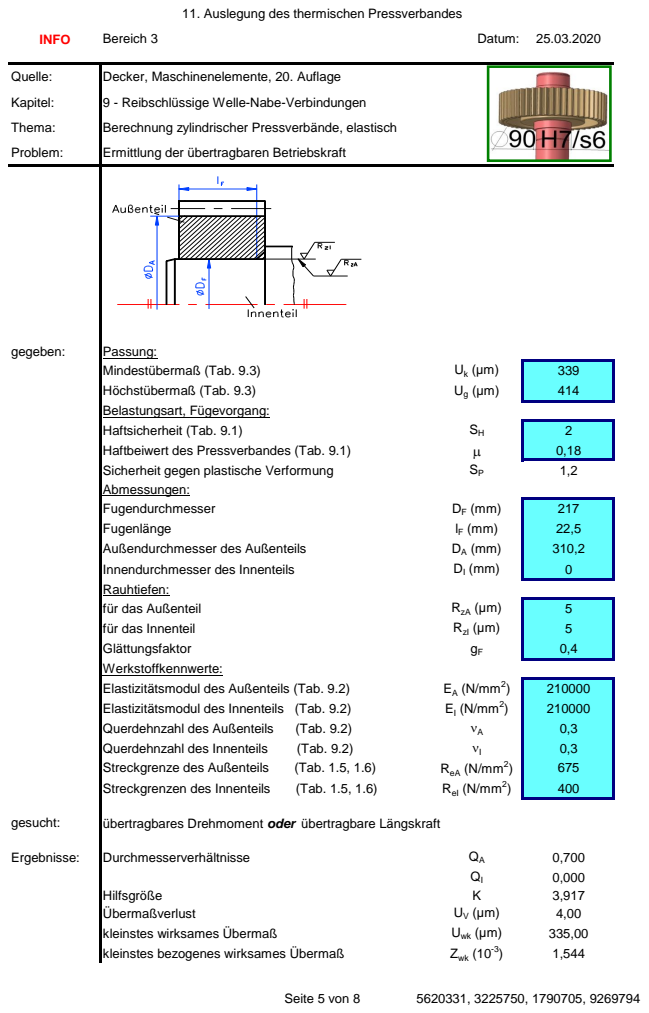
[picture p198: page 5]
INFO; Bereich 3; Datum:; Quelle:; Decker, Maschinenelemente, 20. Auflage; Kapitel:; 9 - Reibschlüssige Welle-Nabe-Verbindungen; Thema:; Berechnung zylindrischer Pressverbände, elastisch; Problem:; Ermittlung der übertragbaren Betriebskraft; gegeben:; Passung:; Mindestübermaß (Tab. 9.3); Höchstübermaß (Tab. 9.3); Belastungsart, Fügevorgang:; Haftsicherheit (Tab. 9.1); Haftbeiwert des Pressverbandes (Tab. 9.1); Sicherheit gegen plastische Verformung; Abmessungen:; Fugendurchmesser; Fugenlänge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

| kleinste Haftkraft FFk (N) | 228532
| übertragbare Betriebskraft Fzul (N) | 114266
| übertragbares Drehmoment Mzul (Nm) oder übertragbare Längskraft Flzul (N) | 12397,85 114266
Kontrolle: | Ist die Beanspruchung rein elastisch? größtes wirksames Übermaß Uwg (µm) 410,00 größtes bezogenes wirksames Übermaß Zwg (10⁻³) 1,889
| größte Fugenpressung pFg (N/mm² ) zulässige Fugenpressung für das Außenteil pAzul (N/mm² ) zulässige Fugenpressung für das Innenteil pIzul (N/mm² ) | 101,30 165,83 384,90
| es muß gelten: pFg ≤ pIzul und pFg ≤ pAzul
Seite 6 von 8 | 5620331, 3225750, 1790705, 9269794

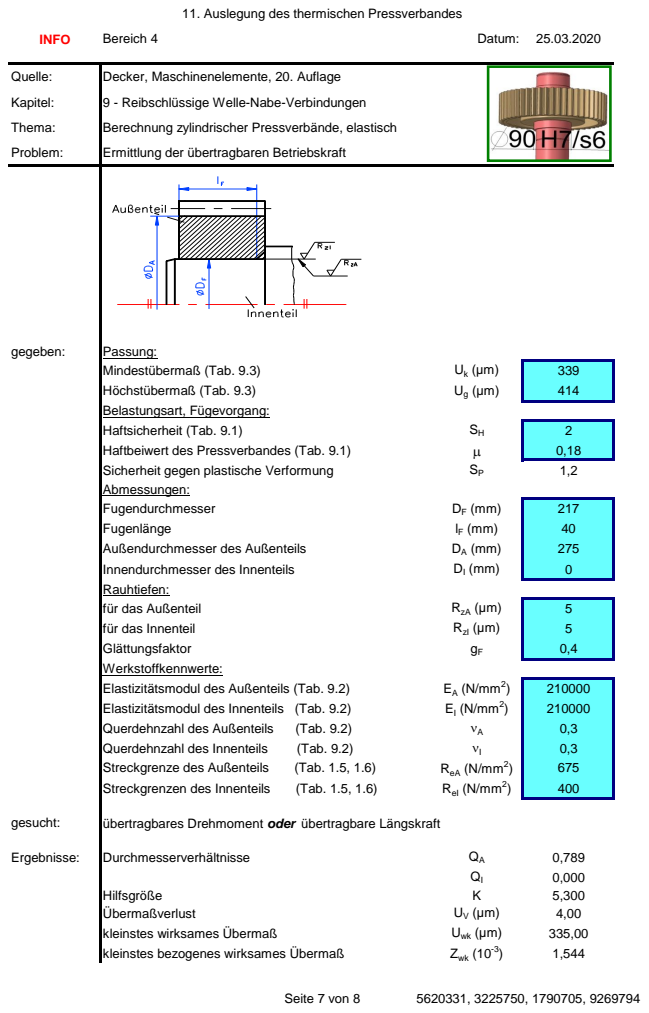
[picture p199: page 7]
INFO; Bereich 4; Datum:; Quelle:; Decker, Maschinenelemente, 20. Auflage; Kapitel:; 9 - Reibschlüssige Welle-Nabe-Verbindungen; Thema:; Berechnung zylindrischer Pressverbände, elastisch; Problem:; Ermittlung der übertragbaren Betriebskraft; gegeben:; Passung:; Mindestübermaß (Tab. 9.3); Höchstübermaß (Tab. 9.3); Belastungsart, Fügevorgang:; Haftsicherheit (Tab. 9.1); Haftbeiwert des Pressverbandes (Tab. 9.1); Sicherheit gegen plastische Verformung; Abmessungen:; Fugendurchmesser; Fugenlänge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

| kleinste Haftkraft FFk (N) | 300223
| übertragbare Betriebskraft Fzul (N) | 150112
| übertragbares Drehmoment Mzul (Nm) oder übertragbare Längskraft Flzul (N) | 16287,11 150112
Kontrolle: | Ist die Beanspruchung rein elastisch? größtes wirksames Übermaß Uwg (µm) 410,00 größtes bezogenes wirksames Übermaß Zwg (10⁻³) 1,889
| größte Fugenpressung pFg (N/mm² ) zulässige Fugenpressung für das Außenteil pAzul (N/mm² ) zulässige Fugenpressung für das Innenteil pIzul (N/mm² ) | 74,86 122,54 384,90
| es muß gelten: pFg ≤ pIzul und pFg ≤ pAzul
Seite 8 von 8 | 5620331, 3225750, 1790705, 9269794
