MattdewT/KE4/Finale/6.1 Baugruppenzeichnung.pdf

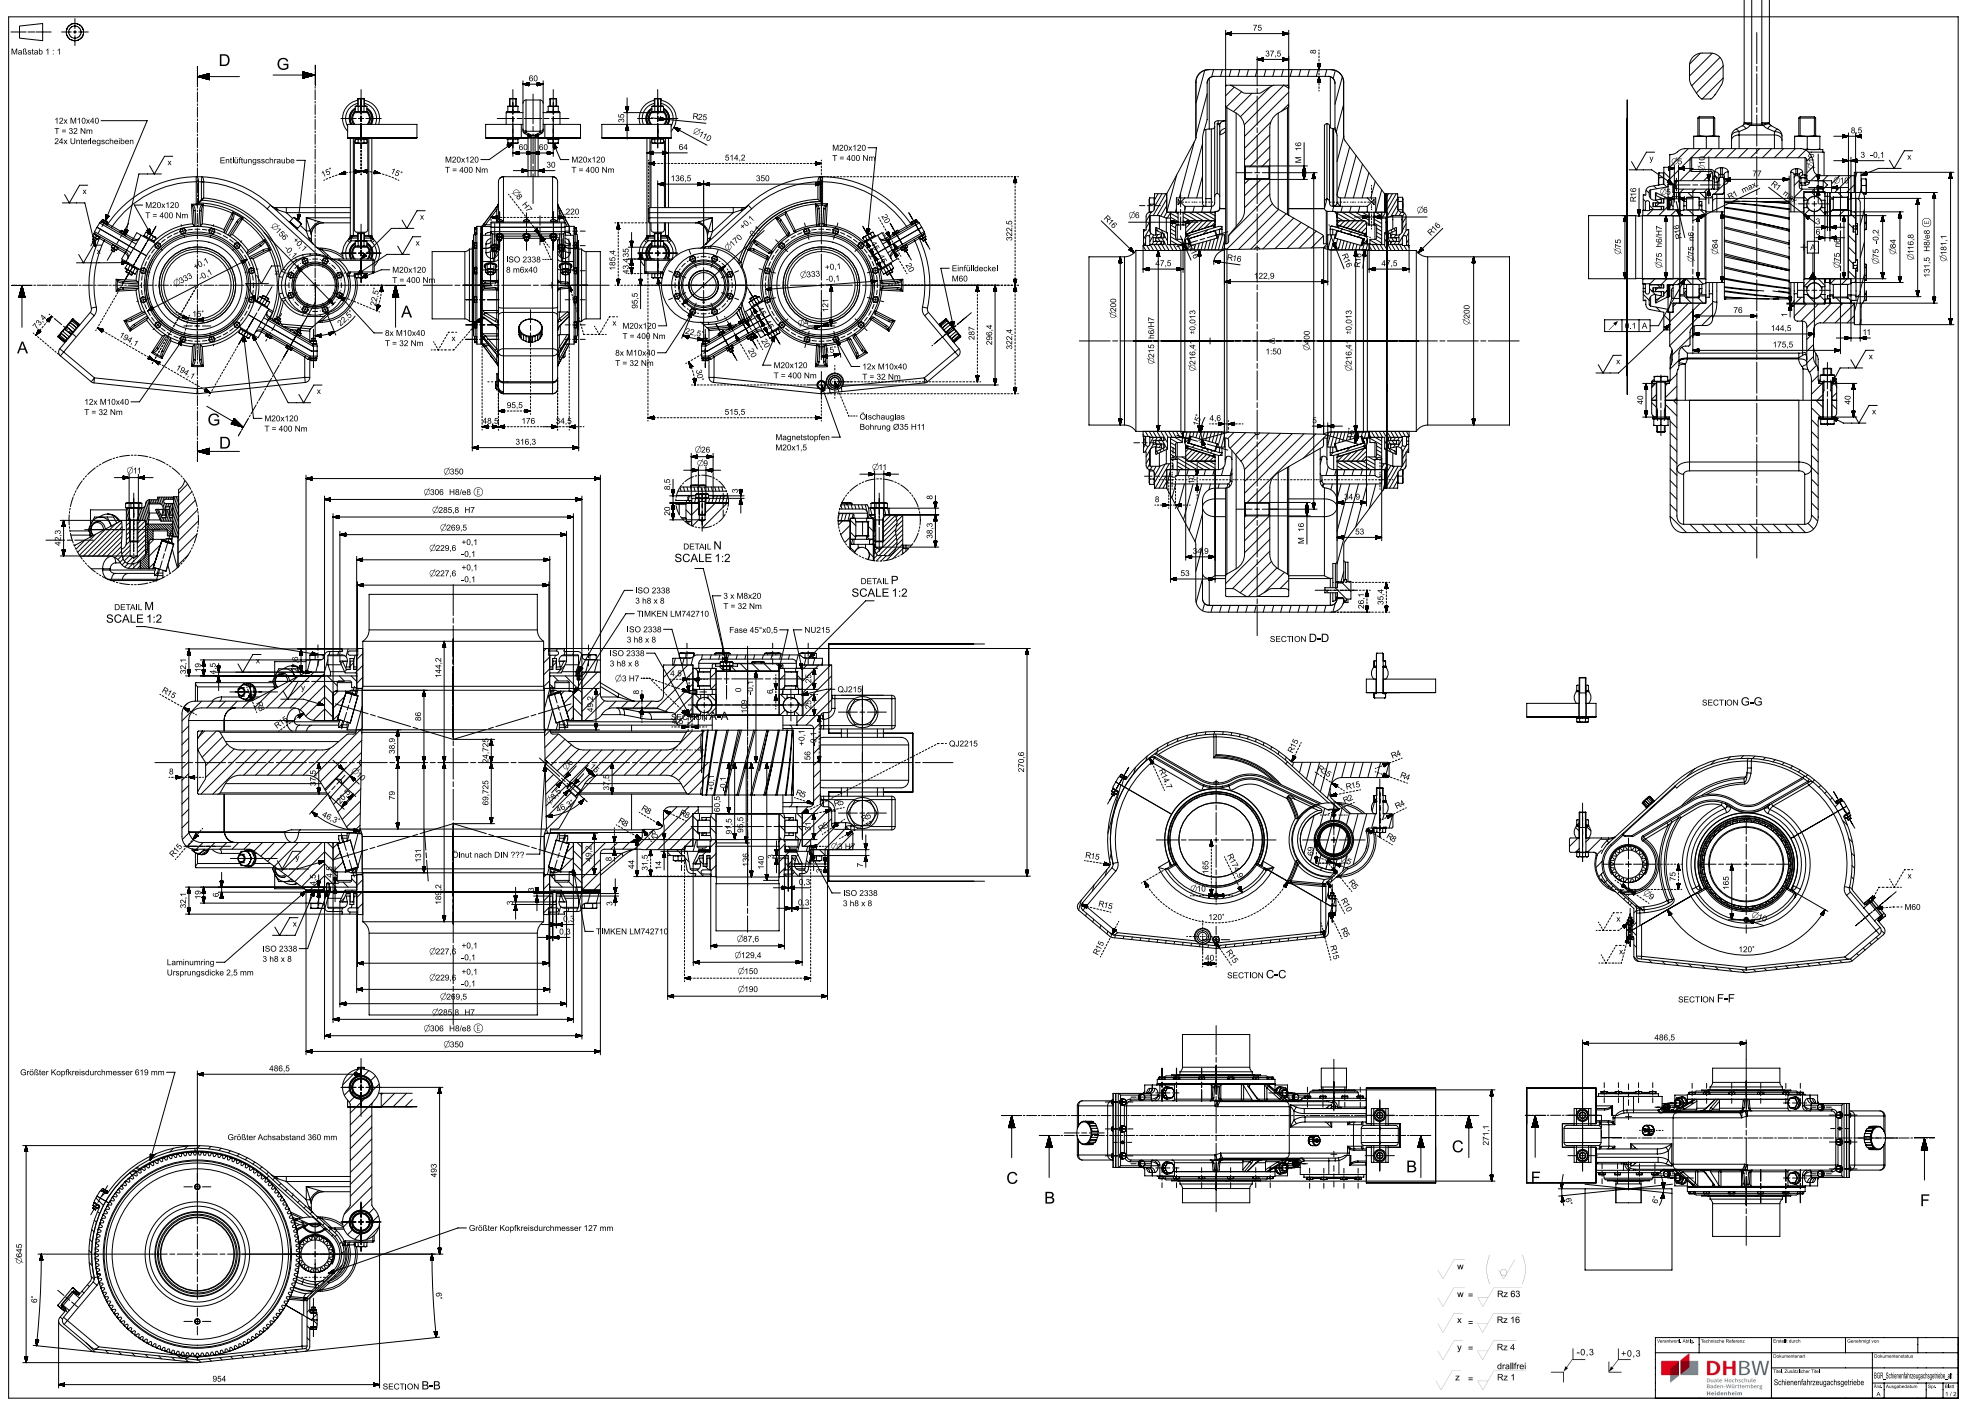
[picture p204: page 1]
