MattdewT/KE4/CAD/Gesmatbauzeichnung_SFGA.pdf

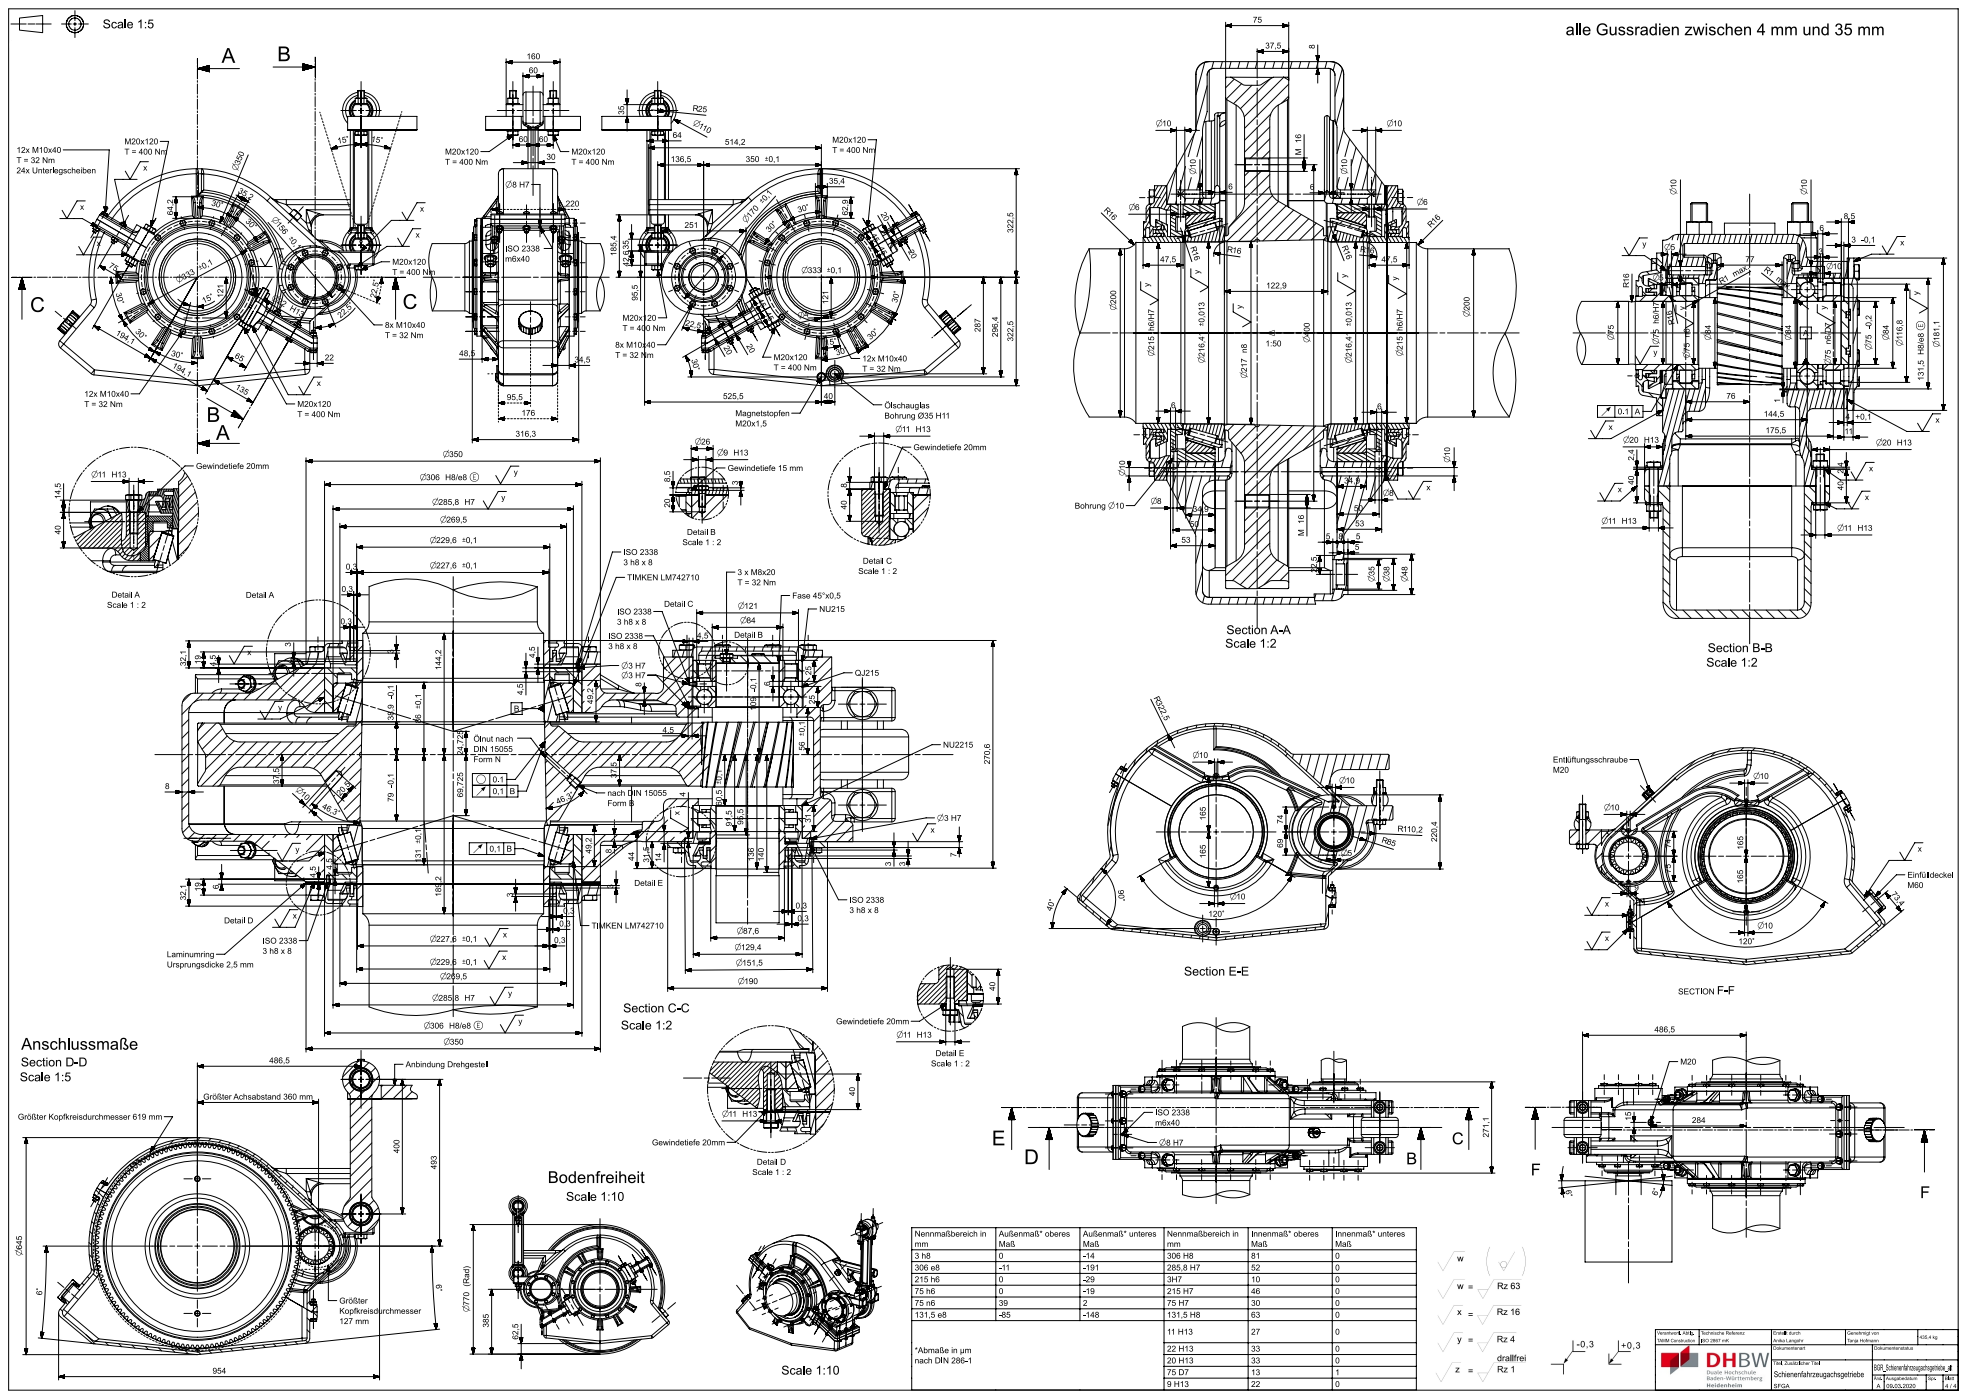
[picture p205: page 1]
