MattdewT/KE4/Finale/7.1 Drehmomentstütze.pdf

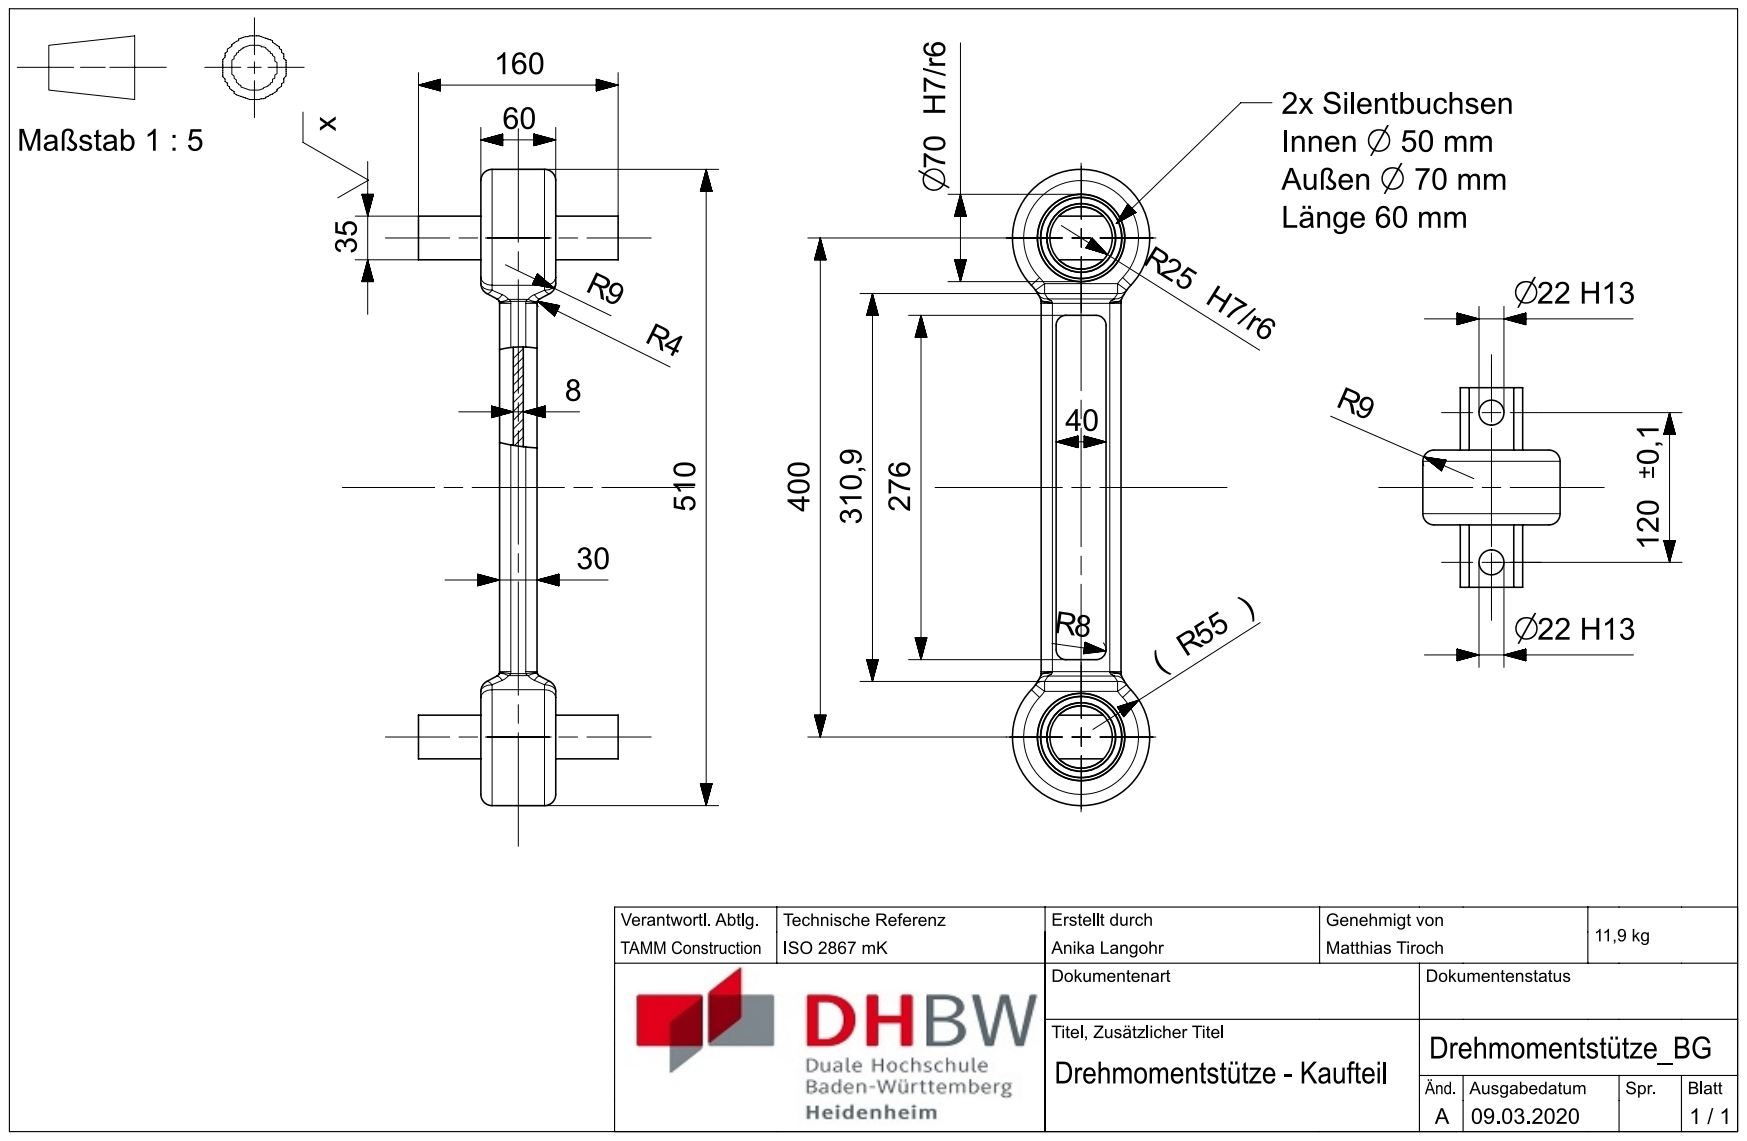
[picture p206: page 1]
