MattdewT/KE4/Finale/6.2 Abmaße Labyrinthdichtungen.pdf

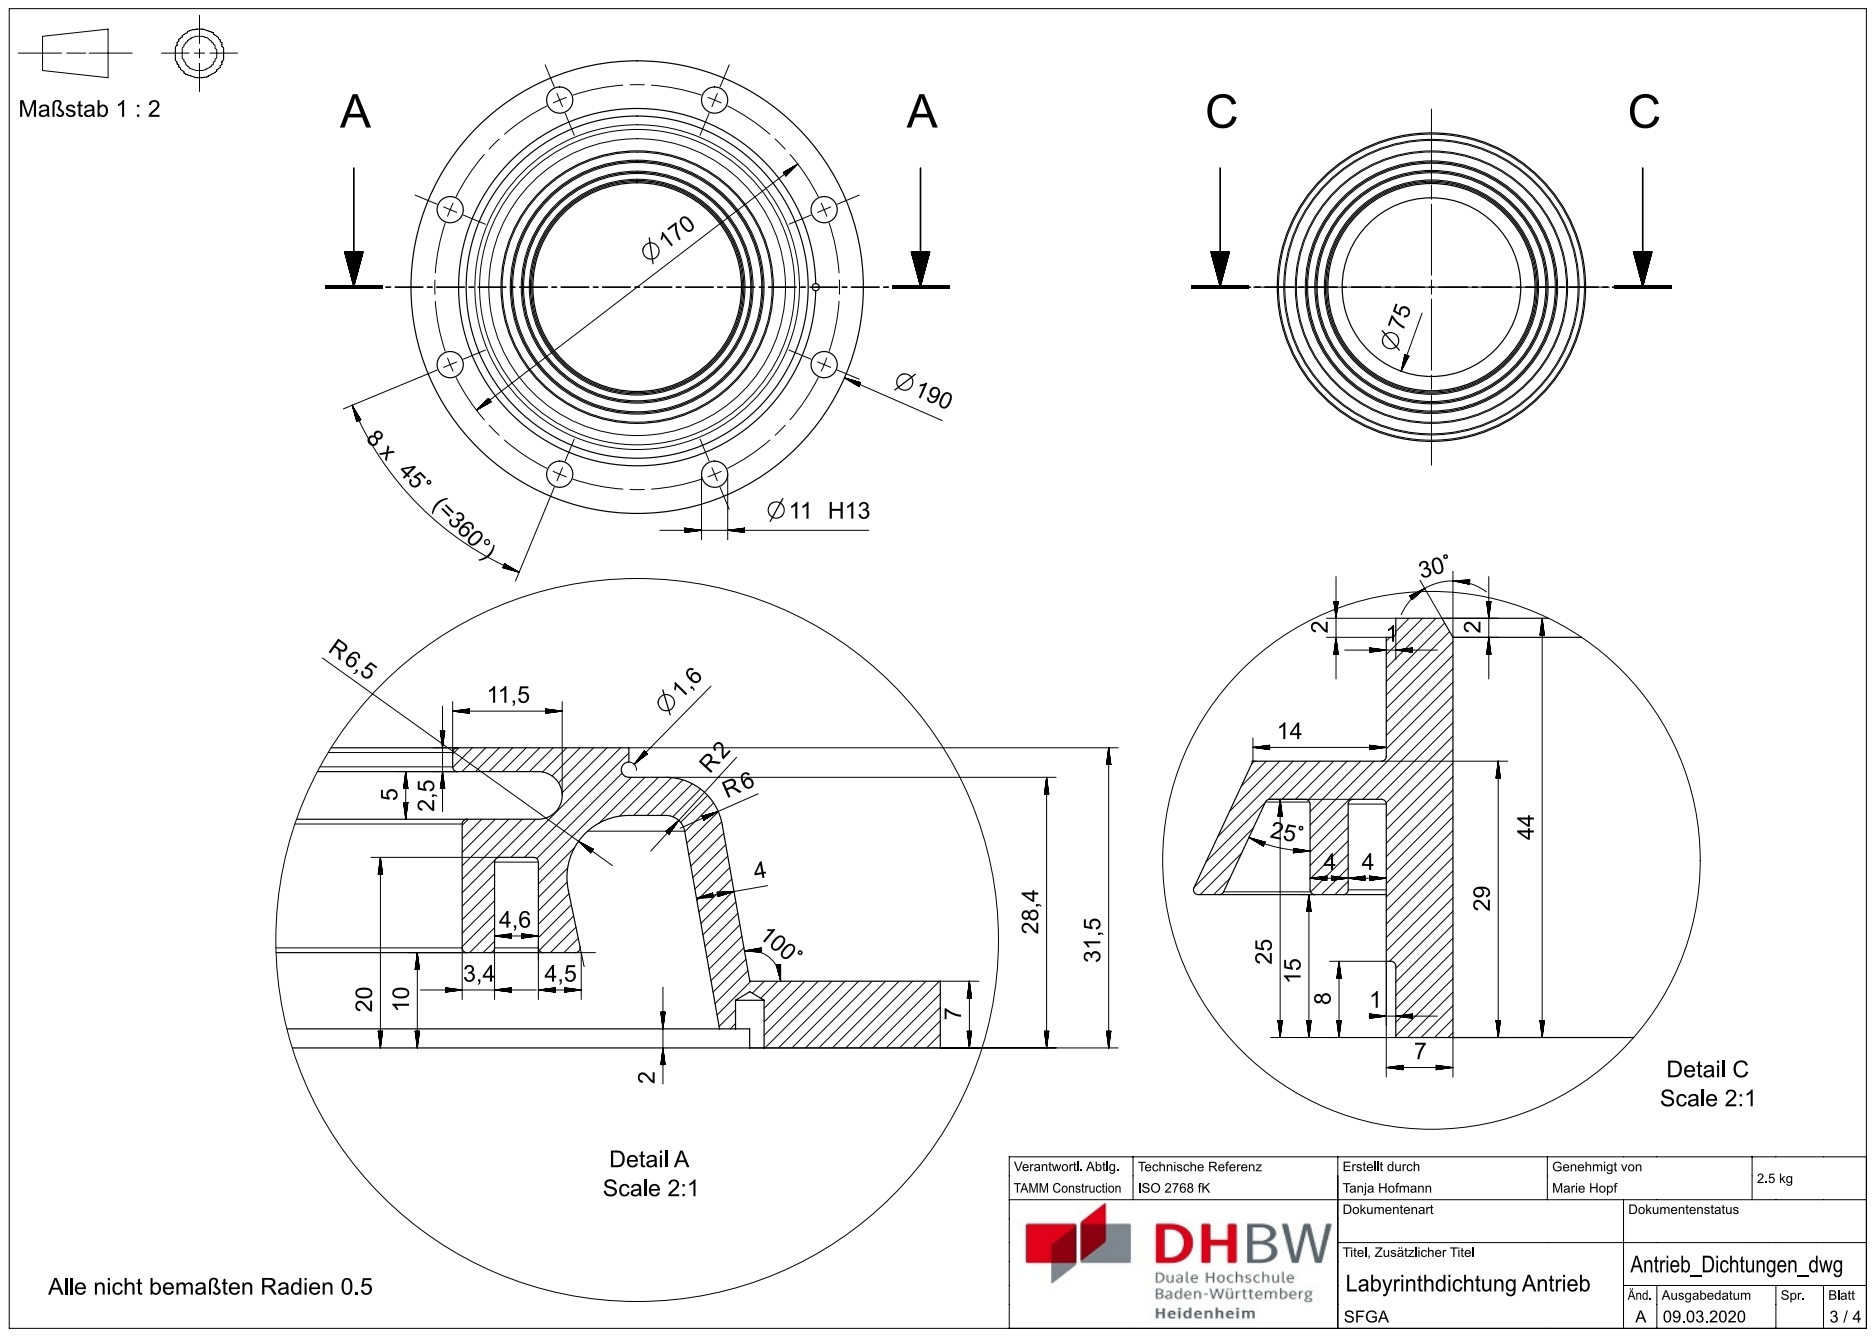
[picture p207: page 1]
