MattdewT/KE4/Finale/6.3 Abmaße Zahnrad.pdf

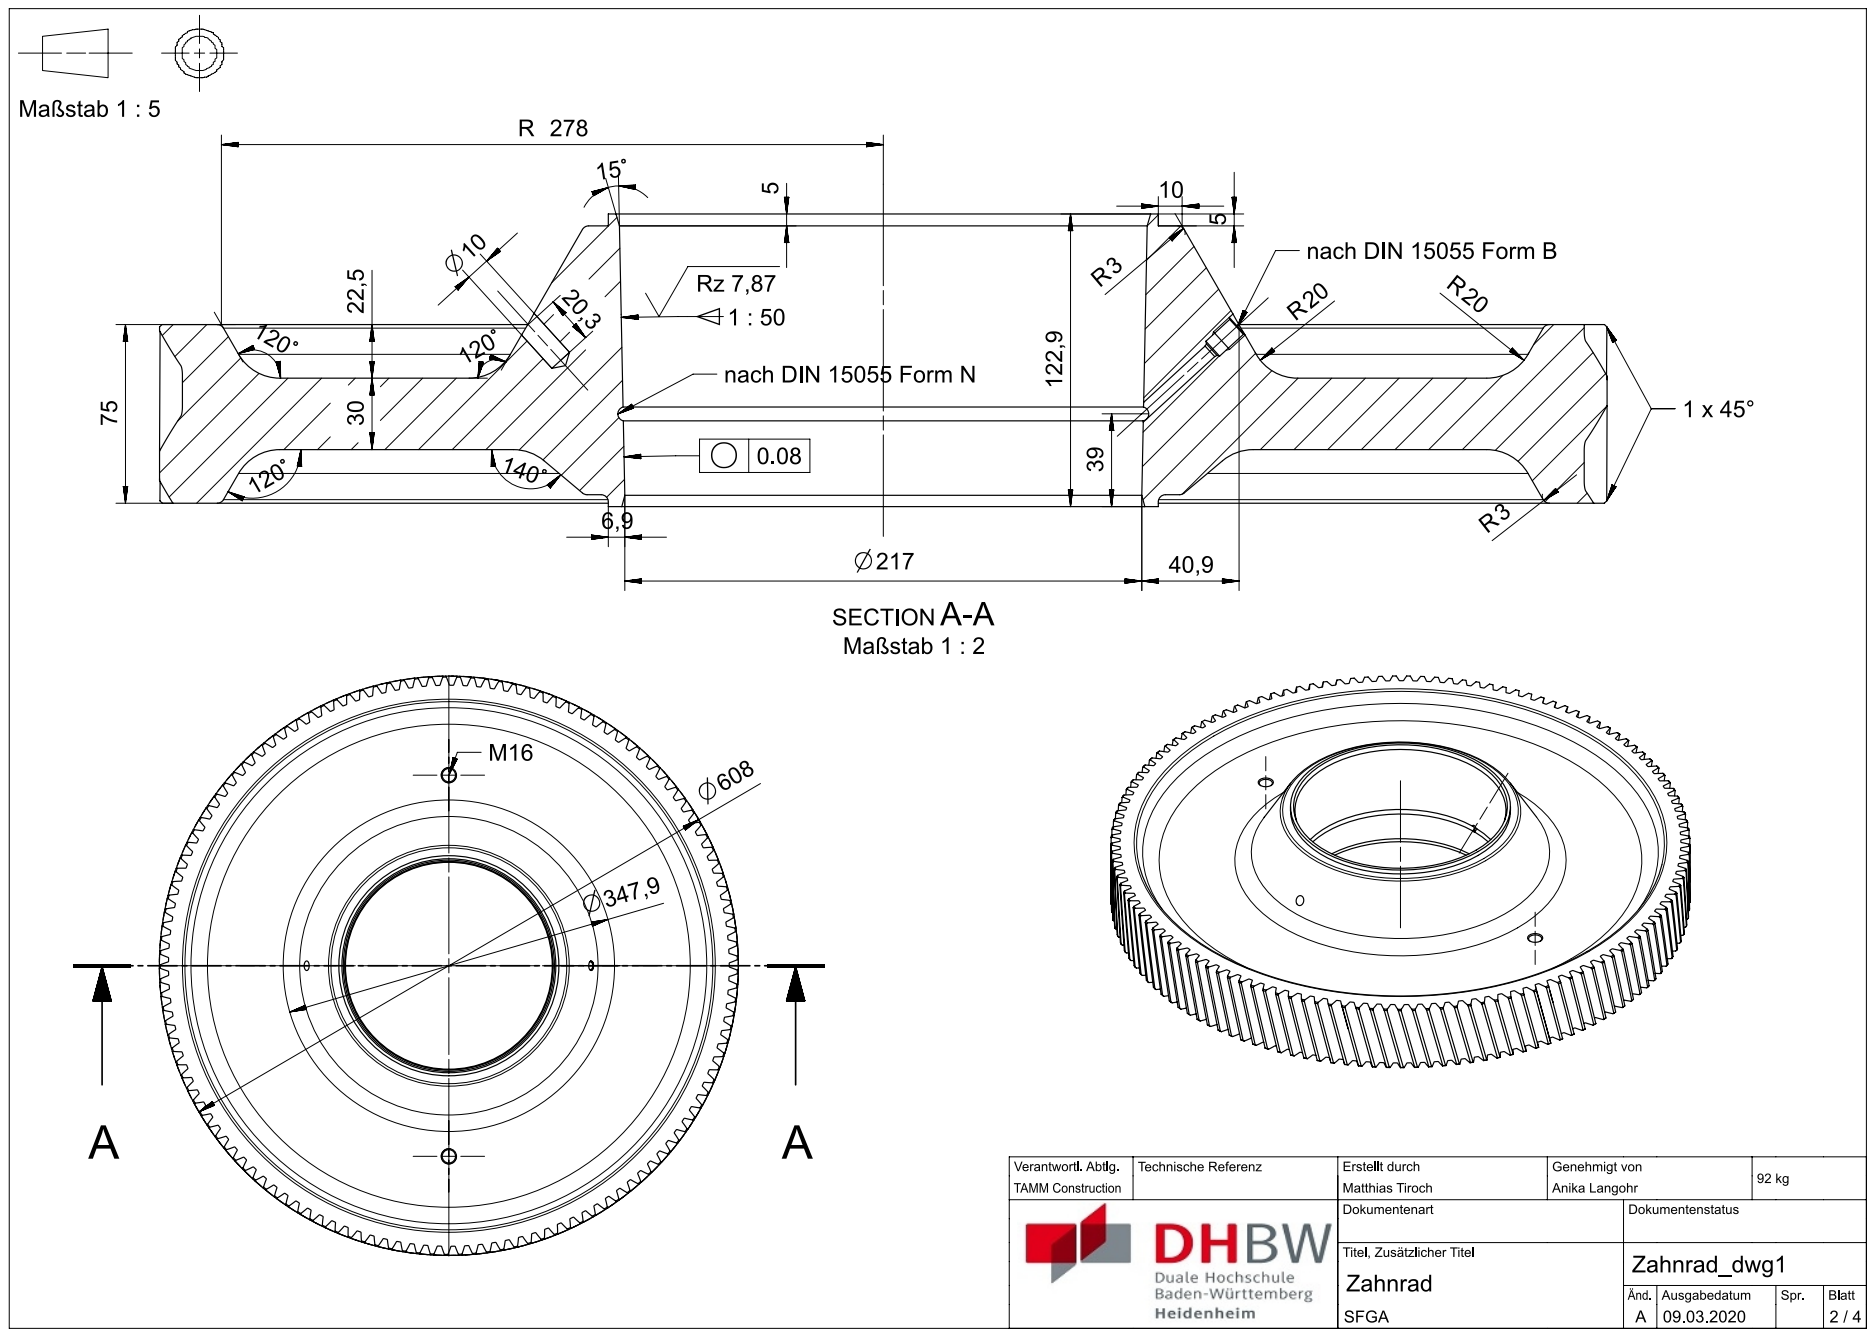
[picture p208: page 1]
