MattdewT/KE4/Finale/Explosionszeichung.pdf

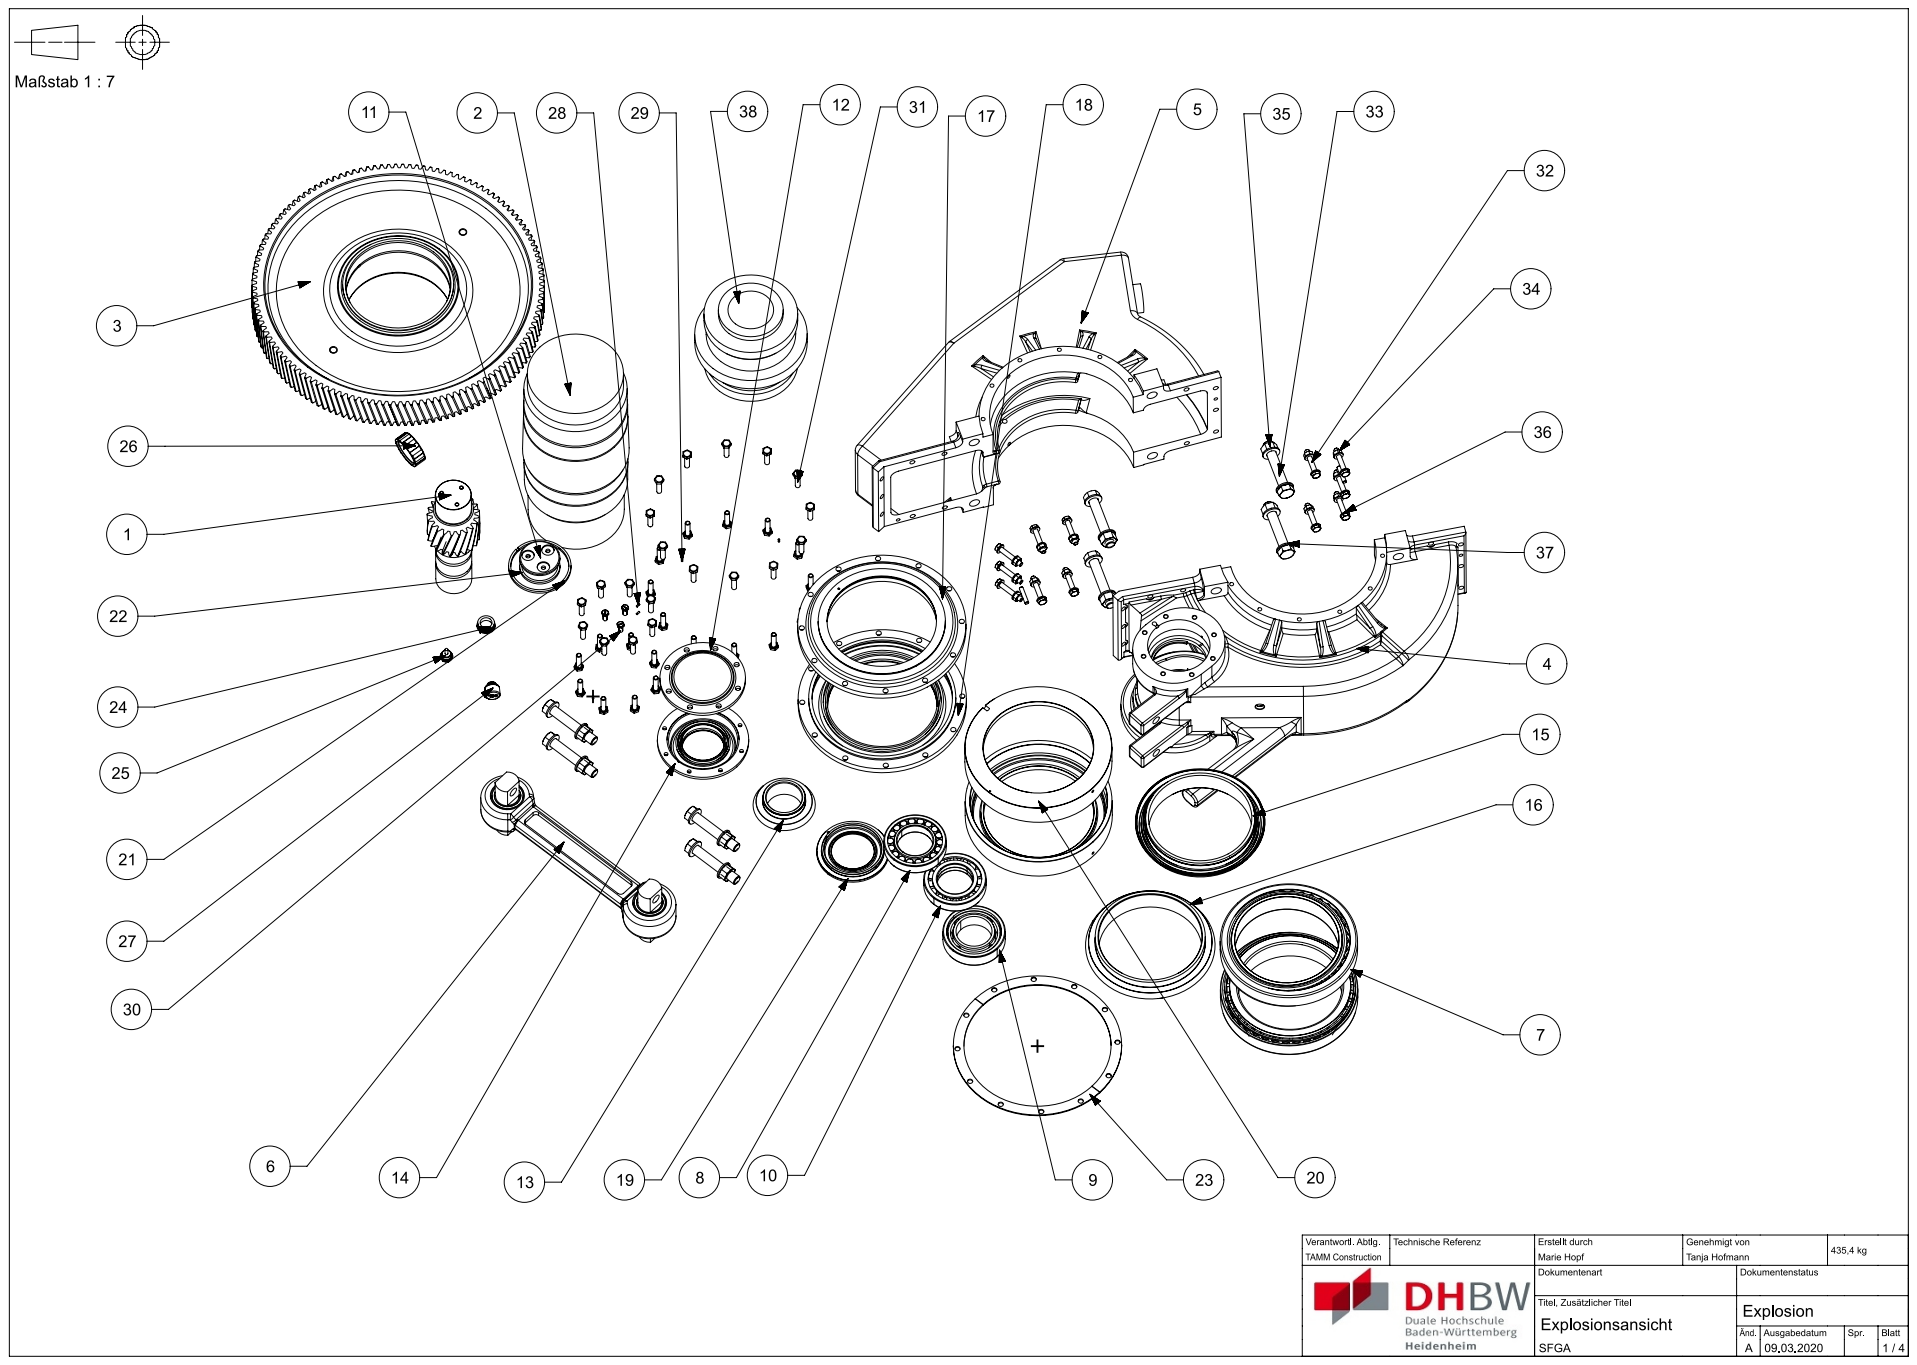
[picture p209: page 1]
