MattdewT/KE4/CAD/Zeichnungen/tirochm.tmb18_Baugruppe_SFAG.pdf

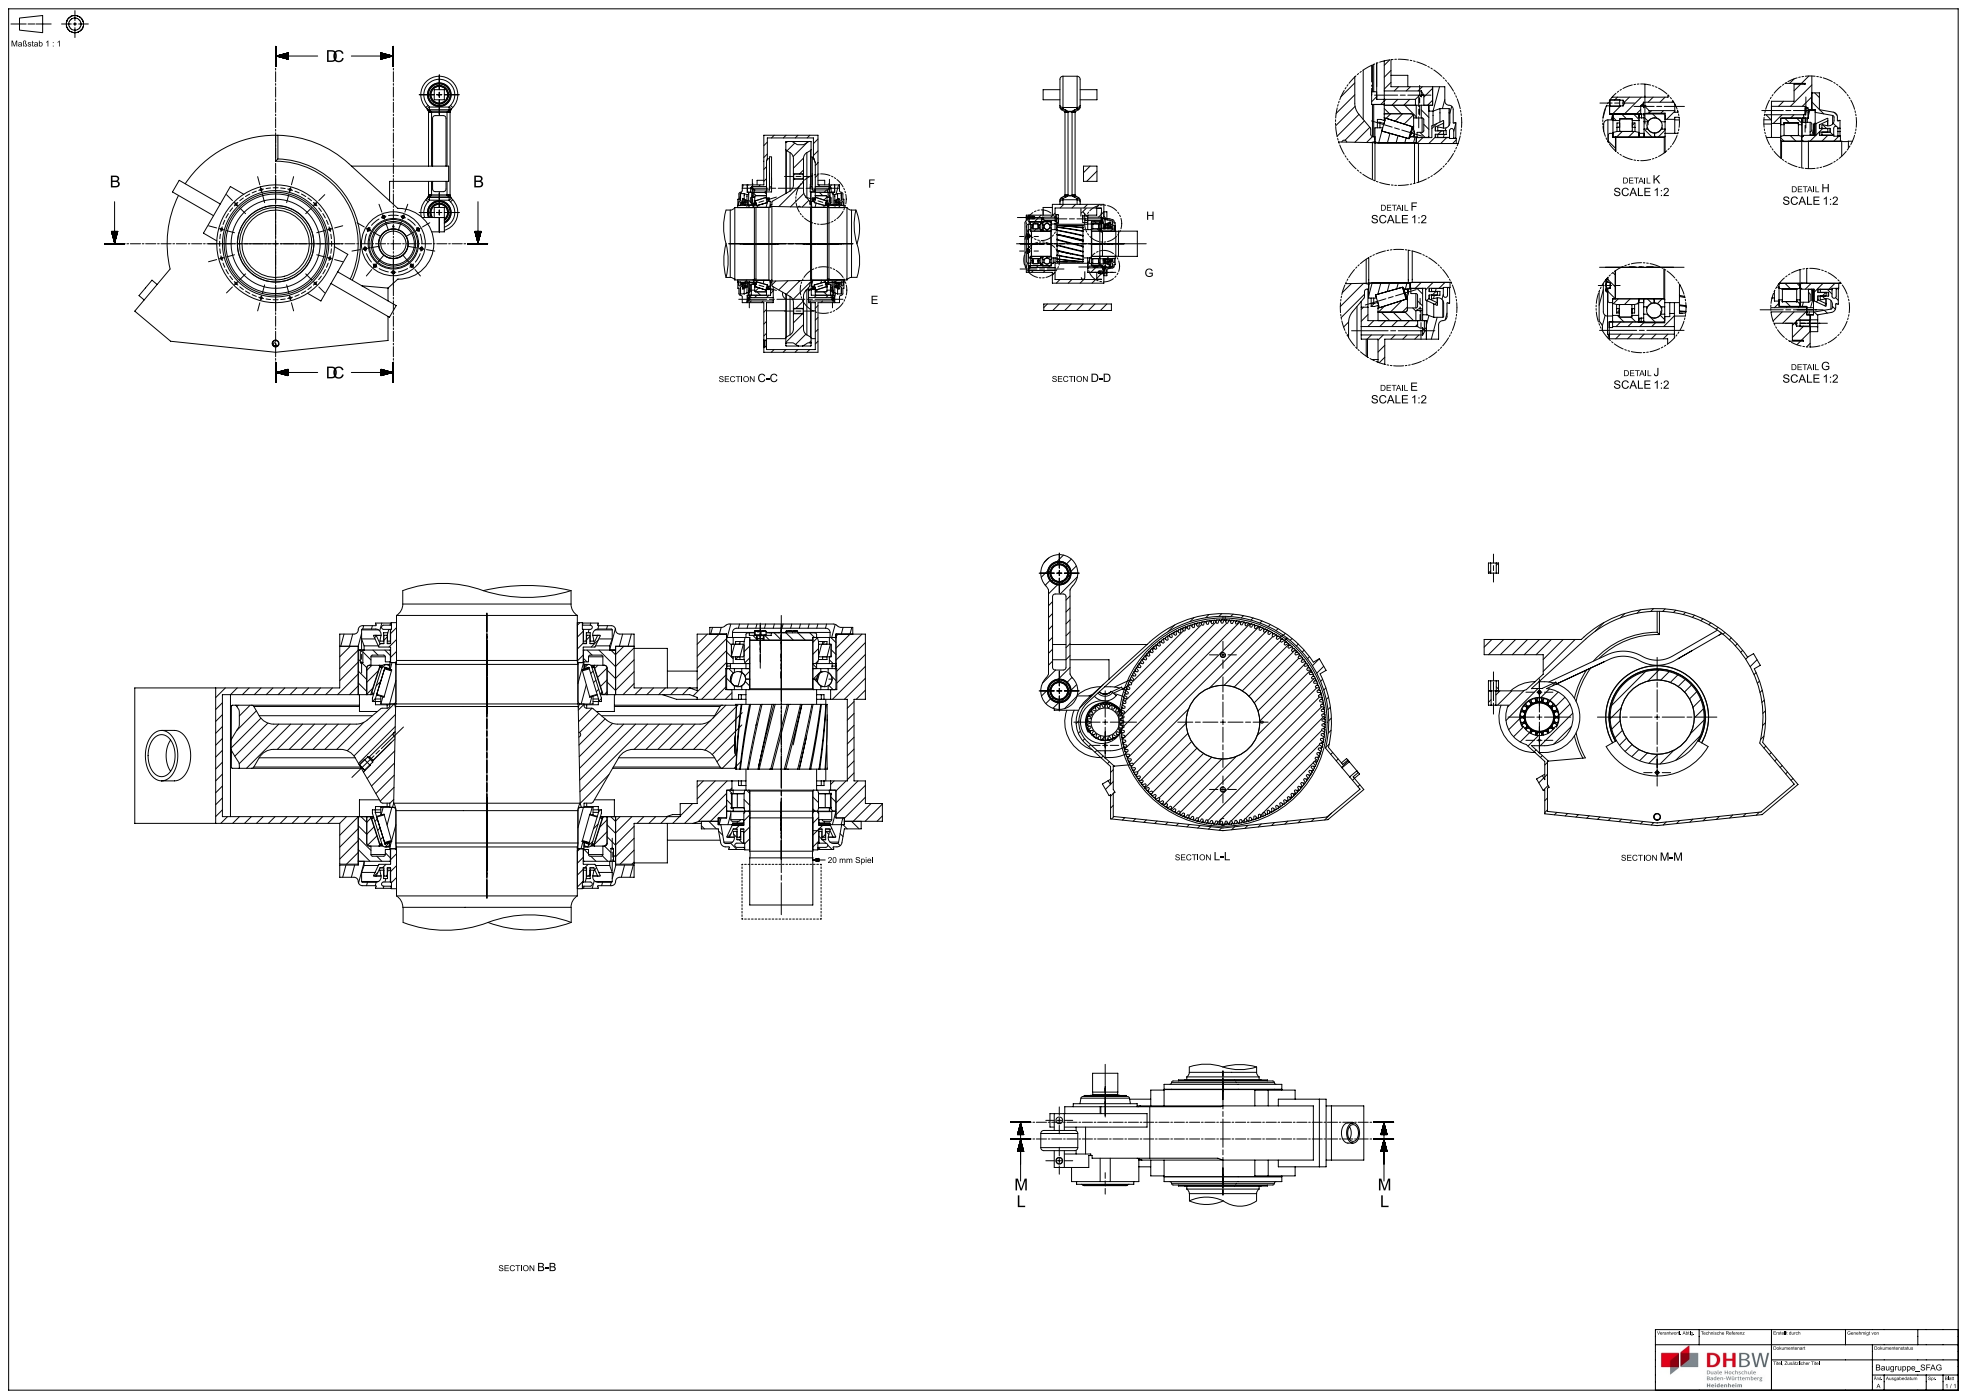
[picture p210: page 1]
