MattdewT/KE4/Finale/CAD/Normteile/Metall-Gummi-Puffer.pdf

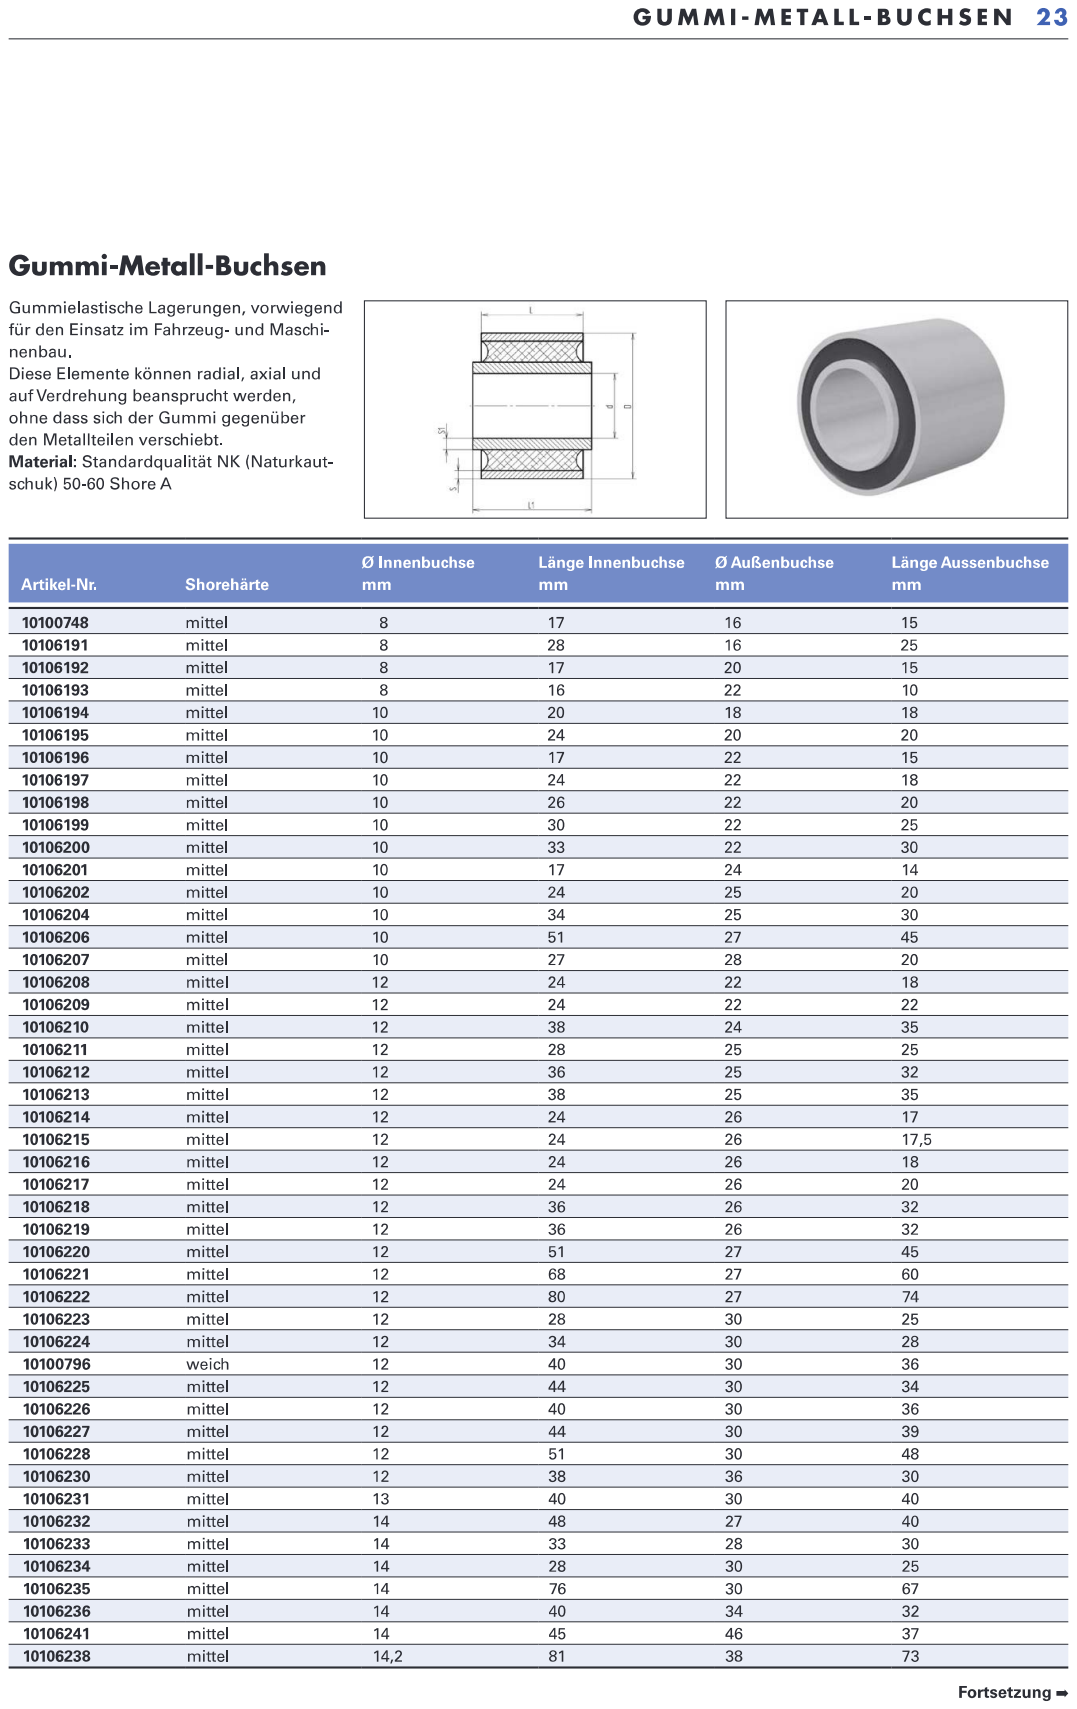
[picture p211: page 1]

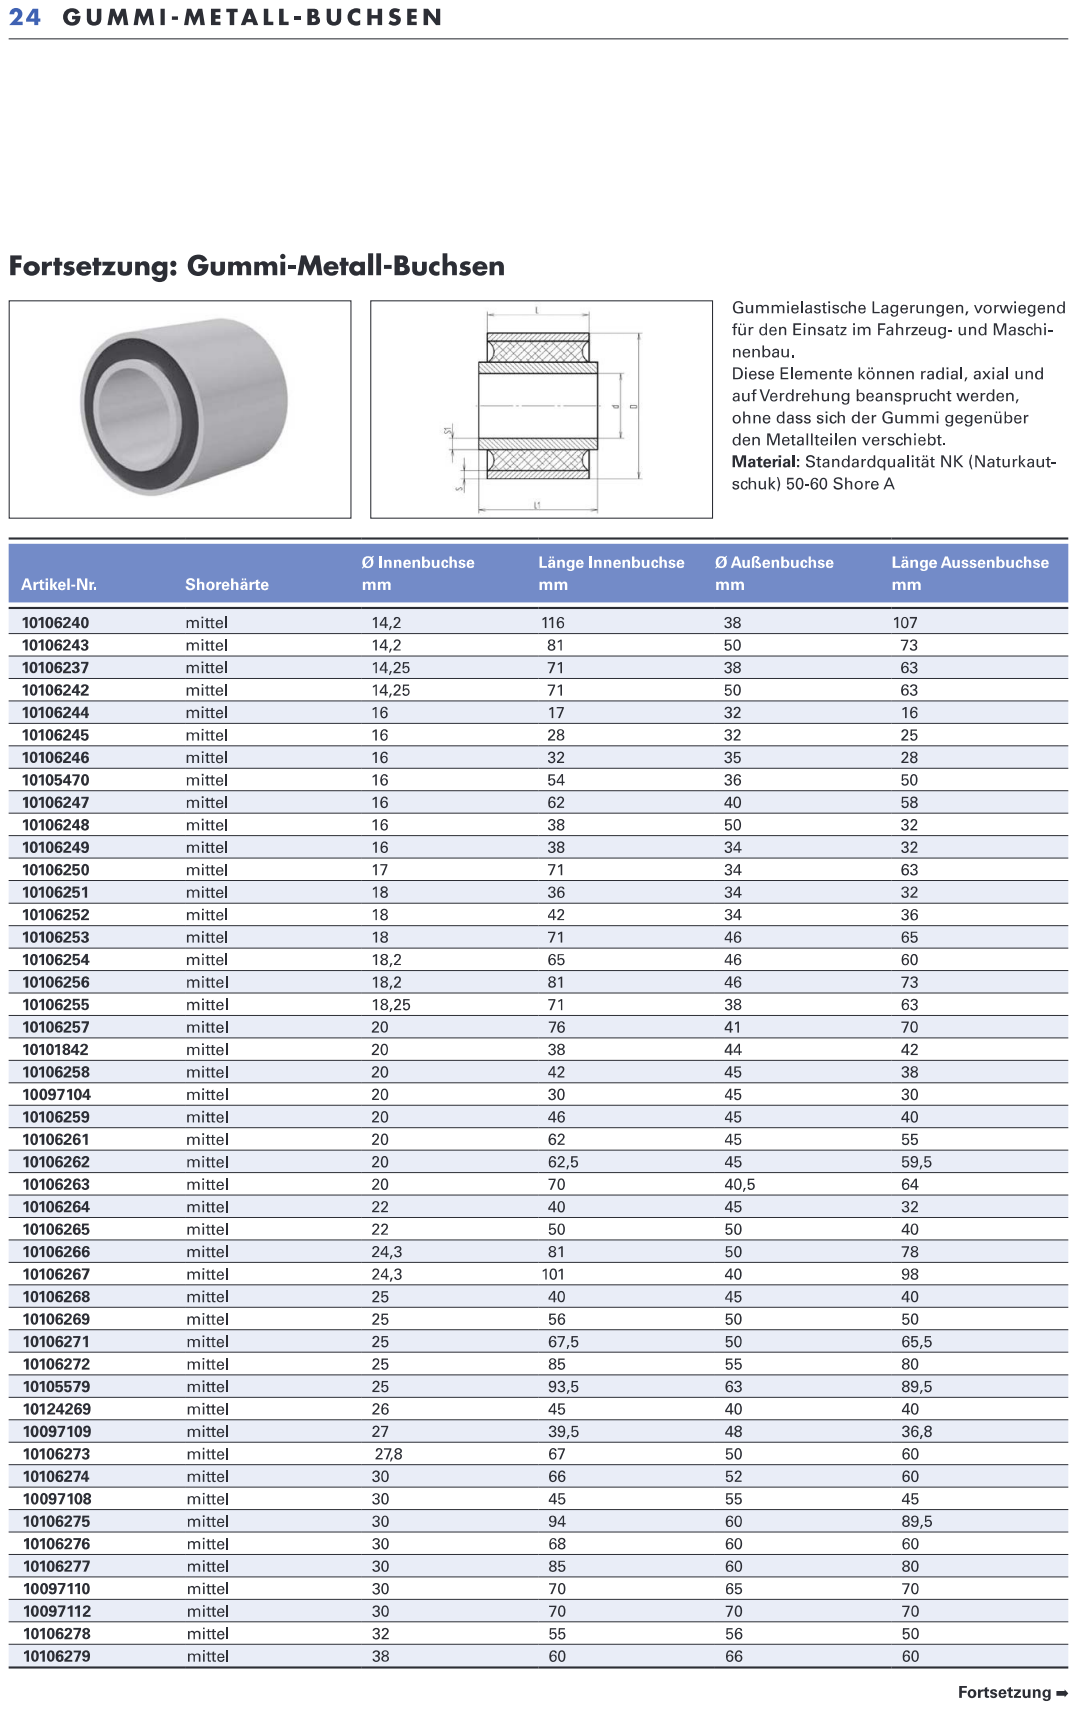
[picture p212: page 2]

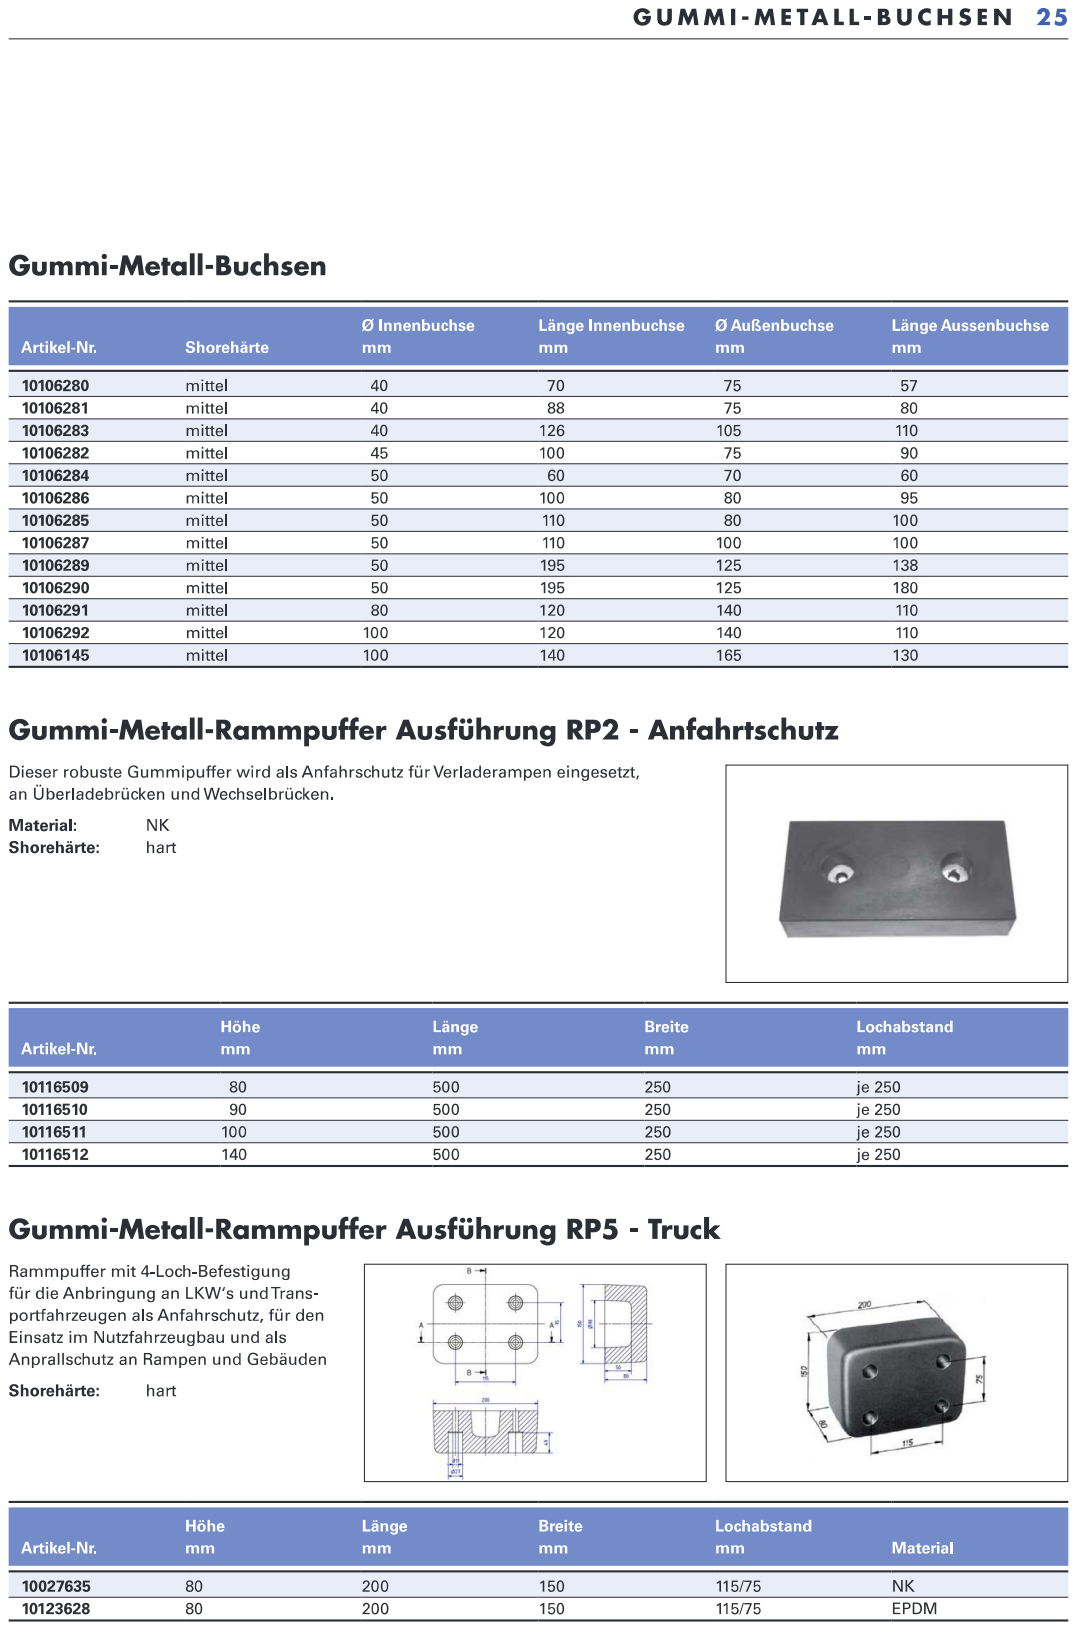
[picture p213: page 3]
