MattdewT/KE4/CAD/Zeichnungen/Gesamt/tirochm.tmb18_Baugruppe_SFAG_dwg1.pdf

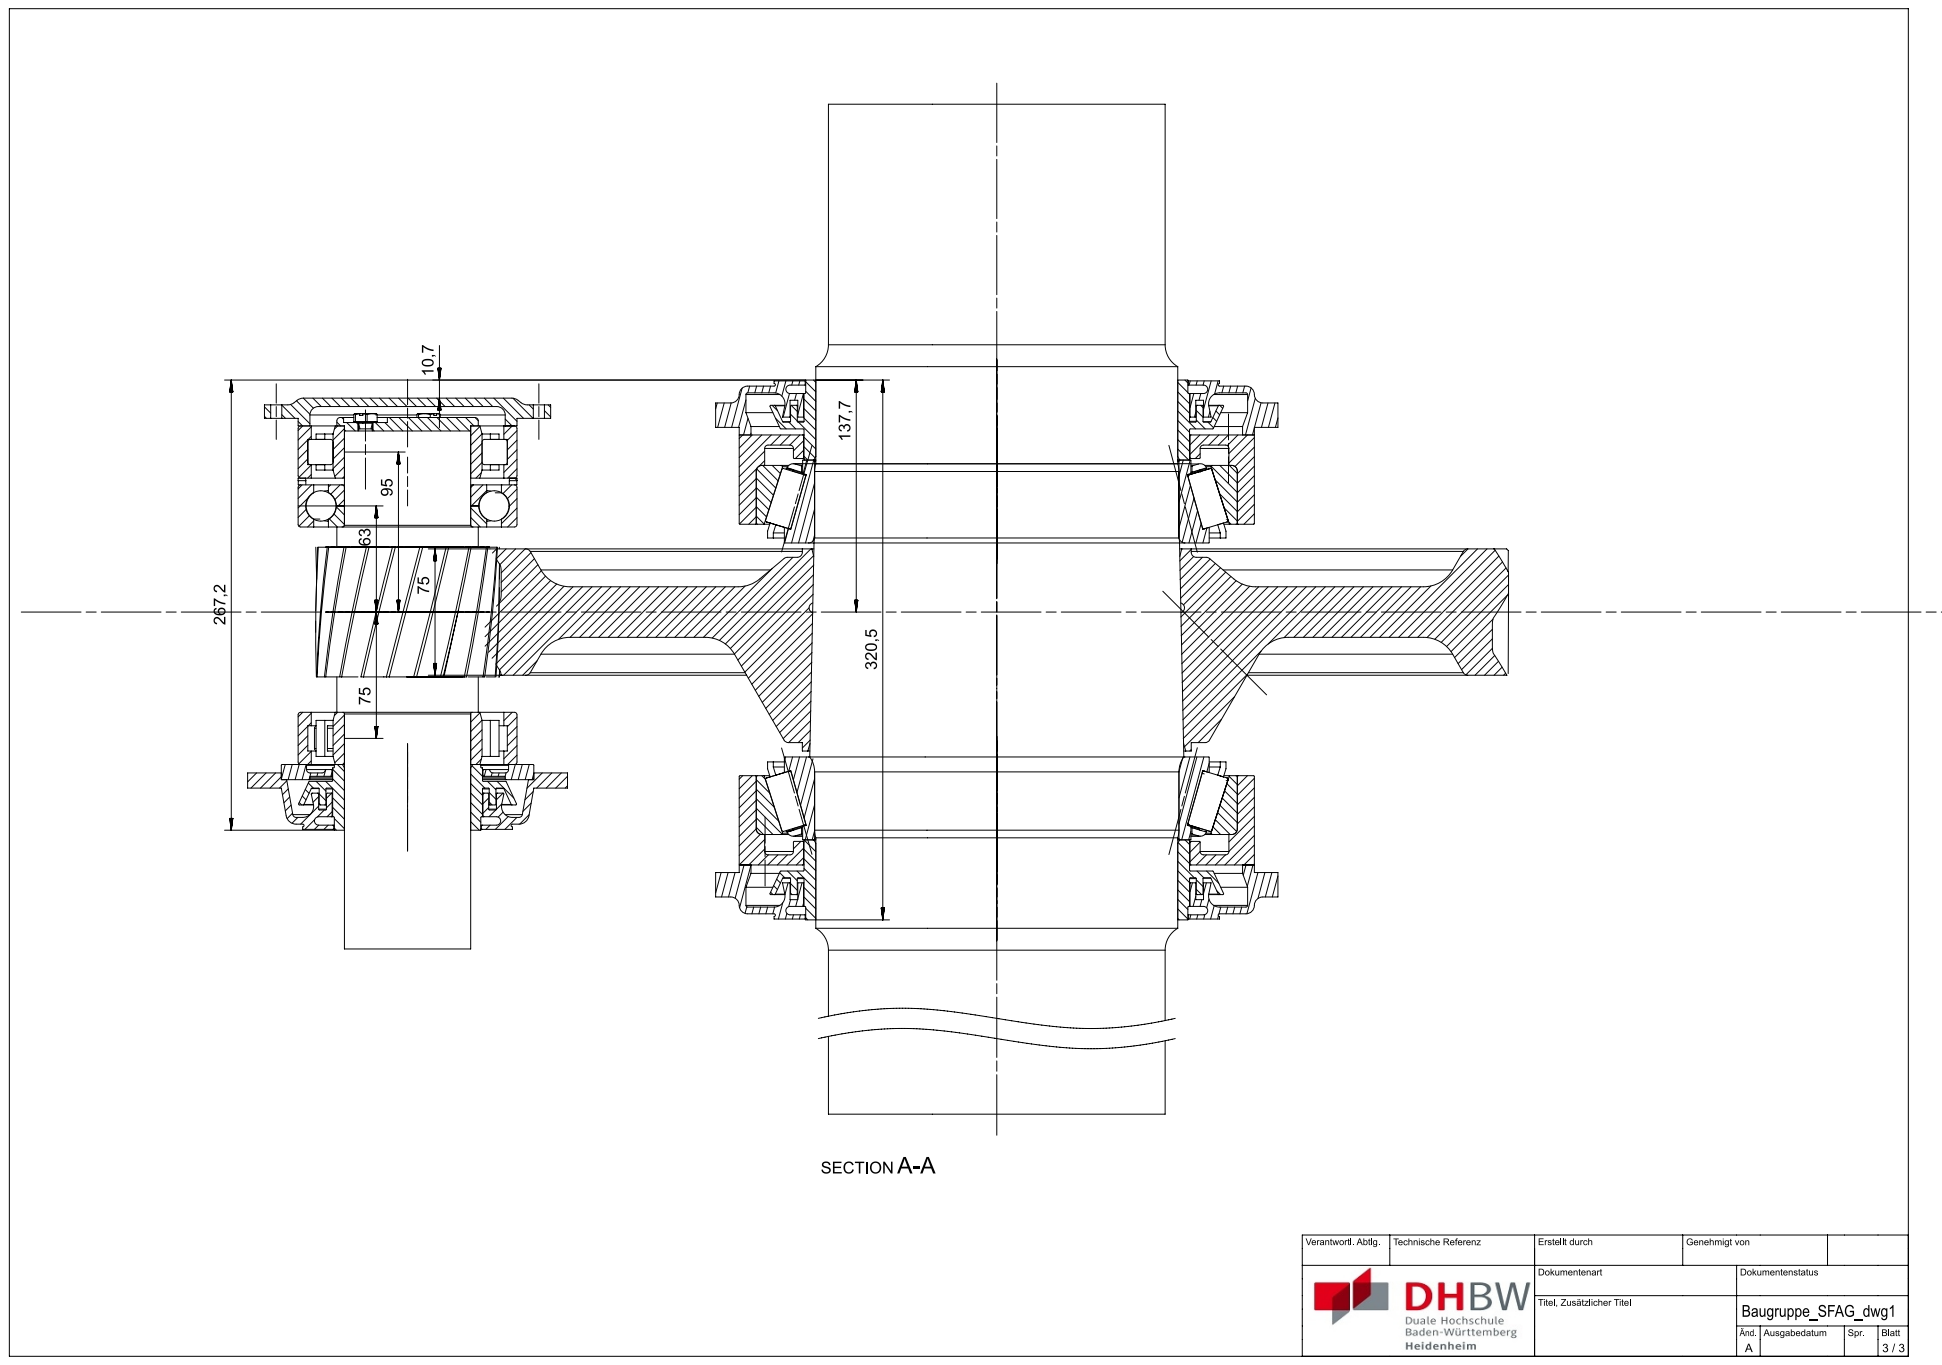
[picture p214: page 1]
