MattdewT/KE4/Finale/CAD/Normteile/Einfülldeckel Kunststoff/548_2.pdf

## GN 548.2 Einfülldeckel

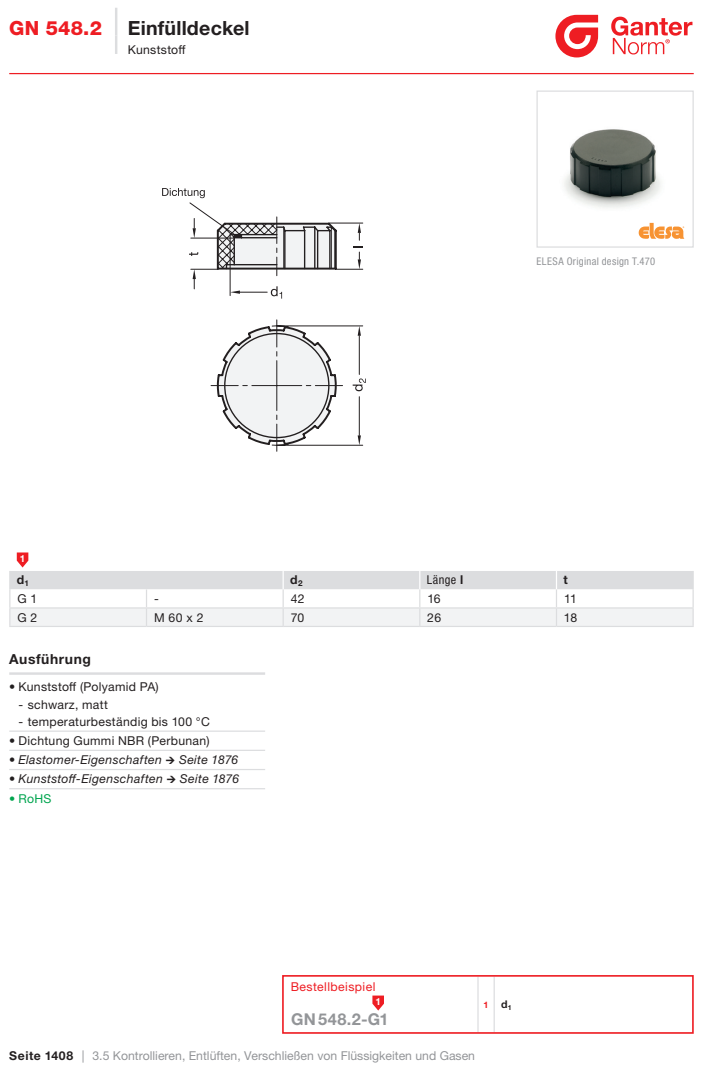
[picture p215: page 1]
Kunststoff; Bestellbeispiel 1 GN 548.2-G1; Ausführung

ELESA Original design T.470

d1 | d2 | Länge l | t
G 1 | - | 42 | 16 | 11
G 2 | M 60 x 2 | 70 | 26 | 18

• Kunststoff (Polyamid PA)
- schwarz, matt
- temperaturbeständig bis 100 °C
• Dichtung Gummi NBR (Perbunan)
• Elastomer-Eigenschaften → Seite 1876
• Kunststoff-Eigenschaften → Seite 1876
• RoHS

Seite 1408 | 3.5 Kontrollieren, Entlüften, Verschließen von Flüssigkeiten und Gasen
