MattdewT/KE4/ALT_KE/TM2017/Plapp/KE4/nicop_Zeichnung Metro-Getriebe.pdf

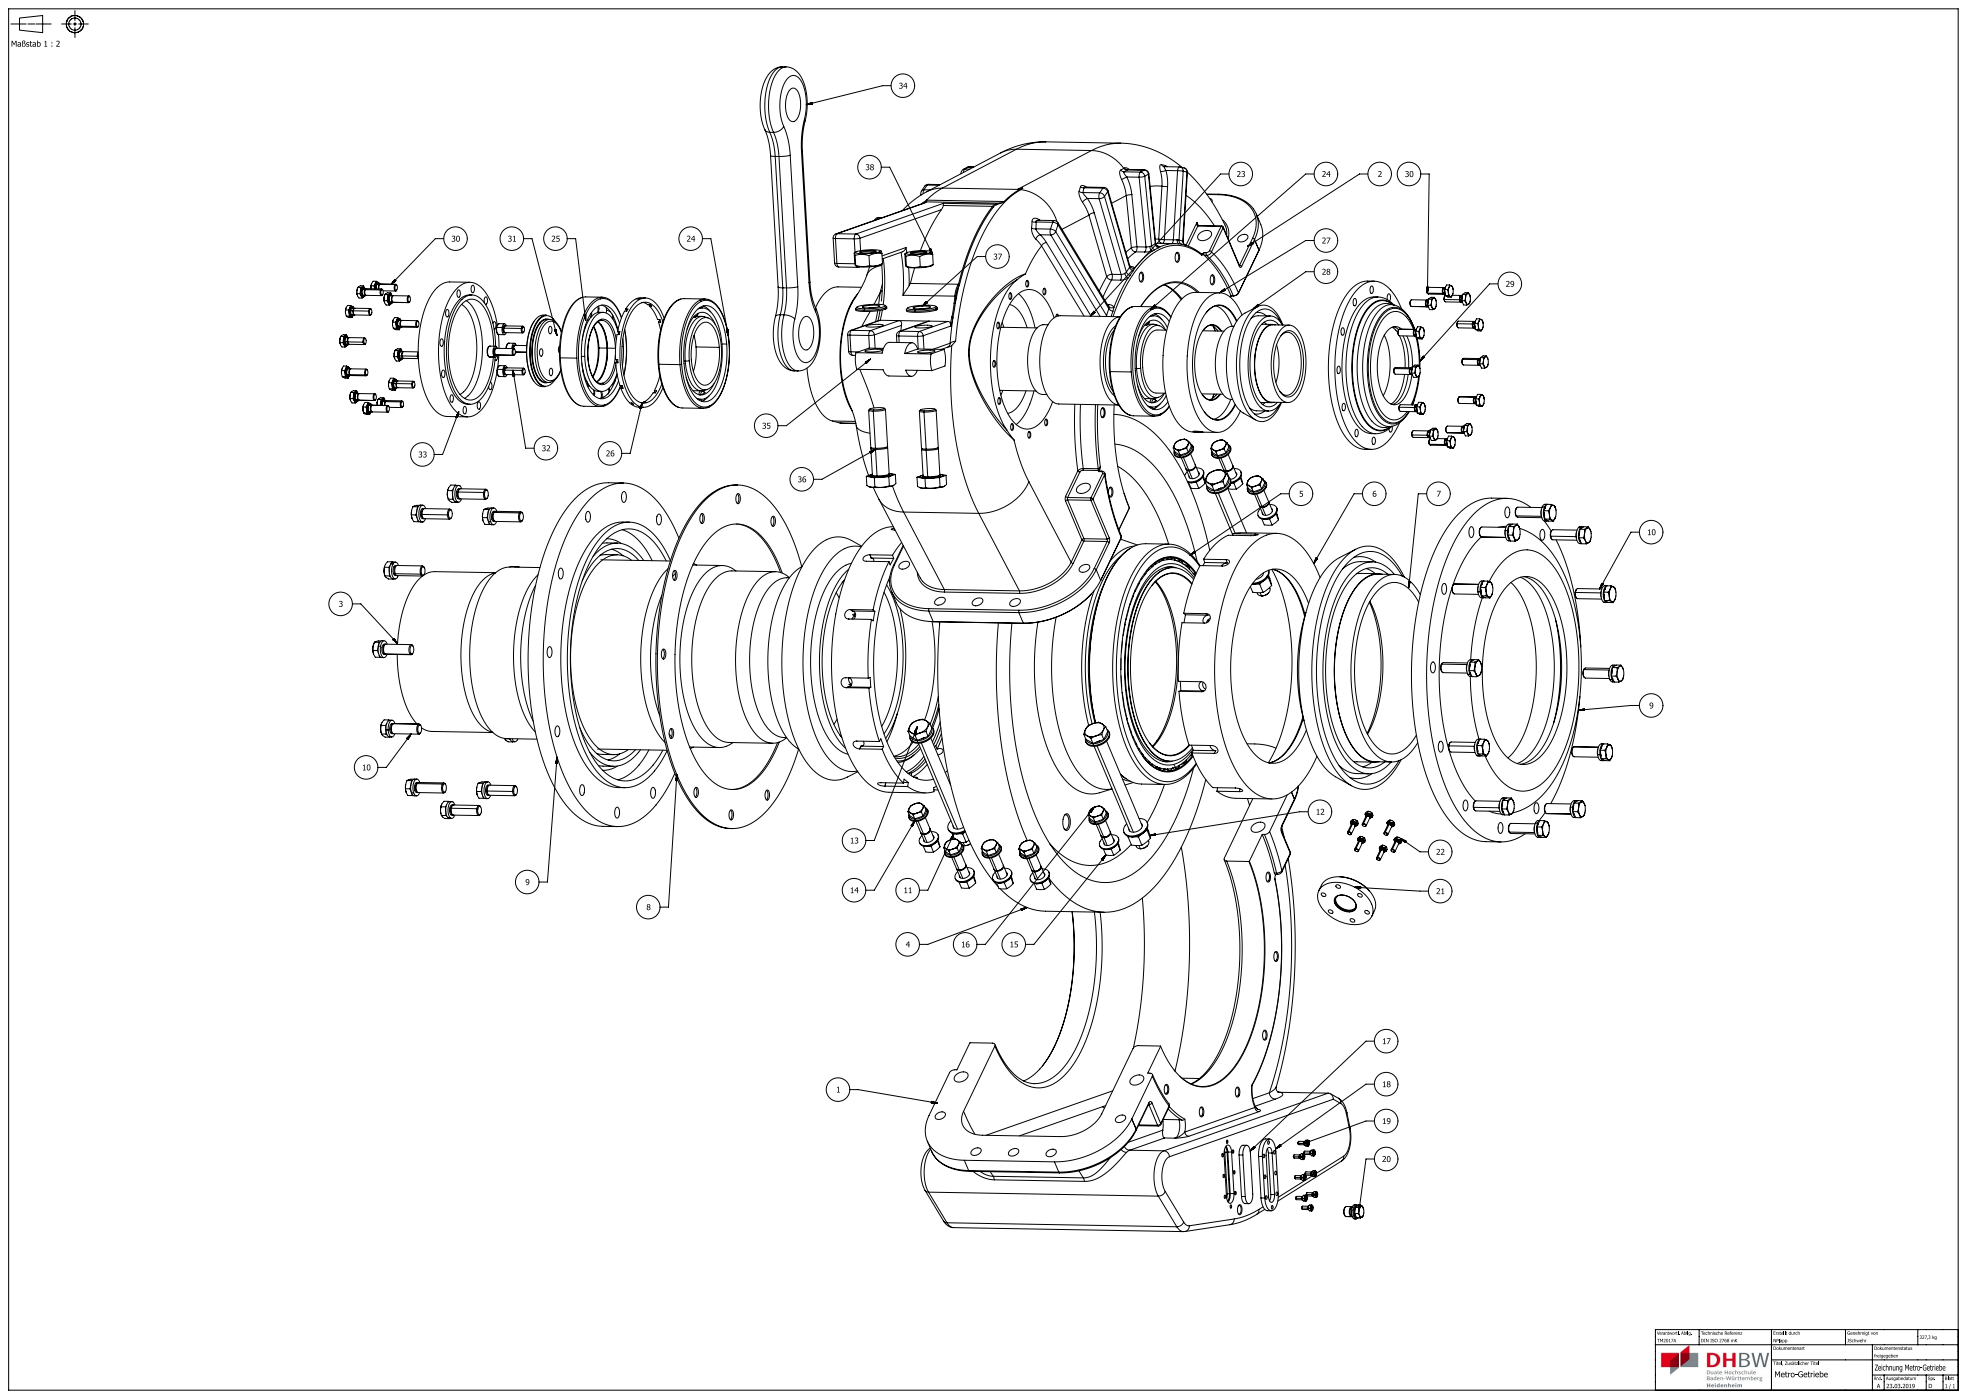
[picture p216: page 1]
