MattdewT/KE4/ALT_KE/TM2017/Plapp/KE4/nicop_Zeichnung Metro-Getriebe2.pdf

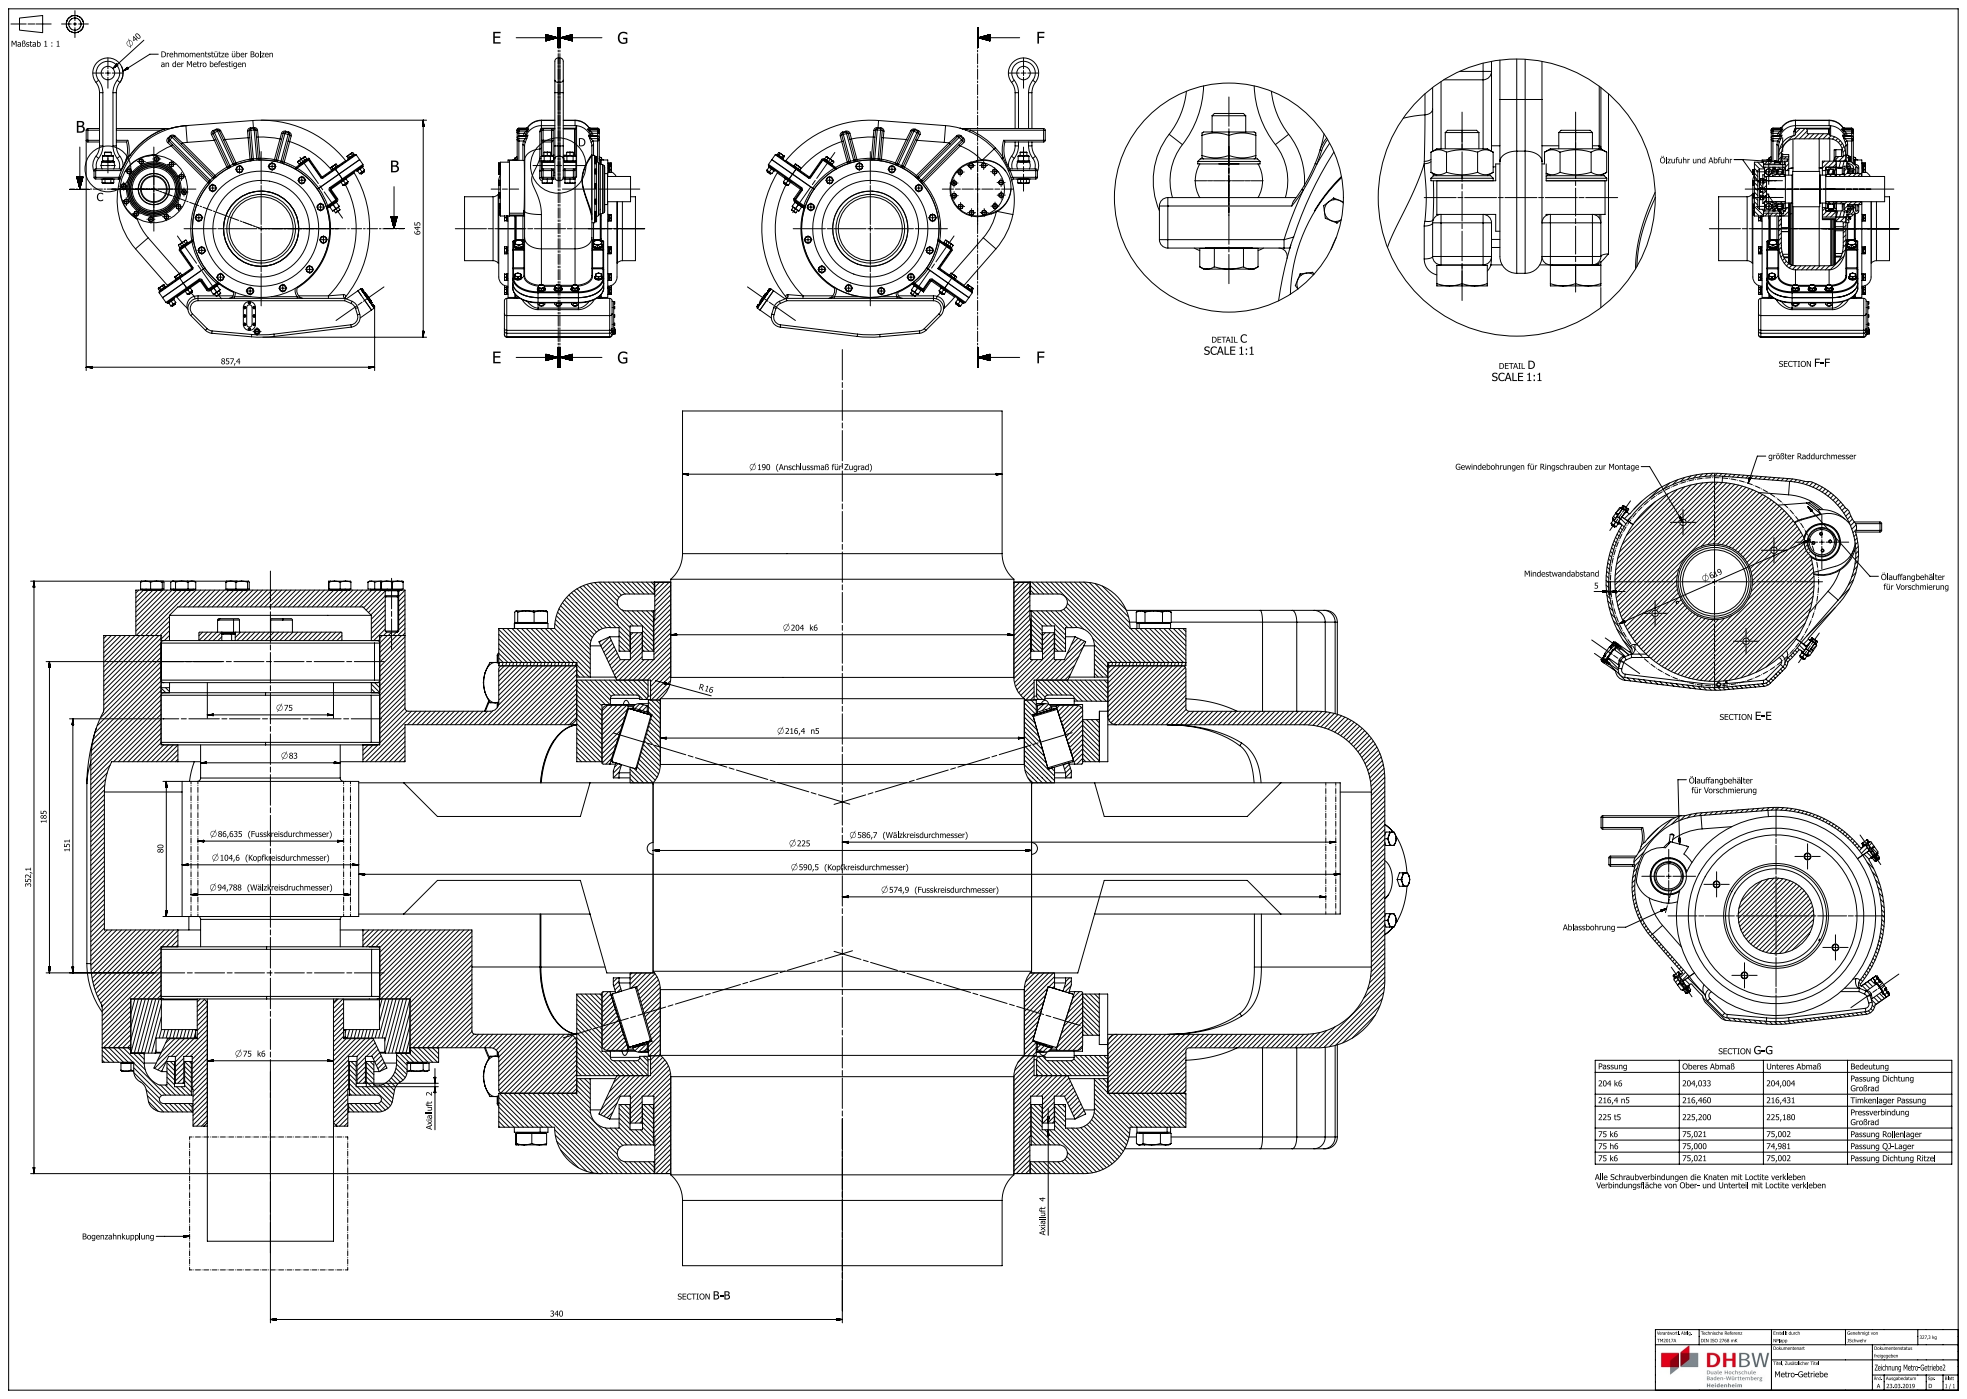
[picture p217: page 1]
