MattdewT/KE4/(commit log)

2020-01-07 temporäre office datein in die gitignore hinzugefügt
2020-01-09 Zahnräder vorselektion
    [TabelleModule.xlsx]
2020-01-10 Erster Ritzel Modul 5
    19 Zähne
    82 Zähnebreite
    Modul 5
    Kopfkreisdurchmesser 110.4
    [Ritzel_Z19_KD110_4_B82_M5.prt]
2020-01-12 Korrektur der Zähnevariation
2020-01-15 Zahnräder für Modul 4.5 erstellt und eine Test BG
    [Ritzel_Z21_KD109_2_B77_M4_5.prt, System.prt, Zahnrad_Z129_KD608_B75_M4_5.prt]
2020-01-15 Zahnrad zugeschnitten
    [Zanhrad.prt]
2020-01-15 Checkliste und Projektzeitplan erstellt
    [Projektzeitplan.xlsx]
2020-01-16 Bilder Lager und Öllauf
    [Antriebslager-Berechnungen.xlsx]
2020-01-16 Checkliste aktualisiert, Excel-Blatt für Pressverband gedownloaded
    [Kopie von 09-pressv10.xlsx]
2020-01-16 Timken Kugellager
    [Timken_Lager_B-150223_214.stp]
2020-01-16 Traglöcher und Schmiernut fürs Zahnrad
2020-01-16 Labyrinthdichtung_Rad_Wellenseite_links erstellt, Testbaugruppe angefangen
    [Labyrinthdichtung_Rad_Wellenseite_links.prt, Testbaugruppe_Rad_Dichtungen.prt]
2020-01-16 Stützring, Radlager und Lade Optionen
    [Stuetzring_Rad.prt, USM-44188_A.prt, USM-44189_A.prt, USM-44190_A.prt, USM-44191_A.prt, USM-44192_A.prt]
2020-01-16 Aktualisierte CAD Teile
    [Labyrinthdichtung_Rad_Gegenstueck_links.prt, Labyrinthdichtung_Rad_Wellenseite_links.prt, Testbaugruppe_Rad_Dichtungen.prt]
2020-01-16 Stützring in Testbaugruppe eingebaut
    [Stuetzring_Rad.prt, Testbaugruppe_Rad_Dichtungen.prt]
2020-01-16 Labyrinthdichtungen geändert
    [Labyrinthdichtung_Rad_Gegenstueck_links.prt, Labyrinthdichtung_Rad_Wellenseite_links.prt]
2020-01-16 Radialspiel korrigiert
    [Stuetzring_Rad.prt]
2020-01-16 Revert "Update Testbaugruppe_Rad_Dichtungen.prt"
    This reverts commit c0928ffcf3285a24f7ffa34051620fc66f0b26db.
    [Testbaugruppe_Rad_Dichtungen.prt]
2020-01-16 Labyrinthdichtungen aktualisiert
    [Labyrinthdichtung_Rad_Gegenstueck_links.prt, Labyrinthdichtung_Rad_Wellenseite_links.prt, Testbaugruppe_Rad_Dichtungen.prt]
2020-01-16 Schraubenberechnungen
    Noch nicht fertig, weil fehlende Belastungen
    [Schraubenberechnung.xlsm]
2020-01-16 Lager verbessert
    Immer noch zu hohe Lebensdauer
    [Antriebslager-Berechnungen.xlsx]
2020-01-20 Masse korrigiert und auf ganze Werte angepasst
    [Labyrinthdichtung_Rad_Gegenstueck_links.prt, Labyrinthdichtung_Rad_Wellenseite_links.prt, Stuetzring_Rad.prt, Testbaugruppe_Rad_Dichtungen.prt]
2020-01-20 Wellen erstellt und neue Lager ausgewählt
    Wegen Lagerschulter
    [Welle_Abtrieb.prt, Welle_Antrieb.prt]
2020-01-20 Lagersitz vereinheitlicht
    [Deckel_Antrieb.prt]
2020-01-20 Baugruppe begonnen und Schrauben für Lagersicherungs
    [Baugruppe_SFAG.prt, Schraube Lagerungssicherung.prt, Welle_Abtrieb.prt]
2020-01-20 Excel Lager, neue Werte
    [Antriebslager-Berechnungen.xlsx]
2020-01-20 Baugruppe Rad-Dichtungen zur Gesamtbaugruppe hinzugefügt
    und gespiegelt
    [Baugruppe_SFAG.prt, mirror_Labyrinthdichtung_Rad_Gegenstueck_links.prt, mirror_Labyrinthdichtung_Rad_Wellenseite_links.prt, mirror_Stuetzring_Rad.prt, mirror_Testbaugruppe_Rad_Dichtungen.prt, mirror_Testbaugruppe_Rad_Dichtungen_0.prt, mirror_USM-44188_A.prt, mirror_USM-44188_A_0.prt]
2020-01-20 Schraubenfreiraum geschaffen
    [Deckel_Antrieb.prt]
2020-01-21 CAD lagerdatei
    [Distanzring_mitNuten.prt]
2020-01-21 Testbaugruppe_Antrieb_Dichtungen erstellt und Anpassungen vorgenommen
    [Labyrinthdichtung_Antrieb_Gegenstueck_links.prt, Labyrinthdichtung_Antrieb_Wellenseite_links.prt, Stuetzring_Antrieb.prt, Testbaugruppe_Antrieb_Dichtungen.prt]
2020-01-21 muss es hochladen, da sonst komische Fehlermeldung kommt
    [Distanzring_mitNuten.prt]
2020-01-21 CAD_Dateien Lager
    [Axiallager_qj215-xl-tvp_x_t.prt, Zylinderrollenlager_nu2215-e-xl-tvp2_x_t.prt]
2020-01-21 Lagerzubehör
    [NU2215-E-XL-TVP2_01_id30_x_t.prt, NU2215-E-XL-TVP2_02_id26_x_t.prt, NU2215-E-XL-TVP2_03_id22_x_t.prt, NU2215-E-XL-TVP2_04_id18_x_t.prt, NU2215-E-XL-TVP2_05_id14_x_t.prt, NU2215-E-XL-TVP2_06_id10_x_t.prt, NU2215-E-XL-TVP2_07_id6_x_t.prt, QJ215-XL-TVP_01_id78_x_t.prt]
2020-01-21 Zylinderlager in Testbaugruppe_Antrieb_Dichtungen eingebaut und Anpassungen vorgenommen
    [Baugruppe_SFAG.prt, Labyrinthdichtung_Antrieb_Gegenstueck_links.prt, Labyrinthdichtung_Antrieb_Wellenseite_links.prt, Stuetzring_Antrieb.prt, Testbaugruppe_Antrieb_Dichtungen.prt, Testbaugruppe_Rad_Dichtungen.prt, Welle_Abtrieb.prt, Zylinderrollenlager_nu2215-e-xl-tvp2_x_t.prt]
2020-01-22 Bohrungen für Sicherungsteil in Antriebswelle
    [Welle_Antrieb.prt]
2020-01-22 zeichnung Labyrinthdichtung Antrieb
    [Antrieb_Dichtungen_dwg.prt, Labyrinthdichtung_Antrieb_Wellenseite_links.prt, Testbaugruppe_Antrieb_Dichtungen.prt]
2020-01-22 Ränder bereinigt
    [Antrieb_Dichtungen_dwg.prt]
2020-01-22 Anforderungsliste und Welle in Kisssoft
    [Anforderungsliste.xlsx]
2020-01-22 Zahnrad Zeichnung und CAD Anpassung
    Oberer Durchmesser abgerundet
    M16 Bohrungen durchgebohrt
    [Zanhrad_dwg1.prt]
2020-01-22 Mass angepasst
    [Zanhrad_dwg1.prt]
2020-01-22 Zahnrad - Phase hinzugefügt
    [Zanhrad_dwg1.prt]
2020-01-22 geringe Anpassungen
    [Antrieb_Dichtungen_dwg.prt, Testbaugruppe_Antrieb_Dichtungen.prt]
2020-01-22 Morphologischer Kasten
    [Anforderungsliste.xlsx]
2020-01-22 Dokumentation erweitert und Berechnung in Excel zu Längspressverband verbessert
    [Längspressverband_Auslegungsmoment.xlsx]
2020-01-22 Tabelle Module hübsch gemacht, Kap. 2.1 bis 2.4
    [TabelleModule.xlsx]
2020-01-23 Gesamtbaugruppe erweitert
    [Baugruppe_SFAG.prt, Baugruppe_SFAG_dwg1.prt, Testbaugruppe_Antrieb_Dichtungen.prt, Testbaugruppe_Lager_Antrieb_Radseite.prt]
2020-01-23 Baugruppe Welle_Abtrieb aufgelöst
    [Baugruppe_SFAG.prt, Welle_Abtrieb.prt]
2020-01-23 Lagersicherung erstellt und eingebaut
    Wellenlänge angepasst, Schrauben rausgesucht
    [Baugruppe_SFAG.prt, Lagersicherung.prt, Lagersicherung_Schraube.prt, Schraube Lagerungssicherung.prt, Sechskantschraube DIN ≈933 M8x20 01238_080_020 (High).prt, Welle_Antrieb.prt]
2020-01-23 erste gesamtzeichnung
    [Baugruppe_SFAG_dwg1.prt]
2020-01-23 Gewichtskraftfoto in die Doku eingefügt
2020-01-24 Stützring verlängert für Ölbohrung
    [Stuetzring_Antrieb.prt]
2020-01-24 Borungen in die Labyrinthdichtung Abtrieb eingefügt
    [Baugruppe_SFAG.prt, Labyrinthdichtung_Antrieb_Wellenseite_links.prt, Labyrinthdichtung_Rad_Gegenstueck_links.prt, Stuetzring_Rad.prt, Testbaugruppe_Antrieb_Dichtungen.prt, Testbaugruppe_Rad_Dichtungen.prt]
2020-01-24 Drehmomentstütze angefangen
    Verrundungen fehlen
    [Drehmomentstütze.prt]
2020-01-27 Projektbericht kräfte aktualisiert und drehmomentstütze
    [Drehmomentstütze.prt]
2020-01-27 Kräfte auf die Drehmomentstütze angepasst
2020-01-27 Drehmomentbuchse und Bolzen erstellt und rausgesucht
    Berechnung für Bolzen mit Excel
    [Bolzen Drehmomentstütze.prt, Bolzen_Drehmomentstütze.xlsx, Silentbuchse.prt]
2020-01-27 gehäuse in baugruppe eingebaut
    [Baugruppe_SFAG.prt, mirror_Testbaugruppe_Rad_Dichtungen_0.prt]
2020-01-27 Lagerabstsand auf 180 gesetzt
    und Zahnrad darauf angepasst
    [Baugruppe_SFAG.prt]
2020-01-27 Gehäuse vereinfacht und eingebaut
    [Baugruppe_SFAG.prt, Gehäuse.prt]
2020-01-27 Ölläufe in Stützring eingefügt
    und Sicherungsstift
    [Stuetzring_Antrieb.prt]
2020-01-27 Ölläufe der Antriebsdichtung ausgerichtet
    [Labyrinthdichtung_Antrieb_Wellenseite_links.prt]
2020-01-27 Gehäuse Ölwanne Timkenlager hinzugefügt
    [Gehäuse.prt]
2020-01-27 Zwangsbedingungen überarbeitet für besseren Öllauf
    [Testbaugruppe_Rad_Dichtungen.prt]
2020-01-27 Ölzulauf der Timkenlager links ausgerichtet
    [Baugruppe_SFAG.prt, Gehäuse.prt, Testbaugruppe_Antrieb_Dichtungen.prt, Testbaugruppe_Rad_Dichtungen.prt]
2020-01-27 Mindestradius des Gehäuse beim Zahnrad korriegiert
    von 312 auf 314,5
    [Gehäuse.prt]
2020-01-27 Bohrung vedreht um Platz für Entlüftung Abtrieb zu schaffen
    [Testbaugruppe_Rad_Dichtungen.prt]
2020-01-27 Entlüftung Abtrieb
    [Stuetzring_Rad.prt]
2020-01-27 Zwangsbedingung Lager mirrow überarbeitet
    [mirror_Testbaugruppe_Rad_Dichtungen_0.prt]
2020-01-27 Öllauf Radseite ausgerichtet und Zahnräder ausgerichtet
    [Baugruppe_SFAG.prt, Testbaugruppe_Rad_Dichtungen.prt]
2020-01-27 Radseite Buagruppe korrigiert und Ausrichtung für schnittansicht aufgeräumt
    [Baugruppe_SFAG.prt, Testbaugruppe_Rad_Dichtungen.prt, mirror_Testbaugruppe_Rad_Dichtungen_0.prt]
2020-01-27 Zeichnungen aktualisiert und Gehäusekörper verreinigt
    [Antrieb_Dichtungen_dwg.prt, Baugruppe_SFAG.prt, Baugruppe_SFAG_dwg1.prt, Gehäuse.prt, Zanhrad_dwg1.prt]
2020-01-27 Ovale Verstärkung vergößert
    es müssen achsabstande zwischen 340 - 360 verbaut werden können
    [Gehäuse.prt]
2020-01-27 Öllauf Bohrungen hinzugefügt
    [Gehäuse.prt]
2020-01-27 Revolve operationen neu angeordnet
    [Gehäuse.prt]
2020-01-27 Masse Lagersitz Antrieb gegeben
    [Baugruppe_SFAG.prt, Gehäuse.prt]
2020-01-28 Doku zu Pressverbindung fertig gestellt, Fehler in Excel ausgebessert
    [Längspressverband_Auslegungsmoment.xlsx]
2020-01-28 Zeichnungsableitung dichtung abtrieb und gehäuse
    [Baugruppe_SFAG.prt, Gehäuse.prt, Labyrinthdichtung_Antrieb_Wellenseite_links.prt, Testbaugruppe_Rad_Dichtungen.prt]
2020-01-29 Zawangsbedingung hinzugefügt Welle Batrieb
    [Baugruppe_SFAG.prt]
2020-01-29 Wellenradius verändert (Lagerradius 3.3 max.)
    [Welle_Abtrieb.prt]
2020-01-29 Drehmomentstütze angepasst und Baugruppe mit Buchsen und Bolzen erstellt
    [Bolzen Drehmomentstütze.prt, Drehmomentstütze.prt, Drehmomentstütze_BG.prt]
2020-01-29 Zwangsbedingung für die Lagerabstände angepasst und Zahnrasgeometrie angepasst
    [Baugruppe_SFAG.prt, Drehmomentstütze_BG.prt, Testbaugruppe_Rad_Dichtungen.prt, Welle_Abtrieb.prt]
2020-01-29 Welle Abtrieb: Zahnradsitzlänge angepasst
    [Baugruppe_SFAG.prt, Welle_Abtrieb.prt]
2020-01-29 Welle Abtrieb: Lagersitzlängen angepasst
    [Baugruppe_SFAG.prt, Welle_Abtrieb.prt]
2020-01-29 Welle Abtrieb: Radien
    [Baugruppe_SFAG.prt, Welle_Abtrieb.prt]
2020-01-29 Drehmomentstütze Versteifung
    [Drehmomentstütze.prt]
2020-01-29 NU215 statt NU2215, BGR Lager Antrieb Radseite aufgelöst
    NU215 statt NU2215 eingebaut, Lagerabstände soweit wie möglich angepasst, Welle verkürzt
    [Baugruppe_SFAG.prt, NU215.prt, Welle_Antrieb.prt]
2020-01-29 Welle Antrieb: Lagerschultern und Nut angepasst
    [Baugruppe_SFAG.prt, Welle_Antrieb.prt]
2020-01-29 zweiter versuch am gehäuse
    [Gehäuse_v2.prt]
2020-01-29 Grundstruktur fertig
    [Gehäuse_v2.prt]
2020-01-30 Neues Gehäuse eingebaut
    [Baugruppe_SFAG.prt]
2020-01-30 Ölrinne hinzugefügt
    [Baugruppe_SFAG.prt, Gehäuse_v2.prt]
2020-01-30 Öllaufidee, die noch nicht 100Prozent funktioniert
    [Gehäuse_Idee_Anika.prt]
2020-01-30 NU215 statt NU2215 auf Innenseite eingebaut
    Gehäuse, Stützring und Welle müsen noch angepast werden
    [Baugruppe_SFAG.prt, Testbaugruppe_Antrieb_Dichtungen.prt]
2020-02-01 zahnrad zeichnung aktualisiert
    [Zanhrad_dwg1.prt]
2020-02-03 Ölläufe ausgerichtet und Gehäuse vereinfacht
    [Baugruppe_SFAG.prt, Gehäuse_v2.prt, Testbaugruppe_Antrieb_Dichtungen.prt, Testbaugruppe_Rad_Dichtungen.prt, mirror_Testbaugruppe_Rad_Dichtungen_0.prt]
2020-02-03 Öllauf Bohrungen erneut hinzugefügt
    auf Antrieb und Abtriebseite
    [Gehäuse_v2.prt]
2020-02-03 Ölauffang konstruiert
    [Gehäuse_v2.prt]
2020-02-03 Ölpressverband Excel
    [Ölpressverband.xlsx]
2020-02-03 Speichern vergessen
    [Ölpressverband.xlsx]
2020-02-03 Zeichnung von Baugruppe angefangen für Handskizze (Lager)
    [Baugruppe_SFAG.prt]
2020-02-04 Öllauf Zeichnung angefangen
    [Gehäuse_v2.prt, Öllauf_dwg.prt]
2020-02-04 Zeichenrahmen entfernt
    [Öllauf_dwg.prt]
2020-02-04 Zeichnungskorrektur Öllauf
    Doppelte Bauteile entfernt
    [Baugruppe_SFAG.prt, Testbaugruppe_Rad_Dichtungen.prt, Öllauf_dwg.prt]
2020-02-05 Presspassung hergestellt
    [Lagersicherung.prt]
2020-02-05 Radius als Passungsabgrenzung
    [Welle_Antrieb.prt]
2020-02-05 Änderungen wegen Lager NU215 statt NU2215
    Wellenschulter Innen angepasst
    [Welle_Antrieb.prt]
2020-02-05 Änderungen wegen Lager NU215 statt NU2215
    Dichtungen verkürzt und nach innen gerückt
    [Baugruppe_SFAG.prt, Gehäuse_v2.prt, Labyrinthdichtung_Antrieb_Wellenseite_links.prt, Stuetzring_Antrieb.prt, Testbaugruppe_Antrieb_Dichtungen.prt]
2020-02-05 Distanzring Antrieb innen erstellt und eingebaut
    [Baugruppe_SFAG.prt, Distanzring_Antrieb_innen.prt]
2020-02-05 Anforderungsliste weiterbearbeitet
    [Anforderungsliste.xlsx]
2020-02-07 alt ke
    [1.prt, 2.prt, Abtriebswelle.prt, Abziehblech.prt, Abziehblech_Ritzelwelle.prt, Deckel_Ritzelwelle.prt, Distanzring_außen.prt, Distanzring_innen.prt]
2020-02-07 Berechnungsvariante auf 90% der Streckgrenze statt Montagevorspannkraft geändert
2020-02-07 Drehzahlen in die Übersicht eingefügt, Erläuterungen
2020-02-07 Straßenrad konstruiert
    [Straßenrad.prt]
2020-02-07 Wellle mit Rad
    [Welle_Lang.prt]
2020-02-07 Größtes und kleinstes Zahnrad erstellt
    [Größtes Ritzel_127.prt, Größtes_Zahnrad_619.prt]
2020-02-07 alles auf R16 gesetzt
    [Welle_Abtrieb.prt, Welle_Antrieb.prt]
2020-02-07 Ölwanne
    [Gehäuse_v2.prt]
2020-02-07 Drehmomentstütze zum Test eingebaut
    [Baugruppe_SFAG.prt, Gehäuse_v2.prt]
2020-02-11 Gehäuseteilung unter 45° Winkel -> Unterteil angefangen ; Montageanleitung Entwurf angefangen
    [Gehäuse_geteilt_Unterteil.prt]
2020-02-11 Normteile fürs Gehäuse rausgesucht
    Magnetstopfen, Ölablassventil, Ölschauglas und Einfülldeckel
    [Magnetic plug GN 738-26-M20x1,5.prt, Oelablassventil GN 880-M20x1,5-ST-K_dk.prt, Oelablassventil GN 880-M20x1,5-ST-K_v.prt, Oil drain valve GN 880-M20x1,5-ST-K.prt, Oil level sight glass GN 542-NO-25-35-B.prt, Plug GN 548_2-M60x2.prt]
2020-02-12 Distanzringe auf t=6mm
    [Distanzring_Antrieb_innen.prt, Distanzring_mitNuten.prt]
2020-02-12 Öllauf Gehäuse erweitert auf Radseite
    [Gehäuse_v2.prt]
2020-02-12 Laminumringe entworfen
    [Laminumring_Abtrieb.prt, Laminumring_Antrieb.prt]
2020-02-12 Projektzeitplan blaue Blöcke
    [Projektzeitplan.xlsx]
2020-02-12 Gehäuse
    [Baugruppe_SFAG.prt, Gehäuse_v2.prt]
2020-02-13 Lager NU2215 wieder eingebaut, Änderung an Welle Antrieb, Gehäuse, Deckel
    an Matthias: Ölbohrung im Lagersitz Antrieb Radseite liegt jetzt genau auf dem Absatz zwischen Vierpunkt- und Zylinderrollenlager
    [Baugruppe_SFAG.prt, Deckel_Antrieb.prt, Gehäuse_v2.prt, Welle_Antrieb.prt]
2020-02-13 Schraubenberechnung an "neue" Verzahnungskräfte angepasst und auf 4 Schruaben aufgeteilt
2020-02-17 Bille erläutert und Stückliste angefangen
    [Stückliste.xls]
2020-02-18 Ölauslauf Antrieb Innen
    [Deckel_Antrieb.prt, Gehäuse_v2.prt]
2020-02-20 Gehäuse und Öl erläutert
2020-02-22 Benötigte Schrauben markiert und Muttern/Scheiben dazu gesucht
2020-02-24 Gehäuse Flanschen Hinzugefügt
    [Baugruppe_SFAG.prt, Gehäuse_v2.prt, Labyrinthdichtung_Antrieb_Gegenstueck_links.prt, Testbaugruppe_Antrieb_Dichtungen.prt]
2020-02-24 Ölwanne Antrieb verkürtzt
    diese war im zusammenbau mit dem Ritzel im Weg
    [Gehäuse_v2.prt]
2020-02-24 Flansch Anfang
    [Baugruppe_SFAG.prt, Gehäuse_v2.prt, Testbaugruppe_Rad_Dichtungen.prt]
2020-02-25 Ölablassschraube und Magnetstopfen eingebaut
    [Gehäuse_v2.prt]
2020-02-25 Wasserauslass an der Antriebsdichtung
    [Labyrinthdichtung_Antrieb_Gegenstueck_links.prt]
2020-02-25 Öleinfüllbohrung
    [Gehäuse_v2.prt]
2020-02-25 erste Zeichnung
    [Baugruppe_SFAG_dwg1.prt]
2020-02-25 Öleinfüllbohrung Außengewinde hinzugefügt
    [Gehäuse_v2.prt]
2020-02-25 Wasserablaufbohrungen Abtrieb
    [Labyrinthdichtung_Antrieb_Gegenstueck_links.prt, Labyrinthdichtung_Rad_Gegenstueck_links.prt, Testbaugruppe_Antrieb_Dichtungen.prt, Testbaugruppe_Rad_Dichtungen.prt, mirror_Testbaugruppe_Rad_Dichtungen_0.prt]
2020-02-25 Montageanleitung weiter
    [Schraubenberechnung.xlsm]
2020-02-25 Ölschauglas auf andere Gehäuseseite
    [Gehäuse_v2.prt]
2020-02-25 Normteile Schrauben
    [Mutter_M10.prt, Mutter_M20.prt, Sechskantschraube_M10x60.prt, Sechskantschraube_M16x60.prt, Sechskantschraube_M20x120.prt, Unterlegscheibe_M10.prt, Unterlegscheibe_M16.prt, Unterlegscheibe_M20.prt]
2020-02-25 angefangen, Lager zu ersetzen
    [Labyrinthdichtung_Antrieb_Wellenseite_links.prt, Stuetzring_Antrieb.prt, Testbaugruppe_Antrieb_Dichtungen.prt, Welle_Antrieb.prt]
2020-02-26 Laminumringe geteilt
    Die Laminumringe sind jetzt mit einem Spalt von 0.5 mm Breite versehen (wg. erleichtertem Einbau)
    [Laminumring_Abtrieb.prt, Laminumring_Antrieb.prt]
2020-02-26 Lagerseite innen fertig angepasst
    [Gehäuse_v2.prt]
2020-02-26 Lager außen ausgetauscht
    [Gehäuse_v2.prt, Welle_Antrieb.prt]
2020-02-26 Bohrungen angepasst
    [Gehäuse_v2.prt]
2020-02-26 Gehäuse bearbeitet
    Sicherungskopie Durchmesser des Lagersitz (Innenseite) muss angepasst werden
2020-02-26 Bolzen Drehmomentstütze fertigungstechnisch vereinfacht
    [Bolzen Drehmomentstütze.prt]
2020-02-26 Schrauben an Antriebs/Abtriebs Deckel und Drehmoment Schrauben, Muttern und Unterlegscheiben eingefügt
    [Deckel_Antrieb.prt, Labyrinthdichtung_Antrieb_Gegenstueck_links.prt, Labyrinthdichtung_Rad_Gegenstueck_links.prt, Sechskantschraube_M10x40.prt, Testbaugruppe_Antrieb_Dichtungen.prt, Welle_Abtrieb.prt]
2020-02-26 Abstand Antriebsseite, zwischen Gehäuse und Labyrinthdichtung gegenstück angepasst
    [Labyrinthdichtung_Antrieb_Gegenstueck_links.prt, Labyrinthdichtung_Rad_Gegenstueck_links.prt]
2020-02-26 Projektbericht viele Bildle und Erläuterungen
2020-02-26 Laminumringe eingebaut und Abstand dafür eingefügt
    [Stuetzring_Antrieb.prt, Testbaugruppe_Antrieb_Dichtungen.prt]
2020-02-26 Gehäuse: Für NU2215 Material weggenommen (unten)
    Nochmal gucken, weil 4-8 Uhr Rinne jetzt schmaler ist
2020-02-26 Revert "Gehäuse: Für NU2215 Material weggenommen (unten)"
    This reverts commit d3c58d5fac808044a0838c2b012faae43d839756.
2020-02-26 Für NU2215 Material weggenommen (Versuch 2)
2020-02-27 Quader in der Gehäusemitte entfernt
    war da wegen waagerechtem Flansch
2020-02-27 Nochmal ein paar Muttern und Unterlegscheiben eingebaut
    Flansch der Ankerschrauben zurück auf 160 mm geändert
    [Sechskantschraube_M20x220.prt]
2020-02-28 Gehäuseflanschbohrungen und -verstiftungen angepasst
2020-03-02 Ausrichtung der Unterbaugruppe Antrieb Dichtungen repariert
    [Labyrinthdichtung_Antrieb_Gegenstueck_links.prt, Labyrinthdichtung_Antrieb_Wellenseite_links.prt, Testbaugruppe_Antrieb_Dichtungen.prt]
2020-03-02 Bolzen erstellt und eingebaut
    [Bolzen 8x40.prt]
2020-03-02 Stückliste ergänzt
    [Stückliste.xls]
2020-03-02 Rechtschreibfehler in der Einleitung verbessert
2020-03-02 "Anweisungen" eingefügt und Rechtschreibfehler korrigiert
2020-03-03 Gehäuse Ölfang fertig bis auf ein Subtrahieren, das nicht will
    auf der Antriebsseite
2020-03-03 Drehmomentstütze länger gemacht und eingebaut
    [Drehmomentstütze.prt, Drehmomentstütze_BG.prt]
2020-03-03 Kapitel 5 bis auf die Bilder fertig
2020-03-04 löcher in der wandstärke entfernt
2020-03-04 lagersitz frei gedreht und überlappenden ölfang entfernt
2020-03-04 überstehender öllauf auf der gehäuseausenseite entfernt
2020-03-04 spalt an der flansch geschlossen
2020-03-04 Anforderungsliste einfügt
    [Anforderungsliste.xlsx]
2020-03-04 Stücklistennormen ergänzt
    [Stückliste.xls]
2020-03-05 Einbauen Gehäusehälften und spiegeln
    [SpiegelnAxiallager_qj215-xl-tvp_x_t.prt, SpiegelnDrehmomentstütze_BG.prt, SpiegelnTestbaugruppe_Antrieb_Dichtungen.prt, SpiegelnTestbaugruppe_Rad_Dichtungen.prt, SpiegelnUSM-44188_A.prt, SpiegelnZylinderrollenlager_nu2215-e-xl-tvp2_x_t.prt, Spiegelnmirror_Testbaugruppe_Rad_Dichtungen_0.prt, Spiegelnmirror_USM-44188_A_0.prt]
2020-03-05 gespiegelte geteilte Baugruppe
    [SpiegelnAxiallager_qj215-xl-tvp_x_t.prt, SpiegelnDrehmomentstütze_BG.prt, SpiegelnTestbaugruppe_Antrieb_Dichtungen.prt, SpiegelnTestbaugruppe_Rad_Dichtungen.prt, SpiegelnUSM-44188_A.prt, SpiegelnZylinderrollenlager_nu2215-e-xl-tvp2_x_t.prt, Spiegelnmirror_Testbaugruppe_Rad_Dichtungen_0.prt, Spiegelnmirror_USM-44188_A_0.prt]
2020-03-05 Odner umbenant und ungespiegelte Konstruktion entfernt
    [mirror_Axiallager_qj215-xl-tvp_x_t.prt, mirror_Bolzen 8x40.prt, mirror_Bolzen 8x40_0.prt, mirror_Bolzen Drehmomentstütze.prt, mirror_Bolzen Drehmomentstütze_0.prt, mirror_Deckel_Antrieb.prt, mirror_Distanzring_Antrieb_innen.prt, mirror_Distanzring_mitNuten.prt]
2020-03-05 Revert "Odner umbenant und ungespiegelte Konstruktion entfernt"
    This reverts commit fa28c292d7c54b28eab70cf4216d502e1d1f3129.
    [mirror_Axiallager_qj215-xl-tvp_x_t.prt, mirror_Bolzen 8x40.prt, mirror_Bolzen 8x40_0.prt, mirror_Bolzen Drehmomentstütze.prt, mirror_Bolzen Drehmomentstütze_0.prt, mirror_Deckel_Antrieb.prt, mirror_Distanzring_Antrieb_innen.prt, mirror_Distanzring_mitNuten.prt]
2020-03-05 Revert "gespiegelte geteilte Baugruppe"
    This reverts commit 96d8770784c43ed6a04b5aebc98c4c474366e90c.
    [SpiegelnAxiallager_qj215-xl-tvp_x_t.prt, SpiegelnDrehmomentstütze_BG.prt, SpiegelnTestbaugruppe_Antrieb_Dichtungen.prt, SpiegelnTestbaugruppe_Rad_Dichtungen.prt, SpiegelnUSM-44188_A.prt, SpiegelnZylinderrollenlager_nu2215-e-xl-tvp2_x_t.prt, Spiegelnmirror_Testbaugruppe_Rad_Dichtungen_0.prt, Spiegelnmirror_USM-44188_A_0.prt]
2020-03-05 Finale Baugruppe angefangen
    [BGR_Schienenfahrzeugachsgetriebe.prt]
2020-03-05 gehäuse gespiegelt
    [gehause_zusammenbau.prt, mirror_Gehäuse_v2_oben.prt, mirror_Gehäuse_v2_unten.prt]
2020-03-05 Neue BGR erweitert
    [BGR_Schienenfahrzeugachsgetriebe.prt, Testbaugruppe_Rad_Dichtungen.prt, Zylinderrollenlager_nu2215-e-xl-tvp2_x_t.prt, mirror_Gehäuse_v2_oben.prt, mirror_Gehäuse_v2_unten.prt]
2020-03-05 Finale BGR erweitert
    [BGR_Schienenfahrzeugachsgetriebe.prt, Labyrinthdichtung_Rad_Gegenstueck_links.prt, Testbaugruppe_Rad_Dichtungen.prt]
2020-03-05 gehäuseanpassungen
    [gehause_zusammenbau.prt, mirror_Gehäuse_v2_oben.prt, mirror_Gehäuse_v2_unten.prt]
2020-03-05 Entlüftungsschraube
    [Entlüftungsschraube GN 552-31-M20x1,5-A-1.prt]
2020-03-05 Änderungen für Demozwecke
    [Größtes Ritzel_127.prt, Größtes_Zahnrad_619.prt]
2020-03-05 Kapitel 5.2 und 5.3 Grafiken
2020-03-05 Grafiken Ölstand Blender
    [Gehäuse_v2.stl, Gehäuse_v2_bk.stl, fluid_gehäuse.blend]
2020-03-05 Labyrinthdichtung mit Spalt für Laminoring
    [Labyrinthdichtung_Rad_Gegenstück_Lamino.prt, Labyrinthdichtung_Rad_Gegenstück_Laminoring.prt]
2020-03-05 Eine Verstiftung eingebaut
    Stift mit d3 und l8 erstellt
    [BGR_Schienenfahrzeugachsgetriebe.prt, Labyrinthdichtung_Rad_Gegenstueck_links.prt, Stift_ d3_l8.prt, Stuetzring_Rad.prt, Testbaugruppe_Rad_Dichtungen.prt]
2020-03-05 Speicherung vorm Runterfahren
    [Stückliste.xls]
2020-03-05 Weitere Teile hinzugefügt
    [BGR_Schienenfahrzeugachsgetriebe.prt]
2020-03-05 Antrieb Stützring Sicherungsstiftsbohrung
    [BGR_Schienenfahrzeugachsgetriebe.prt, Labyrinthdichtung_Antrieb_Gegenstueck_links.prt, Stuetzring_Antrieb.prt]
2020-03-05 Sicherungsstiftbohrung in Distanzring mit Nuten und QJ-Lager
    Gehäusebohrungen für Distanzring, QJ-LAger und Antriebslagerstift fehlen noch
    [BGR_Schienenfahrzeugachsgetriebe.prt, Distanzring_mitNuten.prt, QJ215-XL-TVP_17_id14_x_t.prt]
2020-03-05 Projektbericht weitere Grafiken
    [BGR_Schienenfahrzeugachsgetriebe.prt]
2020-03-06 teile erneut gespiegelt
    [mirror_Gehäuse_v2_oben.prt, mirror_Gehäuse_v2_unten.prt]
2020-03-06 Kollision beseitigt
    [Labyrinthdichtung_Antrieb_Gegenstueck_links.prt]
2020-03-06 Zeichnung angefangen
    [Drehmomentstütze_BG.prt, Testbaugruppe_Antrieb_Dichtungen.prt, Testbaugruppe_Rad_Dichtungen.prt, USM-44188_A.prt, Welle_Abtrieb.prt]
2020-03-06 Zeichnung erweitert
    [Stückliste.xls]
2020-03-06 CAD zeichnung
2020-03-06 verstiftung gespiegelt
    [gehause_zusammenbau.prt]
2020-03-06 Revert "verstiftung gespiegelt"
    This reverts commit 8ac6088e0a795e0fe8c69943c6375716eda00698.
    [gehause_zusammenbau.prt]
2020-03-06 verstiftung korrigiert
    [gehause_zusammenbau.prt, mirror_Gehäuse_v2_oben.prt, mirror_Gehäuse_v2_unten.prt]
2020-03-06 Stifte eingebaut
    [Testbaugruppe_Antrieb_Dichtungen.prt]
2020-03-06 Laminumring löcher
    [Laminumring_Abtrieb.prt, Stückliste.xls]
2020-03-06 Fertig zusammengebaut
    [Testbaugruppe_Rad_Dichtungen.prt]
2020-03-06 Bohrung für Stift in Stützring eingefügt
    [Labyrinthdichtung_Rad_Gegenstück_Laminoring.prt]
2020-03-06 Simulation beschriebn und Vorwort
2020-03-06 Stückliste aktualisiert
    [Stückliste.xls]
2020-03-06 Projektzeitplan druckfertig
    [Projektzeitplan.xlsx]
2020-03-07 Drehgestell als Modell eingefügt und Zeichnung weiter
    [Drehgestell Modell.prt, Testbaugruppe_Rad_Dichtungen.prt]
2020-03-07 Finale-Ordner für Anhang erstellt
    [11. Auslegung des thermischen Pressverbandes.xlsx, 12. Auslegung des Ölpressverbandes.xlsx]
2020-03-07 Projektbericht formatiert und korrigiert
    [Stückliste.xls, TabelleModule.xlsx]
2020-03-09 CAD Explosion
2020-03-10 gehäuse angepasst
    [gehause_zusammenbau.prt, mirror_Gehäuse_v2_oben.prt, mirror_Gehäuse_v2_unten.prt]
2020-03-10 gemetrie zahnrad und lagertoleranzen
2020-03-10 Explo mit kupplung, Projektbericht pdf, zeichnungen aktualisiert
    [Antrieb_Dichtungen_dwg.prt, Kupplung.prt, Zanhrad_dwg1.prt]
2020-03-10 Lagerlufterläuterungen und Lagerluft in die Stückliste
    [Stückliste.xls]
2020-03-10 geometrie fehler entfernt
    gehäuse oberseite hatt im öllaufang zur außenseite (das viereckige ding) eine illigale flächen überlappung
    [gehause_zusammenbau.prt, mirror_Gehäuse_v2_oben.prt, mirror_Gehäuse_v2_unten.prt]
2020-03-11 gehäuse korrektur erneut eingefügt
    die alte korrektur war in der falschen datei abgespeichert
    [gehause_zusammenbau.prt, mirror_Gehäuse_v2_unten.prt]
2020-03-11 animation blender gerendered
    [fluid_gehäuse.blend]
2020-03-12 Zahnrad aktualisiert
    [Zahnrad_dwg1.prt, Zanhrad_dwg1.prt]
2020-03-12 Zahnrad zeichnung korrigiert
    Ölschmiernut Norm angegeben
    [Zahnrad_dwg1.prt, Zanhrad_dwg1.prt]
2020-03-12 Durchgangslöcher aufgebohrt
    [Labyrinthdichtung_Antrieb_Gegenstueck_links.prt]
2020-03-12 Zahnrad Zeichnung angepasst
    [Zahnrad_dwg1.prt]
2020-03-12 Zeichnung Labyrinth fertig
    [Antrieb_Dichtungen_dwg.prt]
2020-03-12 Knochen Zeichnung fertig
    [Drehmomentstütze_BG.prt, Silentbuchse.prt, Stückliste.xls]
2020-03-12 vergessen zu speichern
    [Drehmomentstütze_BG.prt]
2020-03-12 CAD-Ordner zum Finale hinzugefügt
    [Axiallager_qj215-xl-tvp_x_t.prt, Bolzen 8x40.prt, Bolzen Drehmomentstütze.prt, Deckel_Antrieb.prt, Distanzring_Antrieb_innen.prt, Distanzring_mitNuten.prt, Drehgestell Modell.prt, Drehmomentstütze.prt]
